panoptes/POCS/README.rst

PANOPTES Observatory Control System
===================================

   

-  `PANOPTES Observatory Control
   System <#panoptes-observatory-control-system>`__
-  `Overview <#overview>`__
-  `Getting Started <#getting-started>`__
-  `Install <#install-script>`__
-  `Test POCS <#test-pocs>`__
-  `Links <#links>`__

.. warning::

    The recent `v0.7.0` release of POCS is not backwards compatible. If you
    are one of the folks running that software, please either do a reinstall
    of your system using the instructions below or see our `forum <https://forum.projectpanoptes.org>`__
    for advice.

Overview
--------

`PANOPTES <https://projectpanoptes.org>`__ is an open source citizen science project
that is designed to find transiting exoplanets with digital cameras. The goal of
PANOPTES is to establish a global network of of robotic cameras run by amateur
astronomers schools in order to monitor, as continuously as possible, a very large
number of stars. For more general information about the project, including the
science case and resources for interested individuals, see the `about page <https://projectpanoptes.org/articles/what-is-panoptes/>`__.

POCS (PANOPTES Observatory Control System) is the main software driver for the
PANOPTES unit, responsible for high-level control of the unit. This repository
also contains a number of scripts for running a full instance of POCS.

Getting Started
---------------

POCS is designed to control a fully constructed PANOPTES unit. Additionally,
POCS can be run with simulators when hardware is not present or when the system
is being developed.

For information on building a PANOPTES unit, see the main `PANOPTES <https://projectpanoptes.org>`__ website and join the
`community forum <https://forum.projectpanoptes.org>`__.

To get started with POCS there are three easy steps:

#. **Setup** POCS on the computer you will be using for your unit or for
   development.
#. **Test** your POCS setup by running our testing script
#. **Start using POCS!**

See below for more details.

.. note::

    We rely heavily on much of the code in `panoptes-utils`.

    See https://github.com/panoptes/panoptes-utils

Install
-------

POCS Environment
^^^^^^^^^^^^^^^^

If you are running a PANOPTES unit then you will most likely want the entire
PANOPTES environment.

There is a bash shell script that will attempt to install an entire working POCS
system on your computer.  Some folks even report that it works on a Mac.

To test the script, open a terminal and enter:

.. code-block:: bash

    curl -L https://install.projectpanoptes.org | bash

Or using `wget`:

.. code-block:: bash

    wget -O - https://install.projectpanoptes.org | bash

POCS Module
^^^^^^^^^^^

If you want just the POCS module, for instance if you want to override it in
your own OCS (see `Huntsman-POCS <https://github.com/AstroHuntsman/huntsman-pocs>`_
for an example), then install via `pip`:

.. code-block:: bash

    pip install panoptes-pocs

If you want the extra features, such as Google Cloud Platform connectivity, then
use the extras options:

.. code-block:: bash

    pip install "panoptes-pocs[google]"

Test POCS
---------

See the Testing section of the Contributing guide.

Links
-----

-  PANOPTES Homepage: https://projectpanoptes.org
-  PANOPTES Data Explorer: https://www.panoptes-data.net
-  Community Forum: https://forum.projectpanoptes.org
-  Source Code: https://github.com/panoptes/POCS
