panoptes/POCS/docs/_static/pan-head.png

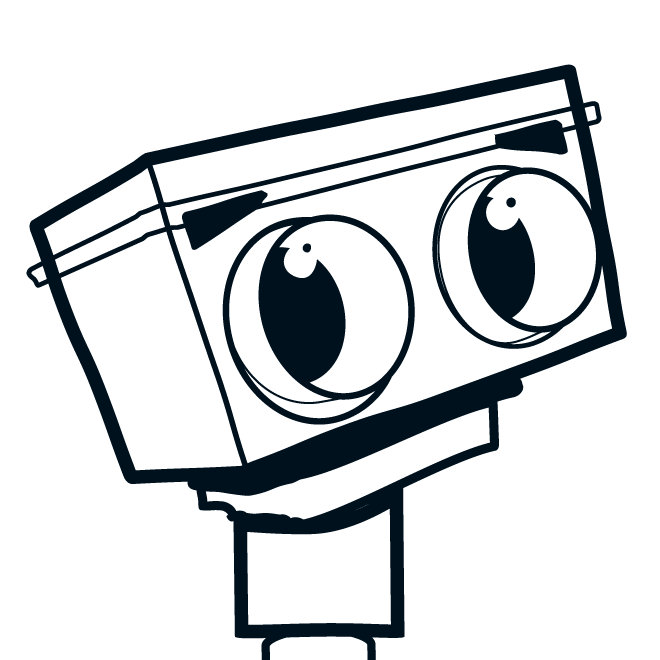
docs/_static/pan-head.png
