panoptes/POCS/docs/_static/pocs-graph.png

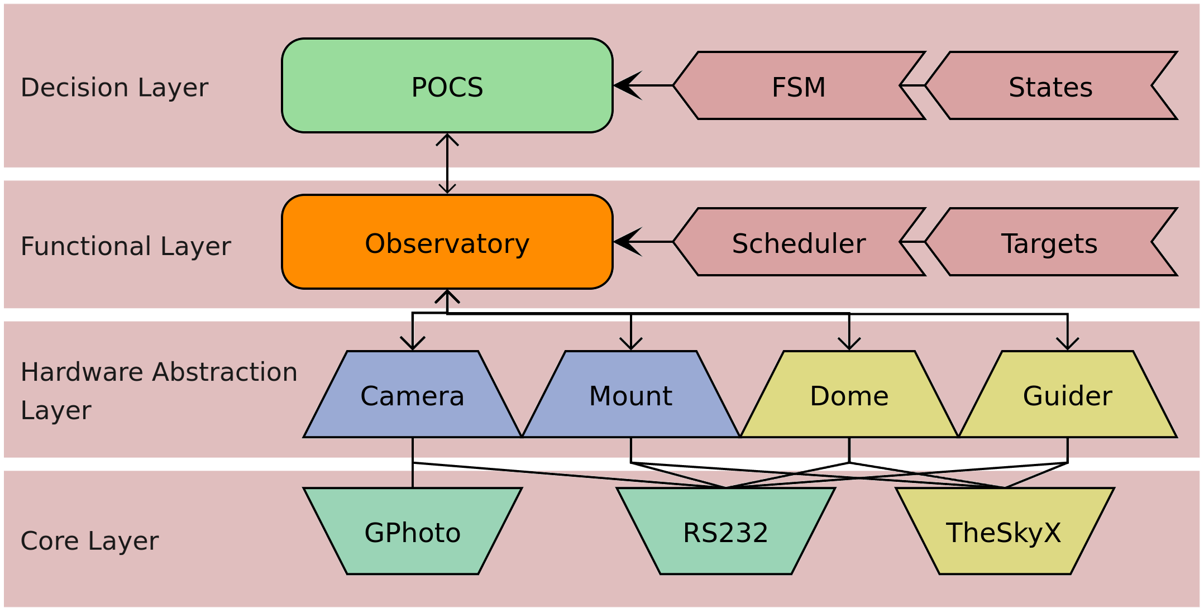
docs/_static/pocs-graph.png
