panoptes/POCS/(threads)

Thread 14 (2014-01-22):

Assemble Camera Enclosure Hardware

joshwalawender, 2014-01-22:
Assemble camera enclosure with mounting scheme for cameras and components.  Electronics must be coordinated with the Camera Control Electronics project.

Closed 2016-01-19.

Thread 2 (2014-01-22):

Assemble Camera Control Electronics

wtgee, 2014-01-22:
Assemble prototype arduino control system for the cameras.  Should include:

1) Control of camera shutter via TTL signal
2) Relay to connect/disconnect camera from USB
3) Temperature and humidity sensing
4) Orientation sending via accelerometer or IMU

Closed 2016-01-19.

Thread 5 (2014-01-22):

Assemble Weather Station

wtgee, 2014-01-22:
Assemble a prototype weather station module using Arduino board and components.  This is a prototype in that assembly will use a breadboard instead of soldering components in to a mounting.

Closed 2016-01-19.

Thread 9 (2014-01-22):

Prototype Mount Module

wtgee, 2014-01-22:
Build proof of concept mount module to control iOptron mounts.

See [wiki](https://github.com/panoptes/POCS/wiki/Panoptes-Coordinates-Standard#mount-methods) for some specifications:

When the methods of the mount class communicate (via serial) with the mount hardware, we strongly encourage the author of the code for that particular mount type (i.e. Orion, Celestron, Meade, etc.) to communicate with the mount using physical mount coordinates: Hour Angle (HA) and Declination. There are several advantages to this:

* Keeping all calculations relating to the conversion between J2000 (RA and Dec) to physical coordinates (HA and Dec) means that those calculations will always be consistent because we will know which corrections have been handled (i.e. precession to Jnow, refraction correction, etc.),
* Issuing slew commands in physical coordinates relieves the author of the code for the individual mount type of having to insert checks for the internal mount time and location values. This avoids potential confusion of the mount time and location are not matched to the time and location POCS.
* Using physical cordinates means that the same serial slew command to the mount can also be used for parking.

Closed 2016-01-19.

Thread 16 (2014-01-29):

Web Cams for Panoptes

joshwalawender, 2014-01-29:
We need hardware and software for web cams for the Panoptes baseline.  The cameras Oli is using in the prototype work fine in daytime, but I'm wondering if we can get better sensitivity.  I've ordered one of the Raspberry Pi camera boards with the IR filter removed (i.e. http://www.adafruit.com/products/1567) for a personal project.  I'm going to try to set it up to do integrations and see how sensitive it can get.  If this works, we might use this sort of system as a DIY web cam.  If not, I suspect we can easily reproduce what Oli did in the prototype.

Closed 2016-01-19.

Thread 23 (2016-05-05):

Camera Stop/Shutdown

wtgee, 2016-05-05:
Have a better method for interrupting camera to guarantee we don't get in a locked out state with exposure. Should be able to build into the subprocess/async.subprocess easily.

wtgee, 2017-02-03:
Seems to be okay now. Reopen if specific problem found.

Closed 2017-02-03.

Thread 25 (2016-05-05):

Better Sensor Reading Scripts

wtgee, 2016-05-05:
Currently handled by `scripts/read_serial.py`. Could be more robust. Also could integrate with `panoptes/read_weather.py`. Could also integrate with `supervisord`.

wtgee, 2016-05-10:
This has been moved into [PEAS](https://github.com/panoptes/environmental-analysis-system).

Closed 2016-05-10.

Thread 26 (2016-05-05):

Supervisord

wtgee, 2016-05-05:
Review supervisord scripts and make sure we are starting all items appropriately.
- [ ] Weather scripts (#25)
- [ ] Sensors scripts (#25)
- [ ] PAWS site
- [ ] Unit script
- [ ] Other? (e.g. maintenance scripts, data processing, updating, etc.)

wtgee, 2017-02-03:
We need to review this and see if it is what we want. The idea was to have these items start up automatically after reboot. However it seems like reboots should only happen manually in which case the user wants to probably start things up manually (maybe with one simple command). If a reboot happens unexpectedly we should probably alert the user somehow and allow them to inspect the system before start things.

jamessynge, 2017-09-09:
I'd like a full startup script, with flags to control what is attached, and then the user can decide whether to run that script automatically at boot. For manual control, perhaps we could have it start a screen or tmux session, with separate "window" for each of the shells that needs to be executed (e.g. peas_shell).

wtgee, 2018-04-03:
Closing this as stale.

Closed 2018-04-03.

Thread 28 (2016-05-05):

PanBot in the Slack Room

wtgee, 2016-05-05:
You know, for fun. Have a PANOPTES unit give status updates in certain channels.

wtgee, 2018-06-01:
Currently implemented in unmerged working branch [here](https://github.com/panoptes/POCS/blob/may-run/pocs/core.py#L185) but could easily be broken off.

wtgee, 2018-07-08:
> FWIW, our slack setup can't afford to have units post, given that we're way past the 10K post limit.

Agreed, we won't use it for the core PANOPTES slack room, but it's still nice to have. I imagine a school doing a build might have their own slack room.

Closing here as this was implemented in #522

Closed 2018-07-08.

Thread 29 (2016-05-06):

Camera Simulator

wtgee, 2016-05-06:
Camera simulator needs to be able to produce images, including pointing images (ideally with some offset). Need a folder of test images to work with this.

joshwalawender, 2016-05-06:
One way to do this without needing a folder of images, would be to have a tool which would generate an "image" by dropping gaussian stars down based on catalog positions.  Something like this might already exist, so it would be worth looking around for one.

joshwalawender, 2016-05-12:
Here's something that looks like it might do the trick.  It's from the same developer as SExtractor.
http://www.astromatic.net/software/skymaker

wtgee, 2016-05-12:
Nice, thanks. We can either use this or one or two real images. We just
need to be able to plate solve them then move them a tiny bit to check
tracking/pointing etc.

Hopefully I'll be getting to this soon.

On Thu, May 12, 2016 at 9:31 AM, Josh Walawender <notifications@github.com>
wrote:

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

--
~Wilfred Tyler Gee

wtgee, 2017-02-03:
There are currently some dummy images in the test folder (`$POCS/tests/data`) and the camera simulator will just always use these as a file name. This allows for unning of the entire machine with a camera simulator. Additional features should be defined separately.

Closed 2017-02-03.

Thread 33 (2016-06-23):

Incorporate trim rates in RA and Dec based on pointing/tracking model

joshwalawender, 2016-06-23:
Based on feedback, set or update a "trim rate" on the RA and Dec tracking rates.  The goal is to maintain the position of the stars on the pixel grid to sub-pixel accuracy over the duration of an observation (many images).

One way to generate the feedback is to only look at pointing errors, then make a physical model of the mount.  This is the traditional way of doing this.  In the earlier version of the prototype @oguyon did this differently.  He measured the offset between subsequent images (via cross correlation) and estimated a tracking rate error for that position in mount coordinates (HA and Dec).  With a sufficient number of these points, he fit a polynomial to the data to create the model.  Then each time a target was slewed to, he evaluated this model and applied the appropriate trim rates.  I tend to prefer this method as easier to understand than the physical model which was often modified by arbitrary polynomials anyway, so it wan't very physical.

There are also a few ways we might input these trim rates.  First, we could use mount commands (either direct serial commands or via an INDI layer).  Second, we could use the arduino in the electronics package to make "guiding" corrections to the mount.  The rate correction would basically be a PWM signal output by the arduino to the mount guide inputs.

wtgee, 2016-06-23:
This is called from the Analyzing state. See:

https://github.com/panoptes/POCS/blob/develop/pocs/state/states/default/analyzing.py#L11

Closed 2024-03-28.

Thread 37 (2016-06-29):

libgphoto2 client (gphoto2 replacement)

wtgee, 2016-06-29:
`gphoto2` is being used to control the cameras but has a number of problems when dealing with multiple cameras. Even when the `model` and `port` are specified the client will issue a USB reset on the hub, effectively killing any other cameras that are currently in operation and resetting the USB device IDs. This is also complicated by potential power cable issues on PAN001 which makes it hard to set on the current setup.

A new client can be written directly from the libgphoto2 library that is specific to PANOPTES. This client could handle the details of controlling both cameras (or not).  This client would replace gphoto2's `main.c`: https://github.com/gphoto/gphoto2/blob/master/gphoto2/main.c

wtgee, 2017-02-03:
This hasn't been an issue lately. In the future we might want/need it but can be closed for now.

Closed 2017-02-03.

Thread 39 (2016-06-29):

Accelerometer Positioning

wtgee, 2016-06-29:
We want to be able to recover the pointing position of the mount based on the accelerometer readings located inside the camera box. Various ways to do this exist. See e.g. (in no particular order):

http://perso-etis.ensea.fr/~pierandr/cours/M1_SIC/AN3397.pdf
http://arxiv.org/abs/1407.0035
http://www.it.bton.ac.uk/staff/gw4/papers/Displacement%20from%20Accelerometer.pdf

Values are available directly off the accelerometer (stored in mongodb locally) or off BigQuery. Values take the form:

``` json
                "camera_box" : {
                        "accelerometer" : {
                                "o" : 7,
                                "x" : -0.96,
                                "z" : -0.16,
                                "y" : -0.15
                        }
                }
```

where `o` represents the orientation (which can determine which side of the pier the accelerometer currently is)

See also #41 as we want to switch how we are reading the data as well.

astroblogweb, 2017-06-19:
Is this issue still open? Can I work on the python code for it?

joshwalawender, 2017-06-19:
Hi @astroblogweb , we have a summer intern who is just starting today and will be working on this topic.  Perhaps we can find another area yoiu might be interested in, or perhaps you can work together on it.  @wtgee coordinates all our software and he is away at a conference this week, so we might be a bit slow replying here for the next few days.

wtgee, 2023-05-23:
Currently not recommending the accelerometer in the build so closing this as stale.

Closed 2023-05-23.

Thread 40 (2016-06-29):

Webcam Development

wtgee, 2016-06-29:
We currently have two webcams attached to each unit. These are currently used simply for checking on the unit in the day. These timelapse photos are then archived as a simple movie each day.

Potential other uses for the webcams (brightness levels? cloud cover?) should be explored.

wtgee, 2017-02-03:
See also panoptes/PEAS#4

wtgee, 2019-05-07:
Look into using something like: https://github.com/thomasjacquin/allsky

Thread 41 (2016-06-29):

Arduino / Firmata Interaction

wtgee, 2016-06-29:
We have custom arduino code both in the computer and camera boxes. With the updates to the actual electronics interface we also want to start placing [Firmata](https://www.arduino.cc/en/Reference/Firmata) directly on the boards so that the control can be handled over to Python (or some other client code). This needs to be implemented and the clients need to be written to digest and interact with the arduinos

wtgee, 2017-02-03:
Decided not to use Firmata. New features for arduino will be defined elsewhere.

Closed 2017-02-03.

Thread 42 (2016-06-29):

Daily Housekeeping

wtgee, 2016-06-29:
Determine tasks that need to be accomplished during the Housekeeping state, which is run after the unit is parked. This should either be run directly after parking or at some set time each morning.

* [x] Cleanup observations directory
* [x] Upload images to cloud storage
* [x] Upload metadata to (TBD) cloud.

jamessynge, 2018-04-24:
I'm looking at setting up some code to run PIAA analysis on an observation, which would be easier if the last file uploaded for an observation was a sentinel that indicates that the upload is complete. This could be a metadata file, or just an empty file (e.g. UPLOAD-COMPLETE).

jamessynge, 2018-04-25:
Closing the issue right after I added a feature request, without a comment
as to why, leaves me wondering whether the feature request is already
recorded elsewhere, is already handled, or you disagree. Could you
elaborate?

On Tue, Apr 24, 2018, 11:38 PM Wilfred Tyler Gee <notifications@github.com>
wrote:

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

wtgee, 2018-04-25:
Sorry, I didn't mean to close it. In fact, I had made an earlier comment and had meant to post it but guess I screwed it up on my mobile.

Anyway, yes, I have been thinking something along these lines. Because they can be uploaded in any order I almost think it would need to be a metadata file that lists the names of the files that should have been uploaded. If we wanted to be really sure we could do md5sums or something.

I have just barely got it set up so that it responds to the notifications when something gets uploaded. The idea is that this will then do a plate-solve on the file and ingest metadata from the FITS header into a postgresql database. We can then use this metadb for displaying a site of info.

jamessynge, 2018-04-25:
Thanks for the clarification. My goal is somewhat simpler: trigger the
light curve production once all files of an observation have been uploaded.
As you say, a metadata file can include the names, and maybe the
signatures, of the raw files, so a responder can listen for bucket change
events, and only if the metadata file and all referenced files are present
would it kick off the analysis.

On Wed, Apr 25, 2018, 4:45 PM Wilfred Tyler Gee <notifications@github.com>
wrote:

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

wtgee, 2018-10-16:
Always happy to close a 2 year old Issue. :) Closed by #687.

Closed 2018-10-16.

Thread 45 (2016-06-29):

Target / Observation / Exposure Refactor

wtgee, 2016-06-29:
The implementations of the `Target` and `Observation` classes are currently clunky and need some major cleaning up. This should be done with respect to what we want the eventual `Scheduler` to look like (see #44 ). `cameras` should not needlessly be passed into objects.

wtgee, 2016-07-21:
This is currently causing problems when the unit tries to return to the same target if the POCS loop hasn't been restarted. It could be fixed by adjust existing code but time would better be spent fixing the whole thing (which to some extent also invovles #44)

Closed 2016-08-18.

Thread 52 (2016-07-22):

Implement ABC for base classes

wtgee, 2016-07-22:
Both `mount` and `camera` should be implemented with [ABC](https://docs.python.org/3/library/abc.html) (as per PEP3119) rather than with `NotImplentedError`

wtgee, 2017-02-03:
This is not totally necessary and things are working fine. Closing this unless we have a defined need for it.

Closed 2017-02-03.

Thread 54 (2016-07-28):

Incorporate weather into Scheduler

wtgee, 2016-07-28:
The `Scheduler` (which is an astroplan `Observer`) can use the temperature and humidity values for more accurate pointing. Might not be needed.

joshwalawender, 2016-07-31:
@wtgee I'm not sure I understand the issue, can you elaborate?  You want the scheduler to take temp and humidity as inputs?  Is there any particular reason?  With our pixel scale, these will be negligible effects on pointing.

wtgee, 2016-07-31:
Let' just close the issue then. I was cleaning up old code and had a commented line in there to add them in so I just created an issue for it so I could remove the line.

Closed 2016-07-31.

Thread 56 (2016-07-31):

Horizon and Obstruction Limits

wtgee, 2016-07-31:
At some point we need to be able to avoid certain sections of the sky or arbitrary horizon limits. At MLO the radio tower ends up in the images for certain targets.

joshwalawender, 2016-08-01:
Originally we had this slated for scheduler.  The idea was that the mount would have horizon limits based on actual, physical collisions and that scheduler would handle sky obstructions.

Our idea was the users could define a single elevation as their horizon, a table of values of horizon as a function of azimuth, or in principle a custom function (if they had some very weird situation).  The scheduler would check that the target would not dip below the horizon during an image.

I think that is still a reasonable strategy.

wtgee, 2016-08-01:
Agreed. We should make an overarching Issue for Scheduling that perhaps
incorporates items we need.

For the weird situations I almost think it would be easiest to mark an
image after the fact such that when you see an image with something
obstructing you could just mark that location.

On Mon, Aug 1, 2016 at 4:39 PM, Josh Walawender <notifications@github.com>
wrote:

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

--
~Wilfred Tyler Gee

jamessynge, 2017-04-12:
I'm interested in building, debugging and deploying a Panoptes unit, and I suspect it will help a lot to have an automated approach to identifying the horizon, especially during the process of debugging and site selection. For example, if you could place the tripod, eq mount and camera unit in a location, and have it measure the horizon, this would allow a contributor to find the best location on the available property. Or, during debugging, where you're not aiming to have it running unattended, but rather checking if everything is working well, including if focus and polar alignment are acceptable, having a horizon measurement capability would be useful. This could even be done during the day/evening.

In my case, I'll debug at home, where there are a lot of trees, before taking it to a location (TBD) where a friend or school (again, TBD) will host it. It's possible it'll be moved several times, especially if I take it to a meeting or two for show and tell ;-) before finding a permanent location. I notice from the JPL photos of Panoptes at an open house that at least one prototype was moved to CA, so I think you know what I'm talking about.

wtgee, 2018-01-19:
Happy to close this old issue in favor of #367

Closed 2018-01-19.

Thread 83 (2017-02-16):

Power Down and Messaging Cleanup

wtgee, 2017-02-16:
Need to clean up on `power_down` a little better, especially with guaranteeing the messaging ports get cleared.

wtgee, 2017-11-20:
Closing this as outdated and lack of information. New issue should be created when identified.

Closed 2017-11-20.

Thread 86 (2017-07-01):

Turn fan on when control box is hot, off when not

jamessynge, 2017-07-01:
IIUC, the fan is on at all times now, even in the winter. We should switch the fan on and off according to the temperature readings from various sensors. This could be handled by the telemetry board arduino, with default values in the code, and adjustments from the NUC.

wtgee, 2017-11-24:
Closing: more and better details provided in #130

Closed 2017-11-24.

Thread 87 (2017-07-09):

Add workflow/scripts for verifying a new unit

jamessynge, 2017-07-09:
I've built a PANOPTES baseline unit, but beyond working with the Arduino IDE to validate the behavior of the 3 boards, I don't know how to get rest of the equipment verified (i.e. can the NUC talk to EVERYTHING).

Thread 88 (2017-07-09):

pocs_shell doesn't work "as is"

jamessynge, 2017-07-09:
```bash
panoptes@Panmass:/var/panoptes/POCS$ bin/pocs_shell
Traceback (most recent call last):
  File "bin/pocs_shell", line 16, in <module>
    from pocs import POCS
ModuleNotFoundError: No module named 'pocs'
panoptes@Panmass:/var/panoptes/POCS$ python bin/pocs_shell
Traceback (most recent call last):
  File "bin/pocs_shell", line 16, in <module>
    from pocs import POCS
ModuleNotFoundError: No module named 'pocs'
```

wtgee, 2018-02-13:
Closing generic Issue for stale activity. Feel free to reopen or create new Issue if needed.

Closed 2018-02-13.

Thread 89 (2017-07-09):

POCS Operation.ipynb instructions lead to error

jamessynge, 2017-07-09:
I followed the examples in POCS Operation.ipynb and ran into one of the errors that is causing the tests to fail:

    AttributeError: 'SkyCoord' object has no attribute 'ndim'

Details:

```
In [13]: new_obs = pocs.observatory.get_observation()
---------------------------------------------------------------------------
AttributeError                            Traceback (most recent call last)
<ipython-input-13-34e5290c9fe4> in <module>()
----> 1 new_obs = pocs.observatory.get_observation()

/var/panoptes/POCS/pocs/observatory.py in get_observation(self, *args, **kwargs)
    159
    160         self.logger.debug("Getting observation for observatory")
--> 161         self.scheduler.get_observation(*args, **kwargs)
    162
    163         if self.scheduler.current_observation is None:

/var/panoptes/POCS/pocs/scheduler/dispatch.py in get_observation(self, time, show_all)
     42
     43         common_properties = {
---> 44             'end_of_night': self.observer.tonight(time=time, horizon=-18 * u.degree)[-1],
     45             'moon': get_moon(time, self.observer.location)
     46         }

/home/panoptes/anaconda3/lib/python3.6/site-packages/astropy/utils/decorators.py in tonight(self, time, horizon, obswl)
    634             name = func.__name__
    635
--> 636         func = make_function_with_signature(func, name=name, **wrapped_args)
    637         func = functools.update_wrapper(func, wrapped, assigned=assigned,
    638                                         updated=updated)

/home/panoptes/anaconda3/lib/python3.6/site-packages/astropy/units/decorators.py in wrapper(*func_args, **func_kwargs)
    128             # Call the original function with any equivalencies in force.
    129             with add_enabled_equivalencies(self.equivalencies):
--> 130                 return wrapped_function(*func_args, **func_kwargs)
    131
    132         return wrapper

/home/panoptes/anaconda3/lib/python3.6/site-packages/astroplan/observer.py in tonight(self, time, horizon, obswl)
   1677             if not isinstance(start_time, Time):
   1678                 start_time = Time(start_time)
-> 1679         end_time = self.sun_rise_time(start_time, which='next', horizon=horizon)
   1680
   1681         return start_time, end_time

/home/panoptes/anaconda3/lib/python3.6/site-packages/astropy/utils/decorators.py in sun_rise_time(self, time, which, horizon)
    634             name = func.__name__
    635
--> 636         func = make_function_with_signature(func, name=name, **wrapped_args)
    637         func = functools.update_wrapper(func, wrapped, assigned=assigned,
    638                                         updated=updated)

/home/panoptes/anaconda3/lib/python3.6/site-packages/astropy/units/decorators.py in wrapper(*func_args, **func_kwargs)
    128             # Call the original function with any equivalencies in force.
    129             with add_enabled_equivalencies(self.equivalencies):
--> 130                 return wrapped_function(*func_args, **func_kwargs)
    131
    132         return wrapper

/home/panoptes/anaconda3/lib/python3.6/site-packages/astroplan/observer.py in sun_rise_time(self, time, which, horizon)
   1088         ISO: 2001-02-02 14:02:50.554, JD: 2451943.08531
   1089         """
-> 1090         return self.target_rise_time(time, get_sun(time), which, horizon)
   1091
   1092     @u.quantity_input(horizon=u.deg)

/home/panoptes/anaconda3/lib/python3.6/site-packages/astropy/utils/decorators.py in target_rise_time(self, time, target, which, horizon)
    634             name = func.__name__
    635
--> 636         func = make_function_with_signature(func, name=name, **wrapped_args)
    637         func = functools.update_wrapper(func, wrapped, assigned=assigned,
    638                                         updated=updated)

/home/panoptes/anaconda3/lib/python3.6/site-packages/astropy/units/decorators.py in wrapper(*func_args, **func_kwargs)
    128             # Call the original function with any equivalencies in force.
    129             with add_enabled_equivalencies(self.equivalencies):
--> 130                 return wrapped_function(*func_args, **func_kwargs)
    131
    132         return wrapper

/home/panoptes/anaconda3/lib/python3.6/site-packages/astroplan/observer.py in target_rise_time(self, time, target, which, horizon)
    898                                            dict(time=time, target=target,
    899                                                 which=which, rise_set='rising',
--> 900                                                 horizon=horizon))
    901
    902     @u.quantity_input(horizon=u.deg)

/home/panoptes/anaconda3/lib/python3.6/site-packages/astroplan/observer.py in _determine_which_event(self, function, args_dict)
    829
    830         if which == 'next' or which == 'nearest':
--> 831             next_event = function(*args('next'))
    832             if which == 'next':
    833                 return next_event

/home/panoptes/anaconda3/lib/python3.6/site-packages/astroplan/observer.py in _calc_riseset(self, time, target, prev_next, rise_set, horizon, N)
    730             times = _generate_24hr_grid(time, -1, 0, N)
    731
--> 732         altaz = self.altaz(times, target, grid=True)
    733         altitudes = altaz.alt
    734

/home/panoptes/anaconda3/lib/python3.6/site-packages/astroplan/observer.py in altaz(self, time, target, obswl, grid)
    464         """
    465         if target is not None:
--> 466             time, target = self._preprocess_inputs(time, target, grid)
    467
    468         altaz_frame = AltAz(location=self.location, obstime=time,

/home/panoptes/anaconda3/lib/python3.6/site-packages/astroplan/observer.py in _preprocess_inputs(self, time, target, grid)
    396                 if time.isscalar:
    397                     target = target[:, np.newaxis]
--> 398                 while target.ndim <= time.ndim:
    399                     target = target[:, np.newaxis]
    400         if not self._is_broadcastable(target.shape, time.shape):

/home/panoptes/anaconda3/lib/python3.6/site-packages/astropy/coordinates/sky_coordinate.py in __getattr__(self, attr)
    449         # Fail
    450         raise AttributeError("'{0}' object has no attribute '{1}'"
--> 451                              .format(self.__class__.__name__, attr))
    452
    453     def __setattr__(self, attr, val):

AttributeError: 'SkyCoord' object has no attribute 'ndim'

In [14]:
```

wtgee, 2017-11-13:
I believe this has been solved by an astropy update. Can you retest and report any additional failures?

wtgee, 2018-01-11:
@jamessynge when you get the change can you check this notebook again. I'd like to close out some old Issues if not a problem.

wtgee, 2018-01-15:
Closing for lack of activity. Please open back up if an issue.

Closed 2018-01-15.

Thread 93 (2017-07-09):

test_error_exit fails

jamessynge, 2017-07-09:
Looks like the test is looking for the wrong type of error (SystemExit vs. PanError).

```
__________________________________________ test_error_exit __________________________________________

config = {'cameras': {'auto_detect': True, 'devices': [{'model': 'canon_gphoto2'}, {'model': 'canon_gphoto2'}], 'primary': '14d...: <Quantity 3400.0 m>, 'gmt_offset': -600, 'horizon': <Quantity 30.0 deg>, 'latitude': <Quantity 19.54 deg>, ...}, ...}

    def test_error_exit(config):
        with pytest.raises(SystemExit):
>           Observatory(ignore_local_config=True, simulator=['none'])

pocs/tests/test_observatory.py:50:
_ _ _ _ _ _ _ _ _ _ _ _ _ _ _ _ _ _ _ _ _ _ _ _ _ _ _ _ _ _ _ _ _ _ _ _ _ _ _ _ _ _ _ _ _ _ _ _ _ _ _
pocs/observatory.py:50: in __init__
    self._create_cameras(**kwargs)
_ _ _ _ _ _ _ _ _ _ _ _ _ _ _ _ _ _ _ _ _ _ _ _ _ _ _ _ _ _ _ _ _ _ _ _ _ _ _ _ _ _ _ _ _ _ _ _ _ _ _

self = <pocs.observatory.Observatory object at 0x7f42b8264470>
kwargs = {'ignore_local_config': True, 'simulator': ['none']}
camera_info = {'auto_detect': True, 'devices': [{'model': 'canon_gphoto2'}, {'model': 'canon_gphoto2'}], 'primary': '14d3bd'}
a_simulator = False, ports = [], auto_detect = True

    def _create_cameras(self, **kwargs):
        """Creates a camera object(s)

            Loads the cameras via the configuration.

            Creates a camera for each camera item listed in the config. Ensures the
            appropriate camera module is loaded.

            Note: We are currently only operating with one camera and the `take_pic.sh`
                script automatically discovers the ports.

            Note:
                This does not actually make a usb connection to the camera. To do so,
                call the 'camear.connect()' explicitly.

            Args:
                **kwargs (dict): Can pass a camera_config object that overrides the info in
                    the configuration file. Can also pass `auto_detect`(bool) to try and
                    automatically discover the ports.

            Returns:
                list: A list of created camera objects.

            Raises:
                error.CameraNotFound: Description
                error.PanError: Description
            """
        if kwargs.get('camera_info') is None:
            camera_info = self.config.get('cameras')

        self.logger.debug("Camera config: \n {}".format(camera_info))

        a_simulator = 'camera' in self.config.get('simulator', [])
        if a_simulator:
            self.logger.debug("Using simulator for camera")

        ports = list()

        # Lookup the connected ports if not using a simulator
        auto_detect = kwargs.get(
            'auto_detect', camera_info.get('auto_detect', False))
        if not a_simulator and auto_detect:
            self.logger.debug("Auto-detecting ports for cameras")
            try:
                ports = list_connected_cameras()
            except Exception as e:
                self.logger.warning(e)

            if len(ports) == 0:
                raise error.PanError(
>                   msg="No cameras detected. Use --simulator=camera for simulator.")
E               pocs.utils.error.PanError

pocs/observatory.py:589: PanError
--------------------------------------- Captured stderr call ----------------------------------------
2017-07-09 17:05:34 Panmass panoptes[11800] INFO Initializing observatory
2017-07-09 17:05:34 Panmass panoptes[11800] INFO 	Setting up location
2017-07-09 17:05:34 Panmass panoptes[11800] INFO 	Setting up mount
2017-07-09 17:05:34 Panmass panoptes[11800] INFO Loading mount commands file: /var/panoptes/POCS/resources/mounts/ioptron.yaml
2017-07-09 17:05:36 Panmass panoptes[11800] INFO Creating iOptron mount
2017-07-09 17:05:36 Panmass panoptes[11800] INFO Mount created
2017-07-09 17:05:36 Panmass panoptes[11800] INFO 	Setting up cameras
2017-07-09 17:05:37 Panmass panoptes[11800] ERROR PanError: No cameras detected. Use --simulator=camera for simulator.
```

wtgee, 2017-11-13:
Some of the testing suite has been fixed since this time. Can you run again and report if still failing.

wtgee, 2017-11-16:
I think this relates to having a camera physically connected while running the test. Some work needs to be done to respect the `--hardware` or `--camera` flag. In general need to make the documentation clear about how to run the test suite to test the software vs how to run it to test the hardware.

wtgee, 2017-12-21:
I think this has been resolved. Closing due to inactivity.

Closed 2017-12-21.

Thread 94 (2017-07-09):

Add instructions for creating the "panoptes" user

jamessynge, 2017-07-09:
We need explicit/detailed instructions for setting up the NUC, including creating the "panoptes" user. In particular, info about adding that user to the dialout group (else it has no access to the Arduino's and the USB-to-Serial adapters).
Also info about creating the /var/panoptes directory (must create the astrometry/data subdir, else some tests fail).

jamessynge, 2017-11-03:
New info: the panoptes user needs to be in the plugdev group, else has no access to the cameras when not logged in via a locally attached monitor & keyboard, including IIUC via the auto-started tmux session.

wtgee, 2020-02-16:
Closed by #951.  There are other things that need to be done as part of that process, mostly documentation, but new specific Issues should be opened to identify those.

Closed 2020-02-16.

Thread 95 (2017-07-15):

Camera.is_primary is wrong

jamessynge, 2017-07-15:
I provided a "primary: uid" line in pocs_local.yaml, but the wrong camera is considered primary. pocs_local.yaml:

```
cameras:
    auto_detect: True
    # Arbitrary choice of primary, but now labeled as camera #0,
    # and plugged in to jack #0.
    primary: 6575fc
    devices:
    -
        model: canon_gphoto2
    -
        model: canon_gphoto2
```

And the serial numbers of the cameras start and end as follows:
```
7bab97...cdc74a
6575fc...a6c489
```

wtgee, 2018-10-06:
This should be fixed by #650. Reopen if still a problem.

Closed 2018-10-06.

Thread 103 (2017-11-04):

PanMongo.insert_current fails to insert/replace some records

jamessynge, 2017-11-04:
peas_shell emits these errors periodically:

`/var/panoptes/POCS/pocs/utils/database.py:84: UserWarning: Problem inserting object into collection: The dotted field '4.16, "z":-8.27, "o"' in 'data.camera_board.4.16, "z":-8.27, "o"' is not valid for storage.
 warn("Problem inserting object into collection: {}".format(e))
/var/panoptes/POCS/pocs/utils/database.py:84: UserWarning: Problem inserting object into collection: The dotted field '3, "z":-8.03, "o"' in 'data.camera_board.3, "z":-8.03, "o"' is not valid for storage.
  warn("Problem inserting object into collection: {}".format(e))
/var/panoptes/POCS/pocs/utils/database.py:84: UserWarning: Problem inserting object into collection: The dotted field '24, "z":-7.93, "o"' in 'data.camera_board.24, "z":-7.93, "o"' is not valid for storage.
  warn("Problem inserting object into collection: {}".format(e))
/var/panoptes/POCS/pocs/utils/database.py:84: UserWarning: Problem inserting object into collection: The dotted field '23, "z":-7.92, "o"' in 'data.camera_board.23, "z":-7.92, "o"' is not valid for storage.
  warn("Problem inserting object into collection: {}".format(e))
/var/panoptes/POCS/pocs/utils/database.py:84: UserWarning: Problem inserting object into collection: The dotted field '18, "z":-8.44, "o"' in 'data.camera_board.18, "z":-8.44, "o"' is not valid for storage.
  warn("Problem inserting object into collection: {}".format(e))
`

Here is a SO page about the problem and a potential solution: https://stackoverflow.com/questions/30014243/mongoerror-the-dotted-field-is-not-valid-for-storage

wtgee, 2017-11-04:
Actually, I think this is a problem when the full string coming off the arduino isn't a valid json string. It then sometimes parses wrong and turns what should be values into keys and then tries to insert, generating this error. We don't (i.e. shouldn't) have any keys that have dots in them.

It's usually not a valid json because the buffering on the serial has gone wrong, something I was hoping your updated code would fix. I would first check for a full valid json before looking into above solution.

jamessynge, 2017-12-27:
I also see this happen when running test_pocs.py:

pocs/tests/test_pocs.py::test_run
  /home/james/git/panoptes/POCS/pocs/utils/database.py:100: UserWarning: Problem inserting object into collection: Cannot encode object: <Time object: scale='utc' format='jyear_str' value=J2000.000>
    warn("Problem inserting object into collection: {}".format(e))

wtgee, 2017-12-27:
The time type should be handled by the BSON encoder although I had seen the same problems recently with https://github.com/panoptes/POCS/pull/225 (which was fixed by explicitly converting that one value away from an astropy.time.Time` object). Is this the same type of time or is it some derivative of `datetime`?

The fix for this should be the same as for https://github.com/panoptes/POCS/issues/206, that is, we should have one way to scrub objects whether they are going into mongo or out as a message.

jamessynge, 2017-12-27:
Looks to be an astropy type (based on the jyear_str and J2000.000, and a Google search for that text).

wtgee, 2018-01-11:
I'm still seeing this intermittently on PAN001 with new camera board and arduino shared libraries.

jamessynge, 2018-01-12:
FWIW, I'm skeptical that the cause is invalid JSON from the boards. I think
the key used when updating a doc in the db is somehow corrupt as far as
mongo is concerned

On Jan 11, 2018 5:17 PM, "Wilfred Tyler Gee" <notifications@github.com>
wrote:

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

wtgee, 2018-01-12:
This is what I'm seeing frequently on PAN001 right now:
```
warn("Problem inserting object into collection: {}".format(e))
/var/panoptes/POCS/pocs/utils/database.py:100: UserWarning: Problem inserting object into collection: The dotted field '0.99, "z":-0.02, "o"' in 'data.camera_board.0.99, "z":-0.02, "o"' is not valid for storage.
  warn("Problem inserting object into collection: {}".format(e))
/var/panoptes/POCS/pocs/utils/database.py:100: UserWarning: Problem inserting object into collection: The dotted field '7, "y":0.99, "z":-0.02, "o"' in 'data.camera_board.7, "y":0.99, "z":-0.02, "o"' is not valid for storage.
```

Seems to be some bad string concatenation around `camera_board`. The line inserting it is:

```
            current_obj = {
                'type': collection,
                'data': obj,
                'date': current_time(datetime=True),
            }
```

which is where the `data` comes from in above warning.

jamessynge, 2018-01-26:
Another insert failure, but now with the record that couldn't be inserted:

`
PEAS > /var/panoptes/POCS/pocs/utils/database.py:88: UserWarning: Problem inserting object into collection: MongoDB can only handle up to 8-byte ints, {'type': 'environment', 'data': {'telemetry_board': {'name': 'telemetry_board', 'millis': 980784041, 'report_num': 417104, 'ver': '2018-01-14', 'power': {'computer': 1, 'fan': 1, 'mount': 1, 'cameras': 1, 'weather': 1, 'main': 1}, 'current': {'main': 421, 'fan': 49, 'mount': 32, 'cameras': 181}, 'amps': {'main': 1178.8, 'fan': 88.2, 'mount': 57.6, 'cameras': 181.0}, 'humidity': 13.5, 'temp_00': -1.1, 'temperature': [-4.31, -4.63, 0.69], 'date': '2018-01-26T11:48:59 GMT'}, 'camera_board': {'name': 'camera_board', 'count': 27674957142767538857, 'num': 27513, 'inputs': 9, 'camera_00': 1, 'camera_01': 1, 'accelerometer': {'x': -6.96, 'y': 6.86, 'z': 1.57, 'o': 7}, 'humidity': 29.5, 'temp_00': -6.0, 'date': '2018-01-26T11:48:59 GMT'}}, 'date': datetime.datetime(2018, 1, 26, 11, 48, 59, 444352)}
`

wtgee, 2018-01-26:
`'count': 27674957142767538857` isn't very helpful. :) Not sure how it gets that high though as you are doing a subtraction [here](https://github.com/panoptes/POCS/blob/develop/resources/arduino_files/camera_board/camera_board.ino#L167) (although there is still a TODO there).

jamessynge, 2018-01-27:
Yeah, I was sure that count was totally bogus. I don't think that value can be produced by the sketch, so it may mean that the reading the sketch output failed in some way.

wtgee, 2018-07-26:
Just a bump as I started getting this problem again on PAN001. We haven't updated the camera board software in quite some time but seems due:

```
/var/panoptes/POCS/pocs/utils/database.py:33: UserWarning: Problem inserting object
 into collection: MongoDB can only handle up to 8-byte ints

# snip

 'count': 35177157493517757885,
```

wtgee, 2019-06-29:
This should be solved with the merge up `panoptes-utils` release above.

Closed 2019-06-29.

Thread 107 (2017-11-08):

Post-consolidation cleanup

wtgee, 2017-11-08:
After #106 is merged there are a few items to be cleaned up:

* PEAS config conform to config loading system
* Assess need for `historical-data-fixer` folder
* Assess need for PACE `resources/arduino_folders/libraries` folder
* Update README
* Test `python setup.py [install|develop]`
* Transfer Issues from PACE and PEAS
* Mark tests with `hardware` fixture (instead of separate camera, mount, etc?)

wtgee, 2017-12-31:
Performed in release [v0.6.0](https://github.com/panoptes/POCS/releases/tag/v0.6.0).

> Assess need for PACE resources/arduino_folders/libraries folder
Still outstanding but deserves own issue.

Closed 2017-12-31.

Thread 118 (2017-11-15):

Encourage or require the use of a source formatter

jamessynge, 2017-11-15:
It would be helpful if we had a consistent style for code. I like the golang approach: they provide gofmt, a tool that is applied to all "official" code, and submit fails if the code doesn't exactly match the format that gofmt would produce for the input file. This tool (https://github.com/google/yapf) aims to be used the same way for python. I use a variant of it at work, and like the fact that when I'm editing I don't have to spend time thinking about formatting because I just run the formatter periodically and before sending for review.

wtgee, 2017-11-15:
We do require standard pep8 in the sense that our testing suite will fail if it doesn't conform. This is enforced via `pocs/tests/test_codestyle.py`.

The only part we don't conform to is E501, line length of 80 chars, mostly because that drives me bonkers. I think 120 is a more sane default for people these days (I try to keep docstrings at 80).  We also don't conform on #402 (all import statements at top) because of a few places we do some trickery. Probably better to just ignore those files.

I think this is mostly a documentation issue about how to run tests before committing and how to setup an editor to do this automatically.

wtgee, 2017-11-15:
That said, I just noticed the test file only checks the `pocs` directory, so we should make note to expand that to `peas` in #98

jamessynge, 2017-11-15:
While typing it is easier to go with wide line length, but when running diff, 120 becomes a bit too much.

joshwalawender, 2017-11-15:
I used to be more strongly offended by the 80 character limit, but I've learned to live with it on other projects.  It does seem silly to have software written on 4k and 5k monitors to be limited by the number of characters that could fit on a punch card ...

jamessynge, 2017-11-18:
My laptop isn't 4K or 5K wide, and my eyes aren't what they were when I
used to complain about 80 column limits.
There is reliably enough room on a single screen for two 80 or 100 column
wide editors, but 120 is usually pushing it.
For example, I just made a maximum width gnome terminal on my laptop, and
it is 204 columns wide.
I usually use Meld for graphical diffs, and with gutters and two
scrollbars, 100 columns would actually be too wide.
And it is fairly easy to apply these tools automatically using a git
pre-commit hook, so you don't need to think about it while editing a file.

So, I repeat my request: Let's make it a policy to keep the the maximum
width that of a punch card, or 90 if you prefer a bit more room.

On Wed, Nov 15, 2017 at 5:40 PM, Josh Walawender <notifications@github.com>
wrote:

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

wtgee, 2017-11-18:
I've held out on this for a long time but that was easy since I was doing most of the development. :)

If we go less than 120 then we should conform to the 80 and just keep in line with pep.

This should perhaps be done as part of #107

wtgee, 2017-11-18:
Note that pep8 is actually 79 characters for code and 72 for docstrings

https://www.python.org/dev/peps/pep-0008/#maximum-line-length

Note also they "allow" 100 over 80 if strongly preferred. Again, I could make a case but don't necessarily think we should go back and forth on this. I'm ~~happy~~ willing to switch to 80 without issue.

jamessynge, 2017-11-19:
I'll make use of yapf on my current change, and we can get a feel for it. It uses pep8 as the style by default.

wtgee, 2017-12-05:
Is this okay to close?

Closed 2017-12-05.

Thread 125 (2017-11-19):

Store telemetry and camera board data in different docs/dbs

jamessynge, 2017-11-19:
Since the data from these two boards comes arrives in an uncoordinated fashion, we should simply record the data when it arrives, and not try to tie them together into a single record.

wtgee, 2017-11-19:
Agreed. This involves work fixing up `peas/sensors.py` so that it doesn't listen for two devices at once but each device as own instance of class.

jamessynge, 2018-01-10:
On PAN006, the telemetry board is not responding, so the lack of separation of telemetry and camera readings is blocking setup_pocs from working.

wtgee, 2018-01-10:
It sounds like it is hanging while trying to read?

jamessynge, 2018-01-10:
That's what I assumed, though I now think there must be multiple issues:

- setup_pocs is encountering a timeout, which I assume is from attempting to read the latest environment data from PEAS.
- peas_shell is not reporting any values for `last_reading environment` so either I'm specifying the wrong arg to the command or there is a problem with collecting that environment data.

There are no working tests of peas, let along peas_shell, so we could have introduced multiple problems with our changes to pocs/utils, but be unaware.

wtgee, 2018-01-11:
Do you have mongo set up correctly? It occurred to me the `last_reading is reading from mongo direct.

jamessynge, 2018-01-11:
So far as I know, mongo is correct. For example, `last_reading weather`
works.

As we've discussed elsewhere, there are bugs in peas/sensor.py; my fault as
I fixed things, but we didn't have good tests of that code.

On Wed, Jan 10, 2018 at 8:15 PM, Wilfred Tyler Gee <notifications@github.com
> wrote:

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

wtgee, 2018-02-13:
Closing in favor of #420

Closed 2018-02-13.

Thread 126 (2017-11-21):

PACE: Drop Voltage to Amps conversion in telemetry board code

wtgee, 2017-11-21:
@jamessynge opened
The conversion in the telemetry board sketch from the analogRead value (voltage) to amps on the 4 current sensed lines forces us to modify the sketch for each installation. We should do that on the NUC with a yaml file instead.

Closed 2021-04-08.

Thread 130 (2017-11-24):

Consider reading temperature from CPU, using to control computer box fan

jamessynge, 2017-11-24:
We have a fan in the computer box, but don't automatically turn it on or off, but we really should make better use of that hardware.

We have temp sensors in the computer box. And the CPU/GPU/motherboard expose temperature sensors (see the Linux package lm-sensors). Any of these might be used to decide when to turn the fan on or off.

Given that not all models of the NUC have fans, and that we have sensors in the case, we might use choose to have two triggers: PEAS could monitor the temperatures in the computer box and of the NUC, and if any of them rise too high it could turn on the fan.

kmeagle1515, 2019-03-25:
HELLO!
Is this related to **GKRELLM**

AnthonyHorton, 2019-03-26:
@kmeagle1515 No. GKrellM is a graphical system monitor application. This Issue is about adding functionality to the POCS/PEAS software to automatically control fans in response to temperature sensor readings.

kmeagle1515, 2019-03-26:
Internal Arduino Temperature Sensor, this should do the work i suppose.
Any thoughts on it?

AnthonyHorton, 2019-03-26:
These are questions for @wtgee & @jamessynge. I'm not very familiar with the PANOPTES hardware myself. I work on the [Huntsman Telescope](https://huntsman.space).

wtgee, 2019-03-26:
@kmeagle1515 thanks for the interest in the issue. @jamessynge is actually talking about two different systems for tuning on the fan:
1. Based on the internal CPU temperature. Something like the `lm-sensors` could be used here, however it's just as easy to use `psutil`. Here's are reading from `PAN001` right now:
```python
In [1]: import psutil                                                                                                                                                                                    

In [2]: psutil.sensors_temperatures()                                                                                                                                                                    
Out[2]:
{'acpitz': [shwtemp(label='', current=27.8, high=105.0, critical=105.0),
  shwtemp(label='', current=29.8, high=105.0, critical=105.0)],
 'coretemp': [shwtemp(label='Package id 0', current=30.0, high=100.0, critical=100.0),
  shwtemp(label='Core 0', current=27.0, high=100.0, critical=100.0),
  shwtemp(label='Core 1', current=30.0, high=100.0, critical=100.0)],
 'nct6776': [shwtemp(label='SYSTIN', current=123.0, high=0.0, critical=None),
  shwtemp(label='PCH_CPU_TEMP', current=0.0, high=None, critical=None),
  shwtemp(label='CPUTIN', current=20.5, high=80.0, critical=80.0),
  shwtemp(label='AUXTIN', current=25.0, high=80.0, critical=80.0),
  shwtemp(label='PECI Agent 0', current=28.5, high=80.0, critical=100.0),
  shwtemp(label='PCH_CHIP_TEMP', current=0.0, high=80.0, critical=80.0),
  shwtemp(label='PECI Agent 1', current=0.0, high=80.0, critical=80.0)]}
```
2. Based on the temperature sensors that we have installed in the [control box](https://projectpanoptes.org/articles/panoptes-baseline-unit-description/). Here is there current reading (only showing relevant portion):
```python
PEAS > last_reading environment
********************************************************************************
ENVIRONMENT:
{
 'data': {'camera_board': {
                           'date': '2019-03-26T05:56:05 GMT',
                           'humidity': 1.0,
                           'name': 'telemetry_board',
                           'temp_00': 11.1,
                           'temperature': [18.5, 8.5, 5.31],
}},
 'type': 'environment'}
********************************************************************************
39.4 seconds old

PEAS > last_reading weather
********************************************************************************
WEATHER:
{
 'data': {'ambient_temp_C': 3.15,
          'date': datetime.datetime(2019, 3, 26, 5, 56, 25, 682000, tzinfo=<bson.tz_util.FixedOffset object at 0x7f0f08876898>),
          'gust_condition': 'Calm',
          'rain_condition': 'Dry',
          'rain_frequency': 2688.0,
          'rain_sensor_temp_C': '7.34',
          'safe': True,
          'sky_condition': 'Clear',
          'sky_temp_C': -36.37,
          'wind_condition': 'Calm',
          'wind_speed_KPH': 0.0},
 'type': 'weather'}
********************************************************************************
64.6 seconds old
```

However there are a couple of parts to this Issue.  Namely:

* [ ] Decide on temperature cutoff limits and add to config.
* [ ] Write a script that checks the temperature and turns the fan off and on accordingly. This script will use the `pustil` module to get the system temperature. For other temperatures you can either:
  * [ ] Listen to zeromq status messages for the `weather` and the `environment` (preferred).
  * [ ] Read the `weather` and `environment` records from the database (actually defaults to flat json files rather than a real database).
* [ ] Run this script as a separate process from within the [PEAS shell](https://github.com/panoptes/POCS/blob/develop/bin/peas_shell).

Each of those above parts will have various details to them but let's start with that. Each check box would ideally be turned into (at least) one separate Issue/PR.

kmeagle1515, 2019-03-27:
Hello!
@wtgee where will i get temperature threshold values for the computer box used here.

wtgee, 2019-03-27:
The threshold values should be read from the `peas_conf` config file under
some appropriate entry. Part of this PR would be the creation of those
initial  entries.

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

wtgee, 2024-03-28:
Closing as stale for now as much of this has changed.

Thread 131 (2017-11-25):

test_messaging.py hangs (sometimes)

jamessynge, 2017-11-25:
Tests have been passing in general, but on this run test_messaging.py hung overnight.

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

This is the tail of panoptes.log, log records from messaging.py:

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

jamessynge, 2017-11-26:
Can't repro after many attempts.

wtgee, 2017-12-07:
This suddenly is happening to me again. Can't quite identify when but am re-opening issue.

jamessynge, 2017-12-08:
I'm guessing the test uses a fixed port. I'd there a way to switch to using
a socketpair, or an ephemeral port?

On Dec 7, 2017 12:37 AM, "Wilfred Tyler Gee" <notifications@github.com>
wrote:

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

wtgee, 2017-12-08:
Yes, it does use a fixed port and I agree that is the problem.  I created the above Issue to address.

jamessynge, 2017-12-10:
FYI, I can reproduce the failures ... irregularly. For example, test_send_datetime hangs on this line:
```
    msg_type, msg_obj = sub.receive_message()
```
I don't yet understand how PanMessaging works or is used, so will leave it to you (Wilfred) to debug.

wtgee, 2017-12-10:
Thanks for info. I'll try to get to this soon.

jamessynge, 2018-02-04:
FYI, this has hung several times in the last day during my testing. I'll see if I can add any more detail about why.

jamessynge, 2018-02-05:
I notice that the failure pattern in all 3 tests within `test_messaging.py` is the same, i.e. they all fail when trying to receive the message sent on the previous line. This makes me wonder about zeromq's behavior w.r.t. store-and-forward or lack thereof. For example, is it the case that sometimes the receive_message call happens too late, and as a result the message has already been sent to the bit bucket? I'm going to test by adding a delay before all of those calls.

wtgee, 2018-02-05:
Also, from [manual](http://zguide.zeromq.org/page:all):

> There is one more important thing to know about PUB-SUB sockets: you do not know precisely when a subscriber starts to get messages. Even if you start a subscriber, wait a while, and then start the publisher, the subscriber will always miss the first messages that the publisher sends. This is because as the subscriber connects to the publisher (something that takes a small but non-zero time), the publisher may already be sending messages out.

Could be coming into play.

jamessynge, 2018-02-05:
Wow! Given that "the subscriber will always miss the first" statement, how can we use this?

jamessynge, 2018-02-05:
Maybe this is why you had included a sleep in the pub fixture?

wtgee, 2018-02-05:
I want to say it is mitigated by the forwarder component, which is a little bit different from the default PUB-SUB pattern but I'd have to go through the manual again.

wtgee, 2018-02-05:
> Maybe this is why you had included a sleep in the pub fixture?

Right, I remember now. I was just looking for a sleep in `messaging.py`. The manual says you can do that although it is an inelegant solution and is probably what is causing our problems.

I think for the main messaging I assume the first message is never going to be critical in the long run, which is probably a bad assumption.

Closed 2018-02-05.

Thread 134 (2017-11-26):

Add support for Astrohaven dome

jamessynge, 2017-11-26:
Uses a Unitronics Vision 130 PLC to control opening and closing.
Has a very simple RS-232 protocol according to this extract the installation manual:

2. Using a serial communication program like Microsoft Windows HyperTerminal
set for 9600 baud, eight bit, no parity, and hardware control = off; type “A” or “a”
to make the side opposite the controller box go up and down. Similarly type “B”
or “b” to make the side of the controller box go up and down. You will note that
the controller replies with your command until the limit switches are encountered.
For the side opposite the controller encountering the upper limit switch will result
in replies of “X” while the encountering the lower limit switch will result in replies
of “x”. You will not similar replies for the side with the controller box except they
will be “Y” and “y”.
3. Test the full Close and full Open commands using “C” and “O” as inputs. Test
also that the “R” command will reset the BG Controller after the BG (Bumper Guard) Switch has
been bumped.

jamessynge, 2018-01-15:
Tested and debugged code with Astrohaven dome at Wheaton. My only remaining concern is about shutters not quite closing all the way (a little light coming through at the top). This may be a matter of timing of commands, momentum of the shutters, position of the "closed" sensors.

Closed 2018-01-15.

Thread 138 (2017-11-26):

Consistent Class Naming

wtgee, 2017-11-26:
From @jamessynge

> I'm wondering when to use Pan as a prefix for classes. The existing examples are PanBase, PanError, PanStorage, PanStateMachine, PanWebSocket, PanMessaging, and PanMongo. On the other hand, you've not used it for classes like AbstractMount, AbstractSerialMount, Image, SerialData, etc.

> Since we're not creating a general framework, but rather an application that may be extended, I suppose we should probably limit the use of the Pan prefix to base classes, especially ones that are likely to be extended by folks like Huntsman and me that are adding support for additional hardware.

We will want to limit the prefix to probably just `PanBase` so that subclasses can override in a simpler fashion.

wtgee, 2020-02-16:
Currently we only have:

```bash
➜ ack 'class Pan'
scripts/peas-shell.py
22:class PanSensorShell(cmd.Cmd):

pocs/base.py
10:class PanBase(object):

pocs/state/machine.py
20:class PanStateMachine(Machine):
```

Closing as stale. Reopen if necessary.

Closed 2020-02-16.

Thread 139 (2017-11-26):

Move much of AbstractSerialMount into ioptron.py:Mount

jamessynge, 2017-11-26:
Much of the code is specific to the protocol used by ioptron (and some other mounts), but probably shouldn't be assumed to apply to all serial mounts.

wtgee, 2020-02-17:
Stale.

Closed 2020-02-17.

Thread 161 (2017-12-02):

Change rs232.SerialData to deal with bytes, not characters in a charset

jamessynge, 2017-12-02:
Leave it up to the caller to know whether it is dealing with a character stream, line stream or byte stream.

Address this soon after PACE and PEAS merged into POCS.

wtgee, 2017-12-21:
@jamessynge  Didn't this happen? I can't seem to find the PR.

jamessynge, 2017-12-21:
No, not yet. We don't yet have PEAS tests running in POCS, which made me reluctant to change that. We need a trivial Arduino sketch simulator (e.g. emits appropriate json every couple of seconds).

wtgee, 2018-02-13:
I want to say this has happened now. :) @jamessynge ?

wtgee, 2018-08-27:
Ping @jamessynge

jamessynge, 2018-09-09:
Closing as obsolete. We're not running into a problem with this.

Closed 2018-09-09.

Thread 162 (2017-12-02):

Remove threaded kwarg from rs232.SerialData after PEAS merge

jamessynge, 2017-12-02:
PR #148 is removing the effect of that kwarg, but hasn't cleaned up all callers.

wtgee, 2017-12-21:
Completed in https://github.com/panoptes/POCS/commit/f1124a6e4942e72b78c4b57ef6c1864773ca3ecd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

Closed 2017-12-21.

Thread 175 (2017-12-04):

Enable the solve tests by default

wtgee, 2017-12-04:
Currently tests that require the solver as disabled by default because of problems with installing astrometry.net on travis-ci. Those appear to be resolved so we should revisit this.  The option for this exists in `$POCS/pocs/tests/conftest.py`

Closed 2018-10-16.

Thread 181 (2017-12-09):

Support pyserial options in yaml files

jamessynge, 2017-12-09:
PySerial supports getting all properties as a dictionary, and replacing some or all properties with a dictionary. I'm proposing that we provide the ability to supply those properties via the yaml file. For example, instead of this (from `conf_files/pocs.yaml`):

```
mount:
    brand: ioptron
    model: 30
    driver: ioptron
    port: /dev/ttyUSB0
    non_sidereal_available: True
```

We'd instead have:
```
mount:
    brand: ioptron
    model: 30
    driver: ioptron
    non_sidereal_available: True
    serial:
       port: /dev/ttyUSB0
       baudrate: 9600
       timeout: 2.0
```

Besides adding the ability to set all of the PySerial properties, this has the added benefit of addressing the pylint complaint that the SerialData constructor takes too many arguments.

wtgee, 2017-12-10:
Yes, I like this more.

jamessynge, 2017-12-26:
I note that Observatory.initialize is supposed to be responsible for setting up the communication with devices. I'm thinking we can extend the serial section with info about what to do when the rs232 device is created. For example:
```yaml
mount:
    brand: ioptron
    model: 30
    driver: ioptron
    non_sidereal_available: True
    serial:
       port: /dev/ttyUSB0
       baudrate: 9600
       timeout: 2.0
       validate_port: True   # If true, then the port must exist at create time.
       open_port: False      # If true, then opens port immediately.
```

`open_port: True` implies `validate_port: True` simply because the port must exist in order to be opened. And since Observatory.initialize is supposed to setup communication, I'm proposing that `open_port` be `False` by default, but that `validate_port` be `True` by default.

I propose to create method `rs232.create_serial_data_from_config(serial_config, name)`, where name is something like 'mount' or 'ioptron', determined by the caller. The serial_config param is just the contents of the serial section in the config. This `rs232.create_serial_data_from_config` will be called by `dome.create_dome_from_config`, before creating the Dome instance.

@wtgee Does this make sense to you?

wtgee, 2017-12-27:
Yes, sounds good and makes sense, but is seems like the caller would already be inside the `mount` or `ioptron` so the `name` param would be redundant. It seems like `create_serial_data_from_config` shouldn't really care what it is creating a connection for, it should just return and create connection. The caller should be responsible for passing it the relevant portion of the config. Unless you had something else in mind that happens inside `create_serial_data_from_config`.

Does `create_serial_connection_from_config` make more sense despite the verbosity. Maybe since it is in `rs232` it would just be `rs232.create_connection_from_config`

jamessynge, 2018-01-18:
Perhaps we should remove the default baud rate from SerialData, as it isn't possible to choose a good default. For the Arduino Micros it *may* not make a difference as the data never goes over an RS 232 line... Not sure.

jamessynge, 2018-09-09:
The task in the title is complete AFAICT, but the addition of a `create_serial_connection_from_config` hasn't happened. I'm going to close this, and we can create another issue if desired later.

Closed 2018-09-09.

Thread 185 (2017-12-10):

Figure out appropriate behavior if device is not found at startup

jamessynge, 2017-12-10:
rs232.SerialData doesn't require that the device exist at startup, which seems generally appropriate (e.g. if restarting after a power outage, we want POCS to start even if one device is not currently powered, or is slow to startup). But this means we need some means of validating that either the port is valid, e.g. can be opened, is a well formed /dev/tty path, or has been previously validated.

wtgee, 2018-10-16:
@jamessynge has this been solved?

kmeagle1515, 2019-04-18:
https://github.com/panoptes/POCS/blob/11a181c191278bb36cf186713ef8ec7289955130/pocs/utils/rs232.py#L168
@wtgee i guess this issue is already solved

wtgee, 2019-04-19:
Closing as stale.

Closed 2019-04-19.

Thread 186 (2017-12-11):

Test iOptron mount interface (pocs/mount/ioptron.py)

jamessynge, 2017-12-11:
We now have a testing infrastructure for simulating serial devices (see `pocs/tests/serial_handlers` and `pocs/tests/test_rs232.py`). We should build a minimal handler of the iOptron mount protocol, and use it to test `pocs/mount/ioptron.py`.

Thread 189 (2017-12-13):

Adjust dome API

jamessynge, 2017-12-13:
Based on feedback / discussion in PR #188:
- Rename state to status.
- Remove _is_connected from AbstractDome.

wtgee, 2017-12-28:
* `status` should be a method, not a property, to maintain consistency with all other hardware.
* `Observatory.open_dome()` and `Observatory.close_dome()` do not need to exist

wtgee, 2018-02-13:
@jamessynge I believe these have been taken care of. Request to remove `open_dome` and `close_dome` withdrawn.

jamessynge, 2018-09-09:
#587 opened to track the remaining issue.

Closed 2018-09-09.

Thread 198 (2017-12-16):

Properly document all kwargs for POCS class

wtgee, 2017-12-16:
Currently missing some params, e.g. `sleep_delay`, `safe_delay`

Thread 199 (2017-12-17):

Integrate dome support into POCS and Observatory

jamessynge, 2017-12-17:
For Wheaton (PAN006) and the Huntsman Array, we need to enable the addition of dome support into the POCS' state machine and Observatory's set of devices, but in a way which doesn't impact deployments without domes.

jamessynge, 2017-12-23:
#231 Added a dome attribute to Observatory, minimally.

jamessynge, 2018-01-15:
I've now tested (and debugged) this with the Astrohaven dome at Wheaton.

Closed 2018-01-15.

Thread 232 (2017-12-21):

Fix make_pretty_image for FITS files

wtgee, 2017-12-21:
Image currently doesn't show anything and is far from pretty. Need to change the private function [`_make_pretty_from_fits`](https://github.com/AstroHuntsman/POCS/blob/develop/pocs/utils/images.py#L477).

See also #43

wtgee, 2018-01-15:
#319 in progress.

jermainegug, 2018-01-15:
#319, I believe is ready to be merged.

Closed 2018-01-16.

Thread 235 (2017-12-21):

Link focusing images to latest.jpg

wtgee, 2017-12-21:
Would be nice to see the focusing as it changes. Would only happen for primary camera without some work.

wtgee, 2018-02-13:
@jermainegug this might be an easy one to pick off in some of your sleepless nights :)

jermainegug, 2018-02-13:
@wtgee sounds good :)

wtgee, 2018-02-13:
Actually it's not entirely obvious what we want to see here. @AnthonyHorton, any input?

AnthonyHorton, 2018-02-14:
Hmmm, most useful would probably be the `*_final.fits` image that gets taken once the autofocus thinks it's finished.  Would be nice to be able to confirm at a glance that a decent focus was obtained.

The other images get superceded so quickly (for broadband filters, at least) they'd be gone before PAWS updated.

wtgee, 2018-02-14:
But which of the cameras would we want to view this for? Ideally we just modify it to get links for all of them I suppose, but that is more work.

AnthonyHorton, 2018-02-14:
Yes, ideally you'd check all the cameras, but that would be more work. Question is whether it would be worth it? Depends on how often there are going to be issues with focusing. Working on that...

wtgee, 2018-08-27:
This was completed at some point.

Closed 2018-08-27.

Thread 242 (2017-12-22):

test_run_wait_until_safe hangs sometimes

jamessynge, 2017-12-22:
I've taken to using a time out of **5 minutes** when running tests, and this test not infrequently hits the timeout (checked on the `develop` branch with no changes in place). Given the structure of the test, it seems like it is just hung.

A number of `test_pocs.py` tests have a similar structure, and would benefit from a redesign. Assigning to @wtgee for input on the issue and for redesign ideas, not necessarily for implementation.

wtgee, 2017-12-22:
This is a timeout on individual tests?

jamessynge, 2017-12-22:
Yes, a timeout on a single test.

jamessynge, 2017-12-22:
Details from pytest:

```
_____________________________________ test_run_wait_until_safe ______________________________________

db = <pocs.utils.database.PanMongo object at 0x7fb8341879e8>
observatory = <pocs.observatory.Observatory object at 0x7fb8340e0fd0>

    def test_run_wait_until_safe(db, observatory):
        os.environ['POCSTIME'] = '2016-08-13 23:00:00'

        def start_pocs():
            observatory.config['simulator'] = ['camera', 'mount', 'night']

            pocs = POCS(observatory,
                        messaging=True, safe_delay=15)
            pocs.db.current.remove({})
            pocs.initialize()
            pocs.logger.info('Starting observatory run')
            assert pocs.is_weather_safe() is False
            pocs.send_message('RUNNING')
            pocs.run(run_once=True, exit_when_done=True)
            assert pocs.is_weather_safe() is True

        pub = PanMessaging.create_publisher(6500)
        sub = PanMessaging.create_subscriber(6511)

        pocs_process = Process(target=start_pocs)
        pocs_process.start()

        # Wait for the running message
        while True:
>           msg_type, msg_obj = sub.receive_message()

pocs/tests/test_pocs.py:205:
_ _ _ _ _ _ _ _ _ _ _ _ _ _ _ _ _ _ _ _ _ _ _ _ _ _ _ _ _ _ _ _ _ _ _ _ _ _ _ _ _ _ _ _ _ _ _ _ _ _ _
pocs/utils/messaging.py:142: in receive_message
    message = self.socket.recv_string(flags=flags)
../../../anaconda3/envs/panoptes-env/lib/python3.6/site-packages/zmq/sugar/socket.py:457: in recv_string
    msg = self.recv(flags=flags)
zmq/backend/cython/socket.pyx:693: in zmq.backend.cython.socket.Socket.recv
    ???
zmq/backend/cython/socket.pyx:727: in zmq.backend.cython.socket.Socket.recv
    ???
zmq/backend/cython/socket.pyx:145: in zmq.backend.cython.socket._recv_copy
    ???
_ _ _ _ _ _ _ _ _ _ _ _ _ _ _ _ _ _ _ _ _ _ _ _ _ _ _ _ _ _ _ _ _ _ _ _ _ _ _ _ _ _ _ _ _ _ _ _ _ _ _

>   ???
E   Failed: Timeout >300.0s

zmq/backend/cython/checkrc.pxd:12: Failed
--------------------------------------- Captured stderr setup ---------------------------------------
2017-12-20 22:14:04 galago panoptes[27020] INFO Initializing observatory
2017-12-20 22:14:04 galago panoptes[27020] INFO 	Setting up location
2017-12-20 22:14:04 galago panoptes[27020] INFO 	Setting up mount
2017-12-20 22:14:04 galago panoptes[27020] INFO 		Using simulator mount
2017-12-20 22:14:04 galago panoptes[27020] INFO 	Setting up cameras
2017-12-20 22:14:04 galago panoptes[27020] INFO 			 Simulated Focuser (SF0577) on /dev/ttyFAKE initialised
2017-12-20 22:14:04 galago panoptes[27020] INFO 			 Simulated Focuser (SF2162) on /dev/ttyFAKE initialised
2017-12-20 22:14:04 galago panoptes[27020] INFO 	Setting up scheduler
2017-12-20 22:14:04 galago panoptes[27020] INFO 	 Observatory initialized
--------------------------------------- Captured stderr call ----------------------------------------
2017-12-20 22:14:04 galago panoptes[27171] INFO Initializing PANOPTES unit - Generic PANOPTES Unit - Mauna Loa Observatory
2017-12-20 22:14:04 galago panoptes[27171] INFO Loading state table: simple_state_table
2017-12-20 22:14:06 galago root[27171] INFO PANCHAT Hi there!
2017-12-20 22:14:06 galago root[27171] INFO PANCHAT Initializing the system! Woohoo!
2017-12-20 22:14:07 galago panoptes[27171] INFO Starting observatory run
2017-12-20 22:14:07 galago panoptes[27171] WARNING No record found in Mongo DB
2017-12-20 22:14:07 galago panoptes[27171] WARNING No record found in Mongo DB
2017-12-20 22:14:07 galago panoptes[27171] WARNING Unsafe conditions: {'is_dark': True, 'good_weather': False, 'free_space': True}
2017-12-20 22:14:07 galago panoptes[27171] WARNING No record found in Mongo DB
2017-12-20 22:14:23 galago panoptes[27171] WARNING No record found in Mongo DB
2017-12-20 22:14:39 galago panoptes[27171] WARNING No record found in Mongo DB
2017-12-20 22:14:56 galago panoptes[27171] WARNING No record found in Mongo DB
2017-12-20 22:15:12 galago panoptes[27171] WARNING No record found in Mongo DB
2017-12-20 22:15:28 galago panoptes[27171] WARNING No record found in Mongo DB
2017-12-20 22:15:44 galago panoptes[27171] WARNING No record found in Mongo DB
2017-12-20 22:16:01 galago panoptes[27171] WARNING No record found in Mongo DB
2017-12-20 22:16:17 galago panoptes[27171] WARNING No record found in Mongo DB
2017-12-20 22:16:33 galago panoptes[27171] WARNING No record found in Mongo DB
2017-12-20 22:16:49 galago panoptes[27171] WARNING No record found in Mongo DB
2017-12-20 22:17:05 galago panoptes[27171] WARNING No record found in Mongo DB
2017-12-20 22:17:22 galago panoptes[27171] WARNING No record found in Mongo DB
2017-12-20 22:17:38 galago panoptes[27171] WARNING No record found in Mongo DB
2017-12-20 22:17:54 galago panoptes[27171] WARNING No record found in Mongo DB
2017-12-20 22:18:11 galago panoptes[27171] WARNING No record found in Mongo DB
2017-12-20 22:18:27 galago panoptes[27171] WARNING No record found in Mongo DB
2017-12-20 22:18:43 galago panoptes[27171] WARNING No record found in Mongo DB
2017-12-20 22:18:59 galago panoptes[27171] WARNING No record found in Mongo DB
```

jamessynge, 2017-12-22:
I used this command to install a timeout plugin:

`pip install pytest-timeout`

wtgee, 2018-02-13:
Recent work has been done on this both in terms of changing the test as well as changing the messaging system for tests in general. Closing until more specific need identified.

Closed 2018-02-13.

Thread 245 (2017-12-23):

Wait for iOptron mount to acquire GPS signal

jamessynge, 2017-12-23:
According Kevin @ iOptron, if we **do not** send the "set lat-long" commands to an iOptron mount, it will discover its location on its own. The implication of our conversation was that if we *do* set the location explicitly, we can never find out what the GPS module in the mount has discovered.

First step: Validate what I heard from Kevin by toggling the mount off-and-on using the relays, then see if we can read the location from the mount, and how long it takes to acquire the location (which will presumably vary by location).

wtgee, 2017-12-24:
I'm curious about what this reveals. Previously we didn't have the ability to power-cycle so this wasn't really an option. Would be great to get exact GPS.

wtgee, 2020-02-16:
See also #953

Thread 261 (2017-12-29):

pytest failures on PAN006

jamessynge, 2017-12-29:
As mentioned in #260, I've updated PAN006 to latest commit on POCS upstream/develop (3cf2831b0dda9ecf3b8d70ab64069789d06a4c94). `pytest` shows the failures below, which I don't immediately recognize:

```python
=============================================================== FAILURES ================================================================
____________________________________________________________ test_error_exit ____________________________________________________________

config = {'cameras': {'auto_detect': True, 'devices': [{'model': 'canon_gphoto2'}, {'model': 'canon_gphoto2'}], 'primary': '14d...: <Quantity 3400.0 m>, 'gmt_offset': -600, 'horizon': <Quantity 30.0 deg>, 'latitude': <Quantity 19.54 deg>, ...}, ...}

    def test_error_exit(config):
        with pytest.raises(SystemExit):
>           Observatory(ignore_local_config=True, simulator=['none'])
E           Failed: DID NOT RAISE <class 'SystemExit'>

pocs/tests/test_observatory.py:40: Failed
____________________________________________________________ test_bad_camera ____________________________________________________________

config = {'cameras': {'auto_detect': True, 'devices': [{'model': 'canon_gphoto2'}, {'model': 'canon_gphoto2'}], 'primary': '14d...: <Quantity 3400.0 m>, 'gmt_offset': -600, 'horizon': <Quantity 30.0 deg>, 'latitude': <Quantity 19.54 deg>, ...}, ...}

    def test_bad_camera(config):
        conf = config.copy()
        simulator = hardware.get_all_names(without=['camera'])
        with pytest.raises(error.PanError):
>           Observatory(simulator=simulator, config=conf, auto_detect=True, ignore_local_config=True)
E           Failed: DID NOT RAISE <class 'pocs.utils.error.PanError'>

pocs/tests/test_observatory.py:79: Failed
_________________________________________________________ test_camera_not_found _________________________________________________________

config = {'cameras': {'auto_detect': True, 'devices': [{'model': 'canon_gphoto2'}, {'model': 'canon_gphoto2'}], 'primary': '14d...: <Quantity 3400.0 m>, 'gmt_offset': -600, 'horizon': <Quantity 30.0 deg>, 'latitude': <Quantity 19.54 deg>, ...}, ...}

    def test_camera_not_found(config):
        conf = config.copy()
        simulator = hardware.get_all_names(without=['camera'])
        with pytest.raises(error.PanError):
>           Observatory(simulator=simulator, config=conf, ignore_local_config=True)
E           Failed: DID NOT RAISE <class 'pocs.utils.error.PanError'>

pocs/tests/test_observatory.py:86: Failed
========================================== 3 failed, 225 passed, 60 skipped in 646.41 seconds ===========================================
panoptes@Panmass:/var/panoptes/POCS$
```

wtgee, 2017-12-29:
This looks like missing install files. Did you end up creating an anaconda environment that is not loaded?

jamessynge, 2017-12-29:
Yes I created the anaconda panoptes env, and it is activated.

On Thu, Dec 28, 2017 at 8:05 PM, Wilfred Tyler Gee <notifications@github.com
> wrote:

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

wtgee, 2018-01-15:
Closing this, feel free to reopen but I think PAN006 is running now.

Closed 2018-01-15.

Thread 267 (2017-12-29):

peas_shell logging errors

jamessynge, 2017-12-29:
After updating POCS on PAN006 to include the piaa imaging fix, peas_shell is still spewing logging related errors.

```python
panoptes@Panmass:/var/panoptes/POCS$ bin/peas_shell
Welcome to PEAS Shell! Type ? for help
PEAS > load_environment
Loading sensors
PEAS > load_weather
Loading AAG Cloud Sensor on /dev/ttyUSB1
--- Logging error ---
Traceback (most recent call last):
  File "/home/panoptes/anaconda3/lib/python3.6/logging/__init__.py", line 992, in emit
    msg = self.format(record)
  File "/home/panoptes/anaconda3/lib/python3.6/logging/__init__.py", line 838, in format
    return fmt.format(record)
  File "/home/panoptes/anaconda3/lib/python3.6/logging/__init__.py", line 578, in format
    s = self.formatMessage(record)
  File "/home/panoptes/anaconda3/lib/python3.6/logging/__init__.py", line 547, in formatMessage
    return self._style.format(record)
  File "/home/panoptes/anaconda3/lib/python3.6/logging/__init__.py", line 399, in format
    return self._fmt.format(**record.__dict__)
KeyError: 'fileline'
Call stack:
  File "bin/peas_shell", line 296, in <module>
    PanSensorShell().cmdloop()
  File "/home/panoptes/anaconda3/lib/python3.6/cmd.py", line 138, in cmdloop
    stop = self.onecmd(line)
  File "/home/panoptes/anaconda3/lib/python3.6/cmd.py", line 217, in onecmd
    return func(arg)
  File "bin/peas_shell", line 148, in do_load_weather
    self.weather = AAGCloudSensor(serial_address=port, use_mongo=True)
  File "/var/panoptes/POCS/peas/weather.py", line 127, in __init__
    self.logger.info('Connecting to AAG Cloud Sensor')
Message: 'Connecting to AAG Cloud Sensor'
Arguments: ()
--- Logging error ---
Traceback (most recent call last):
  File "/home/panoptes/anaconda3/lib/python3.6/logging/__init__.py", line 992, in emit
    msg = self.format(record)
  File "/home/panoptes/anaconda3/lib/python3.6/logging/__init__.py", line 838, in format
    return fmt.format(record)
  File "/home/panoptes/anaconda3/lib/python3.6/logging/__init__.py", line 578, in format
    s = self.formatMessage(record)
  File "/home/panoptes/anaconda3/lib/python3.6/logging/__init__.py", line 547, in formatMessage
    return self._style.format(record)
  File "/home/panoptes/anaconda3/lib/python3.6/logging/__init__.py", line 399, in format
    return self._fmt.format(**record.__dict__)
KeyError: 'fileline'
Call stack:
  File "bin/peas_shell", line 296, in <module>
    PanSensorShell().cmdloop()
  File "/home/panoptes/anaconda3/lib/python3.6/cmd.py", line 138, in cmdloop
    stop = self.onecmd(line)
  File "/home/panoptes/anaconda3/lib/python3.6/cmd.py", line 217, in onecmd
    return func(arg)
  File "bin/peas_shell", line 148, in do_load_weather
    self.weather = AAGCloudSensor(serial_address=port, use_mongo=True)
  File "/var/panoptes/POCS/peas/weather.py", line 130, in __init__
    self.logger.info("  Connected to Cloud Sensor on {}".format(serial_address))
Message: '  Connected to Cloud Sensor on /dev/ttyUSB1'
Arguments: ()
```

jamessynge, 2017-12-29:
Fixed by #269

Closed 2017-12-29.

Thread 268 (2017-12-29):

Add config display to shells

jamessynge, 2017-12-29:
pocs_shell & peas_shell should have commands to display the config that is loaded.

jermainegug, 2018-01-24:
Would something like this work?
```
    def do_display_config(self, config):
        """ Display the config file for <pocs/peas> """
        if config is None:
            print_error("No config file for <pocs/peas> has been loaded.")
        else:
            print(config)
```

jermainegug, 2018-01-24:
Will do the same for pocs_shell and will open a PR.

wtgee, 2018-02-13:
Added in #417, thanks @jermainegug !

Closed 2018-02-13.

Thread 270 (2017-12-29):

Figure out a per-module/per-logger logging strategy

jamessynge, 2017-12-29:
peas_shell has support for per-sensor logging level, but we've now got a single root logger and no child loggers. If we have multiple loggers in a hierarchy, then we can enable the filtering of log records before output at the module level and/or augment the output with the logger name so that filtering can be done after the fact. I'm not as keen on the latter because it makes the lines long, and slightly duplicates the file & line info we have in the log file already.

I suspect we could add a get_child_logger(kid_name) method to pocs/utils/logger.py that would return a child of the root logger for the specified child name; we would probably use the __NAME__ of the calling module most of the time, but might also use the name of the device (e.g. camera01 or mount).

Thread 275 (2017-12-30):

Arduino counter overflow

jamessynge, 2017-12-30:
The "num" field is apparently an int (16-bits on the Arduino Micro), so is overflowing fairly often.

{"name":"camera_board", "count":444741711, "num":-25746, "inputs":5, "camera_00":1, "camera_01":1, "accelerometer":{"x":-7.01, "y":6.90, "z":1.63, "o": 6}, "humidity":37.40, "temp_00":-10.20}

wtgee, 2017-12-30:
We don't have a `num` field that we report. Is that something you added in your version?

jamessynge, 2018-01-01:
Yes. There was a count field that shows the output from millis(), and I added num to show the count of reports that have been generated. Ideally (IMHO) we'd rename these to millis and report_num.

wtgee, 2018-02-13:
I believe this has been correctly handled, closing for now. Reopen if needed.

Closed 2018-02-13.

Thread 276 (2017-12-30):

Drop Voltage to Amps conversion in telemetry board code

jamessynge, 2017-12-30:
(Moved from PACE repo.)

The conversion in the telemetry board sketch from the analogRead value (voltage) to amps on the 4 current sensed lines forces us to modify the sketch for each installation. We should do that on the NUC with a yaml file instead.

wtgee, 2017-12-31:
Duplicate of #126, closing.

Closed 2017-12-31.

Thread 277 (2017-12-30):

Re-enable auto_detect of Arduinos

jamessynge, 2017-12-30:
The Arduinos aren't always associated with the same /dev/ttyACM device, so the currently disabled auto_detect feature would be valuable.

Closed 2017-12-31.

Thread 281 (2017-12-31):

Enable Arduino IDE to work with camera & telemetry boards

jamessynge, 2017-12-31:
We have some of the required libraries copied into the POCS repo (but not all), however the Arduino IDE doesn't make it easy to use libraries that aren't installed in a user or system-wide Arduino directory.

Fix this by using symlinks. This works on Linux, should work on MacOS, and may even work on modern versions of Windows.

wtgee, 2018-01-01:
Note that these were removed as part of consolidation process. Just made notes yesterday regarding this specific item: https://github.com/panoptes/POCS/issues/107

I'm a little bit sceptical about having these libraries in our repo but it does facilitate building. We could also think about just having a script that installs them, which would keep them out of our repo but make them available to user.

Note that lately I've been using the web-based Arduino IDE, which will automatically handle the libraries. However I realize that's not ideal for an actual unit.

jamessynge, 2018-01-01:
I understand the skepticism. However, since these libraries are stable for our purposes, are very small, and are not easy to automatically add to the Arduino install (i.e. its tools are primarily aimed at the GUI, not CLI).

Closed 2018-01-01.

Thread 283 (2017-12-31):

Verify that Arduino sketches can build

jamessynge, 2017-12-31:
The Travis CI build tests that pocs works, but not that we can build the Arduino sketches. We should fix that. As of Arduino 1.5, the Arduino IDE has a command-line mode where it can verify (compile) or upload sketches. For example, this works on my laptop (following PR #282):
```bash
/home/james/tools/arduino-1.8.2/arduino \
    --verify --board arduino:avr:micro \
    resources/arduino_files/camera_board/camera_board.ino
```

wtgee, 2018-01-01:
Yes, good idea. Examples [here](https://learn.adafruit.com/continuous-integration-arduino-and-you/testing-your-project).

Closed 2018-01-03.

Thread 285 (2018-01-01):

Choose between OneWire and Wire

jamessynge, 2018-01-01:
The Arduino code has and/or uses both. Wilfred suggests we should choose one.

jamessynge, 2018-01-05:
Apparently we should NOT choose between Wire.h and OneWire.h:
- Wire.h could be called TwoWire.h, because it is related to I2C, which we use for the accelerometer.
- OneWire.h supports the Dallas Semiconductor 1-wire protocol, used for the DS18B20 temp sensors.

Closed 2018-01-05.

Thread 289 (2018-01-03):

Share code between the Arduino sketches

jamessynge, 2018-01-03:
We've got duplicated classes between the 3 sketches. Move those to a shared library.

jamessynge, 2018-01-15:
Fixed with several PRs that created symlinks from the sketch folders to files in arduino_files/shared.

Closed 2018-01-15.

Thread 292 (2018-01-04):

last_reading should provide help feedback if device param is invalid

wtgee, 2018-01-04:
@jamessynge said: I was forgetting to specify the device param to the last_reading command, so it was doing nothing, and I didn't realize that I was leaving out a necessary parameter.

wtgee, 2018-02-13:
Added by @jamessynge (thanks!)

Closed 2018-02-13.

Thread 293 (2018-01-04):

PanSensorShell Status Improvement

wtgee, 2018-01-04:
Show timestamp for last reading received from each device when calling status

wtgee, 2018-02-13:
We now show the number of seconds since last reading. Closing issue.

Closed 2018-02-13.

Thread 294 (2018-01-04):

stream data in real time

wtgee, 2018-01-04:
@mimming  said (May 2016):

## What we have now

sensor data is being dropped into Google Cloud Storage daily.  A python script is slurping it up, and loading it into BigQuery
## desired state

Create a Pub/Sub pipeline that accepts sensor data and follow this path:

```
Pub/Sub -> DataFlow (Beam) [as necessary] -> BigQuery
```

It looks like Dataflow for Python is still in alpha.

I'm going to wait until it's in beta before I move to it.

In the mean time, use this model to get batches:

Panoptes unit -> Cloud Storage bucket unit_sensors -> Python script on compute engine VM -> BigQuery

wtgee, 2020-02-16:
A `FirestoreDB` class was added but never put into use.  It's a fairly trivial set up if we decide we want it.

wtgee, 2022-01-19:
This ability was added with #1150 and the `panoptes_network.use_firestore` config key. Improvements or changes should open a new Issue.

Closed 2022-01-19.

Thread 295 (2018-01-04):

Warning about power_board.ino

jamessynge, 2018-01-04:
The travis build has this warning:
```
/home/travis/build/panoptes/POCS/resources/arduino_files/power_board/power_board.ino: In instantiation of 'bool CharBuffer<kBufferSize>::Append(char) [with unsigned char kBufferSize = 8u]':
/home/travis/build/panoptes/POCS/resources/arduino_files/power_board/power_board.ino:158:57:   required from here
/home/travis/build/panoptes/POCS/resources/arduino_files/power_board/power_board.ino:99:25: warning: ISO C++ forbids comparison between pointer and integer [-fpermissive]
       if (write_cursor_ < buf_ + kBufferSize) {
                         ^
```

I think I wrote that code, so assigning to self.

Closed 2018-01-05.

Thread 304 (2018-01-06):

Add tests for pocs_shell

jamessynge, 2018-01-06:
pocs_shell is quite large, but there are no tests of it.

jamessynge, 2019-07-21:
Assigning to @ImmortalRabbit following our discussion of his decoupling changes which remove Dome and Scheduler creation from Observatory. There have not been corresponding changes (yet) to pocs_shell, so it seems likely that the current code might not work properly with POCS/bin/pocs_shell.

I propose that we extract the code that isn't related to command line parsing from pocs_shell, and move it to a top-level "driver" class, along with some of the attributes of PocsShell (e.g. pocs, msg_subscriber, etc.). For example, do_setup_pocs would parse the command line, then call a setup_pocs method of the driver class. This class will be testable, and might actually allow us to test the command line parsing of pocs_shell by creating a fake driver and injecting it into pocs_shell. Altogether, this means refactor PocsShell, extracting portions of it out into a helper called PocsDriver.

- [ ] Create class PocsDriver in POCS/pocs/pocs_driver.py, move the msg_* and cmd_* attributes to the driver, along with the methods that most directly interact with them (e.g. start_messaging, etc.).
- [ ] Write pytests of the new messaging related methods in PocsDriver.
- [ ] Add a pocs_driver attribute to PocsShell, initialized to an instance of PocsDriver.
- [ ] Remove the msg_* and cmd_* attributes of pocs_shell, and modify pocs_shell to call the methods in PocsDriver instead.
- [ ] Move the helper functions at the bottom of pocs_shell (e.g. get_observation) to the driver file (necessary for those helper functions that are used by the new methods of PocsDriver).
- [ ] Write pytests for the helper methods.
- [ ] Move the attribute pocs from PocsShell to PocsDriver, and create methods for the non-CLI parsing activities that PocsShell was doing with pocs.
- [ ] Write pytests of the new pocs related methods in PocsDriver.
- [ ] Remove the pocs attribute of pocs_shell, and modify pocs_shell to call the appropriate methods in PocsDriver instead.

Bonus items:

- [ ] Create an AbstractPocsDriver with abstract methods that are needed by PocsShell, use as the base class of PocsDriver.
- [ ] Create a MockPocsDriver (subclass of AbstractPocsDriver) (@wtgee can provide pointers regarding mocking).
- [ ] Allow injection of the MockPocsDriver in PocsShell
- [ ] Write tests of PocsShell where we pass in a command line string to the parsing code, and confirm that the MockPocsDriver was called with the appropriate args.

Note also that pocs_shell contains DriftShell, which could also similar treatment.

wtgee, 2022-01-15:
Closing as stale.

Closed 2022-01-15.

Thread 309 (2018-01-08):

Emit debug messages from Arduino as JSON

jamessynge, 2018-01-08:
The aim is to not derail the Python code that expects all output from the Arduinos to be "readings" (i.e. a line with a single JSON object).

jamessynge, 2018-01-15:
Partially addressed by #345.

wtgee, 2020-02-16:
Closing this in favor of #310 as it's not clear what specifics this issue is looking for.

Closed 2020-02-16.

Thread 310 (2018-01-08):

Explore use of JSON library for arduino

wtgee, 2018-01-08:
Our JSON handling is kind of clunky and makes us have to manage commas and other strings in weird ways. We should explore the use of a library such as https://github.com/bblanchon/ArduinoJson

Related: #309

jamessynge, 2018-01-08:
I was thinking of writing something simple for JSON serialization, but ArduinoJson looks like it covers all the bases, and then some!

wtgee, 2018-01-08:
I don't think it was that developed a year or so ago when I last checked but looks pretty nice now.

We could consider using json for input as well. (Now that you've written the nice input handlers. :smiley:)

wtgee, 2020-02-16:
Will be closed by #860

Closed 2020-11-14.

Thread 311 (2018-01-10):

Compilation warning from telemetry_board.ino

jamessynge, 2018-01-10:
I only see this warning on PAN006, not my laptop or travis:

```
In file included from /var/panoptes/POCS/resources/arduino_files/telemetry_board/telemetry_board.ino:28:0:
sketch/dallas_temperature_handler.h: In instantiation of 'void DallasTemperatureHandler<kMaxSensors>::PrintDeviceInfo() [with unsigned int kMaxSensors = 3u]':
/var/panoptes/POCS/resources/arduino_files/telemetry_board/telemetry_board.ino:391:32:   required from here
sketch/dallas_temperature_handler.h:77:62: warning: invalid conversion from 'const uint8_t* {aka const unsigned char*}' to 'uint8_t* {aka unsigned char*}' [-fpermissive]
         uint8_t resolution = dt_.getResolution(device.address);
                                                              ^
In file included from sketch/dallas_temperature_handler.h:5:0,
                 from /var/panoptes/POCS/resources/arduino_files/telemetry_board/telemetry_board.ino:28:
sketch/DallasTemperature.h:104:11: note: initializing argument 1 of 'uint8_t DallasTemperature::getResolution(uint8_t*)'
   uint8_t getResolution(uint8_t*);
           ^
```

wtgee, 2018-01-10:
Can you include the command you used to compile it? I'm going to try similar on PAN001

jamessynge, 2018-01-10:
I can check later, but I think it was:
```
~/arduino-1.8.5/arduino --upload --port /dev/ttyACM1 --board arduino:avr:micro telemetry_board.ino
```
The port needs to be changed based on which port your telemetry board is connected to. The command was executed from `$POCS/resources/arduino_files/telemetry_board`.

wtgee, 2018-01-11:
Note that I see this on PAN001 as well.

wtgee, 2018-01-11:
Confirmed I'm **not** seeing it on my local.

jamessynge, 2018-01-12:
The latest version of the DallasTemperature code declares the input device array as const, which must be what I was using when I wrote that code last summer, on a different laptop. I'll update and retest.

Closed 2018-01-14.

Thread 312 (2018-01-11):

Reconcile baudrate differences

jamessynge, 2018-01-11:
The Arduino sketches setup their serial ports at 9600 buad, while rs232.SerialData defaults to 115200 (and is not overridden). I suspect communication is working because we're using Serial over USB, so the baudrate probably doesn't matter.

wtgee, 2018-01-11:
Actual solution to whatever we figure out should be part of #181.

jamessynge, 2018-01-15:
For now, this is addressed by hard coding baudrate=9600 in sensors.py.

Closed 2018-01-15.

Thread 314 (2018-01-11):

camera_board.ino needs to support toggle

wtgee, 2018-01-11:
The PEAS shell toggle sends a `9` to toggle items but the current camera board only supports on (`1`) and off (`0`)

wtgee, 2020-02-16:
Closed by #860

Closed 2022-01-15.

Thread 316 (2018-01-11):

Temperatures not reading on PAN001

wtgee, 2018-01-11:
The DS18B20s are not reading on the telemetry board after updating to most recent code. Perhaps related to #311

jamessynge, 2018-01-11:
I'll make up a board with a couple of the temp sensors so that I can validate the code.

wtgee, 2018-01-11:
I am going to try and adapt the trucker board to the shared libraries in which case I have a board already built up to test. Will see if I can do this weekend.

wtgee, 2018-01-12:
Definitely part of #311. The compilation warnings relate to a section of the code that is printing the resolution for the DHT as part of `PrintDeviceInfo`. I simply commented out that line and compilation worked without complaints. Uploading to telemetry board then gets me temperature (and current) readings.

Closing as non-issue in favor of fixing #311

Closed 2018-01-12.

Thread 317 (2018-01-11):

Fix auto-detect of arduinos

jamessynge, 2018-01-11:
I apparently broke the auto-detect code when "refactoring" it (i.e. not really a refactor). This needs fixing ASAP.

jamessynge, 2018-01-15:
Fixed with #177 (which says DO NOT MERGE, but I added code without remembering to rename the PR).

Closed 2018-01-15.

Thread 318 (2018-01-11):

Prevent Arduinos from locking up

jamessynge, 2018-01-11:
I screwed something up with the telemetry board on PAN006 a while agosuch that it wouldn't respond.
This should be fixed in current code, but it would be a good idea to keep ourselves from screwing up. One solution is a watchdog timer. See: https://tushev.org/articles/arduino/5/arduino-and-watchdog-timer

According to that page, this code would trigger a reset if loop() doesn't run every 8 seconds:
```c++
#include <avr/wdt.h>
void setup(){
wdt_enable(WDTO_8S);
}
void loop(){
//do stuff here
wdt_reset();
}
```

wtgee, 2018-01-11:
I played with the watchdog timer in the beginning (three years ago) and seem to remember I couldn't get it to work on the micro. Worth exploring again though.

kmeagle1515, 2019-04-18:
@jamessynge @wtgee for timer specific threshold values are available. That mainly depends upon our requirement. So what threshold should be ideal for our system?

Closed 2020-11-14.

Thread 322 (2018-01-12):

Identify camera.uid with specific arduino pin

wtgee, 2018-01-12:
We currently don't have any way to know which camera is on which arduino pin. This can be done as part of a config setup as it won't change.

jamessynge, 2018-01-12:
I wondered about that when I was doing the build, so made it a point to label the cameras and barrel jacks, and record that in the config file.

wtgee, 2020-02-16:
#860 related

Closed 2020-11-14.

Thread 326 (2018-01-12):

Define consistent JSON format for boards.

jamessynge, 2018-01-12:
We need to have the two boards use the same basic structure for their output. They should have a version identifier, relay values should be identified as such.

wtgee, 2018-01-12:
Just a note that these are mostly passed through, which means it relates somewhat to this conversation: https://github.com/orgs/panoptes/teams/pocs-developers/discussions/6

jamessynge, 2018-09-22:
Resurrecting this issue...

Let's start with some facts, based on the currently committed sketches and the January 2017 electronics:

- The camera board is set to emit a report [once every second](https://github.com/panoptes/POCS/blob/develop/resources/arduino_files/camera_board/camera_board.ino#L148) (specifically, every 1000 ms).
- The telemetry board is set to emit a report [once every two seconds](https://github.com/panoptes/POCS/blob/develop/resources/arduino_files/telemetry_board/telemetry_board.ino#L52).
- Each report is a single line of text terminated with a CR LF (newline, linefeed).
- The reports are in JSON object format; the only white space is the space character between property:value pairs, and the terminating CR LF.
- The first property in each report is "name", currently with one of these two values "telemetry_board" or "camera_board."
- Reports are written to the local db mostly unmodified, but with some extra info added.
- A camera board report has these properties:
  - name: "camera_board"
  - count: The number of milliseconds since the `setup()` method finished. _This is problematic because it the code doesn't deal with wrap around._
  - num: The report number; starts at one, increments with each report.
  - inputs_received: Number of times that `Serial.available() > 0` was true. This is for debugging the parsing of inputs (i.e. relay changes).
  - camera_00: Whether the relay for camera 0 is open/off (value=0) or closed/on (value=1).
  - camera_01: Whether the relay for camera 1 is open/off (value=0) or closed/on (value=1).
  - accelerometer: The value is a JSON object with the readings from the [MMA8451](https://www.adafruit.com/product/2019) 3-axis accelerometer; there are four properties, x, y, z and o (for orientation).
  - humidity: The relative humidity as determined by the [DHT22](https://www.adafruit.com/product/385) or [AM2302](https://www.adafruit.com/product/393) temperature and humidity sensor (the latter contains the former). Note that relative humidity varies by temperature, with warmer air able to hold more moisture without becoming saturated (i.e. without it starting to condense on surfaces or to rain).
  - temp_00: The temperature (Celcius) as determined by the DHT22 or AM2302 sensor. The numbering is to allow for the extra temperature sensors reported by the telemetry board.

- The telemetry board reports have these properties:
  - name: "telemetry_board"
  - millis: The number of milliseconds since the sketch started. This will reset to zero after 49.71 days: the 32-bit unsigned value can only count that high, then wraps around to zero and continues counting. It is common for the software in an embedded microcontroller, such as in the Arduino, to run continuously through many such intervals.
  - report_num: The report number; starts at one, increments with each report. This is unlikely to wrap around as it would take 272 years!
  - ver: A string indicating the version of the Arduino sketch. Currently "2018-01-14". _It might be good to include the git commit id in some way._
  - power: This is a JSON object with properties related to the state of relays/power lines. In each case, the value indicates if the relay/power line is open/off (value=0) or closed/on (value=1).
    - computer: State of the relay controlling power to the NUC.
    - fan: State of the relay controlling power to the cooling/ventilation fan.
    - mount: State of the relay controlling power to the equatorial mount.
    - cameras: State of the relay controlling power to the camera box.
    - weather: State of the relay controlling power to the weather sensors.
    - main: Does the AC power line have power? Used for detecting power failures.
  - current: This is a JSON object with properties recording the value from the Analog to Digital converter applied to the voltage output of the electrical current sensors. These are in the range 0 through 1023, and their real world meaning is based on the offset and scale settings of sensors. The JSON object has these properties:
    - main: DC input current from the power supply to the V0 power board. May be over 5A, but unlikely.
    - fan: DC output current to the fan (should be well under 500mA).
    - mount: DC output current to the equatorial mount (should be under 1A most of the time).
    - cameras: DC output current to the camera box (i.e. to the cameras, camera_board and USB hub that are all in the camera box).
  - amps: This is a JSON object with the same set of property names as in current, but with the values scaled from ADU (analog-digital units) to amps... but only if the constants in the sketch (see `main_amps_mult`) are accurate, which is unlikely because the original current sensors were very hard to calibrate. The values in the sketch need to be modified for the local unit, but we don't provide a way to do that without modifying this sketch.
  - humidity: The relative humidity as determined by the [DHT22](https://www.adafruit.com/product/385) or [AM2302](https://www.adafruit.com/product/393) temperature and humidity sensor (the latter contains the former). Note that relative humidity varies by temperature, with warmer air able to hold more moisture without becoming saturated (i.e. without it starting to condense on surfaces or to rain).
  - temp_00: The temperature (Celcius) as determined by the DHT22 or AM2302 sensor.
  - temperature: The value is an array of up to 3 temperatures (Celcius), one from each of the first three DS18B20 temperature sensors located when the sketch started. The entries in the array are in order [according to the serial number of the devices](https://github.com/panoptes/POCS/blob/develop/resources/arduino_files/shared/dallas_temperature_handler.h#L30), thus the values will be in the same order each time the sketch runs, assuming that there not more than 3 devices and that the devices aren't replaced.
- The input handling code currently used in the camera board sketch is very simple:
  - there is no validation of inputs, so a single spurious byte of input can cause it to flip a relay.
  - the relays are identified by pin number, so you have to know which is which.
- The telemetry board input handler is more elaborate, able to accept names as well as pin numbers, and able to reject invalid input.
- We occasionally have a corrupt input (a very large integer) that MongoDb rejects. _I'm not certain yet whether the problem is with the output from the Arduino or the reading of that input by SerialData and pySerial._

And some opinions:

- The report cadence (one or two seconds between reports) is probably too fast. The values we are monitoring don't change that rapidly.
- We have recorded a lot of reports, but haven't done much with them besides attach the current values to the FITS headers (a good use).
- We've had some difference of opinion regarding how complex or simple the Arduino code should be. I'm a C++ programmer, so when I went to overhaul some of the code, I added classes and abstractions, but that can be intimidating to new comers, and we want students that are comfortable with the classic Blink sketch to also have a hope of understanding our sketches.
- I wrote the more complex code because peas_shell wasn't successfully reading all of the reports. I think this was probably because the SerialData class wasn't very good at the time, but I've since addressed the problems that caused it to get confused by the input... at least mostly.

wtgee, 2018-09-22:
Thanks for putting this together. Quick comment, more later:

As mentioned in another Issue, I think we should be coming up with a standard JSON output scheme for hardware devices in general rather than anything specific to the arduinos or the sketches. In the simple case this is because, for instance, PAN008 uses a Raspberry Pi instead of an arduino in the camera box. In the bigger case, I think we ultimately want all devices (mount, camears, etc) to essentially be emitting their status output (probably via zmq) and they should all have a similar setup.

Closed 2020-11-14.

Thread 331 (2018-01-13):

Move arduino verifcation above other tests in travis

wtgee, 2018-01-13:
Failing travis tests should come last in the file. Currently there is a lot of successful output from the arduino verification, which can be a bit confusing.

jamessynge, 2018-01-15:
I'll do the move because I think it is helpful, but of course we have no idea which operation will fail.

wtgee, 2018-01-15:
> I'll do the move because I think it is helpful, but of course we have no idea which operation will fail.

You mean a travis test vs an arduino test? Agree we don't know which will fail but I think we will be altering the travis tests more than arduino (in the long run). Thanks for moving.

The other option would be to wrap the verification in a subprocess and run it is a travis test but I think that's a bit overkill where this works fine.

Closed 2018-01-15.

Thread 335 (2018-01-14):

Cleanup camera methods

wtgee, 2018-01-14:
Currently the `take_observation`, `take_exposure`, and `process_exposre` methods in the base camera class are not implemented, leading to a lot of duplication in `canon_gphoto2` and `sbig` (and probably the coming FLI). This needs to be cleaned up so the base class is handling the basic mechanics.

@AnthonyHorton not sure if you are to this point with the FLI class but just wanted to make you aware.

AnthonyHorton, 2018-01-14:
I have been reducing some of the duplication of code between `sbig` & `canon_gphoto2`, and avoiding adding to it with `fli`, but I've been doing it by adding utility functions as methods of the base class rather than by adding base class implementations of `take_observation`, `take_exposure` and `process exposure`. Was going to open a PR for my branch soon (the FLI camera support is mostly done, but not fully tested and not as robust as it should be, yet).  Perhaps I should do it now to facilitate discussion on these sorts of issues?

wtgee, 2018-01-14:
That sounds fine too. Open up the PR when you are ready. Some things have changed in there (stupid EQUINOX problems again) so you might need to do some merging from `upstream/develop` (note we are not doing `rebase` for the most part but merging - following the [Feature Development Process](https://github.com/panoptes/POCS/wiki/Feature-Development-Process) has worked pretty well to avoid all our problem scenarios from earlier).

wtgee, 2018-02-13:
This was mostly taken care of in #363. Additional items should have their own Issue.

Closed 2018-02-13.

Thread 339 (2018-01-14):

Add a utility program for listing info about hardware

jamessynge, 2018-01-14:
List camera, Arduinos, mount, dome. Print status, port, serial numbers, etc., as appropriate.

jamessynge, 2018-01-14:
Wilfred suggested:

FWIW, and regarding comment (#320) above about separate utils for discovering devices, I have mostly been avoiding making the module callable via `if __main__` _unless_ they are in the utils folder. However, that would make development a little annoying as you would have to run a util file to test the sensors file.  Still, could end up looking something like:
```
python pocs/utils/devices.py --list_arduinos
python pocs/utils/devices.py --list_cameras
python pocs/utils/devices.py --list_attached_hardware
```
etc.

wtgee, 2020-02-16:
Could also be a part of https://github.com/panoptes/panoptes-tutorials/issues/48

Closed 2020-11-14.

Thread 340 (2018-01-14):

Decide on correcting separation after pointing

wtgee, 2018-01-14:
In the pointing class we have a bunch of commented out code that used to be used to sync the mount after each pointing. ioptron manual says not to do this so it's been commented out. Need to capture the functionality elsewhere and remove commented out code.

wtgee, 2018-01-15:
Code removed in #356

wtgee, 2018-10-16:
Closed by #580

Closed 2018-10-16.

Thread 341 (2018-01-15):

Add utility for aligning of cameras

jamessynge, 2018-01-15:
It is clear that the PAN006 cameras aren't pointed in quite the same direction, nor are they aimed parallel to the RA axis when the mount is aimed at the pole (i.e. after polar alignment). It would be helpful to have some UI that gives a measure of how far left or right to rotate each camera.

(This and a mention by Wilfred that he wasn't sure which camera was controlled by each Arduino pin, makes me think we should have a canonical position for each camera, e.g. left for Cam00 and right for Cam01.)

wtgee, 2018-01-15:
Just a note that it's not critical that they do point exactly the same although the utility would be nice anyway. However, accessing the cameras isn't very easy so we would definitely want to do this before final setup.

A name for each position is a good idea.

wtgee, 2020-02-16:
Could also be a part of https://github.com/panoptes/panoptes-tutorials/issues/48

Thread 342 (2018-01-15):

Make the observation exposure list more useful.

wtgee, 2018-01-15:
Ideally we want an easy list of each exposure from each camera. We want the `first_exposure` and `last_exposure` to return (by deafult) the info for the primary camera as it is used for tracking purposes.

Exposure list will be useful during cleanup to help upload.

Document usage.

wtgee, 2018-10-16:
This is basically done. If anything further is identified a new Issue should be opened.

Closed 2018-10-16.

Thread 343 (2018-01-15):

Document how to upload to Arduinos from Linux

jamessynge, 2018-01-15:
User needs permission to use device (e.g. /dev/ttyACM0).
May need to remove modem manager: `sudo apt-get purge modemmanager`
There is advice on arduino.cc regarding using Linux for Arduino development, and we should provide pointers to that.

kmeagle1515, 2019-03-21:
hello sir!
Where will the documentation be included, in **README** or you want it in a different folder?

kmeagle1515, 2019-03-25:
I have made a pr please review it.

AnthonyHorton, 2019-03-26:
@kmeagle1515 For future reference, you should link related Issues and Pull Requests. Just use the Issue/PR number in the description or a comment and GitHub will automatically convert it to a link, e.g. the PR you're referring to here is #802.  Note, this *doesn't* work if you only do it in the title (as in your PR).

wtgee, 2019-03-26:
> @kmeagle1515 For future reference, you should link related Issues and Pull Requests. Just use the Issue/PR number in the description or a comment and GitHub will automatically convert it to a link, e.g. the PR you're referring to here is #802. Note, this _doesn't_ work if you only do it in the title (as in your PR).

And we actually just added PR templates as part of #156.

kmeagle1515, 2019-04-18:
@jamessynge  @wtgee this issue has been solved #802 .

Closed 2019-04-19.

Thread 347 (2018-01-15):

PEAS shell: command to clear buffer on arduino

wtgee, 2018-01-15:
If the arduino output gets behind would be nice to be able to manually clear buffer.

jamessynge, 2018-01-15:
I think we have two alternatives, where I prefer the first:

1. Separate the reading and storing of the two Arduinos, so that they don't have to output reports at precisely the same rate. This would of course require a separate thread for each of the Arduinos.
2. Read all available bytes from each arduino, and extract the latest complete line from those bytes, allowing us to skip past any backlog.

wtgee, 2018-01-15:
Yes, I agree that first option is better. This goes along with the splitting of ArduinoSerialMonitor.

But I still think having a command to do it manually could come in handy if ever needed. Are you thinking these alternatives would eliminate that need?

kmeagle1515, 2019-04-02:
pyserial commands like reset_input_buffer( ) and  reset_output_buffer( ) may come in handy.
Maybe there is a need for a new function like clear_buffer ( ) under which these commands will be executed because peas_shell doesn't have one.

Also i have noticed a line
https://github.com/panoptes/POCS/blob/4ef6e70e0484156c67b5c8178235b2a9987cca58/bin/peas_shell#L210
here flushInput( ) is supported for python versions 2.x the latest commands is reset_input_buffer( )
https://pyserial.readthedocs.io/en/latest/pyserial_api.html#serial.Serial.reset_input_buffer

wtgee, 2022-01-15:
Stale.

Closed 2022-01-15.

Thread 348 (2018-01-15):

Fix "Waiting for images" timer

wtgee, 2018-01-15:
It outputs debug every 15 seconds but it's not in sync very well. For a 120 second image the output usually stops at about 75 sec.

wtgee, 2018-01-15:
Output from session:

```
D0115 08:22:33.910 observatory.py:235   Exposing for camera: Cam00
D0115 08:22:33.910 canon_gphoto2.py:121 image_id: PAN001_14d3bd_20180115T082233
D0115 08:22:33.910 canon_gphoto2.py:174 Taking 120.0 second exposure on Cam00: /var/panoptes/images/fields/Wasp36/14d3bd/20180115T081653//20180115T082233.cr2
D0115 08:22:33.918 observatory.py:235   Exposing for camera: Cam01
D0115 08:22:33.920 canon_gphoto2.py:121 image_id: PAN001_ee04d1_20180115T082233
D0115 08:22:33.920 canon_gphoto2.py:174 Taking 120.0 second exposure on Cam01: /var/panoptes/images/fields/Wasp36/ee04d1/20180115T081653//20180115T082233.cr2
D0115 08:22:33.931 observing.py:25      Waiting for images: 0.0 seconds
D0115 08:22:56.364 observing.py:25      Waiting for images: 15.0 seconds
D0115 08:23:18.770 observing.py:25      Waiting for images: 30.0 seconds
D0115 08:23:41.223 observing.py:25      Waiting for images: 45.0 seconds
D0115 08:24:03.676 observing.py:25      Waiting for images: 60.0 seconds
D0115 08:24:26.098 observing.py:25      Waiting for images: 75.0 seconds
D0115 08:24:39.919 canon_gphoto2.py:218 Processing PAN001_14d3bd_20180115T082233
D0115 08:24:39.919 canon_gphoto2.py:221 Extracting pretty image
D0115 08:24:39.928 canon_gphoto2.py:226 Converting CR2 -> FITS: /var/panoptes/images/fields/Wasp36/14d3bd/20180115T081653//20180115T082233.cr2
D0115 08:24:39.933 canon_gphoto2.py:218 Processing PAN001_ee04d1_20180115T082233

```

jamessynge, 2018-01-16:
Not sure if relevant, but #357 is related to timeouts.

wtgee, 2018-01-16:
> Not sure if relevant, but #357 is related to timeouts.

We have the process with the stdout, so I think in this case we should actually just grab the output timer from gphoto2 directly so it reflects what the camera is doing.

wtgee, 2018-08-27:
Closed by #559

Closed 2018-08-27.

Thread 349 (2018-01-15):

Evaluate tracking guide rate

wtgee, 2018-01-15:
Guide rates are often set at 0.5x sidereal rate because that ensures that the mount won't move fast while you are exposing. However, we only ever adjust via guiding between exposures so it seems like we shouldn't need to worry about this and instead could guide at 0.9x (the maximum IIRC).

Not uncommonly seeing differences of ~20-30 arcseconds, which can be 2-3 seconds of adjusting at 0.5x rate. Looking to get this lower.

@joshwalawender any practical reason we shouldn't adjust guiding at the maximum allowable?

wtgee, 2018-08-27:
This was done in #542

Closed 2018-08-27.

Thread 350 (2018-01-15):

Determine if mount guiding corrections are none-blocking

wtgee, 2018-01-15:
When we correct the tracking we do a `move_ms` command in a specified direction (east or west for RA and north or south for Dec) but we issue the Dec command first and then immediately move to the RA then start the waiting timer.

During observations on PAN001 it seemed like an error in Dec wasn't getting corrected so it steadily drifted further off. Changing the timer to wait for the Dec before issuing RA commands seemed to help.

Need to determine (in the lab) if you can move both axis simultaneously.

Thread 354 (2018-01-15):

Add tests of sensors.py.

jamessynge, 2018-01-15:
This will make use of the new arduino serial simulator.

wtgee, 2022-01-20:
Closing as stale. The sensors and environment have changed a bit, so new Issues with more detail should be opened.

Closed 2022-01-20.

Thread 364 (2018-01-16):

Get horizon/obstructions from image

wtgee, 2018-01-16:
@brendan-o had done some work to automatically find the horizon images from a picture, it would be nice to get that back in.

wtgee, 2020-02-16:
This is labelled as a good first issue but is not necessarily simple.

The basic idea would be to take an image that has a visible obstruction in it and figure out what the altitude and azimuth of that location is given the WCS (or other mount information).

Example obstruction (the Iron Giant!)

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

Closed 2025-06-05.

Thread 365 (2018-01-16):

Test horizon constraints for entire time duration

wtgee, 2018-01-16:
It's not clear from basic example if horizon is only checked for initial time slot or for the duration the target is above horizon.

jermainegug, 2018-01-23:
Anything that we could add to the example to check this?

wtgee, 2018-01-23:
I wouldn't quite start on this yet as I need to do some checking on the other constraints to make sure it is even working consistently. We are having problems with the `Duration` constraint not properly accounting for the meridian (#361) and I think it is somewhat related.

Thread 366 (2018-01-16):

Potentially integrate Altitude constraint with Duration constraint.

wtgee, 2018-01-16:
Could possibly just combine the two.

Related to #365

wtgee, 2018-12-08:
When there are a large number of targets the Altitude constraint acts as a good first filter on the targets, thereby reducing the processing that has to be done during the Duration constraint. Probably only really relevant on the Raspberry Pi where the scheduling can be slow. Nevertheless, closing this Issue as stale and unnecessary for now.

Closed 2018-12-08.

Thread 373 (2018-01-16):

Add states for calibration frames

wtgee, 2018-01-16:
It would be nice to have flat fields. We are currently shutting down PAN001 about 45 minutes before sunrise because there are no "valid" targets left (no 2 hour observations). Could prepare for morning flats and/or aim at ground and take some (very quick) dark frames.

wtgee, 2020-02-17:
Related to downstream https://github.com/AstroHuntsman/huntsman-pocs/pull/130

Thread 381 (2018-01-17):

pocs_shell shutdown POCS when asked to go_home

jamessynge, 2018-01-17:
I executed setup_pocs, unpark and go_home commands, the latter of which detected that the weather was not safe, and so shutdown POCS. That seems like an excessive reaction, and that it should actually park in that condition, but leave pocs setup.

Weather conditions at PAN006 were cloudy, but PAN006 is in closed a dome, so it was actually safe. It might be nice to add an option for domed installations to consider the weather safe if the dome is closed... it needs to be an option because some enclosures might not have room for the mount to leave the parked position without colliding with the enclosure (think low roll-off roof).

wtgee, 2018-10-16:
Closing as stale.

Closed 2018-10-16.

Thread 392 (2018-01-19):

Mark horizon from current image

wtgee, 2018-01-19:
One feature that might be nice with the Horizon constraint is to somehow just push a button in PAWS when the cameras are currently viewing an obstruction and it would stop viewing that target and write out the current alt/az to the config list.

jermainegug, 2018-01-23:
Might need some sort of interactive image interface in PAWS where you select two points and it can write those coordinates as a list. But I think that might be too much effort to make opposed to just entering the coordinates in the config manually or even just making a tab in PAWS **Input New Obstruction Coordinates**, where you enter alt/az for two points and it writes that in the config list.

I don't think writing the current alt/az to the config list would be useful, since the `Horizon` class needs two points and I can't see how it would work for only one.

wtgee, 2018-01-23:
An interactive feature is definitely overkill for now. The one nice feature would be to mark the current image from PAWS (#392) but that does have the problem of only having one point.

jermainegug, 2018-01-23:
Definitely, especially once we have the code working to get Horizon obstructions from the images.

Maybe make a new log file, say `obstructions.log` and we just have a button that will write `obstruction was found in <image>` in the log file or we could have the FITS header have `OBSTRUCTION=False` and then pressing the button would just make it `True`?

jermainegug, 2018-01-23:
Can just start this off with marking the image so that we know it has an obstruction in it. Then I guess once the Horizons code is done you could possibly just have a function that says marked images are to be parsed through `get_obstruction_from_image` (#364).

wtgee, 2020-02-17:
Closing as duplicate of #364

Closed 2020-02-17.

Thread 395 (2018-01-19):

UserWarning: Problem creating timelapse

jamessynge, 2018-01-19:
Error from PAN006, which I'm guessing indicates that some software is required that POCS doesn't have in its requirements.

```
 6510
Starting POCS - Press Ctrl-c to interrupt
/var/panoptes/POCS/pocs/utils/images/__init__.py:206: UserWarning: Problem creating timelapse: /var/panoptes/images/timelapse/Wasp35_6575fc_20180118T232417.mp4
  warn("Problem creating timelapse: {}".format(fn_out))
/var/panoptes/POCS/pocs/utils/images/__init__.py:206: UserWarning: Problem creating timelapse: /var/panoptes/images/timelapse/Wasp35_7bab97_20180118T232417.mp4
  warn("Problem creating timelapse: {}".format(fn_out))
/var/panoptes/POCS/pocs/utils/images/__init__.py:206: UserWarning: Problem creating timelapse: /var/panoptes/images/timelapse/HatP30_6575fc_20180119T020703.mp4
  warn("Problem creating timelapse: {}".format(fn_out))
/var/panoptes/POCS/pocs/utils/images/__init__.py:206: UserWarning: Problem creating timelapse: /var/panoptes/images/timelapse/HatP30_7bab97_20180119T020703.mp4
  warn("Problem creating timelapse: {}".format(fn_out))
/var/panoptes/POCS/pocs/utils/images/__init__.py:206: UserWarning: Problem creating timelapse: /var/panoptes/images/timelapse/Wasp104_6575fc_20180119T051913.mp4
  warn("Problem creating timelapse: {}".format(fn_out))
/var/panoptes/POCS/pocs/utils/images/__init__.py:206: UserWarning: Problem creating timelapse: /var/panoptes/images/timelapse/Wasp104_7bab97_20180119T051913.mp4
  warn("Problem creating timelapse: {}".format(fn_out))
/var/panoptes/POCS/pocs/utils/images/__init__.py:206: UserWarning: Problem creating timelapse: /var/panoptes/images/timelapse/Wasp104_6575fc_20180119T074529.mp4
  warn("Problem creating timelapse: {}".format(fn_out))
/var/panoptes/POCS/pocs/utils/images/__init__.py:206: UserWarning: Problem creating timelapse: /var/panoptes/images/timelapse/Wasp104_7bab97_20180119T074529.mp4
  warn("Problem creating timelapse: {}".format(fn_out))
```

wtgee, 2018-01-19:
Some of these have started showing up in travis recently too. I'll double check that PAN001 is still working ok

wtgee, 2018-01-19:
Working fine on PAN001.  Python module is `ffmpy`, underlying library is `ffmpeg`.

Do you have `$PANDIR/timelapse` directory with write permissions? Looks like it doesn't create or check for that but assumes.

wtgee, 2018-01-19:
FWIW, we don't actually use the timelapse for much and currently don't upload them to cloud storage. The jpgs are automatically deleted as part of cleanup so I was creating timelapse as I like to look at them in the morning. They are a quick way to see if any meteors or other odd behavior and also nice to show if tracking problems. But mostly just for fun. We should evaluate their use.

jamessynge, 2018-01-19:
I would like to have these available as a way to do a quick review of the nights observations.

I'll check the file system when I get home.

jamessynge, 2018-01-20:
There was no timelapse directory.

Closed 2018-01-20.

Thread 419 (2018-01-26):

Examine shutdown behavior if changing state throws exception.

wtgee, 2018-01-26:
Currently in `run()` we have:

```
             try:
                    state_changed = self.goto_next_state()
                except Exception as e:
                    self.logger.warning("Problem going from {} to {}, exiting loop [{!r}]".format(
                        self.state, self.next_state, e))
                    self.stop_states()
                    break
```

But instead of just stopping the states we should potentially park.

wtgee, 2020-02-17:
Closing as stale.

Closed 2020-02-17.

Thread 420 (2018-01-27):

Disentangle reading from multiple arduinos

jamessynge, 2018-01-27:
ArduinoSerialMonitor supports reading from both the telemetry and camera boards, but effectively requires them to produce output at exactly the same rate else a data loss will occur.

I'm planning to create pocs/sensors/arduino_io.py, based on peas/sensors.py, but the primary class will support a single serial connected device.

jamessynge, 2018-01-27:
Related to #326, we should consider how to find the available relays on each board. One option would be for the json output to tell us. For example:
`... "relays": {"camera": 1, "fan": 0, ...}, ...`
Then we can send to the board a name that it produced:
`camera=0\n`

jamessynge, 2018-02-06:
I've created ArduinoIO and SensorRecorder (PR #428), designed for working in a multithreaded Python app. However, I've just learned that debugging such an app isn't possible using Python's native debugger, pdb. While I could debug it using log messages, my inclination is to instead head in a direction that Wilfred mentioned: use separate processes for each Arduino. Specifically:

- Each process works with a specific device (e.g. `/dev/ttyACM1`).
- PanDB is used to save each reading into a history collection and a current collection, named with the name of the board.
- PanMessaging is used for two purposes:
  - Sending readings to the rest of the system on channel environment.
  - Receiving relay change commands (format to be determined, though probably using a channel name that includes the name of the board).
- The process stops if the device stops working; this allows a supervising process to re-do auto-detection periodically and find the board attached to a new device. While it would be useful for a message to be sent indicating that there is an issue, zeromq doesn't guarantee delivery, so we might want to rely on other means for detecting that the connection has been lost.

wtgee, 2018-02-07:
Think this sounds like a good move and would also be easy to implement for the Pi.

jamessynge, 2018-02-11:
PR coming in a few minutes. The ArduinoIO object listens for commands to channel `<board>:commands` (e.g. `telemetry_board:commands`), with the following incoming messages:

`{"command": "shutdown"}` - Stops the main loop.

`{"command": "write_line", "line": "some line of text"}` - Sends the line of text to the Arduino (serial port)

I plan to extend this (once we agree on the protocol) to support changing relays by name (already supported by the telemetry board sketch). That makes it easier to replace the Arduino with a Raspberry Pi or other maker board. That might mean that we should change the name from ArduinoIO to SerialSensorIO, etc.

wtgee, 2018-02-13:
Linking #125

jamessynge, 2018-09-15:
Resuming work on this, with this plan:

- [ ] Add DelaySigTerm, a context manager for preventing SIGTERM from interrupting a critical section. If SIGTERM is caught, it is re-sent after the critical section.
- [ ] Use DelaySigTerm in ArduinoIO so that the state isn't corrupted by SIGTERM, which is used to stop a process running ArduinoIO.
- [ ] Update arduino_recorder.py script (runs ArduinoIO locally) to support finding messaging ports from config file.
- [ ] Add SensorManager, a process for managing subprocesses running arduino_recorder.py, one for each configured Arduino board.
- [ ] Integrate SensorManager into the running of pocs_shell and/or peas_shell. This item will need work to clarify. Ideally, we'd introduce something inspired by supervisord.

wtgee, 2020-02-17:
Mostly closed by #880. Could use some cleanup, but closing this issue as stale.

Closed 2020-02-17.

Thread 427 (2018-01-29):

peas_shell log size

wtgee, 2018-01-29:
peas_shell is generating 3 log messages per second. After one week of operation the log file size was 250 MB. I have weekly rotation set up but we need to document and/or implement some log cleanup.

jamessynge, 2018-01-29:
I suspect we can address this by disabling DEBUG logging of peas_shell on most units and/or by NOT logging all the arduino activity.

wtgee, 2019-06-30:
The `toggle_debug` function has been working well for me although it still outputs a lot of text by default so we should perhaps let people know about the option. Will try to resolve this as part of the cleanup work lately.

wtgee, 2020-06-14:
Fixed by #951 and friend.

Closed 2020-06-14.

Thread 435 (2018-02-03):

Enable pytest to run in parallel

jamessynge, 2018-02-03:
The pytest-xdist plugin supports running tests in multiple processes, but it appears that our own logging code causes those tests to fail. I had much better luck adding --boxed to the command line below, but sometimes still see failures like those below.

```python
$ pytest -n=auto --timeout=90
======================================================================= test session starts =======================================================================
platform linux -- Python 3.6.3, pytest-3.2.5, py-1.5.2, pluggy-0.4.0
rootdir: /home/james/git/panoptes/POCS, inifile:
plugins: xdist-1.20.1, timeout-1.2.1, forked-0.2, cov-2.5.1
timeout: 90.0s method: signal
gw0 [371] / gw1 [371] / gw2 [369] / gw3 [369] / gw4 [369] / gw5 [371] / gw6 [369] / gw7 [371]                                                              
scheduling tests via LoadScheduling
collecting 0 items / 8 errors                                                                                                                              
============================================================================= ERRORS ==============================================================================
___________________________________________________________ ERROR collecting peas/tests/test_boards.py ____________________________________________________________
peas/tests/test_boards.py:3: in <module>
    from peas.sensors import ArduinoSerialMonitor
peas/sensors.py:14: in <module>
    from pocs.utils.messaging import PanMessaging
pocs/utils/messaging.py:16: in <module>
    class PanMessaging(object):
pocs/utils/messaging.py:22: in PanMessaging
    logger = get_root_logger()
pocs/utils/logger.py:108: in get_root_logger
    os.symlink(log_symlink_target, log_symlink)
E   FileExistsError: [Errno 17] File exists: 'per-run/-c/-c-20180203T203136Z-24427-warn.log' -> '/var/panoptes/logs/-c-warn.log'
___________________________________________________________ ERROR collecting peas/tests/test_boards.py ____________________________________________________________
peas/tests/test_boards.py:3: in <module>
    from peas.sensors import ArduinoSerialMonitor
peas/sensors.py:14: in <module>
    from pocs.utils.messaging import PanMessaging
pocs/utils/messaging.py:16: in <module>
    class PanMessaging(object):
pocs/utils/messaging.py:22: in PanMessaging
    logger = get_root_logger()
pocs/utils/logger.py:108: in get_root_logger
    os.symlink(log_symlink_target, log_symlink)
E   FileExistsError: [Errno 17] File exists: 'per-run/-c/-c-20180203T203136Z-24423-all.log' -> '/var/panoptes/logs/-c-all.log'
___________________________________________________________ ERROR collecting peas/tests/test_boards.py ____________________________________________________________
peas/tests/test_boards.py:3: in <module>
    from peas.sensors import ArduinoSerialMonitor
peas/sensors.py:14: in <module>
    from pocs.utils.messaging import PanMessaging
pocs/utils/messaging.py:16: in <module>
    class PanMessaging(object):
pocs/utils/messaging.py:22: in PanMessaging
    logger = get_root_logger()
pocs/utils/logger.py:108: in get_root_logger
    os.symlink(log_symlink_target, log_symlink)
E   FileExistsError: [Errno 17] File exists: 'per-run/-c/-c-20180203T203136Z-24435-all.log' -> '/var/panoptes/logs/-c-all.log'
___________________________________________________________ ERROR collecting peas/tests/test_boards.py ____________________________________________________________
peas/tests/test_boards.py:3: in <module>
    from peas.sensors import ArduinoSerialMonitor
peas/sensors.py:14: in <module>
    from pocs.utils.messaging import PanMessaging
pocs/utils/messaging.py:16: in <module>
    class PanMessaging(object):
pocs/utils/messaging.py:22: in PanMessaging
    logger = get_root_logger()
pocs/utils/logger.py:108: in get_root_logger
    os.symlink(log_symlink_target, log_symlink)
E   FileExistsError: [Errno 17] File exists: 'per-run/-c/-c-20180203T203136Z-24419-all.log' -> '/var/panoptes/logs/-c-all.log'
______________________________________________________________________ ERROR collecting gw0 _______________________________________________________________________
Different tests were collected between gw2 and gw0. The difference is:
--- gw2

+++ gw0

@@ -1,3 +1,5 @@

+peas/tests/test_boards.py::test_create
+peas/tests/test_boards.py::test_has_readers
 peas/tests/test_sensors.py::test_create_camera_simulator
 peas/tests/test_sensors.py::test_create_default_simulator
 peas/tests/test_sensors.py::test_detect_board_on_port_not_a_board
______________________________________________________________________ ERROR collecting gw1 _______________________________________________________________________
Different tests were collected between gw2 and gw1. The difference is:
--- gw2

+++ gw1

@@ -1,3 +1,5 @@

+peas/tests/test_boards.py::test_create
+peas/tests/test_boards.py::test_has_readers
 peas/tests/test_sensors.py::test_create_camera_simulator
 peas/tests/test_sensors.py::test_create_default_simulator
 peas/tests/test_sensors.py::test_detect_board_on_port_not_a_board
______________________________________________________________________ ERROR collecting gw7 _______________________________________________________________________
Different tests were collected between gw2 and gw7. The difference is:
--- gw2

+++ gw7

@@ -1,3 +1,5 @@

+peas/tests/test_boards.py::test_create
+peas/tests/test_boards.py::test_has_readers
 peas/tests/test_sensors.py::test_create_camera_simulator
 peas/tests/test_sensors.py::test_create_default_simulator
 peas/tests/test_sensors.py::test_detect_board_on_port_not_a_board
______________________________________________________________________ ERROR collecting gw5 _______________________________________________________________________
Different tests were collected between gw2 and gw5. The difference is:
--- gw2

+++ gw5

@@ -1,3 +1,5 @@

+peas/tests/test_boards.py::test_create
+peas/tests/test_boards.py::test_has_readers
 peas/tests/test_sensors.py::test_create_camera_simulator
 peas/tests/test_sensors.py::test_create_default_simulator
 peas/tests/test_sensors.py::test_detect_board_on_port_not_a_board
===================================================================== 8 error in 6.71 seconds =====================================================================
```

wtgee, 2018-02-04:
If it's just symlinking the logs maybe we can catch and ignore that? Would be nice to see this used somehow.

wtgee, 2020-02-17:
Related to #520 and #191

Thread 437 (2018-02-04):

Tests can break running pocs_shell on a unit

jamessynge, 2018-02-04:
I ran tests on PAN006 this afternoon and later noticed in the log file that POCS had stopped, apparently because of a shutdown message sent by a test (i.e. it appears that the tests and the "real" code use the same ports).

```
D0203 21:02:20.101 core.py:337          Dark Check: False
D0203 21:02:20.102 core.py:373          Weather Safety: True [15 sec old - 2018-02-03 21:02:05.250000]
D0203 21:07:25.113 observatory.py:82    Sun 8.31 deg > -18.0 deg
D0203 21:07:25.113 core.py:337          Dark Check: False
D0203 21:07:25.114 core.py:373          Weather Safety: True [71 sec old - 2018-02-03 21:06:14.119000]
D0203 21:12:30.116 observatory.py:82    Sun 7.49 deg > -18.0 deg
D0203 21:12:30.116 core.py:337          Dark Check: False
D0203 21:12:30.117 core.py:373          Weather Safety: True [44 sec old - 2018-02-03 21:11:45.968000]
D0203 21:17:35.097 observatory.py:82    Sun 6.67 deg > -18.0 deg
D0203 21:17:35.097 core.py:337          Dark Check: False
D0203 21:17:35.098 core.py:373          Weather Safety: True [17 sec old - 2018-02-03 21:17:17.807000]
D0203 21:22:40.154 observatory.py:82    Sun 5.84 deg > -18.0 deg
D0203 21:22:40.155 core.py:337          Dark Check: False
D0203 21:22:40.156 core.py:373          Weather Safety: True [73 sec old - 2018-02-03 21:21:26.700000]
I0203 21:27:04.917 core.py:493          Message received: command shutdown
W0203 21:27:04.917 core.py:510          Shutdown command received
I0203 21:27:04.919 messaging.py:122     PANCHAT I'm powering down
I0203 21:27:04.919 core.py:226          Shutting down POCS State Machine: , please be patient and allow for exit.
D0203 21:27:04.919 abstract_serial_dome.py:70 Already connected to dome
D0203 21:27:06.017 astrohaven.py:183    Got target_feedback, feedback_countdown=1
D0203 21:27:06.426 astrohaven.py:183    Got target_feedback, feedback_countdown=0
D0203 21:27:08.339 astrohaven.py:183    Got target_feedback, feedback_countdown=1
D0203 21:27:08.748 astrohaven.py:183    Got target_feedback, feedback_countdown=0
D0203 21:27:11.647 observatory.py:125   Shutting down observatory
D0203 21:27:11.647 serial.py:64         Closing serial port for mount
D0203 21:27:11.648 rs232.py:151         SerialData.disconnect called for /dev/ttyUSB0
D0203 21:27:11.648 abstract_serial_dome.py:75 Closing serial port for dome
D0203 21:27:11.648 rs232.py:151         SerialData.disconnect called for /dev/ttyUSB2
D0203 21:27:11.648 core.py:254          Shutting down messaging system
D0203 21:27:11.648 core.py:258          Terminating check_messages - PID 22606
D0203 21:27:11.652 core.py:258          Terminating cmd_forwarder - PID 22594
I0203 21:27:11.671 core.py:264          Power down complete
D0203 21:27:11.672 mount.py:116         Problem getting mount status:
W0203 21:27:11.673 observatory.py:171   Can't get observatory status:
I0203 21:27:11.674 core.py:493          Message received: command shutdown
W0203 21:27:11.675 core.py:510          Shutdown command received
D0203 21:27:11.676 mount.py:116         Problem getting mount status:
W0203 21:27:11.676 observatory.py:171   Can't get observatory status:
D0203 21:27:11.678 mount.py:116         Problem getting mount status:
W0203 21:27:11.678 observatory.py:171   Can't get observatory status:
D0203 21:27:11.683 mount.py:116         Problem getting mount status:
W0203 21:27:11.683 observatory.py:171   Can't get observatory status:
D0203 21:27:11.685 mount.py:116         Problem getting mount status:
W0203 21:27:11.686 observatory.py:171   Can't get observatory status:
D0203 21:27:11.693 mount.py:116         Problem getting mount status:
W0203 21:27:11.693 observatory.py:171   Can't get observatory status:
```

wtgee, 2018-02-04:
Yikes. Makes perfect sense but obviously shouldn't be that way. This and #131 are some arguments for getting that messaging cleaned up sooner than later.

wtgee, 2018-02-19:
Closed as part of #440

Closed 2018-02-19.

Thread 443 (2018-02-05):

get_current db issue

wtgee, 2018-02-05:
Since #414 was merged there is a frequent problem that when the weather record is being updated it is no longer available in the collection, causing weather safety to fail and parking the unit. It seems like the `insert_current` is taking a non-negligible amount of time to update.

However, on PAN001 I am getting a failure after during the weather check after every move past the pointing state although the checks before that work fine, so it doesn't seem to necessarily be a timing issue.

Will do more debugging.

Closed 2018-02-09.

Thread 450 (2018-02-06):

catch camera timeout

lspitler, 2018-02-06:
For SBIGs it seems to happen on readout.

wtgee, 2018-02-08:
In general we perhaps need something in the `camera.process_exposure()` method that times out events after a while (probably set up in the `take_exposure` methods).

Note that for Huntsman specifically we have an omission in the `observing` state where we are incrementing the timer but never acting on it. See huntsman observing [here](https://github.com/AstroHuntsman/huntsman-pocs/blob/develop/states/huntsman/observing.py#L23) compared to the breakout in the panoptes observing [here](https://github.com/panoptes/POCS/blob/develop/pocs/state/states/default/observing.py#L28).

wtgee, 2018-02-08:
Also just a note that we should obviously fix the Huntsman observing state but we experience them most often in the autofocus routines.

AnthonyHorton, 2018-02-08:
Some attempts to handle timeouts more gracefully in https://github.com/panoptes/POCS/pull/458

AnthonyHorton, 2018-02-12:
Could use some fresh eyes on this.  Based on the logs it looks like execution is getting stuck in this section of code in `pocs/camera/sbigudrv.py`:

```
        # Readout data
        with self._command_lock:
            self._set_handle(handle)
            self._send_command('CC_END_EXPOSURE', params=end_exposure_params)
            self._send_command('CC_START_READOUT', params=start_readout_params)
            for i in range(height):
                try:
                    self._send_command('CC_READOUT_LINE',
                                       params=readout_line_params,
                                       results=as_ctypes(image_data[i]))
                except RuntimeError as err:
                    message = 'Readout error on {}: expected {} rows, got{}!'.format(self._ccd_info[handle]['serial number'],
                                                                                     height,
                                                                                     i)
                    self.logger.error(message)
                    self.logger.error(err)
                    warn(message)
                    break

            try:
                self._send_command('CC_END_READOUT', params=end_readout_params)
            except RuntimeError as err:
                message = "Error ending readout on {}: {}".format(self._ccd_info[handle]['serial number'],
                                                                  err)
                self.logger.error(message)
            else:
                self.logger.debug('Readout on {} complete'.format(self._ccd_info[handle]['serial number']))
            finally:
                fits_utils.write_fits(image_data, header, filename, self.logger, exposure_event)
```

The driver reports a `CE_RX_TIMEOUT` error from one of the `CC_READOUT_LINE` commands, which causes my code to raise `RuntimeError`, which is caught by the `except` clause, which writes the error details to the log.  That much works.

Execution should then `break` out of the enclosing `for` loop, and `try` to send the `CC_END_READOUT` command.  A message about whether that succeeds or not should then be written to the log, and either way `fits_utils.write_fits()` is called to write the (partial) image to file and, more importantly, set the `exposure_event` which allows execution of the main thread to continue.  This doesn't work.  Neither of the messages about success/failure of the `CC_END_READOUT` command are making it into the log, and the `exposure_event` isn't getting set, but I can't understand how that could be.

Any thoughts, @wtgee? Or anyone else?

wtgee, 2018-02-12:
Will you post the last log message with number of rows. As I recall it was right at the very end, right?

wtgee, 2018-02-12:
We should be able to test this remotely even if not on sky, correct?

AnthonyHorton, 2018-02-12:
Yes. Can just run autofocus a bunch of times. Doesn't matter if the cameras can't see any stars when testing this.

wtgee, 2018-04-03:
@AnthonyHorton will this be mitigated by using a RaspPi? Do we need to worry about the Issue otherwise?

AnthonyHorton, 2018-04-09:
@wtgee The confusion discussed in my comment above from 12th February is still bugging me but, from a purely practical perspective, this is probably all moot now.

The evidence that we have continues to support the theory that the root cause of the SBIG camera timeout issues was simply USB issues (again!), caused by running multiple cameras on one computer. Running the cameras with a RaspPi each will probably avoid the problem.

It would still be good to make the camera stuff more robust with respect to errors in general, but if the RaspPi solution make the problem go away for now then it's no longer a pressing issue.

wtgee, 2018-10-16:
Not really solved but non longer relevant. Closing.

Closed 2018-10-16.

Thread 452 (2018-02-07):

peas_shell exceptions

wtgee, 2018-02-07:
I'm seeing this every second on peas_shell, not sure cause. Will look into and report:

```
W0207 03:24:38.687 sensors.py:119       Exception while reading from sensor camera_board: read failed: device reports readiness to read but returned no data (device disconnected or multiple access on port?)
D0207 03:24:38.687 sensors.py:106       ArduinoSerialMonitor.capture reading sensor telemetry_board
D0207 03:24:39.686 sensors.py:112       Got sensor_value from telemetry_board
D0207 03:24:40.691 sensors.py:106       ArduinoSerialMonitor.capture reading sensor camera_board
W0207 03:24:40.691 sensors.py:119       Exception while reading from sensor camera_board: read failed: device reports readiness to read but returned no data (device disconnected or multiple access on port?)
D0207 03:24:40.692 sensors.py:106       ArduinoSerialMonitor.capture reading sensor telemetry_board
D0207 03:24:41.687 sensors.py:112       Got sensor_value from telemetry_board
D0207 03:24:42.691 sensors.py:106       ArduinoSerialMonitor.capture reading sensor camera_board

```

wtgee, 2018-02-07:
I've actually lost access to the arduino device in the camera box. The cameras are still appearing but the arduino is uncommunicative even after power cycling and computer reboot. Not sure what the problem is but feel like I have seen it before.

The error appeared in the log, but perhaps the fix would be to have peas_shell somehow communicate that it has lost contact with one of the devices.

jamessynge, 2018-02-10:
Have you been able to resurrect the camera board arduino? If not, can you see it if you run [lsusb]?

wtgee, 2018-02-10:
Lost all access to PAN001 in a storm a few days ago. No one has been able to go up and reset it yet.

jamessynge, 2018-02-12:
FWIW, I've tested the new Arduino IO code when a disconnect occurs. It will disconnect (close) the serial device, then try to reopen. If it is able, and it is the same device, it will keep running. Otherwise, it will die (intentional). My plan is that possible peas_shell will handle this be redoing the auto-detect, finding any attached boards that are not already opened by an Arduino IO.

wtgee, 2018-08-27:
@jamessynge can we close this issue?

wtgee, 2019-06-30:
Closing as stale.

Closed 2019-06-30.

Thread 470 (2018-02-11):

Get location of PanFileDB storage from config

jamessynge, 2018-02-11:
Currently we store file dbs in $PANDIR/json_store/<dbname>. We **may** want to provide the ability to specify the location.

wtgee, 2018-02-13:
I tend toward providing it simply because flexibility is often a Good Thing. Reasons to not allow changing it?

Thread 478 (2018-02-13):

Camera simulator

wtgee, 2018-02-13:
Currently the camera simulator generates some random data but then changes the filename so that the `solved.fits` is used during processing. This is having some strange side-effects in various places. Additionally, trying to just `run` pocs with the simulators leads to a solve-field error which means it hangs after the `pointing` state.

I would like to be able to do a normal run with POCS (for instance, with a unit set up) and have it run through a full observation cycle, even showing the fake data in PAWS.

More generally, the simulator code needs to be fixed up a bit and made consistent.

AnthonyHorton, 2018-02-13:
The camera field is only supposed to generate random data if its been asked for a dark frame. Otherwise it should just copy the data from `unsolved.fits`, generate a set of headers for it, & save the result to a FITS file in the normal location.

wtgee, 2018-02-13:
> The camera simulator is only supposed to generate random data if its been asked for a dark frame. Otherwise it should just copy the data from unsolved.fits, generate a set of headers for it, & save the result to a FITS file in the normal location.

Good to know. I was experiencing some (intermittent) issues and @jamessynge reported the same thing, so this is mostly meant as a way to explore that. While I was working on some of the DB abstraction I noticed failures in the logs that were not causing test failures.

This may be a non-issue. I'll look into what I was experiencing.

For the record, here is what James reported:

> I'm debugging tests with my new PanMemoryDB, and in test_pocs.py am down to one failure. If I run that by itself and study the log file, I notice that the camera (simulator) doesn't seem to work right (or at least not reliably.

> So, first, what should happen with "taking" an exposure in that setting?

> And do you have any idea what the cause of the file errors below could be? If they are expected because of the simulator being incomplete, perhaps we can fix that so that it is less difficult to debug.

> Note that on my laptop, there is no /var/panoptes/images/fields directory.

```
D0209 23:58:35.321 simulator.py:79      Taking 5 second exposure on Cam00: /var/panoptes/POCS/pocs/tests/data/solved.fits
D0209 23:58:35.323 pointing.py:59       Waiting for images: 0.0 seconds
D0209 23:58:35.324 simulator.py:79      Getting mount simulator status
D0209 23:58:39.436 pointing.py:59       Waiting for images: 3.0 seconds
D0209 23:58:39.437 simulator.py:79      Getting mount simulator status
E0209 23:58:40.346 fits.py:338          Error writing image to /var/panoptes/POCS/pocs/tests/data/solved.fits!
E0209 23:58:40.352 fits.py:339          File '/var/panoptes/POCS/pocs/tests/data/solved.fits' already exists.
D0209 23:58:40.823 camera.py:239        Processing Generic PANOPTES Unit_SC2780_20160909T080000
D0209 23:58:40.823 camera.py:242        Extracting pretty image
W0209 23:58:40.823 camera.py:247        Problem with extracting pretty image: None
D0209 23:58:40.823 camera.py:467        Updating FITS headers: /var/panoptes/images/fields/Kic8462852/SC2780/20160909T080000//pointing00.fits

------------------------------------------------------------------ Captured stderr call ------------------------------------------------------------------
Exception in thread Cam00Thread:
Traceback (most recent call last):
  File "/home/james/anaconda3/envs/panoptes-env/lib/python3.6/threading.py", line 916, in _bootstrap_inner
    self.run()
  File "/home/james/anaconda3/envs/panoptes-env/lib/python3.6/threading.py", line 1182, in run
    self.function(*self.args, **self.kwargs)
  File "/home/james/git/panoptes/POCS/pocs/camera/camera.py", line 249, in process_exposure
    file_path = self._process_fits(file_path, info)
  File "/home/james/git/panoptes/POCS/pocs/camera/camera.py", line 468, in _process_fits
    fits_utils.update_headers(file_path, info)
  File "/home/james/git/panoptes/POCS/pocs/utils/images/fits.py", line 349, in update_headers
    with fits.open(file_path, 'update') as f:
  File "/home/james/anaconda3/envs/panoptes-env/lib/python3.6/site-packages/astropy/io/fits/hdu/hdulist.py", line 160, in fitsopen
    lazy_load_hdus, **kwargs)
  File "/home/james/anaconda3/envs/panoptes-env/lib/python3.6/site-packages/astropy/io/fits/hdu/hdulist.py", line 413, in fromfile
    lazy_load_hdus=lazy_load_hdus, **kwargs)
  File "/home/james/anaconda3/envs/panoptes-env/lib/python3.6/site-packages/astropy/io/fits/hdu/hdulist.py", line 998, in _readfrom
    fileobj = _File(fileobj, mode=mode, memmap=memmap, cache=cache)
  File "/home/james/anaconda3/envs/panoptes-env/lib/python3.6/site-packages/astropy/utils/decorators.py", line 507, in wrapper
    return function(*args, **kwargs)
  File "/home/james/anaconda3/envs/panoptes-env/lib/python3.6/site-packages/astropy/io/fits/file.py", line 150, in __init__
    self._open_filename(fileobj, mode, overwrite)
  File "/home/james/anaconda3/envs/panoptes-env/lib/python3.6/site-packages/astropy/io/fits/file.py", line 506, in _open_filename
    self._file = fileobj_open(self.name, IO_FITS_MODES[mode])
  File "/home/james/anaconda3/envs/panoptes-env/lib/python3.6/site-packages/astropy/io/fits/util.py", line 409, in fileobj_open
    return open(filename, mode, buffering=0)
FileNotFoundError: [Errno 2] No such file or directory: '/var/panoptes/images/fields/Kic8462852/SC2780/20160909T080000//pointing00.fits'
```

AnthonyHorton, 2018-02-13:
OK. I see the problem. In the `take_observation()` method of the camera simulator it is calling the `_setup_observation()` method of the camera base class to generate output file paths, etc.,  the same as the real cameras do, but then it overrides the generated file path with `/var/panoptes/POCS/pocs/tests/data/solved.fits` (line 43 & 44).  This is causing it to try to write every file to the same location, resulting in file already exists errors and causing the subsequent processing to fail because that is expecting to find the file in the normal image directories.  I think all we need to do is remove those two lines and all will work as intended.

AnthonyHorton, 2018-02-13:
Must have missed those lines during my big refactor of the camera code, which did in fact make the simulator much more consistent with the real cameras in most ways.

wtgee, 2018-02-13:
Awesome, glad you saw the problem right away so I don't have to go searching. ;)

Closed 2018-02-14.

Thread 484 (2018-02-15):

Startup script start errors

wtgee, 2018-02-15:
I get an error when it first tries to start messaging:

```
++ date
+ echo 'Running ./start_panoptes_in_tmux.sh at Wed Feb 14 15:14:30 HST 2018'
Running ./start_panoptes_in_tmux.sh at Wed Feb 14 15:14:30 HST 2018
++ pwd
+ echo 'Current dir: /var/panoptes/POCS/scripts/startup'
Current dir: /var/panoptes/POCS/scripts/startup
+ echo 'Current user: panoptes'
Current user: panoptes
+ echo 'Current path: /home/panoptes/google-cloud-sdk/bin:/var/panoptes/bin:/home/panoptes/anaconda3/bin:/usr/local/sbin:/usr/local/bin:/usr/sbin:/usr/bin:/sbin:/bin:/usr/games:/usr/local/games:/usr/local/astrometry/bin:/home/panoptes/arduino-1.8.3/'
Current path: /home/panoptes/google-cloud-sdk/bin:/var/panoptes/bin:/home/panoptes/anaconda3/bin:/usr/local/sbin:/usr/local/bin:/usr/sbin:/usr/bin:/sbin:/bin:/usr/games:/usr/local/games:/usr/local/astrometry/bin:/home/panoptes/arduino-1.8.3/
+ echo 'PANUSER: panoptes'
PANUSER: panoptes
+ echo 'PANDIR: /var/panoptes'
PANDIR: /var/panoptes
+ echo 'PANLOG: /var/panoptes/logs'
PANLOG: /var/panoptes/logs
+ echo 'POCS: /var/panoptes/POCS'
POCS: /var/panoptes/POCS
+ echo 'PAWS: /var/panoptes/PAWS'
PAWS: /var/panoptes/PAWS
+ echo 'PIAA: '
PIAA:
+ echo 'MATPLOTLIBRC: '
MATPLOTLIBRC:
+ echo '$-:' ehxB
$-: ehxB
+ set +e
+ conda info

     active environment : None
       user config file : /home/panoptes/.condarc
 populated config files :
          conda version : 4.4.8
    conda-build version : 1.19.0
         python version : 3.5.1.final.0
       base environment : /home/panoptes/anaconda3  (writable)
           channel URLs : https://repo.continuum.io/pkgs/main/linux-64
                          https://repo.continuum.io/pkgs/main/noarch
                          https://repo.continuum.io/pkgs/free/linux-64
                          https://repo.continuum.io/pkgs/free/noarch
                          https://repo.continuum.io/pkgs/r/linux-64
                          https://repo.continuum.io/pkgs/r/noarch
                          https://repo.continuum.io/pkgs/pro/linux-64
                          https://repo.continuum.io/pkgs/pro/noarch
          package cache : /home/panoptes/anaconda3/pkgs
                          /home/panoptes/.conda/pkgs
       envs directories : /home/panoptes/anaconda3/envs
                          /home/panoptes/.conda/envs
               platform : linux-64
             user-agent : conda/4.4.8 requests/2.18.4 CPython/3.5.1 Linux/4.10.6-041006-generic ubuntu/16.04 glibc/2.23
                UID:GID : 1000:1000
             netrc file : None
           offline mode : False

+ set +e
+ python /var/panoptes/POCS/pocs/utils/data.py
Downloading http://maia.usno.navy.mil/ser7/finals2000A.all [Done]
+ tmux new-window -n messaging
+ ./start_messaging_hub.sh :messaging
+ WINDOW=:messaging
++ basename ./start_messaging_hub.sh
++ date
+ echo 'Running start_messaging_hub.sh at Wed Feb 14 15:14:39 HST 2018, WINDOW=:messaging'
Running start_messaging_hub.sh at Wed Feb 14 15:14:39 HST 2018, WINDOW=:messaging
+ sleep 1s
+ tmux send-keys -t :messaging date C-m
can't find window messaging
```

jamessynge, 2018-02-19:
I've re-worked the startup scripts, but was not able to reproduce it. Could you try again after #492 is merged?

wtgee, 2018-02-19:
Sorry, this was resolved by setting the [DISABLE_AUTO_TITLE for zsh](https://github.com/robbyrussell/oh-my-zsh/issues/908).

Closed 2018-02-19.

Thread 490 (2018-02-16):

Startup script changes

wtgee, 2018-02-16:
Startup script has been helpful but here are just a few things based on usage:

* Impatient people like me want to attach to the session immediately but then I tend to start typing keys and this tends to screw things up. Maybe put a sleep timer at end of `tmux_launch` that says when it is okay to attach (and how). Or maybe just attach?
* I don't think the peas_shell log is very helpful to see and it also is the default screen that is shown when you attach. At a minimum we should launch the peas log first then the pocs log so that it shows pocs log when attaching. But I mostly think we just don't need to follow the peas log. Or maybe place the next to each other. So launch peas, then log file then launch pocs, then log file.
* I still would like `grc` on the log files
* UTC time in status bar

jamessynge, 2018-02-16:
We'll need to add grc to the install script.

Do you still want to switch to byobu?

jamessynge, 2018-02-19:
@wtgee Can you provide a grc config file that does some useful colorizing? I tried it on PAN006, and didn't see much benefit.

wtgee, 2018-02-19:
I already posted one in #491. It doesn't provide it out of the box because we alter our log format to be different than what is standard.

jamessynge, 2018-02-19:
Sorry, didn't see that. Repeating here:

```
# PANOPTES log format coloring
#
# Dates
regexp=[^\d]*\d\d:\d\d:\d\d[\.,]{0,1}\d{0,1}\d{0,1}\d{0,1}
colours=bold blue
count=once
======
# DEBUG
regexp=^D.*$
colours=bold default
======
# INFO
regexp=^I.*$
colours=bold blue
======
# WARNING
regexp=^W.*$
colours=yellow
======
# ERROR
regexp=^E.*$
colours=bold red
======
# CRITICAL
regexp=^C.*$
colours=bold on_red
======
```

jamessynge, 2018-03-25:
Regarding:
> I don't think the peas_shell log is very helpful to see and it also is the default screen that is shown when you attach. At a minimum we should launch the peas log first then the pocs log so that it shows pocs log when attaching. But I mostly think we just don't need to follow the peas log. Or maybe place the next to each other. So launch peas, then log file then launch pocs, then log file.

I addressed this in #492 by re-ordering the windows as follows:

1. Messaging Hub
2. PAWS
3. PEAS log file viewer
4. POCS log file viewer
5. PEAS shell
6. POCS shell

POCS shell becomes the current window when it is created, so the first attach operation will see that window.

jamessynge, 2018-03-25:
Regarding:
> Impatient people like me want to attach to the session immediately but then I tend to start typing keys and this tends to screw things up. Maybe put a sleep timer at end of tmux_launch that says when it is okay to attach (and how). Or maybe just attach?

I don't think a timer will help because the user won't see any message emitted by tmux launch unless watching the log file. And I don't understand what "just attaching" would mean.

We could modify the script to create all of the windows, including an extra window that includes a message saying that startup is still in progress. When startup gets to the end, it would delete that window.

We could also provide a script to be executed from .profile which (in interactive shells) prints a message about the status of start_panoptes_in_tmux.sh, initially saying:
> start_panoptes_in_tmux is in progress, please wait before attaching to the panoptes session.
> Execute `$POCS/scripts/panoptes_status.sh` to determine the status of the PANOPTES software.

At the end of the script, it could modify what the script says to:
> Execute `tmux attach-session -t panoptes`"

And it can execute this command to indicate that it done:
> `wall "PANOPTES software is running. Execute 'tmux attach-session -t panoptes' to take control."`

Note though that `wall` doesn't work with gnome-terminal.

Thoughts?

wtgee, 2018-08-27:
@jamessynge there have been other issues updating the startup script since this issue. Should we close here?

wtgee, 2018-10-16:
Closing as stale.

Closed 2018-10-16.

Thread 493 (2018-02-19):

Add legend to timelapse frames

jamessynge, 2018-02-19:
It would be nice if each image (frame) in the timelapse had a legend with:

- Name of field
- Coordinates of field (or center)
- Name of unit
- UTC timestamp
- Local timestamp

jamessynge, 2018-09-19:
Awesome improvements, thanks.

How much effort would it be to add the coordinates? @wtgee, would you provide guidance to me in doing this?

Thread 494 (2018-02-19):

Add timelapse legend to images/fields/... directory

jamessynge, 2018-02-19:
I want things both ways: to be able to look at a bunch of timelapse movies all at once (i.e. by looking at the images/timelapse directory), and also when looking at a particular observation folder (e.g. /var/panoptes/images/fields/HatP20/7bab97/20180218T231235). A benefit of the latter is that we can then easily uploaded it to GCS, making it easier for folks to get a quick summary of the observation by viewing the timelapse.

wtgee, 2018-02-19:
I think this would be best as a functionality of PAWS.

jamessynge, 2018-02-21:
Sorry, I copied the title from the previous issue, and forgot to remove the word 'legend'. The primary point here is that the .mp4 timelapse files should be uploaded along with the .fits.fz image files.

Secondarily, I'm saying that I want it to be easy to find the timelapse images for the current/previous night. That could well be a feature of PAWS.

wtgee, 2018-02-21:
I've gone back and forth about keeping the timelapses in a storage bucket as I think they have very limited utility and, ultimately, could be recreated from the data if needed. Usually they will be viewed for the previous night or one or two nights afterward but probably never again so I think they are okay to just store locally and make available via PAWS. Could in the future have some sort of share feature maybe?

wtgee, 2022-01-15:
Stale.

Closed 2022-01-15.

Thread 498 (2018-02-22):

Add WCS information to fits header

rzellem, 2018-02-22:
Adding WCS information (http://docs.astropy.org/en/stable/wcs/) to the fits header will be very helpful when reducing the data as it will allow the user/code to quickly find the target of interest from its RA+DEC rather than its pixel location. Particularly helpful in large fields with dim target stars and for fields where the target has shifted its location on the detector due to, for example, a meridian flip.

wtgee, 2018-02-22:
Each unit has one camera that is designated as the `primary` camera and we do plate-solving on those images while the unit is running (we implement a simple closed-loop tracking correction). So if you check both cameras for a given observation one set of them should already have WCS.

We had planned to solve the other set during the pipeline process but it might make more sense to do it during the `housekeeping` state at the end of the day so that all images that are uploaded have a WCS.

Note that we never do a meridian flip during a course of a single Observation. Essentially once the target has shifted pixels in any significant way we want to start a new Observation, even if it is on the same target/field. This is due to how the algorithm works for processing the RGB array. Observations are all contained within one folder and are also known as a "sequence" (with a corresponding `SEQID` in the fits header).

wtgee, 2018-02-22:
Immediate follow-up: I don't see any reason not to do this during `housekeeping` so let's go with that.

rzellem, 2018-02-22:
Ah, ok, then I was probably looking at data from the other camera that didn't have WCS information. Sorry, still learning how the data is stored into the subdirectories.

Quick follow up question: how does the location of the target on the chip affect the RGB array processing? Aren't the R, G, and B pixels always fixed on the array and therefore should always be extracted in a similar way?

wtgee, 2020-02-17:
Closing as stale.

Closed 2020-02-17.

Thread 500 (2018-02-26):

Poor handling of serial I/O failure with Astrohaven dome

jamessynge, 2018-02-26:
pocs_shell output:

```
POCS > run_pocs
Starting messaging
Command publisher started on port 6500
Command subscriber started on port 6501
Message subscriber started on port 6511
Message publisher started on port 6510
Starting POCS - Press Ctrl-c to interrupt
POCS stopped.
POCS > open_dome
Problem opening the dome: read failed: device reports readiness to read but returned no data (device disconnected or multiple access on port?)
POCS > exit
Shutting down POCS instance, please wait
Traceback (most recent call last):
  File "/home/panoptes/anaconda3/envs/panoptes-env/lib/python3.6/site-packages/serial/serialposix.py", line 501, in read
    'device reports readiness to read but returned no data '
serial.serialutil.SerialException: device reports readiness to read but returned no data (device disconnected or multiple access on port?)

During handling of the above exception, another exception occurred:

Traceback (most recent call last):
  File "bin/pocs_shell", line 899, in <module>
    PocsShell().cmdloop()
  File "/home/panoptes/anaconda3/envs/panoptes-env/lib/python3.6/cmd.py", line 138, in cmdloop
    stop = self.onecmd(line)
  File "/home/panoptes/anaconda3/envs/panoptes-env/lib/python3.6/cmd.py", line 217, in onecmd
    return func(arg)
  File "bin/pocs_shell", line 256, in do_exit
    self.do_power_down()
  File "bin/pocs_shell", line 332, in do_power_down
    self.pocs.power_down()
  File "/var/panoptes/POCS/pocs/core.py", line 227, in power_down
    if not self.observatory.close_dome():
  File "/var/panoptes/POCS/pocs/observatory.py", line 535, in close_dome
    if not self.dome.is_closed:
  File "/var/panoptes/POCS/pocs/dome/astrohaven.py", line 86, in is_closed
    v = self._read_latest_state()
  File "/var/panoptes/POCS/pocs/dome/astrohaven.py", line 128, in _read_latest_state
    data = self.serial.read_bytes(size=1)
  File "/var/panoptes/POCS/pocs/utils/rs232.py", line 189, in read_bytes
    return self.ser.read(size=size)
  File "/home/panoptes/anaconda3/envs/panoptes-env/lib/python3.6/site-packages/serial/serialposix.py", line 509, in read
    raise SerialException('read failed: {}'.format(e))
serial.serialutil.SerialException: read failed: device reports readiness to read but returned no data (device disconnected or multiple access on port?)
```

pocs_shell-all.log:
```
D0226 23:23:03.693 machine.py:209       Checking safety for get_ready
D0226 23:23:03.693 machine.py:214       Always safe to move to get_ready
D0226 23:23:03.693 machine.py:253       Before calling get_ready from sleeping state
I0226 23:23:10.865 messaging.py:134     PANCHAT Ok, I'm all set up and ready to go!
D0226 23:23:10.865 abstract_serial_dome.py:70 Already connected to dome
I0226 23:23:13.866 observatory.py:522   Opening dome
W0226 23:23:13.974 machine.py:134       Problem going from ready to ready, exiting loop [SerialException('read failed: device reports readiness to read but returned no data (device disconnected or multiple access on port?)',)]
I0226 23:23:13.979 machine.py:181       Stopping POCS states
D0226 23:40:17.235 core.py:351          Checking weather safety
D0226 23:40:17.240 core.py:371          Weather Safety: True [26 sec old - 2018-02-26 23:39:50.972000]
D0226 23:40:17.240 abstract_serial_dome.py:70 Already connected to dome
I0226 23:40:45.160 messaging.py:134     PANCHAT I'm powering down
I0226 23:40:45.160 core.py:225          Shutting down POCS State Machine: , please be patient and allow for exit.
D0226 23:40:45.161 abstract_serial_dome.py:70 Already connected to dome
```

jamessynge, 2018-02-28:
FYI, the USB serial adapter was present in Linux, but no I/O was possible. I suspect that I needed the ability to reset the specific USB device, but didn't have a program at hand for that (I now do). So, I rebooted the computer, after which POCS started up automatically and was able to open the dome.

We MAY want to add the ability to detect when a failing serial device is a USB device, and if so disconnect, reset the underlying device, and reconnect. I suppose that `dmesg` might be used to look for errors.

wtgee, 2018-02-28:
What did you use to reset the USB device? I had a little utility (I think `usbreset.c`) that I had used but it didn't seem to always do what I wanted. This was on PAN001.

jamessynge, 2018-03-31:
I checked on PAN006 this morning, and found that it had left the clamshell dome half open (i.e. one of the two shutters was open). The log showed that it was encountering an error while trying to read the feedback from the dome controller (i.e. getting an empty array back instead of an array with a byte in it). I hit Ctrl-C in pocs_shell to break out of the loop, then entered the `close_dome` command. The dome didn't close. I then entered the `exit` command, at which point it did close the dome. Hmm.

It isn't clear from reading that logs that the problem this time was the same as previously reported; instead it appears that the controller is not reporting back the values that I was anticipating, or at least the timing is wrong. I may need to add the ability to record the responses and their timings in order to be able to properly debug this.

jamessynge, 2018-04-08:
Update: I'm now thinking that this problem is due to a problem with the shutter B position sensor(s). It appears that it is not reporting when the shutter has closed, so we keep sending the signal to close until the timeout is reached (thank goodness for that). I chatted with Bob Moore who works with the same type of Astrohaven 7' dome, and said they had the same problem because the sensor is secured with double sided tape that fails.

wtgee, 2024-03-28:
Closing as stale. Re-open as needed.

Closed 2024-03-28.

Thread 503 (2018-03-09):

DATE-OBS from DSLRs can be wrong

wtgee, 2018-03-09:
The DATE-OBS fits header is coming directly from the EXIF information embedded in the CR2 file, which corresponds to the time that is set on the camera. This can be off or otherwise inconsistent with the control computer. Should have one source of time for DATE-OBS. Should just match the timestamp in the file name (and from IMAGE_ID)

wtgee, 2018-08-24:
Bumping this as we are seeing the same thing on some images from PAN012. Need to ensure a proper date is coming through on the cameras.

wtgee, 2018-09-20:
Fixed in #589

Closed 2018-09-20.

Thread 505 (2018-03-12):

pocs_shell loop stops at end of night

jamessynge, 2018-03-12:
At dawn this morning POCS went through the end of night cleanup, but then printed this:

```
I0311 10:21:21.852 messaging.py:134     PANCHAT Weather is good and it is dark. Something must have gone wrong. Stopping loop.
```

The previous Dark Check reported False (see below), so I don't know why it would be reporting that it is dark.

Another problem is that it has apparently stopped the `run_pocs` loop (the logging stopped shortly after that), but pocs_shell didn't not prompt for another command.

```
D0311 10:12:27.985 core.py:336          Dark Check: True
D0311 10:12:27.985 core.py:351          Checking weather safety
D0311 10:12:27.986 core.py:371          Weather Safety: True [48 sec old - 2018-03-11 10:11:40.474000]
D0311 10:12:30.002 machine.py:253       Before calling track from pointing state
D0311 10:12:34.619 machine.py:267       After calling track. Now in tracking state
D0311 10:12:34.622 machine.py:309       Source: tracking	 Dest: observing
D0311 10:12:34.622 machine.py:171       Transition method: observe
D0311 10:12:34.622 machine.py:209       Checking safety for observe
D0311 10:12:34.730 core.py:336          Dark Check: True
D0311 10:12:34.730 core.py:351          Checking weather safety
D0311 10:12:34.732 core.py:371          Weather Safety: True [54 sec old - 2018-03-11 10:11:40.474000]
D0311 10:12:36.747 machine.py:253       Before calling observe from tracking state
I0311 10:12:41.651 messaging.py:134     PANCHAT I'm finding exoplanets!
D0311 10:12:41.652 observatory.py:425   Getting headers for : KIC 8462852: 120.0 s exposures in blocks of 10, minimum 60, priority 200
D0311 10:12:42.266 observatory.py:263   Exposing for camera: Cam00
D0311 10:12:42.266 camera.py:437        image_id: Panoptes Unit PAN006 @ Wheaton College_6575fc_20180311T101242
D0311 10:12:42.266 canon_gphoto2.py:124 Taking 120.0 second exposure on Cam00: /var/panoptes/images/fields/Kic8462852/6575fc/20180311T101114//20180311T101242.cr2
D0311 10:12:42.272 observatory.py:263   Exposing for camera: Cam01
D0311 10:12:42.273 camera.py:437        image_id: Panoptes Unit PAN006 @ Wheaton College_7bab97_20180311T101242
D0311 10:12:42.273 canon_gphoto2.py:124 Taking 120.0 second exposure on Cam01: /var/panoptes/images/fields/Kic8462852/7bab97/20180311T101114//20180311T101242.cr2
D0311 10:12:42.279 observing.py:25      Waiting for images: 0.0 seconds
D0311 10:13:01.672 observing.py:25      Waiting for images: 15.0 seconds
D0311 10:13:21.679 observing.py:25      Waiting for images: 30.0 seconds
D0311 10:13:41.669 observing.py:25      Waiting for images: 45.0 seconds
D0311 10:14:01.691 observing.py:25      Waiting for images: 60.0 seconds
D0311 10:14:21.672 observing.py:25      Waiting for images: 75.0 seconds
D0311 10:14:41.691 observing.py:25      Waiting for images: 90.0 seconds
D0311 10:14:48.272 camera.py:241        Processing Panoptes Unit PAN006 @ Wheaton College_6575fc_20180311T101242
D0311 10:14:48.272 camera.py:244        Extracting pretty image
D0311 10:14:48.278 canon_gphoto2.py:154 Converting CR2 -> FITS: /var/panoptes/images/fields/Kic8462852/6575fc/20180311T101114//20180311T101242.cr2
D0311 10:14:48.283 camera.py:241        Processing Panoptes Unit PAN006 @ Wheaton College_7bab97_20180311T101242
D0311 10:14:48.284 camera.py:244        Extracting pretty image
D0311 10:14:48.295 canon_gphoto2.py:154 Converting CR2 -> FITS: /var/panoptes/images/fields/Kic8462852/7bab97/20180311T101114//20180311T101242.cr2
D0311 10:14:51.774 camera.py:254        Adding current observation to db: Panoptes Unit PAN006 @ Wheaton College_6575fc_20180311T101242
D0311 10:14:51.776 camera.py:263        Adding image metadata to db: Panoptes Unit PAN006 @ Wheaton College_6575fc_20180311T101242
D0311 10:14:51.855 camera.py:260        Compressing /var/panoptes/images/fields/Kic8462852/7bab97/20180311T101114//20180311T101242.fits
D0311 10:14:52.091 camera.py:263        Adding image metadata to db: Panoptes Unit PAN006 @ Wheaton College_7bab97_20180311T101242
D0311 10:15:01.713 observing.py:42      Finished with observing, going to analyze
D0311 10:15:01.713 machine.py:267       After calling observe. Now in observing state
D0311 10:15:01.716 machine.py:309       Source: observing	 Dest: analyzing
D0311 10:15:01.716 machine.py:171       Transition method: analyze
D0311 10:15:01.716 machine.py:209       Checking safety for analyze
D0311 10:15:01.980 observatory.py:82    Sun -9.82 deg > -10.0 deg
D0311 10:15:01.980 core.py:336          Dark Check: False
D0311 10:15:01.981 core.py:351          Checking weather safety
D0311 10:15:01.982 core.py:371          Weather Safety: True [36 sec old - 2018-03-11 10:14:26.411000]
W0311 10:15:01.983 core.py:308          Unsafe conditions: {'is_dark': False, 'good_weather': True, 'free_space': True}
W0311 10:15:01.983 core.py:311          Safety failed so sending to park
D0311 10:15:01.983 machine.py:209       Checking safety for park
D0311 10:15:01.983 machine.py:214       Always safe to move to park
D0311 10:15:01.983 machine.py:253       Before calling park from observing state
D0311 10:15:06.697 observation.py:141   Resetting observation KIC 8462852: 120.0 s exposures in blocks of 10, minimum 60, priority 200
I0311 10:15:06.697 scheduler.py:116     Setting new observation to None
I0311 10:15:06.698 messaging.py:134     PANCHAT Closing dome
D0311 10:15:06.699 abstract_serial_dome.py:70 Already connected to dome
I0311 10:15:06.951 observatory.py:536   Closed dome
D0311 10:15:14.022 astrohaven.py:183    Got target_feedback, feedback_countdown=1
D0311 10:15:14.432 astrohaven.py:183    Got target_feedback, feedback_countdown=0
D0311 10:15:21.802 astrohaven.py:183    Got target_feedback, feedback_countdown=1
D0311 10:15:22.211 astrohaven.py:183    Got target_feedback, feedback_countdown=0
I0311 10:15:25.111 messaging.py:134     PANCHAT I'm takin' it on home and then parking.
D0311 10:15:32.632 mount.py:356         Slewing to home, sleeping for 5 seconds
D0311 10:15:39.646 mount.py:356         Slewing to home, sleeping for 5 seconds
I0311 10:15:41.659 ioptron.py:141       Initializing pocs.mount.ioptron mount
I0311 10:15:42.661 ioptron.py:244       Setting up mount for location
D0311 10:15:45.672 serial.py:88         Setting tracking rate to sidereal +00.0000
D0311 10:15:46.173 serial.py:90         Custom tracking rate set
D0311 10:15:46.674 serial.py:94         Tracking response: 1
D0311 10:15:46.675 serial.py:98         Custom tracking rate sent
D0311 10:15:46.675 ioptron.py:212       Setting manual moving rate to max
D0311 10:15:47.677 ioptron.py:214       Mount guide rate: 5050
D0311 10:15:48.679 ioptron.py:220       Mount guide rate: 0.5 0.5
I0311 10:15:48.680 ioptron.py:167       Mount initialized: True
D0311 10:15:48.680 mount.py:228         Setting park position
D0311 10:15:48.691 mount.py:234         LST: 16.78651274723184 hourangle
D0311 10:15:48.691 mount.py:235         HA: -170.0 deg
D0311 10:15:48.692 mount.py:238         RA: 28.119846080565175 hourangle
D0311 10:15:48.692 mount.py:239         Dec: -10.0 deg
D0311 10:15:48.696 mount.py:243         Park Coordinates RA-Dec: <SkyCoord (ICRS): (ra, dec) in deg
    ( 61.79769121, -10.)>
D0311 10:15:48.696 mount.py:266         Setting target coordinates: <SkyCoord (ICRS): (ra, dec) in deg
    ( 61.79769121, -10.)>
D0311 10:15:48.697 ioptron.py:322       RA (ms): 14831445.890034616 ms
D0311 10:15:48.698 ioptron.py:325       Dec (centiarcsec): -3600000.0 carcsec
D0311 10:15:50.201 ioptron.py:187       Slewing to park
D0311 10:16:10.794 mount.py:460         Mount unparked
D0311 10:16:11.295 mount.py:474         Move command: move_south
D0311 10:16:11.296 mount.py:478         Moving south for 11.0 seconds.
D0311 10:16:24.808 mount.py:483         13.509969000006805 seconds passed before stop
D0311 10:16:25.311 mount.py:485         14.01370999999827 seconds passed total
D0311 10:16:25.311 mount.py:493         Stopping movement
D0311 10:16:27.826 mount.py:368         Mount parked
D0311 10:16:27.827 machine.py:267       After calling park. Now in parking state
D0311 10:16:30.332 machine.py:309       Source: parking	 Dest: parked
D0311 10:16:30.333 machine.py:171       Transition method: set_park
D0311 10:16:30.333 machine.py:209       Checking safety for set_park
D0311 10:16:30.333 machine.py:214       Always safe to move to set_park
D0311 10:16:30.334 machine.py:253       Before calling set_park from parking state
I0311 10:16:34.809 messaging.py:134     PANCHAT I'm parked now. Phew.
D0311 10:16:34.995 observatory.py:82    Sun -9.53 deg > -10.0 deg
D0311 10:16:34.995 core.py:336          Dark Check: False
D0311 10:16:34.995 core.py:351          Checking weather safety
D0311 10:16:34.996 core.py:371          Weather Safety: True [46 sec old - 2018-03-11 10:15:49.388000]
W0311 10:16:34.996 core.py:308          Unsafe conditions: {'is_dark': False, 'good_weather': True, 'free_space': True}
I0311 10:16:34.997 messaging.py:134     PANCHAT Cleaning up for the night!
D0311 10:16:34.997 machine.py:267       After calling set_park. Now in parked state
D0311 10:16:34.999 machine.py:309       Source: parked	 Dest: housekeeping
D0311 10:16:34.999 machine.py:171       Transition method: clean_up
D0311 10:16:34.999 machine.py:209       Checking safety for clean_up
D0311 10:16:34.999 machine.py:214       Always safe to move to clean_up
D0311 10:16:34.999 machine.py:253       Before calling clean_up from parked state
I0311 10:16:39.810 messaging.py:134     PANCHAT Recording all the data for the night.
D0311 10:16:39.810 observatory.py:221   Housekeeping for HAT-P-36: 120.0 s exposures in blocks of 10, minimum 60, priority 100
D0311 10:16:39.810 observatory.py:225   Cleanup for camera Cam00 [6575fc]
D0311 10:17:22.256 observatory.py:237   Uploading directory to google cloud storage
D0311 10:17:41.035 observatory.py:225   Cleanup for camera Cam01 [7bab97]
D0311 10:18:01.945 observatory.py:237   Uploading directory to google cloud storage
D0311 10:18:20.260 observatory.py:240   Cleanup finished
D0311 10:18:20.260 observatory.py:221   Housekeeping for HAT-P-12: 120.0 s exposures in blocks of 10, minimum 60, priority 100
D0311 10:18:20.260 observatory.py:225   Cleanup for camera Cam00 [6575fc]
D0311 10:18:56.649 observatory.py:237   Uploading directory to google cloud storage
D0311 10:19:11.865 observatory.py:225   Cleanup for camera Cam01 [7bab97]
D0311 10:19:30.383 observatory.py:237   Uploading directory to google cloud storage
D0311 10:19:45.531 observatory.py:240   Cleanup finished
D0311 10:19:45.532 observatory.py:221   Housekeeping for Kepler 1100: 120.0 s exposures in blocks of 10, minimum 60, priority 125
D0311 10:19:45.532 observatory.py:225   Cleanup for camera Cam00 [6575fc]
D0311 10:20:23.403 observatory.py:237   Uploading directory to google cloud storage
D0311 10:20:39.101 observatory.py:225   Cleanup for camera Cam01 [7bab97]
D0311 10:20:54.918 observatory.py:237   Uploading directory to google cloud storage
D0311 10:21:10.480 observatory.py:240   Cleanup finished
D0311 10:21:10.480 observatory.py:221   Housekeeping for KIC 8462852: 120.0 s exposures in blocks of 10, minimum 60, priority 200
D0311 10:21:10.480 observatory.py:225   Cleanup for camera Cam00 [6575fc]
D0311 10:21:11.841 observatory.py:237   Uploading directory to google cloud storage
D0311 10:21:14.273 observatory.py:225   Cleanup for camera Cam01 [7bab97]
D0311 10:21:14.665 observatory.py:237   Uploading directory to google cloud storage
D0311 10:21:17.123 observatory.py:240   Cleanup finished
D0311 10:21:17.123 scheduler.py:202     Resetting observed list
I0311 10:21:17.125 messaging.py:134     PANCHAT Ok, I'm done cleaning up all the recorded data.
D0311 10:21:17.125 machine.py:267       After calling clean_up. Now in housekeeping state
D0311 10:21:17.129 machine.py:309       Source: housekeeping	 Dest: sleeping
D0311 10:21:17.129 machine.py:171       Transition method: goto_sleep
D0311 10:21:17.129 machine.py:209       Checking safety for goto_sleep
D0311 10:21:17.129 machine.py:214       Always safe to move to goto_sleep
D0311 10:21:17.129 machine.py:253       Before calling goto_sleep from housekeeping state
I0311 10:21:21.852 messaging.py:134     PANCHAT Weather is good and it is dark. Something must have gone wrong. Stopping loop.
I0311 10:21:21.852 machine.py:181       Stopping POCS states
I0311 10:21:21.853 messaging.py:134     PANCHAT Another successful night!
D0311 10:21:21.853 machine.py:267       After calling goto_sleep. Now in sleeping state
```

jamessynge, 2018-07-06:
See also #527 and #504.

wtgee, 2020-06-14:
Closing as stale.

Closed 2020-06-14.

Thread 508 (2018-03-27):

pocs_shell exit hanging

jamessynge, 2018-03-27:
The log file showed no activity after I entered exit, but pocs_shell did not stop. It looks like it might have been waiting 30 minutes for the sky to be clear... in part because it hadn't detected that I'd changed pocs_local.yaml to point to a new targets file.

This is the output in the terminal:

```
POCS > run_pocs                                                                                             
Starting POCS - Press Ctrl-c to interrupt
^CPOCS interrupted, skipping states and parking
POCS stopped.
POCS > exit
Shutting down POCS instance, please wait
^CTraceback (most recent call last):
  File "bin/pocs_shell", line 899, in <module>
    PocsShell().cmdloop()
  File "/home/panoptes/anaconda3/envs/panoptes-env/lib/python3.6/cmd.py", line 138, in cmdloop
    stop = self.onecmd(line)
  File "/home/panoptes/anaconda3/envs/panoptes-env/lib/python3.6/cmd.py", line 217, in onecmd
    return func(arg)
  File "bin/pocs_shell", line 256, in do_exit
    self.do_power_down()
  File "bin/pocs_shell", line 332, in do_power_down
    self.pocs.power_down()
  File "/var/panoptes/POCS/pocs/core.py", line 243, in power_down
    self.set_park()
  File "/home/panoptes/anaconda3/envs/panoptes-env/lib/python3.6/site-packages/transitions/core.py", line 382, in trigger
    return self.machine._process(func)
  File "/home/panoptes/anaconda3/envs/panoptes-env/lib/python3.6/site-packages/transitions/core.py", line 1007, in _process
    return trigger()
  File "/home/panoptes/anaconda3/envs/panoptes-env/lib/python3.6/site-packages/transitions/core.py", line 398, in _trigger
    return self._process(event_data)
  File "/home/panoptes/anaconda3/envs/panoptes-env/lib/python3.6/site-packages/transitions/core.py", line 408, in _process
    if trans.execute(event_data):
  File "/home/panoptes/anaconda3/envs/panoptes-env/lib/python3.6/site-packages/transitions/core.py", line 262, in execute
    self._change_state(event_data)
  File "/home/panoptes/anaconda3/envs/panoptes-env/lib/python3.6/site-packages/transitions/core.py", line 273, in _change_state
    event_data.machine.get_state(self.dest).enter(event_data)
  File "/home/panoptes/anaconda3/envs/panoptes-env/lib/python3.6/site-packages/transitions/core.py", line 119, in enter
    event_data.machine.callback(handle, event_data)
  File "/home/panoptes/anaconda3/envs/panoptes-env/lib/python3.6/site-packages/transitions/core.py", line 988, in callback
    func(event_data)
  File "/var/panoptes/POCS/pocs/state/states/default/parked.py", line 28, in on_enter
    pocs.sleep(delay=1800)  # 30 minutes = 1800 seconds
  File "/var/panoptes/POCS/pocs/core.py", line 430, in sleep
    time.sleep(10.0)
KeyboardInterrupt
--- Logging error ---
Traceback (most recent call last):
  File "/home/panoptes/anaconda3/envs/panoptes-env/lib/python3.6/logging/handlers.py", line 73, in emit
    logging.FileHandler.emit(self, record)
  File "/home/panoptes/anaconda3/envs/panoptes-env/lib/python3.6/logging/__init__.py", line 1069, in emit
    self.stream = self._open()
  File "/home/panoptes/anaconda3/envs/panoptes-env/lib/python3.6/logging/__init__.py", line 1059, in _open
    return open(self.baseFilename, self.mode, encoding=self.encoding)
NameError: name 'open' is not defined
Call stack:
  File "/var/panoptes/POCS/pocs/dome/abstract_serial_dome.py", line 42, in __del__
    self.serial.disconnect()
  File "/var/panoptes/POCS/pocs/utils/rs232.py", line 156, in disconnect
    self.logger.debug('SerialData.disconnect called for {}', self.name)
Message: 'SerialData.disconnect called for {}'
Arguments: ('/dev/ttyUSB2',)
(panoptes-env) panoptes@Panmass:/var/panoptes/POCS ((30a2828...))$
```

And this is the end of the log file:

```
E0326 23:54:37.009 error.py:18          NoObservation: No valid observations found
I0326 23:54:37.011 messaging.py:134     PANCHAT No valid observations found. Can't schedule. Going to park.
D0326 23:54:37.012 machine.py:267       After calling schedule. Now in scheduling state
D0326 23:54:37.014 machine.py:309       Source: scheduling	 Dest: parking
D0326 23:54:37.014 machine.py:171       Transition method: park
D0326 23:54:37.014 machine.py:209       Checking safety for park
D0326 23:54:37.014 machine.py:214       Always safe to move to park
D0326 23:54:37.014 machine.py:253       Before calling park from scheduling state
I0326 23:54:42.170 scheduler.py:116     Setting new observation to None
I0326 23:54:42.170 messaging.py:134     PANCHAT Closing dome
D0326 23:54:42.171 abstract_serial_dome.py:70 Already connected to dome
I0326 23:54:42.520 observatory.py:536   Closed dome
D0326 23:54:49.592 astrohaven.py:183    Got target_feedback, feedback_countdown=1
D0326 23:54:50.001 astrohaven.py:183    Got target_feedback, feedback_countdown=0
D0326 23:54:57.281 astrohaven.py:183    Got target_feedback, feedback_countdown=1
D0326 23:54:57.691 astrohaven.py:183    Got target_feedback, feedback_countdown=0
I0326 23:55:00.591 messaging.py:134     PANCHAT I'm takin' it on home and then parking.
D0326 23:55:08.114 mount.py:356         Slewing to home, sleeping for 5 seconds
D0326 23:55:15.132 mount.py:356         Slewing to home, sleeping for 5 seconds
D0326 23:55:22.155 mount.py:356         Slewing to home, sleeping for 5 seconds
I0326 23:55:24.170 ioptron.py:141       Initializing pocs.mount.ioptron mount
I0326 23:55:25.172 ioptron.py:244       Setting up mount for location
D0326 23:55:28.184 serial.py:88         Setting tracking rate to sidereal +00.0000
D0326 23:55:28.686 serial.py:90         Custom tracking rate set
D0326 23:55:29.187 serial.py:94         Tracking response: 1
D0326 23:55:29.188 serial.py:98         Custom tracking rate sent
D0326 23:55:29.188 ioptron.py:212       Setting manual moving rate to max
D0326 23:55:30.190 ioptron.py:214       Mount guide rate: 5050
D0326 23:55:31.192 ioptron.py:220       Mount guide rate: 0.5 0.5
I0326 23:55:31.193 ioptron.py:167       Mount initialized: True
D0326 23:55:31.193 mount.py:228         Setting park position
D0326 23:55:31.204 mount.py:234         LST: 7.471357350520564 hourangle
D0326 23:55:31.204 mount.py:235         HA: -170.0 deg
D0326 23:55:31.205 mount.py:238         RA: 18.8046906838539 hourangle
D0326 23:55:31.205 mount.py:239         Dec: -10.0 deg
D0326 23:55:31.210 mount.py:243         Park Coordinates RA-Dec: <SkyCoord (ICRS): (ra, dec) in deg
    ( 282.07036026, -10.)>
D0326 23:55:31.210 mount.py:266         Setting target coordinates: <SkyCoord (ICRS): (ra, dec) in deg
    ( 282.07036026, -10.)>
D0326 23:55:31.211 ioptron.py:322       RA (ms): 67696886.46187404 ms
D0326 23:55:31.212 ioptron.py:325       Dec (centiarcsec): -3600000.0 carcsec
D0326 23:55:32.714 ioptron.py:187       Slewing to park
D0326 23:55:53.303 mount.py:460         Mount unparked
D0326 23:55:53.804 mount.py:474         Move command: move_south
D0326 23:55:53.805 mount.py:478         Moving south for 11.0 seconds.
D0326 23:56:07.316 mount.py:483         13.509153999996926 seconds passed before stop
D0326 23:56:07.818 mount.py:485         14.0126439999964 seconds passed total
D0326 23:56:07.818 mount.py:493         Stopping movement
D0326 23:56:10.328 mount.py:368         Mount parked
D0326 23:56:10.329 machine.py:267       After calling park. Now in parking state
D0326 23:56:10.333 machine.py:309       Source: parking	 Dest: parked
D0326 23:56:10.333 machine.py:171       Transition method: set_park
D0326 23:56:10.334 machine.py:209       Checking safety for set_park
D0326 23:56:10.334 machine.py:214       Always safe to move to set_park
D0326 23:56:10.334 machine.py:253       Before calling set_park from parking state
I0326 23:56:15.277 messaging.py:134     PANCHAT I'm parked now. Phew.
I0326 23:56:15.278 messaging.py:134     PANCHAT No observations found.
I0326 23:56:15.279 messaging.py:134     PANCHAT Going to stay parked for half an hour then will try again.
D0327 00:26:21.884 core.py:336          Dark Check: True
D0327 00:26:21.884 core.py:351          Checking weather safety
D0327 00:26:21.886 core.py:371          Weather Safety: True [31 sec old - 2018-03-27 00:25:51.207000]
D0327 00:26:21.887 core.py:267          Resetting observing run attempts
D0327 00:26:21.887 machine.py:267       After calling set_park. Now in parked state
D0327 00:26:21.890 machine.py:309       Source: parked	 Dest: ready
D0327 00:26:21.891 machine.py:171       Transition method: get_ready
D0327 00:26:21.891 machine.py:209       Checking safety for get_ready
D0327 00:26:21.891 machine.py:214       Always safe to move to get_ready
D0327 00:26:21.891 machine.py:253       Before calling get_ready from parked state
I0327 00:26:26.288 messaging.py:134     PANCHAT Ok, I'm all set up and ready to go!
D0327 00:26:26.289 abstract_serial_dome.py:70 Already connected to dome
I0327 00:26:26.620 observatory.py:522   Opening dome
D0327 00:26:33.922 astrohaven.py:183    Got target_feedback, feedback_countdown=1
D0327 00:26:34.331 astrohaven.py:183    Got target_feedback, feedback_countdown=0
D0327 00:26:41.430 astrohaven.py:183    Got target_feedback, feedback_countdown=1
D0327 00:26:41.840 astrohaven.py:183    Got target_feedback, feedback_countdown=0
D0327 00:26:45.242 mount.py:460         Mount unparked
D0327 00:26:45.242 machine.py:267       After calling get_ready. Now in ready state
D0327 00:26:45.244 machine.py:309       Source: ready	 Dest: scheduling
D0327 00:26:45.244 machine.py:171       Transition method: schedule
D0327 00:26:45.244 machine.py:209       Checking safety for schedule
D0327 00:26:45.355 core.py:336          Dark Check: True
D0327 00:26:45.355 core.py:351          Checking weather safety
D0327 00:26:45.356 core.py:371          Weather Safety: True [54 sec old - 2018-03-27 00:25:51.207000]
D0327 00:26:45.356 machine.py:253       Before calling schedule from ready state
I0327 00:26:50.802 messaging.py:134     PANCHAT Ok, I'm finding something good to look at...
D0327 00:26:50.802 observatory.py:186   Getting observation for observatory
D0327 00:26:50.803 scheduler.py:255     Reading fields from file: /var/panoptes/POCS/resources/targets/2018-03-11.yaml
D0327 00:26:50.805 scheduler.py:227     Adding Tres 3 to scheduler
D0327 00:26:50.868 observation.py:76    Observation created: Tres 3: 120.0 s exposures in blocks of 10, minimum 60, priority 300
I0327 00:26:51.646 dispatch.py:54       Checking Constraint: Altitude
D0327 00:26:51.646 dispatch.py:57       	Observation: Tres 3
D0327 00:26:51.712 constraint.py:61     		Below minimum altitude: -5.39 < 20.00
D0327 00:26:51.713 dispatch.py:62       		Score: 0.00000	Veto: True
D0327 00:26:51.713 dispatch.py:65       		Tres 3 vetoed by Altitude
I0327 00:26:51.713 dispatch.py:54       Checking Constraint: Moon Avoidance
I0327 00:26:51.713 dispatch.py:54       Checking Constraint: Duration above 20.0 deg
I0327 00:26:51.713 scheduler.py:116     Setting new observation to None
E0327 00:26:51.724 error.py:18          NoObservation: No valid observations found
I0327 00:26:51.724 messaging.py:134     PANCHAT No valid observations found. Can't schedule. Going to park.
D0327 00:26:51.724 machine.py:267       After calling schedule. Now in scheduling state
D0327 00:26:51.727 machine.py:309       Source: scheduling	 Dest: parking
D0327 00:26:51.727 machine.py:171       Transition method: park
D0327 00:26:51.727 machine.py:209       Checking safety for park
D0327 00:26:51.727 machine.py:214       Always safe to move to park
D0327 00:26:51.727 machine.py:253       Before calling park from scheduling state
I0327 00:26:56.436 scheduler.py:116     Setting new observation to None
I0327 00:26:56.437 messaging.py:134     PANCHAT Closing dome
D0327 00:26:56.437 abstract_serial_dome.py:70 Already connected to dome
I0327 00:26:56.741 observatory.py:536   Closed dome
D0327 00:27:04.414 astrohaven.py:183    Got target_feedback, feedback_countdown=1
D0327 00:27:04.824 astrohaven.py:183    Got target_feedback, feedback_countdown=0
D0327 00:27:12.102 astrohaven.py:183    Got target_feedback, feedback_countdown=1
D0327 00:27:12.512 astrohaven.py:183    Got target_feedback, feedback_countdown=0
I0327 00:27:15.413 messaging.py:134     PANCHAT I'm takin' it on home and then parking.
D0327 00:27:22.935 mount.py:356         Slewing to home, sleeping for 5 seconds
D0327 00:27:29.956 mount.py:356         Slewing to home, sleeping for 5 seconds
D0327 00:27:40.510 mount.py:356         Slewing to home, sleeping for 5 seconds
I0327 00:27:42.526 ioptron.py:141       Initializing pocs.mount.ioptron mount
I0327 00:27:43.528 ioptron.py:244       Setting up mount for location
D0327 00:27:46.540 serial.py:88         Setting tracking rate to sidereal +00.0000
D0327 00:27:47.041 serial.py:90         Custom tracking rate set
D0327 00:27:47.542 serial.py:94         Tracking response: 1
D0327 00:27:47.543 serial.py:98         Custom tracking rate sent
D0327 00:27:47.543 ioptron.py:212       Setting manual moving rate to max
D0327 00:27:48.545 ioptron.py:214       Mount guide rate: 5050
D0327 00:27:49.548 ioptron.py:220       Mount guide rate: 0.5 0.5
I0327 00:27:49.548 ioptron.py:167       Mount initialized: True
D0327 00:27:49.548 mount.py:228         Setting park position
D0327 00:27:49.559 mount.py:234         LST: 8.011263590162148 hourangle
D0327 00:27:49.559 mount.py:235         HA: -170.0 deg
D0327 00:27:49.560 mount.py:238         RA: 19.344596923495484 hourangle
D0327 00:27:49.560 mount.py:239         Dec: -10.0 deg
D0327 00:27:49.563 mount.py:243         Park Coordinates RA-Dec: <SkyCoord (ICRS): (ra, dec) in deg
    ( 290.16895385, -10.)>
D0327 00:27:49.563 mount.py:266         Setting target coordinates: <SkyCoord (ICRS): (ra, dec) in deg
    ( 290.16895385, -10.)>
D0327 00:27:49.565 ioptron.py:322       RA (ms): 69640548.92458375 ms
D0327 00:27:49.565 ioptron.py:325       Dec (centiarcsec): -3600000.0 carcsec
D0327 00:27:51.068 ioptron.py:187       Slewing to park
D0327 00:28:11.653 mount.py:460         Mount unparked
D0327 00:28:12.154 mount.py:474         Move command: move_south
D0327 00:28:12.155 mount.py:478         Moving south for 11.0 seconds.
D0327 00:28:25.672 mount.py:483         13.51504099999481 seconds passed before stop
D0327 00:28:26.175 mount.py:485         14.018590999999248 seconds passed total
D0327 00:28:26.175 mount.py:493         Stopping movement
D0327 00:28:28.690 mount.py:368         Mount parked
I0327 00:28:45.094 messaging.py:134     PANCHAT I'm powering down
I0327 00:28:45.095 core.py:225          Shutting down POCS State Machine: , please be patient and allow for exit.
D0327 00:28:45.095 abstract_serial_dome.py:70 Already connected to dome
D0327 00:28:45.522 astrohaven.py:183    Got target_feedback, feedback_countdown=1
D0327 00:28:46.934 astrohaven.py:183    Got target_feedback, feedback_countdown=0
D0327 00:28:47.842 astrohaven.py:183    Got target_feedback, feedback_countdown=1
D0327 00:28:49.255 astrohaven.py:183    Got target_feedback, feedback_countdown=0
I0327 00:28:52.152 core.py:242          Mount is parked, setting Parked state
D0327 00:28:52.152 machine.py:209       Checking safety for set_park
D0327 00:28:52.152 machine.py:214       Always safe to move to set_park
D0327 00:28:52.153 machine.py:253       Before calling set_park from parking state
I0327 00:28:56.859 messaging.py:134     PANCHAT I'm parked now. Phew.
I0327 00:28:56.860 messaging.py:134     PANCHAT No observations found.
I0327 00:28:56.861 messaging.py:134     PANCHAT Going to stay parked for half an hour then will try again.
```

wtgee, 2018-05-07:
Tracing this down, it looks like it is giving an error while trying to write to the log file in the `rs232.disconnect()` method. Would the `__del__` be called after the log file is closed? @AnthonyHorton saw something similar with the SBIG cameras and the `__del__` dunder and eventually just removed the logging call.

@jamessynge You said this hung for 30 minutes after typing `exit`?

wtgee, 2019-08-25:
Closing as stale.

Closed 2019-08-25.

Thread 513 (2018-04-24):

Astrohaven driver opens the dome too far

jamessynge, 2018-04-24:
When I wrote the Astrohaven driver I found that it didn't always close fully, so I experimented with continuing to send the close command additional times once the limit switch was reached. This seemed to resolve the problem. I ended up putting this into the driver such that it had the same behavior for both opening and closing the dome. This seemed to work fine. Unfortunately I recently found that the dome wasn't closing one half properly. I found that continuing to drive the motor after that side was fully open had resulted in the strap coming off of the pulley driven by the motor, and thus when it tried to close the strap had become twisted.

I've concluded that the "real" fix to the original problem would have been to adjust the straps so that the dome was fully closed at the point when the limit switch is reached on each side of the dome. So, I need to remove the extra open commands immediately, and later may need to remove the extra close commands.

jamessynge, 2018-09-01:
Fixed by #514.

Closed 2018-09-01.

Thread 522 (2018-06-01):

Output the `pocs.say` messages to Twitter (and possibly more)

jeremylan, 2018-06-01:
This feature was suggested by @jamessynge on the forums, see the discussion here:

https://forum.projectpanoptes.org/t/help-getting-started/71

Something that is not critical but will be really useful would be the ability to send a tweet for each of the “say” messages that the software posts; these are intended for human consumption, such as “Parking the mount” or “Observing HAT-9”.

I created a simple Python script that uses the `PanMessaging` class to subscribe to the `PANCHAT` channel.

I used the Tweepy library (http://www.tweepy.org/) to output the messages on a Twitter account I have for development.

It would be good now to get a little more requirements for me to keep working at this i.e.

- stuff to put on a config file (i.e. Twitter API keys, channels to listen to, etc.)
- timeouts and how to create this process, i.e. an executable, a simple script to run via Python...
- should I also consider outputting to a Slack account?

Any suggestion welcome
Thanks

wtgee, 2018-06-01:
Awesome, thanks @jeremylan! Great that you are jumping in.

For another project that subclasses POCS I wanted to get the slack feature working. Turns out it was dead simple. I haven't yet put out a PR for that but you can see it [here](https://github.com/panoptes/POCS/blob/may-run/pocs/core.py#L185).

It would definitely be a little cleaner if it were hidden away within some kind of `PanMessaging` class as I'm imagining you've done. You could go ahead and put that slack code listed above alongside whatever you have done, which would allow you to test how to implement it in two different ways, which is nice. We're always happy to have a PR coming in!

The above code just assumes there is a `slack_webhook_url` in the config but obviously that will start to expand as we add things like twitter, youtube (timelapse movie upload), etc. We should create a  top-level config item (maybe `social_accounts`?) with sub-items such as api keys, url, etc.

Just a note, the config files are in `$POCS/conf_files`, with the main file being `pocs.yaml`. The loading of the config automatically supports a localized version, so anything in `$POCS/conf_files/pocs_local.yaml` will override the default config items.

Alternatively we could just have a separate config file (e.g. `$POCS/conf_files/social.yaml` - which also automatically supports `social_local.yaml`). This would then require a slight modification to how we construct a [`POCS`](https://github.com/panoptes/POCS/blob/develop/pocs/core.py#L19) instance by doing something like `pocs = POCS(config=['social'])` in the `pocs_shell`, but has the advantage of keeping the main config file clean of these somewhat optional features.

wtgee, 2018-06-01:
#28

jeremylan, 2018-06-02:
Hi @wtgee thanks for the reply

That's great, I'll work at my solution to integrate with the config files as you suggest and add both Twitter and Slack.

I'll then send you the PR for review, I'm just learning the system (& Python) so please bear with me, I am also working at this on my spare time so it may take a little while :)

If you have time, could you please have a quick look at the core dump error I get on my POCS installation? It only runs for a few minutes before quitting. Error details are on the forum thread.

Talk soon and thank you

wtgee, 2018-06-06:
Awesome, thanks @jeremylan ! I'll take a look at the PR. The logging is probably related to #393, which has been hard to pin down. I was doing some work in the last few days where I was seeing this as well. Something related to loading logging from an outside module before loading POCS. The `fileline` it refers to is the custom log formatting we do.

I'll get to PR in a few hours. Cheers!

jeremylan, 2018-06-06:
Ahhh yes @wtgee, definitely same issue as #393.

Glad it's not something I introduced ;P

Closed 2018-07-01.

Thread 527 (2018-06-30):

POCS stuck

jamessynge, 2018-06-30:
No observations by PAN006 for the last 9 days because POCS got confused during cleanup. Is this happening on PAN001?

This is not the first time this has happened. Makes me think that we might well want to have a noon restart daily. Thoughts?

```
D0620 07:53:45.870 observatory.py:238   Uploading directory to google cloud storage
D0620 07:53:58.708 observatory.py:241   Cleanup finished
D0620 07:53:58.708 observatory.py:222   Housekeeping for KIC 8462852: 120.0 s exposures in blocks of 10, minimum 60, priority 200
D0620 07:53:58.708 observatory.py:226   Cleanup for camera Cam00 [6575fc]
D0620 07:54:01.976 observatory.py:238   Uploading directory to google cloud storage
D0620 07:54:04.990 observatory.py:226   Cleanup for camera Cam01 [7bab97]
D0620 07:54:06.424 observatory.py:238   Uploading directory to google cloud storage
D0620 07:54:09.474 observatory.py:241   Cleanup finished
D0620 07:54:09.474 observatory.py:222   Housekeeping for KIC 8462852: 120.0 s exposures in blocks of 10, minimum 60, priority 200
D0620 07:54:09.474 observatory.py:226   Cleanup for camera Cam00 [6575fc]
D0620 07:54:12.505 observatory.py:238   Uploading directory to google cloud storage
D0620 07:54:15.149 observatory.py:226   Cleanup for camera Cam01 [7bab97]
D0620 07:54:16.361 observatory.py:238   Uploading directory to google cloud storage
D0620 07:54:19.021 observatory.py:241   Cleanup finished
D0620 07:54:19.021 observatory.py:222   Housekeeping for KIC 8462852: 120.0 s exposures in blocks of 10, minimum 60, priority 200
D0620 07:54:19.021 observatory.py:226   Cleanup for camera Cam00 [6575fc]
D0620 07:54:22.130 observatory.py:238   Uploading directory to google cloud storage
D0620 07:54:24.722 observatory.py:226   Cleanup for camera Cam01 [7bab97]
D0620 07:54:26.000 observatory.py:238   Uploading directory to google cloud storage
D0620 07:54:28.514 observatory.py:241   Cleanup finished
D0620 07:54:28.515 scheduler.py:202     Resetting observed list
I0620 07:54:28.516 messaging.py:134     PANCHAT Ok, I'm done cleaning up all the recorded data.
D0620 07:54:28.516 machine.py:267       After calling clean_up. Now in housekeeping state
D0620 07:54:28.518 machine.py:309       Source: housekeeping     Dest: sleeping
D0620 07:54:28.518 machine.py:171       Transition method: goto_sleep
D0620 07:54:28.519 machine.py:209       Checking safety for goto_sleep
D0620 07:54:28.519 machine.py:214       Always safe to move to goto_sleep
D0620 07:54:28.519 machine.py:253       Before calling goto_sleep from housekeeping state
I0620 07:54:33.291 messaging.py:134     PANCHAT Weather is good and it is dark. Something must have gone wrong. Stopping loop.
I0620 07:54:33.291 machine.py:181       Stopping POCS states
I0620 07:54:33.292 messaging.py:134     PANCHAT Another successful night!
D0620 07:54:33.292 machine.py:267       After calling goto_sleep. Now in sleeping state
```

wtgee, 2018-06-30:
The error is happening some time before the cleanup. It is then probably going through a number of the retries. Those retries should be getting reset every day but apparently aren't. Or you had a number of retries in a night. Can you post the full log for that run?

The restart idea has been discussed but I think we were waiting until after finishing all the dependency injection into the `Observation`. The idea was to keep some simple daemon (a `POCS` instance?) but to shut down everything else. This includes power down of components for the day.

A simple restart might be a good first step but I'd also like to figure out why it's happening and prevent it. However, it wouldn't be too hard to have a simple option that shuts it down in the day (like the `run_once` param).

jamessynge, 2018-07-04:
FWIW, I added a daily cron job to PAN006 that checks whether POCS has gotten stuck (ceased logging). If so, it reboots the system.

I agree that it would be great to fully diagnose this, but keeping the system up after it has gotten stuck isn't helping with that AFAICT.

wtgee, 2018-08-27:
@jamessynge can you post details about the cron job somewhere?

wtgee, 2019-08-25:
Closing as stale.

Closed 2019-08-25.

Thread 528 (2018-07-01):

plot_weather.py fails sometimes

jamessynge, 2018-07-01:
The latest weather plot on PAN006 is from yesterday morning, with more recent attempts failing with errors like this:

```
Creating weather plotter for 20180701UT
  Determining sunrise, sunset, and twilight times
  Retrieving data from Mongo database
  Retrieved 1040 entries between 2018-06-30T20:05:56.790000 and 2018-07-01T20:04:35.895000
  Setting up plot for time range: 2018-06-30T20:05:06.235139 to 2018-07-01T20:05:06.235139
  Will generate last hour plot for time range: 2018-07-01T19:05:06.235139 to 2018-07-01T20:10:06.235139
Plot Ambient Temperature vs. Time
Plot Temperature Difference vs. Time
Plot Wind Speed vs. Time
Plot Rain Frequency vs. Time
Plot Safe/Unsafe vs. Time
Plot PWM Value vs. Time
Saving Figure: /var/panoptes/weather_plots/today.png
Traceback (most recent call last):
  File "/var/panoptes/POCS/scripts/plot_weather.py", line 743, in <module>
    wp.make_plot(args.plot_file)
  File "/var/panoptes/POCS/scripts/plot_weather.py", line 117, in make_plot
    self.save_plot(plot_filename=output_file)
  File "/var/panoptes/POCS/scripts/plot_weather.py", line 704, in save_plot
    self.fig.savefig(plot_filename, dpi=self.dpi, bbox_inches='tight', pad_inches=0.10)
  File "/home/panoptes/anaconda3/envs/panoptes-env/lib/python3.6/site-packages/matplotlib/figure.py", line 1834, in savefig
    self.canvas.print_figure(fname, **kwargs)
  File "/home/panoptes/anaconda3/envs/panoptes-env/lib/python3.6/site-packages/matplotlib/backend_bases.py", line 2267, in print_figure
    **kwargs)
  File "/home/panoptes/anaconda3/envs/panoptes-env/lib/python3.6/site-packages/matplotlib/backends/backend_agg.py", line 507, in print_png
    FigureCanvasAgg.draw(self)
  File "/home/panoptes/anaconda3/envs/panoptes-env/lib/python3.6/site-packages/matplotlib/backends/backend_agg.py", line 422, in draw
    self.renderer = self.get_renderer(cleared=True)
  File "/home/panoptes/anaconda3/envs/panoptes-env/lib/python3.6/site-packages/matplotlib/backends/backend_agg.py", line 444, in get_renderer
    self.renderer = RendererAgg(w, h, self.figure.dpi)
  File "/home/panoptes/anaconda3/envs/panoptes-env/lib/python3.6/site-packages/matplotlib/backends/backend_agg.py", line 92, in __init__
    self._renderer = _RendererAgg(int(width), int(height), dpi, debug=False)
ValueError: Image size of 737170x915 pixels is too large. It must be less than 2^16 in each direction.
```

@wtgee Could you make suggestions as to how to proceed? matplotlib is not my top skill, but I'm guessing 700K pixels wide is a real no-no.

wtgee, 2018-07-01:
I've seen that error in the past when trying to remove the `bbox_inches='tight'` in favor of a `self.fig.tight_layout()`. But nothing has changed here recently so I don't think it would have to do with that.

I'm wondering if the range of values is somehow wrong. The date looks okay for one day. PAN001 consistently has 1041 or 1040 entries in that range.

Has matplotlib or numpy been updated recently? (Or I guess since this has been working)

wtgee, 2018-07-02:
Could easily be in our code but it's run without problems for a long time on PAN001. Has it ever worked reliably on your system?

jamessynge, 2018-07-02:
No, I don't think it has ever been reliable on PAN006.

On Sun, Jul 1, 2018 at 8:35 PM Wilfred Tyler Gee <notifications@github.com>
wrote:

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

wtgee, 2018-07-02:
You can try just removing the `bbox_inches='tight'` line (and/or the dpi) to see if that will at least make it work.

wtgee, 2018-07-04:
This was fixed via a recommendation here: https://github.com/matplotlib/matplotlib/issues/883/.

Namely, @jamessynge added `bbox_extra_artists` as in the following:
```
        self.fig.savefig(plot_filename, dpi=self.dpi,
                         bbox_inches="tight", bbox_extra_artists=[],
                         pad_inches=0.10)
```

Should create a PR for this.

wtgee, 2018-07-08:
I will test this on PAN001, where the plot was already working, and make sure it is consistent. Then let's get the one-word PR in. :)

Closed 2018-07-11.

Thread 529 (2018-07-06):

plot_weather.py should automatically select y-axis limits

jamessynge, 2018-07-06:
The annual temperature range in Massachusetts (home of PAN006) is fairly large, especially when you include both ground and sky temps. For ambient, the range in the last 6 months has been about 100F. This is vastly different than the situation experienced by PAN001, which has a much lower annual range.

plot_weather.py uses limits in peas.yaml, such as:
```
    plot:
        amb_temp_limits: [-5, 35]
        cloudiness_limits: [-45, 5]
        wind_limits: [0, 75]
        rain_limits: [700, 3200]
        pwm_limits: [-5, 105]
```
I propose that these limits be auto computed from some time range (e.g. just the data in the daily plot, or the last week, etc.).

wtgee, 2018-07-08:
The only worry with it being constantly re-computed would be that they would look inconsistent when just glancing from plot to plot, which could be annoying and/or misleading. The previous week would probably mitigate that.

The plot was all built by @joshwalawender, who may or may not have some advice on this.

More could change with this as well, e.g. for those of us who don't have an anemometer it would be nice to just not show the wind.

Thread 546 (2018-08-13):

Add support for distributed Cameras

AnthonyHorton, 2018-08-13:
Experience with the Huntsman Telescope has shown that running arrays of USB cameras from a single computer is unreliable. Consequently the Huntsman team have decided to follow the example of the Dragonfly Telescope and change to a distributed control system, with each camera being controlled by its own computer and a central control computer performing the observatory level tasks.

This requires additional features for POCS to support distributed operation. Fortunately the modular, object orientated structure of POCS provides an natural interface for the split, that between the `Observatory` object and the `Camera` object. What is required is a network layer between these objects.

AnthonyHorton, 2018-08-13:
There is, hopefully, significant overlap between the long term interests of PANOPTES and the short term needs of Huntsman, but arguably these are separate issues.

It sounds like what you're thinking of is a major rewrite of PANOPTES to turn it into robust, adaptive, and deeply distributed system, something I think we would all agree should be on the roadmap. On the other hand what I had in mind when opening this Issue was the absolute _minimum_ change required to enable cameras to be controlled by their own Raspberry Pi's (in our case Pi 3 B+'s). We should certainly try to make the latter a step along the path towards the former to avoid later duplication of effort, but that may not be practical.

It was a strong desire to limit the scope of the changes that lead me to start with Pyro in #547. It may not be the best solution long term, but it did offer the prospect of a workable solution with minimal changes to existing code. It makes it possible to address the Issue by adding additional optional functionality, rather than altering the existing architecture.

I see parallels here with the SBIG and FLI CCD cameras, and Birger Engineering and Optec focus controllers, which were added to POCS because Huntsman (and hopefully other projects, in the future) needed them.

jamessynge, 2018-08-13:
I'm happy to hear that you're assuming for the minimum change. The PR's
list of tasks done and in progress made it seem rather more significant
than you describe here. I'll take a look at it.

On Mon, Aug 13, 2018, 11:41 AM Anthony Horton <notifications@github.com>
wrote:

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

wtgee, 2018-08-13:
Agree with @AnthonyHorton, I don't think this introduces any major complications and puts some of the camera line in work with the long term road-map of decoupling the hardware from the `Observatory`, which was agreed on a long time ago as any first step toward moving to a more decentralized system.

@jamessynge I sent you the info on Pyro4 a few weeks back and mentioned that was the most likely option that was being looked at. It shouldn't be incompatible with indilib/indigo. And, I suppose I should point out, this *is* making an individual camera work with a Pi, and with far less effort than an immediate switch to something like indilib, which would not at all be practical right now.

Also @jamessynge you should not be having issues with the scheduler (I believe your system is out of date) and the other bug with slewing was also fixed within a day of it happening. If you are still having issues lets work on those in their respective Issue.

jamessynge, 2018-08-25:
Having reviewed the code, I can't say I'm that happy with the addition "as is". It seems to me that we will have two communication mechanisms: zeromq and pyro4. I'd feel better if we had clear API for communicating between components of the system, which includes:

- Scheduler / Planner
- Observatory Control (roughly the state machine for safely executing an observation)
- Sensors / Actuators
   - Weather / Environmental
   - Electrical / Mechanical (e.g. current, voltage or mount limit switches, and relays)
- Cameras / Focusers / Filters
- Mount
- Dome
- Data Storage (local and remote)
- Analysis (e.g. astrometry, which might be local, might be remote)
- Logging

Along with that, we'd need something like the ability to discover components, preferably dynamically to allow for devices being power-cycled or for software upgrades being applied. This probably means that having different levels of optionality: one of N cameras being missing is OK, while the weather station failing to respond is considered a safety hazard.

AnthonyHorton, 2018-08-26:
Yep. Well, as I noted in my first comment over in the PR:

> Huntsman needs this urgently. Thus I'm inclined to proceed in the meantime anyway, in order to get something working well enough that Huntsman can start using it. If review comes up with a better approach and none of this stuff ever gets merged that's fine, but we need something now.

So, I'm OK with this not making it into POCS if something better based on `zeromq` or INDI provides the functionality, though will naturally be disappointed given the amount of work I've had to put into it. In the absence of a better design I had to get on with it myself as best I can, which given the time constraints and my experience meant Pyro.

Shunting this over to `huntsman-pocs` works in as much as I don't think there would be any technical difficulties with doing so, and it solves the immediate problem for Huntsman. Really need to fix those private repo & Travis problems though, being unable to share the code or use CI makes `huntsman-pocs` a must less desirable home for my efforts than `POCS`.

jamessynge, 2018-08-26:
@AnthonyHorton I should have been clearer: I'm not happy, but I understand your need. We often have to take on technical debt to add necessary features, i.e. degrade our beloved architectural cleanliness. So, I can tolerate adding this feature, as long as we recognize the need to not continue to make it harder to evolve.

@wtgee What I'd like to see is that we immediately start gathering input on the weaknesses of our current code base w.r.t. communication, coupling, robustness and extensibility, and then use that to guide our discussion regarding evolving the architecture of POCS.

Regarding Indilib, I'm not arguing that we should *use* it, but rather that we should seriously *evaluate* it. Lots of folks have clearly put in a lot of effort developing it, and we have so few resources available for POCS that we shouldn't ignore the potential benefits of adopting Indilib (or Indigo or Skynet).

I also want to investigate what frameworks exist that we could exploit for achieving greater robustness, extensibility and looser coupling. I've not yet found something that seems super strong in the Python realm, but will do some more research.

Does that sound reasonable?

jamessynge, 2018-08-26:
Going rather off-topic...

Regarding Python, I don't love it as a choice for POCS simply because we find out about several classes of problems only at runtime (e.g. type mismatches and unknown symbols). Yet I recognize that Python is much more approachable for novice programmers than most compiled languages. This has led me to consider the benefits of POCS providing a framework written in a strongly typed language, but with extensibility with any language enabled via either a communication system like ZeroMQ, a protocol like HTTP (e.g. json RPCs) or even a simple unix pipe. This would allow schedulers and image analysis code to be in Python.

The advantage of an RPC like mechanism is that we don't have to do as much upfront design of our communications, and only need to focus on pair-wise contracts. OTOH, ZeroMQ, being more of a pub-sub system, seems better suited to a message-bus style. The latter can be very useful in that we don't need to know who the recipient of a message is, just what the format must be... which requires more planning.

gnthibault, 2018-08-30:
My 2 cents here (amateur astronomer). I was trying to design a POCS-like software (for fun/ learning experience) for some month now.
I found POCS while trying to look for a proper FSM support in python, and was really amazed by its features/the way it was written because it was very close to my ideal goal.

My new branch is now heavily inspired by POCS, and some of its files are just direct copies of it, please let me now if that is a problem/I should update some reference/licence files somewhere.
Implementing an Indi version of the mount control class from POCS, is in my TODO list, although I haven't started yet.

Anyway, I first started with my own classes for providing services (astrometry, weather...) and relying on Indi for driving other devices like mount/camera or focuser.

Of course, I am nowhere near something usable now (I don't have time constraint, it is a personal project), but you can find example of pyindi usage and other services here: https://github.com/gnthibault/RemoteObservatory/tree/NewScopeSimulator

An example of an indi mount class in python:
https://github.com/gnthibault/RemoteObservatory/blob/NewScopeSimulator/Mount/IndiMount.py

Example of Astrometry client (corrected with help from dustin Lang):
https://github.com/gnthibault/RemoteObservatory/blob/NewScopeSimulator/Service/NovaAstrometryService.py

Please let me know if you are interested in some feedback from me.

Regards

Thibault

jamessynge, 2018-09-16:
Thibault, thanks for your input. After reading it I decided to [post to our forum](https://forum.projectpanoptes.org/t/software-options-for-controlling-a-robotic-telescope/137) regarding the general topic of build/borrow/buy of this software. Perhaps you'd like to chime in?

Thread 548 (2018-08-14):

What is this code supposed to do

gnthibault, 2018-08-14:
Dear all,
Thank you very much for providing this software :) It looks like it fulfills most of my dreams about automated observatory.

I am somehow "auditing" the code in order to try to understand how it works, and I came across a few things that were not clear to me.
One of the class that troubles me the most is probably this one:
https://github.com/panoptes/POCS/blob/develop/pocs/state/machine.py

Because it builds a lot of strategies on top of pytransition, which in my opinion was already quite comprehensive in terms of functionalities. And it also rely on many undefined methods (defined in child class), without being defined as abstract.

Here is an example of a method that is not clear to me:
```
    def goto_next_state(self):
        state_changed = False

        # Get the next transition method based off `state` and `next_state`
        call_method = self._lookup_trigger()

        self.logger.debug("Transition method: {}".format(call_method))

        caller = getattr(self, call_method, 'park')
        state_changed = caller()
        self.db.insert_current('state', {"source": self.state, "dest": self.next_state})

        return state_changed
```
Why to we need a goto_next_state ? isn't the machinery of triggers from pytransition enough ? Why do we need to monitor wether the state has changed or not, cannot we use the before_state_change, or after_state_change callback system, that are called before or after every state change ?

It gets even more obscure to me at line 182, 183:

```
        caller = getattr(self, call_method, 'park')
        state_changed = caller()
```

I don't really understand what is this supposed to do ? In case call_method is not defined in self, we may end up trying to make a call on the string 'park', am I getting something wrong here ?

Sorry for all those question.
Thank you in advance for your help

gnthibault, 2018-08-28:
Thank you very much for your answer.
I have been reading more and more since I started, and it really feels like PANOPTES is an awesome source of information for someone that wants to launch (possibly any kind of) a robotic project.

Closed 2018-08-30.

Thread 556 (2018-08-25):

Assess ability to use gphoto2's liveview with Canon cameras

jamessynge, 2018-08-25:
gphoto2 supports liveview, i.e. streaming over USB to gphoto2 the video that would normally be shown on the LCD on the back of the camera. This could potentially enable:

- Instantaneous feedback about focus changes.
- Periodic error correction using the DSLR instead of a guide camera.
- Displaying the live sky view on PAWS.

And I'm sure some other activities (suggestions welcome).

This issue is simply about experimenting with the live view feature and determining whether we can reasonably get access to the frames from Python.

jamessynge, 2018-08-25:
In interesting thing to consider is adding a microcontroller speaking the ST4 guiding camera interface to the mount. For example:

- https://hackaday.io/project/4386-arduino-st4-telescope-control
   - Github repo: https://github.com/kevinferrare/arduino-st4
   - Indilib driver: https://github.com/tliff/indi_ardust4
- https://github.com/Gordon999/Pi-AutoGuider
- https://github.com/Gordon999/Arduino-Uno-AutoGuider

This might be useful both for PEC training of the iOptron, but also for tracking adjustments during exposures.

wtgee, 2018-08-25:
Nice additions. I think we would want to just consider support a standard guider as many amateurs might have an extra one already.

Also, based off the PAN012 performance we almost don't need it. :grin:  Very curious to see how additional units perform.

kmeagle1515, 2019-03-22:
Hello sir!
Involving a rpi will lower the fps, but if the camera is directly connected with the monitor then more fps will be available. So what exactly you want to tryout?

wtgee, 2019-03-25:
> Hello sir!
> Involving a rpi will lower the fps, but if the camera is directly connected with the monitor then more fps will be available(comparatively). So what exactly you want to tryout?

Not sure if @jamessynge had thoughts on this, but for a guide scope the 25-30 fps should be okay. It would probably require a dedicated pi rather than using the pi that is also controlling the system.

This issue is mostly just a test idea, not something that we need or are looking at necessarily implementing right away.

wtgee, 2024-03-28:
This isn't well defined and a bit stale so I'm closing for now. There has been some conversation about using the liveview for focusing but a new specific issue should be created for that.

Closed 2024-03-28.

Thread 572 (2018-08-31):

test_run_power_down_interrupt (test_pocs.py) is failing at HEAD

jamessynge, 2018-08-31:
I've updated recently to the latest requirements, after which tests passed. Now I'm finding that several tests are failing including test_run_power_down_interrupt, which fails for all Db types. Here is the test failure:

```
    def test_run_power_down_interrupt(observatory):
        def start_pocs():
            observatory.logger.info('start_pocs ENTER')
            pocs = POCS(observatory, messaging=True)
            pocs.initialize()
            pocs.observatory.scheduler.clear_available_observations()
            pocs.observatory.scheduler.add_observation({'name': 'KIC 8462852',
                                                        'position': '20h06m15.4536s +44d27m24.75s',
                                                        'priority': '100',
                                                        'exp_time': 2,
                                                        'min_nexp': 2,
                                                        'exp_set_size': 2,
                                                        })
            pocs.logger.info('Starting observatory run')
            pocs.run()
            pocs.power_down()
            observatory.logger.info('start_pocs EXIT')

        pocs_thread = threading.Thread(target=start_pocs)
        pocs_thread.start()

        pub = PanMessaging.create_publisher(6500)
        sub = PanMessaging.create_subscriber(6511)

        try:
            assert wait_for_state(sub, 'scheduling')
        finally:
            pub.send_message('POCS-CMD', 'shutdown')
            pocs_thread.join(timeout=30)

>       assert pocs_thread.is_alive() is False
E       assert True is False
E        +  where True = <bound method Thread.is_alive of <Thread(Thread-1, started 139838593120000)>>()
E        +    where <bound method Thread.is_alive of <Thread(Thread-1, started 139838593120000)>> = <Thread(Thread-1, started 139838593120000)>.is_alive

pocs/tests/test_pocs.py:401: AssertionError
```
And here is the captured log:
```
------------------------------------------------------------- Captured log setup --------------------------------------------------------------
observatory.py              37 INFO     Initializing observatory
observatory.py              40 INFO     	Setting up location
observatory.py             515 DEBUG    Setting up site details of observatory
observatory.py             545 DEBUG    Location: {'name': 'Mauna Loa Observatory', 'latitude': <Quantity 19.54 deg>, 'longitude': <Quantity -155.58 deg>, 'elevation': <Quantity 3400. m>, 'timezone': 'US/Hawaii', 'utc_offset': -10.0, 'pressure': <Quantity 0.68 bar>, 'horizon': <Quantity 30. deg>, 'twilight_horizon': <Quantity -18. deg>}
observatory.py              46 INFO     	Setting up mount
observatory.py             599 DEBUG    Creating mount: simulator
mount.py                    47 DEBUG    Mount config: {'brand': 'ioptron', 'model': 30, 'driver': 'ioptron', 'serial': {'port': '/dev/ttyUSB0', 'timeout': 0.0, 'baudrate': 9600}, 'non_sidereal_available': True, 'simulator': True}
mount.py                    50 DEBUG    Setting up commands for mount
mount.py                    54 DEBUG    Mount commands set up
simulator.py                22 INFO     		Using simulator mount
mount.py                   228 DEBUG    Setting park position
mount.py                   234 DEBUG    LST: 3.5397173562417787 hourangle
mount.py                   235 DEBUG    HA: -170.0 deg
mount.py                   238 DEBUG    RA: 14.873050689575114 hourangle
mount.py                   239 DEBUG    Dec: -10.0 deg
mount.py                   243 DEBUG    Park Coordinates RA-Dec: <SkyCoord (ICRS): (ra, dec) in deg
    (223.09576034, -10.)>
simulator.py                29 DEBUG    Simulator mount created
observatory.py             606 DEBUG    Mount created
observatory.py              50 INFO     	Setting up cameras
observatory.py             638 DEBUG    Camera config:
 {'auto_detect': True, 'primary': '14d3bd', 'devices': [{'model': 'canon_gphoto2'}, {'model': 'canon_gphoto2'}]}
observatory.py             642 DEBUG    Using simulator for camera
observatory.py             703 DEBUG    Creating camera: simulator
observatory.py             707 DEBUG    Camera module: <module 'pocs.camera.simulator' from '/home/james/git/panoptes/POCS/pocs/camera/simulator.py'>
focuser.py                 105 DEBUG    Focuser created: Simulated Focuser on /dev/ttyFAKE
simulator.py                17 DEBUG    Initialising simulator focuser
simulator.py                34 DEBUG    Connected to focuser SF4032
simulator.py                19 INFO     Simulated Focuser (SF4032) on /dev/ttyFAKE initialised
camera.py                   72 DEBUG    Focuser created: Simulated Focuser (SF4032) on /dev/ttyFAKE
camera.py                   82 DEBUG    Camera created: Cam00
simulator.py                20 DEBUG    Initializing simulated camera
simulator.py                32 DEBUG    Cam00 connected
observatory.py             726 DEBUG    Camera created: Cam00 SC5245
observatory.py             703 DEBUG    Creating camera: simulator
observatory.py             707 DEBUG    Camera module: <module 'pocs.camera.simulator' from '/home/james/git/panoptes/POCS/pocs/camera/simulator.py'>
focuser.py                 105 DEBUG    Focuser created: Simulated Focuser on /dev/ttyFAKE
simulator.py                17 DEBUG    Initialising simulator focuser
simulator.py                34 DEBUG    Connected to focuser SF6202
simulator.py                19 INFO     Simulated Focuser (SF6202) on /dev/ttyFAKE initialised
camera.py                   72 DEBUG    Focuser created: Simulated Focuser (SF6202) on /dev/ttyFAKE
camera.py                   82 DEBUG    Camera created: Cam01
simulator.py                20 DEBUG    Initializing simulated camera
simulator.py                32 DEBUG    Cam01 connected
observatory.py             726 DEBUG    Camera created: Cam01 SC6253
observatory.py             738 DEBUG    Cameras created
__init__.py                 19 INFO     No dome in config.
observatory.py              59 INFO     	Setting up scheduler
observatory.py             750 DEBUG    Creating scheduler: /var/panoptes/POCS/resources/targets/simple.yaml
scheduler.py               254 DEBUG    Reading fields from file: /var/panoptes/POCS/resources/targets/simple.yaml
scheduler.py               224 DEBUG    Adding Kepler 1100 to scheduler
observation.py              76 DEBUG    Observation created: Kepler 1100: 120.0 s exposures in blocks of 10, minimum 60, priority 125
scheduler.py               224 DEBUG    Adding KIC 8462852 to scheduler
observation.py              76 DEBUG    Observation created: KIC 8462852: 120.0 s exposures in blocks of 10, minimum 60, priority 200
scheduler.py               224 DEBUG    Adding HD 23630 to scheduler
observation.py              76 DEBUG    Observation created: HD 23630: 120.0 s exposures in blocks of 10, minimum 60, priority 100
scheduler.py               224 DEBUG    Adding HD 189733 to scheduler
observation.py              76 DEBUG    Observation created: HD 189733: 100.0 s exposures in blocks of 10, minimum 60, priority 105
scheduler.py               224 DEBUG    Adding HD 209458 to scheduler
observation.py              76 DEBUG    Observation created: HD 209458: 120.0 s exposures in blocks of 10, minimum 60, priority 100
scheduler.py               224 DEBUG    Adding Wasp 140 to scheduler
observation.py              76 DEBUG    Observation created: Wasp 140: 120.0 s exposures in blocks of 10, minimum 60, priority 100
scheduler.py               224 DEBUG    Adding Wasp 104 to scheduler
observation.py              76 DEBUG    Observation created: Wasp 104: 120.0 s exposures in blocks of 10, minimum 60, priority 100
scheduler.py               224 DEBUG    Adding Wasp 44 to scheduler
observation.py              76 DEBUG    Observation created: Wasp 44: 120.0 s exposures in blocks of 10, minimum 60, priority 100
scheduler.py               224 DEBUG    Adding Wasp 2 to scheduler
observation.py              76 DEBUG    Observation created: Wasp 2: 120.0 s exposures in blocks of 10, minimum 60, priority 100
scheduler.py               224 DEBUG    Adding Wasp 24 to scheduler
observation.py              76 DEBUG    Observation created: Wasp 24: 120.0 s exposures in blocks of 10, minimum 60, priority 100
scheduler.py               224 DEBUG    Adding Wasp 77 to scheduler
observation.py              76 DEBUG    Observation created: Wasp 77: 120.0 s exposures in blocks of 10, minimum 60, priority 100
scheduler.py               224 DEBUG    Adding Wasp 33 to scheduler
observation.py              76 DEBUG    Observation created: Wasp 33: 120.0 s exposures in blocks of 10, minimum 60, priority 100
scheduler.py               224 DEBUG    Adding Wasp 43 to scheduler
observation.py              76 DEBUG    Observation created: Wasp 43: 120.0 s exposures in blocks of 10, minimum 60, priority 100
scheduler.py               224 DEBUG    Adding Wasp 36 to scheduler
observation.py              76 DEBUG    Observation created: Wasp 36: 120.0 s exposures in blocks of 10, minimum 60, priority 100
scheduler.py               224 DEBUG    Adding Wasp 11 to scheduler
observation.py              76 DEBUG    Observation created: Wasp 11: 120.0 s exposures in blocks of 10, minimum 60, priority 100
scheduler.py               224 DEBUG    Adding Wasp 35 to scheduler
observation.py              76 DEBUG    Observation created: Wasp 35: 120.0 s exposures in blocks of 10, minimum 60, priority 100
scheduler.py               224 DEBUG    Adding HAT-P-20 to scheduler
observation.py              76 DEBUG    Observation created: HAT-P-20: 120.0 s exposures in blocks of 10, minimum 60, priority 100
scheduler.py               224 DEBUG    Adding Qatar-1 to scheduler
observation.py              76 DEBUG    Observation created: Qatar-1: 120.0 s exposures in blocks of 10, minimum 60, priority 100
scheduler.py               224 DEBUG    Adding Qatar-2 to scheduler
observation.py              76 DEBUG    Observation created: Qatar-2: 120.0 s exposures in blocks of 10, minimum 60, priority 100
scheduler.py               224 DEBUG    Adding Tres 3 to scheduler
observation.py              76 DEBUG    Observation created: Tres 3: 120.0 s exposures in blocks of 10, minimum 60, priority 100
scheduler.py               224 DEBUG    Adding EPIC-211089792 to scheduler
observation.py              76 DEBUG    Observation created: EPIC-211089792: 120.0 s exposures in blocks of 10, minimum 60, priority 100
scheduler.py               224 DEBUG    Adding HAT-P-1 to scheduler
observation.py              76 DEBUG    Observation created: HAT-P-1: 120.0 s exposures in blocks of 10, minimum 60, priority 100
scheduler.py               224 DEBUG    Adding HAT-P-12 to scheduler
observation.py              76 DEBUG    Observation created: HAT-P-12: 120.0 s exposures in blocks of 10, minimum 60, priority 100
scheduler.py               224 DEBUG    Adding HAT-P-30 to scheduler
observation.py              76 DEBUG    Observation created: HAT-P-30: 120.0 s exposures in blocks of 10, minimum 60, priority 100
scheduler.py               224 DEBUG    Adding HAT-P-36 to scheduler
observation.py              76 DEBUG    Observation created: HAT-P-36: 120.0 s exposures in blocks of 10, minimum 60, priority 100
scheduler.py               224 DEBUG    Adding HAT-P-37 to scheduler
observation.py              76 DEBUG    Observation created: HAT-P-37: 120.0 s exposures in blocks of 10, minimum 60, priority 100
scheduler.py               224 DEBUG    Adding M42 to scheduler
observation.py              76 DEBUG    Observation created: M42: 120.0 s exposures in blocks of 5, minimum 10, priority 75
scheduler.py               224 DEBUG    Adding M44 to scheduler
observation.py              76 DEBUG    Observation created: M44: 120.0 s exposures in blocks of 10, minimum 60, priority 50
scheduler.py               224 DEBUG    Adding M45 to scheduler
observation.py              76 DEBUG    Observation created: M45: 120.0 s exposures in blocks of 10, minimum 60, priority 50
scheduler.py               224 DEBUG    Adding M5 to scheduler
observation.py              76 DEBUG    Observation created: M5: 120.0 s exposures in blocks of 10, minimum 60, priority 50
scheduler.py               224 DEBUG    Adding CoRoT-18 to scheduler
observation.py              76 DEBUG    Observation created: CoRoT-18: 120.0 s exposures in blocks of 10, minimum 60, priority 100
observatory.py             777 DEBUG    Scheduler created
observatory.py              66 INFO     	 Observatory initialized
-------------------------------------------------------------- Captured log call --------------------------------------------------------------
test_pocs.py               373 INFO     start_pocs ENTER
messaging.py                69 DEBUG    Creating publisher. Binding to port 6500
messaging.py                92 DEBUG    Creating subscriber. Port: 6511 	Channel:
core.py                     62 INFO     Initializing PANOPTES unit - Generic PANOPTES Unit - Mauna Loa Observatory
messaging.py                69 DEBUG    Creating publisher. Binding to port 6510
core.py                    566 DEBUG    Starting command message loop
core.py                    571 DEBUG    Command message subscriber set up on port 6500
machine.py                  29 INFO     Loading state table: simple_state_table
machine.py                 404 DEBUG    Loading transition: {'source': ['ready', 'scheduling', 'slewing', 'pointing', 'tracking', 'observing', 'analyzing'], 'dest': 'parking', 'trigger': 'park'}
machine.py                 412 DEBUG    Returning transition: {'source': ['ready', 'scheduling', 'slewing', 'pointing', 'tracking', 'observing', 'analyzing'], 'dest': 'parking', 'trigger': 'park', 'conditions': ['check_safety']}
machine.py                 404 DEBUG    Loading transition: {'source': 'parking', 'dest': 'parked', 'trigger': 'set_park'}
machine.py                 412 DEBUG    Returning transition: {'source': 'parking', 'dest': 'parked', 'trigger': 'set_park', 'conditions': ['check_safety']}
machine.py                 404 DEBUG    Loading transition: {'source': 'parked', 'dest': 'housekeeping', 'trigger': 'clean_up'}
machine.py                 412 DEBUG    Returning transition: {'source': 'parked', 'dest': 'housekeeping', 'trigger': 'clean_up', 'conditions': ['check_safety']}
machine.py                 404 DEBUG    Loading transition: {'source': 'housekeeping', 'dest': 'sleeping', 'trigger': 'goto_sleep'}
machine.py                 412 DEBUG    Returning transition: {'source': 'housekeeping', 'dest': 'sleeping', 'trigger': 'goto_sleep', 'conditions': ['check_safety']}
machine.py                 404 DEBUG    Loading transition: {'source': 'parked', 'dest': 'ready', 'trigger': 'get_ready', 'conditions': 'mount_is_initialized'}
machine.py                 412 DEBUG    Returning transition: {'source': 'parked', 'dest': 'ready', 'trigger': 'get_ready', 'conditions': ['check_safety', 'mount_is_initialized']}
machine.py                 404 DEBUG    Loading transition: {'source': 'sleeping', 'dest': 'ready', 'trigger': 'get_ready', 'conditions': 'mount_is_initialized'}
machine.py                 412 DEBUG    Returning transition: {'source': 'sleeping', 'dest': 'ready', 'trigger': 'get_ready', 'conditions': ['check_safety', 'mount_is_initialized']}
machine.py                 404 DEBUG    Loading transition: {'source': 'ready', 'dest': 'scheduling', 'trigger': 'schedule'}
machine.py                 412 DEBUG    Returning transition: {'source': 'ready', 'dest': 'scheduling', 'trigger': 'schedule', 'conditions': ['check_safety']}
machine.py                 404 DEBUG    Loading transition: {'source': 'analyzing', 'dest': 'scheduling', 'trigger': 'schedule'}
machine.py                 412 DEBUG    Returning transition: {'source': 'analyzing', 'dest': 'scheduling', 'trigger': 'schedule', 'conditions': ['check_safety']}
machine.py                 404 DEBUG    Loading transition: {'source': 'scheduling', 'dest': 'slewing', 'trigger': 'start_slewing'}
machine.py                 412 DEBUG    Returning transition: {'source': 'scheduling', 'dest': 'slewing', 'trigger': 'start_slewing', 'conditions': ['check_safety']}
machine.py                 404 DEBUG    Loading transition: {'source': 'scheduling', 'dest': 'tracking', 'trigger': 'adjust_tracking'}
machine.py                 412 DEBUG    Returning transition: {'source': 'scheduling', 'dest': 'tracking', 'trigger': 'adjust_tracking', 'conditions': ['check_safety']}
machine.py                 404 DEBUG    Loading transition: {'source': 'slewing', 'dest': 'pointing', 'trigger': 'adjust_pointing', 'conditions': 'mount_is_tracking'}
machine.py                 412 DEBUG    Returning transition: {'source': 'slewing', 'dest': 'pointing', 'trigger': 'adjust_pointing', 'conditions': ['check_safety', 'mount_is_tracking']}
machine.py                 404 DEBUG    Loading transition: {'source': 'pointing', 'dest': 'slewing', 'trigger': 'start_slewing', 'conditions': 'mount_is_tracking'}
machine.py                 412 DEBUG    Returning transition: {'source': 'pointing', 'dest': 'slewing', 'trigger': 'start_slewing', 'conditions': ['check_safety', 'mount_is_tracking']}
machine.py                 404 DEBUG    Loading transition: {'source': 'pointing', 'dest': 'tracking', 'trigger': 'track', 'conditions': 'mount_is_tracking'}
machine.py                 412 DEBUG    Returning transition: {'source': 'pointing', 'dest': 'tracking', 'trigger': 'track', 'conditions': ['check_safety', 'mount_is_tracking']}
machine.py                 404 DEBUG    Loading transition: {'source': 'tracking', 'dest': 'observing', 'trigger': 'observe', 'conditions': 'mount_is_tracking'}
machine.py                 412 DEBUG    Returning transition: {'source': 'tracking', 'dest': 'observing', 'trigger': 'observe', 'conditions': ['check_safety', 'mount_is_tracking']}
machine.py                 404 DEBUG    Loading transition: {'source': 'observing', 'dest': 'analyzing', 'trigger': 'analyze'}
machine.py                 412 DEBUG    Returning transition: {'source': 'observing', 'dest': 'analyzing', 'trigger': 'analyze', 'conditions': ['check_safety']}
machine.py                 404 DEBUG    Loading transition: {'source': 'observing', 'dest': 'observing', 'trigger': 'observe', 'conditions': 'mount_is_tracking'}
machine.py                 412 DEBUG    Returning transition: {'source': 'observing', 'dest': 'observing', 'trigger': 'observe', 'conditions': ['check_safety', 'mount_is_tracking']}
machine.py                 404 DEBUG    Loading transition: {'source': 'analyzing', 'dest': 'tracking', 'trigger': 'adjust_tracking', 'conditions': 'mount_is_tracking'}
machine.py                 412 DEBUG    Returning transition: {'source': 'analyzing', 'dest': 'tracking', 'trigger': 'adjust_tracking', 'conditions': ['check_safety', 'mount_is_tracking']}
machine.py                 370 DEBUG    Loading state: parked
machine.py                 380 DEBUG    Checking <module 'pocs.state.states.default.parked' from '/home/james/git/panoptes/POCS/pocs/state/states/default/parked.py'>
machine.py                 386 DEBUG    Added `on_enter` method from <module 'pocs.state.states.default.parked' from '/home/james/git/panoptes/POCS/pocs/state/states/default/parked.py'> <function on_enter at 0x7f2ebe154a60>
machine.py                 388 DEBUG    Created state
machine.py                 370 DEBUG    Loading state: sleeping
machine.py                 380 DEBUG    Checking <module 'pocs.state.states.default.sleeping' from '/home/james/git/panoptes/POCS/pocs/state/states/default/sleeping.py'>
machine.py                 386 DEBUG    Added `on_enter` method from <module 'pocs.state.states.default.sleeping' from '/home/james/git/panoptes/POCS/pocs/state/states/default/sleeping.py'> <function on_enter at 0x7f2ebe154b70>
machine.py                 388 DEBUG    Created state
machine.py                 370 DEBUG    Loading state: housekeeping
machine.py                 380 DEBUG    Checking <module 'pocs.state.states.default.housekeeping' from '/home/james/git/panoptes/POCS/pocs/state/states/default/housekeeping.py'>
machine.py                 386 DEBUG    Added `on_enter` method from <module 'pocs.state.states.default.housekeeping' from '/home/james/git/panoptes/POCS/pocs/state/states/default/housekeeping.py'> <function on_enter at 0x7f2ebe154bf8>
machine.py                 388 DEBUG    Created state
machine.py                 370 DEBUG    Loading state: ready
machine.py                 380 DEBUG    Checking <module 'pocs.state.states.default.ready' from '/home/james/git/panoptes/POCS/pocs/state/states/default/ready.py'>
machine.py                 386 DEBUG    Added `on_enter` method from <module 'pocs.state.states.default.ready' from '/home/james/git/panoptes/POCS/pocs/state/states/default/ready.py'> <function on_enter at 0x7f2ebe154c80>
machine.py                 388 DEBUG    Created state
machine.py                 370 DEBUG    Loading state: scheduling
machine.py                 380 DEBUG    Checking <module 'pocs.state.states.default.scheduling' from '/home/james/git/panoptes/POCS/pocs/state/states/default/scheduling.py'>
machine.py                 386 DEBUG    Added `on_enter` method from <module 'pocs.state.states.default.scheduling' from '/home/james/git/panoptes/POCS/pocs/state/states/default/scheduling.py'> <function on_enter at 0x7f2ebe154d08>
machine.py                 388 DEBUG    Created state
machine.py                 370 DEBUG    Loading state: slewing
machine.py                 380 DEBUG    Checking <module 'pocs.state.states.default.slewing' from '/home/james/git/panoptes/POCS/pocs/state/states/default/slewing.py'>
machine.py                 386 DEBUG    Added `on_enter` method from <module 'pocs.state.states.default.slewing' from '/home/james/git/panoptes/POCS/pocs/state/states/default/slewing.py'> <function on_enter at 0x7f2ebe154d90>
machine.py                 388 DEBUG    Created state
machine.py                 370 DEBUG    Loading state: pointing
machine.py                 380 DEBUG    Checking <module 'pocs.state.states.default.pointing' from '/home/james/git/panoptes/POCS/pocs/state/states/default/pointing.py'>
machine.py                 386 DEBUG    Added `on_enter` method from <module 'pocs.state.states.default.pointing' from '/home/james/git/panoptes/POCS/pocs/state/states/default/pointing.py'> <function on_enter at 0x7f2ebe154ea0>
machine.py                 388 DEBUG    Created state
machine.py                 370 DEBUG    Loading state: tracking
machine.py                 380 DEBUG    Checking <module 'pocs.state.states.default.tracking' from '/home/james/git/panoptes/POCS/pocs/state/states/default/tracking.py'>
machine.py                 386 DEBUG    Added `on_enter` method from <module 'pocs.state.states.default.tracking' from '/home/james/git/panoptes/POCS/pocs/state/states/default/tracking.py'> <function on_enter at 0x7f2ebd4d9048>
machine.py                 388 DEBUG    Created state
machine.py                 370 DEBUG    Loading state: observing
machine.py                 380 DEBUG    Checking <module 'pocs.state.states.default.observing' from '/home/james/git/panoptes/POCS/pocs/state/states/default/observing.py'>
machine.py                 386 DEBUG    Added `on_enter` method from <module 'pocs.state.states.default.observing' from '/home/james/git/panoptes/POCS/pocs/state/states/default/observing.py'> <function on_enter at 0x7f2ebd4d9158>
machine.py                 388 DEBUG    Created state
machine.py                 370 DEBUG    Loading state: analyzing
machine.py                 380 DEBUG    Checking <module 'pocs.state.states.default.analyzing' from '/home/james/git/panoptes/POCS/pocs/state/states/default/analyzing.py'>
machine.py                 386 DEBUG    Added `on_enter` method from <module 'pocs.state.states.default.analyzing' from '/home/james/git/panoptes/POCS/pocs/state/states/default/analyzing.py'> <function on_enter at 0x7f2ebd4d91e0>
machine.py                 388 DEBUG    Created state
machine.py                 370 DEBUG    Loading state: parking
machine.py                 380 DEBUG    Checking <module 'pocs.state.states.default.parking' from '/home/james/git/panoptes/POCS/pocs/state/states/default/parking.py'>
machine.py                 386 DEBUG    Added `on_enter` method from <module 'pocs.state.states.default.parking' from '/home/james/git/panoptes/POCS/pocs/state/states/default/parking.py'> <function on_enter at 0x7f2ebd4d9268>
machine.py                 388 DEBUG    Created state
machine.py                  63 DEBUG    State machine created
messaging.py               134 INFO     PANCHAT Hi there!
core.py                    138 INFO     ********************************************************************************
messaging.py               134 INFO     PANCHAT Initializing the system! Woohoo!
core.py                    142 DEBUG    Initializing observatory
observatory.py             116 DEBUG    Initializing mount
simulator.py                55 DEBUG    Initializing simulator mount
simulator.py                69 DEBUG    Connecting to mount simulator
simulator.py               209 DEBUG    Setting up mount for location
simulator.py                79 DEBUG    Getting mount simulator status
scheduler.py               116 INFO     Setting new observation to None
scheduler.py               224 DEBUG    Adding KIC 8462852 to scheduler
observation.py              76 DEBUG    Observation created: KIC 8462852: 2.0 s exposures in blocks of 2, minimum 2, priority 100
test_pocs.py               384 INFO     Starting observatory run
observatory.py              81 DEBUG    Sun -12.62 deg > -18.0 deg
core.py                    335 DEBUG    Dark Check: True
core.py                    350 DEBUG    Checking weather safety
core.py                    357 DEBUG    Weather simulator always safe
machine.py                 330 DEBUG    Source: sleeping	 Dest: ready
machine.py                 192 DEBUG    Transition method: get_ready
machine.py                 230 DEBUG    Checking safety for get_ready
machine.py                 235 DEBUG    Always safe to move to get_ready
machine.py                 274 DEBUG    Before calling get_ready from sleeping state
simulator.py                79 DEBUG    Getting mount simulator status
messaging.py               134 INFO     PANCHAT Ok, I'm all set up and ready to go!
simulator.py               178 DEBUG    Unparking mount
machine.py                 288 DEBUG    After calling get_ready. Now in ready state
machine.py                 330 DEBUG    Source: ready	 Dest: scheduling
machine.py                 192 DEBUG    Transition method: schedule
machine.py                 230 DEBUG    Checking safety for schedule
observatory.py              81 DEBUG    Sun -12.62 deg > -18.0 deg
core.py                    335 DEBUG    Dark Check: True
core.py                    350 DEBUG    Checking weather safety
core.py                    357 DEBUG    Weather simulator always safe
machine.py                 274 DEBUG    Before calling schedule from ready state
simulator.py                79 DEBUG    Getting mount simulator status
messaging.py               134 INFO     PANCHAT Ok, I'm finding something good to look at...
observatory.py             185 DEBUG    Getting observation for observatory
dispatch.py                 56 INFO     Checking Constraint: Altitude
dispatch.py                 59 DEBUG    	Observation: KIC 8462852
constraint.py               61 DEBUG    		Below minimum altitude: -0.61 < 30.00
dispatch.py                 64 DEBUG    		Score: 0.00000	Veto: True
dispatch.py                 67 DEBUG    		KIC 8462852 vetoed by Altitude
dispatch.py                 56 INFO     Checking Constraint: Moon Avoidance
dispatch.py                 56 INFO     Checking Constraint: Duration above 30.0 deg
scheduler.py               116 INFO     Setting new observation to None
error.py                    18 ERROR    NoObservation: No valid observations found
messaging.py               134 INFO     PANCHAT No valid observations found. Can't schedule. Going to park.
machine.py                 288 DEBUG    After calling schedule. Now in scheduling state
core.py                    494 INFO     Message received: command shutdown
core.py                    511 WARNING  Shutdown command received
messaging.py               134 INFO     PANCHAT I'm powering down
core.py                    224 INFO     Shutting down POCS State Machine: , please be patient and allow for exit.
core.py                    235 INFO     Parking mount
machine.py                 230 DEBUG    Checking safety for park
machine.py                 235 DEBUG    Always safe to move to park
machine.py                 274 DEBUG    Before calling park from scheduling state
simulator.py                79 DEBUG    Getting mount simulator status
scheduler.py               116 INFO     Setting new observation to None
messaging.py               134 INFO     PANCHAT I'm takin' it on home and then parking.
simulator.py               160 DEBUG    Slewing to home
simulator.py               137 DEBUG    Stopping slewing
simulator.py               148 DEBUG    Setting next position to _is_home
simulator.py                55 DEBUG    Initializing simulator mount
simulator.py               209 DEBUG    Setting up mount for location
simulator.py               170 DEBUG    Setting to park
mount.py                   486 DEBUG    Mount parked
machine.py                 288 DEBUG    After calling park. Now in parking state
core.py                    241
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

Thread 576 (2018-09-01):

Reconsider supervisord

jamessynge, 2018-09-01:
#26 proposed using supervisord, but was closed. I wrote scripts (POCS/scripts/startup) for starting things inside a tmux session, but without the benefits of supervisord, i.e. no automatic restarting, no easy control such as stop all/selected and start all/selected. We should reconsider this "choice". Note that I'm not certain that supervisord is the perfect choice, but it is better than taking the time to write this feature ourselves.

Supervisord is appropriate for programs that do not have any command-line interaction, i.e. not our current shells, which do essentially all of the work of POCS; the exceptions are the messaging hub, social messaging script and PAWS, and for Huntsman the nameserver, etc. Those exceptions could be moved immediately to be run by supervisord, and overtime we can consider how to move more of the POCS system to run under supervisord.

@wtgee @AnthonyHorton Your opinions would be appreciated.

wtgee, 2018-09-01:
Adding @joshwalawender as the original suggestion to use supervisord was his as I believe he used it for a few projects so might have opinion.

Regarding the POCS shell, I think we (soon) should move to making the shell independent from the running process. Initially I was just going to `subprocess` the `pocs` instance (or something to that effect), but we could split it out entirely and control it via supervisord.

Sometimes I go back and forth on whether I do want automatic start-up after something like a power failure or if it should in some sense include a human sanity check on the unit first. But I suppose there is still a case for supervisord starting and running things once given that go-ahead.

wtgee, 2020-02-17:
Will be impacted by #951

wtgee, 2020-06-14:
Closing as stale.

Closed 2020-06-14.

Thread 587 (2018-09-09):

Change *Dome.status to be a method

jamessynge, 2018-09-09:
As per https://github.com/panoptes/POCS/issues/189#issuecomment-354240479, status should be a method, not a property.

jamessynge, 2018-09-15:
@wtgee What should the return type be for status()? The property I added for the Astrohaven dome support is a string (e.g. "Open" or "Closed"). Most of the status() methods are returning dictionaries. Any thought on what should be done for the dome status?

wtgee, 2018-09-15:
I think we should do dictionaries so they are machine-readable in some sense. I think we will also have more than one status variable, e.g. battery level (if applicable, Huntsman has), parked status, connected, etc.

jamessynge, 2018-09-15:
In that case, it would help if we had some "standard" for what the various dictionaries should contain; for example, for status from a dome, should the dict contain the brand, model and driver (roughly a repeat of the data in the config)? That would allow the old config to be visible in logged status dicts (e.g. when examining the info saved along with the images of an observation).

Does huntsman have a standard for this already? dome/bisque.py has status as a property, but I'm not sure what the value type is.

jamessynge, 2018-09-15:
It looks like getting the value of Dome.status from dome/bisque.py will fail because it references a resource file `dome/status.py` that doesn't exist in the POCS repo.

@AnthonyHorton Do I have this correct?

wtgee, 2020-06-01:
Closed by #951. All hardware should have a status property now.

Closed 2020-06-01.

Thread 597 (2018-09-16):

Switch 'channel' and 'msg_type' to 'topic'

jamessynge, 2018-09-16:
There are three names for 'topic'. Let's have just one.
@wtgee Let me know if you agree, in which case I'll make the change (i.e. assign it back to me).

Closed 2018-09-18.

Thread 606 (2018-09-18):

Develop scheme for message topics

jamessynge, 2018-09-18:
We have a grab bag of existing topics used with PanMessaging. I'd like to develop a scheme for hierarchical topics, taking advantage of the prefix filtering that ZeroMQ offers. This should be recorded in a markdown file, probably under source control rather than in the wiki.

jamessynge, 2018-10-05:
Regarding topic names, given that ZeroMQ has literal prefix filtering (not regexp), I suggest that we use dotted names for topics (ala Python & Java package names). Furthermore, to eliminate the possibility of a leaf topic (i.e. the topic used by a publisher when sending a message) also matching as the prefix of some other, longer topic name, I suggest that all leaf topic names end with a `$` (dollar sign).
For consistency, I recommend that we only use lower-case names.

When a subscriber wants to filter on a group of topics with a common prefix, the filter should end with a `.` (period), unless subscribing to all topics, in which case the filter is the empty string. This reinforces the idea that dotted names are intended for semantic grouping. We could hide some of these details by introducing classes or class instances representing topics and topic groups. For example:
```
t = PanMessaging.create_topic_name('pocs_shell.in.command')
t  -->  TopicName('pocs_shell.in.command$')
g = t.parent_group_name()
g  -->  TopicGroupName('pocs_shell.in.')
g = g.parent_group_name()
g  -->  TopicGroupName('pocs_shell.')
g = g.parent_group_name()
g  -->  TopicGroupName('')
g = g.parent_group_name()
g  -->  TopicGroupName('')

g = PanMessage.root_topic_group_name()
g  -->  TopicGroup('')
```

We have these existing topics (excluding those used in tests):

- `PANCHAT` (sent from POCS.say)
  This is used to broadcast messages intended for humans. Subscribed to by PAWS and social_messaging.
  Suggested name: `pocs.out.chat$`
- `PAWS-CMD` (sent from PAWS websockets.py, received by pocs_shell)
  Suggested name: `pocs_shell.in.command$`
  This should probably be combined with `POCS-CMD` once we create a non-shell version of pocs_shell (i.e. a daemon that runs the observatory, receives commands, reports status, etc.).
- `POCS` (sent by class POCS)
  This is the default topic for POCS.send_message, but I think all the non-test callers provide a topic, and only one test does not provide a specific topic. We should probably eliminate this topic.
- `POCS-CMD` (sent by pocs_shell, received by class POCS, and also by some tests in order to shutdown POCS)
  Suggested name: `pocs.in.command$`
- `STATUS` (sent by class POCS)
  I'm not entirely clear how this is received, but I assume that it some how goes from POCS to PAWS to the browser javascript.
  Suggested name: `pocs.out.status$`
- `weather` (from peas/sensors.py)
  Suggested name: `sensor.weather$`
- `environment` (from peas/sensors.py)
  I suggest that we drop this in place of the following two messages which ArduinoIO will produce (the names are derived automatically from the board name).sensor.weather$
- `telemetry:commands` (in ArduinoIO... new)
  Suggested name: `sensor.telemetry_board$`
- `camera:commands` (in ArduinoIO... new)
  Suggested name: `sensor.camera_board$`

wtgee, 2020-06-01:
Messaging was eliminated in #951. The ideas here are relevant but it might also be worth just starting a new issue. Closing as stale.

Closed 2020-06-01.

Thread 608 (2018-09-19):

Plotting fixes

wtgee, 2018-09-19:
We have a couple of outstanding issues with plotting:

* [x] matplotlib 3.0 breaking. See #607
* [ ] Should be using OO interface in most places.
* [ ] Look into using [pytest-mpl](https://pypi.org/project/pytest-mpl/)
* [ ] Make sure images don't save with transparent background by default.

wtgee, 2019-08-25:
Closing as stale.

Closed 2019-08-25.

Thread 629 (2018-09-25):

dispatch scheduler question

gnthibault, 2018-09-25:
Dear all,

I am still playing with POCS, and I recently came across a line of code that I suspect might generate a bug.
However, I am sorry, I don't have enough time to write a proper test to make it fail consistently.

Here: https://github.com/panoptes/POCS/blob/develop/pocs/scheduler/dispatch.py#L92

I think you should be inserting a tuple instead of just an observation:

`best_obs.insert(0, (self.current_observation.name, self.current_observation.merit))
`
Sorry if I am wrong

I wish you a good day

wtgee, 2018-09-29:
Hi @gnthibault, thanks for pointing this out! You are right that it should be a tuple that is being inserted and i have made a fix to make it consistent. This was not being used for operating our units but potentially could be by someone, so I appreciate it.

Cheers!

gnthibault, 2018-09-29:
You are most welcome! I modified the dispatch class in order to use it, and I might have some other correction to report.

If you have a bit of time, I have two questions regarding pocs:

- What version of astroplan are you using (I ambusing the latest one, and it does not look fully compatible with pocs)
- Are you actually uing astroplan scheduling capability in your own scheduler implementation (I am curious)

I wanted to use astroplan scheduling capability, but it looks like this dispatch class is enough for my constraints, and what I need to do right now.

Thank you.

jamessynge, 2018-09-30:
Thanks again for the fix. We use the latest version of astroplan (i.e.
requirements.txt just says "astroplan" with no version constraint). @wtgee
can address the question about whether/how we are using astroplan.

On Sat, Sep 29, 2018 at 4:44 PM Thibault Notargiacomo <
notifications@github.com> wrote:

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

Closed 2018-09-30.

Thread 632 (2018-09-25):

Figure out why test_autofocus_coarse hangs

wtgee, 2018-09-25:
The `test_observatory.py` `test_autofocus_coarse` is hanging on almost all branches some of the time. Often a restart of the test will fix it. Need to figure out what process is causing the problem.

wtgee, 2018-09-25:
Setting `plots=False` in the test files seems to do the trick. Still testing out some changes.

wtgee, 2018-09-26:
Note: I didn't figure out *why* this was happening, I just set it to skip for certain tests. Still need to figure out why so should probably leave open.

AnthonyHorton, 2018-09-26:
That is odd. Haven't had issues with this in the past. I have been seeing intermittent test failures in the Arduino tests, though.

This change to disable focus plots in the tests has broken the autofocus tests in my `pyro-cameras` branch as there I had expanded the tests to check for the plot files while I was working on the copying of files from remote cameras. I've re-enabled plotting in my branch for now, will keep an eye out for hanging tests.

wtgee, 2018-09-26:
> That is odd. Haven't had issues with this in the past. I have been seeing intermittent test failures in the Arduino tests, though.

Something about the arduino simulator definitely does wacky things to our coverage.

> This change to disable focus plots in the tests has broken the autofocus tests in my `pyro-cameras` branch as there I had expanded the tests to check for the presence of the plot files while I was working on the copying of files from remote cameras. I've re-enabled plotting in my branch for now, will keep an eye out for hanging tests.

It definitely could have been the result of my refactor and/or subsequent barrage of PRs.

Closed 2018-10-18.

Thread 636 (2018-09-28):

Clarify Dome Simulator Code

wtgee, 2018-09-28:
There is a whole lot of code that is set up for a dome simulator and it is not at all clear how it works or what it is supposed to be doing.

In adding documentation as part of #635 I'm changing a bit of how test discovery works and this is leading to errors that are difficult to trace (such as where `NoOpSerial` comes from)

Thread 639 (2018-09-29):

New camera config not working

jamessynge, 2018-09-29:
I upgraded PAN006 today, and found that pocs_shell won't successfully load pocs_local.yaml:

```
I0929 18:46:49.655 logger.py:133        ****************************** Starting PanLogger ******************************
D0929 18:46:55.881 __init__.py:80       Camera config: {'auto_detect': True, 'primary': '6575fc', 'devices': [{'model': 'canon_gphoto2'}, {'model': 'canon_gphoto2'}]}
E0929 18:46:55.916 error.py:18          CameraNotFound: No port specified and auto_detect=False
```

Closed 2018-09-29.

Thread 651 (2018-09-30):

Stop Observatory if not cameras present

wtgee, 2018-09-30:
With the ability to dynamically add/remove cameras (coming soon) we will need a check to make sure the observatory does not proceed if no cameras are available. Should also prevent initial startup if no cameras detected (as discussed here: https://github.com/panoptes/POCS/pull/646#issuecomment-425752246)

wtgee, 2020-06-01:
Closed by #951 (or maybe before?) with the `can_observe` property.

Closed 2020-06-01.

Thread 653 (2018-10-01):

Arduino Simulator Fixes

wtgee, 2018-10-01:
I am getting errors in the arduino simulator tests in unrelated PRs. In addition to that. the `pocs/serial_handlers/protocol_arduinosimulator.py` file reports coverage tests on almost every PR, pointing to some non-hermetic testing.

```
pocs/tests/test_arduino_io.py::test_basic_arduino_io FAILED                                                                                                                                                                                                                                                            [  3%]
                                                                                             
========================================================================================================================================================== FAILURES ==========================================================================================================================================================
___________________________________________________________________________________________________________________________________________________ test_basic_arduino_io ____________________________________________________________________________________________________________________________________________________
                                                                               
serial_handlers = True, memory_db = <pocs.utils.database.PanMemoryDB object at 0x7f09c5ceda20>, msg_publisher = <pocs.utils.messaging.PanMessaging object at 0x7f0999d6e128>, msg_subscriber = <pocs.utils.messaging.PanMessaging object at 0x7f0999d6e668>
cmd_publisher = <pocs.utils.messaging.PanMessaging object at 0x7f0999d6e048>, cmd_subscriber = <pocs.utils.messaging.PanMessaging object at 0x7f0999d6e6d8>
                                                                                             
    def test_basic_arduino_io(serial_handlers, memory_db, msg_publisher, msg_subscriber, cmd_publisher,
                              cmd_subscriber):                                               
        board = 'telemetry'                                                                
        ser = arduino_io.open_serial_device('arduinosimulator://?board=' + board)            
        board = board + '_board'                                               
        aio = arduino_io.ArduinoIO(board, ser, memory_db, msg_publisher, cmd_subscriber)                                                                                                                                                                                                                              
                                                                               
        # Exercise ability to reconnect if disconnected.                                     
        aio.reconnect()                                                        
        aio.disconnect()                                                                     
                                                                                                                                                                                                                                                                                                                      
        got_reading = aio.read_and_record()                                                  
        if got_reading is False:                                               
            got_reading = aio.read_and_record()                                              
            assert got_reading is True                                         
        else:                                                                                                                                                                                                                                                                                                                             assert got_reading is True                                                                                                                                                                                                                                                                                
                                                                                                                         
        # Check that the reading was sent as a message.                           
        topic, msg_obj = msg_subscriber.receive_message(blocking=False)                             
        assert topic == board                                                                                                                                                                                                                                                                                         
        assert isinstance(msg_obj, dict)                                                    
        assert len(msg_obj) == 3                                                                 
        assert isinstance(msg_obj.get('data'), dict)                                                                                                                                                                                                                                                                  
        assert isinstance(msg_obj.get('timestamp'), str)                       
        assert msg_obj.get('name') == board

        # Check that the reading was stored.
        stored_reading = memory_db.get_current(board)
        assert isinstance(stored_reading, dict)
        assert sorted(stored_reading.keys()) == ['_id', 'data', 'date', 'type']
        assert isinstance(stored_reading['_id'], str)
        assert stored_reading['data']['data'] == msg_obj['data']
        assert isinstance(stored_reading['date'], datetime.datetime)
        assert stored_reading['type'] == board

        # There should be no new messages because we haven't called read_and_record again.
        topic, msg_obj = msg_subscriber.receive_message(blocking=False)
        assert topic is None
        assert msg_obj is None

        # Send a command. For now, just a string to be sent.
        # TODO(jamessynge): Add named based setting of relays.
        # TODO(jamessynge): Add some validation of the effect of the command.
        cmd_topic = board + ':commands'
        assert cmd_topic == aio._cmd_topic
        cmd_publisher.send_message(cmd_topic, dict(command='write_line', line='relay=on'))
        aio.handle_commands()

        # Confirm that it checks the name of the board. If the reading contains
        # a 'name', it must match the expected value.
        aio.board = 'wrong'
        with pytest.raises(error.ArduinoDataError):
            aio.read_and_record()
        aio.board = board

        # Ask it to stop working. Just records the request in a private variable,
        # but if we'd been running it in a separate process this is how we'd get it
        # to shutdown cleanly; the alternative would be to kill the process.
        cmd_publisher.send_message(cmd_topic, dict(command='shutdown'))
        assert aio._keep_running
        aio.handle_commands()
>       assert not aio._keep_running
E       assert not True
E        +  where True = <pocs.sensors.arduino_io.ArduinoIO object at 0x7f0999cf2a58>._keep_running

pocs/tests/test_arduino_io.py:214: AssertionError
```

This also leaves the simulator hanging and tests need to be killed manually. Again, this is in a PR that doesn't touch anything to do with the arduinos or simulators.

jamessynge, 2018-10-05:
I'm not able to reproduce this problem (I have in the past though, so not denying the problem still exists). Can you provide steps?

wtgee, 2018-10-05:
> I'm not able to reproduce this problem (I have in the past though, so not denying the problem still exists). Can you provide steps?

I cannot rely reproduce. But I think this is why we get that fluctuation 1.55% diff coverage from protocol_arduinosimulator. Some times I think it passes and sometimes not, without causing tests to fail (which I thought I had commented on elsewhere as well but don't see).

jamessynge, 2018-10-16:
I'm going to claim this is fixed by the large number of changes to the arduinio io code that I merged over the last few days. Let me know if that's wrong.

Closed 2018-10-16.

Thread 656 (2018-10-01):

Decouple camera from observation

wtgee, 2018-10-01:
The `take_observation` command has some coupling between the camera and the observation that should be removed. See discussion here: https://github.com/panoptes/POCS/pull/642#discussion_r221471935

AnthonyHorton, 2018-10-02:
Going to take a little bit of thought to neatly disentangle the camera and observation because of the desire to insert of bunch of observation related metadata into the FITS headers of the images the camera is taking.

jamessynge, 2018-10-19:
Is there anything that prevents us from updating the images after they've been collected by the camera? Alternately, the camera object could be provided either with a set of metadata to add to the FITS headers or with a callback for doing the same (the latter is probably much more general).

Thread 657 (2018-10-01):

pocs_shell raises exception while loading config

jamessynge, 2018-10-01:
#648 appears to have broken pocs_shell loading the config on PAN006.

```
(panoptes-env) panoptes@Panmass:/var/panoptes/POCS (develop)$ bin/pocs_shell
Welcome to POCS Shell! Type ? for help
POCS > setup_pocs
Traceback (most recent call last):
  File "bin/pocs_shell", line 904, in <module>
    PocsShell().cmdloop()
  File "/home/panoptes/anaconda3/envs/panoptes-env/lib/python3.6/cmd.py", line 138, in cmdloop
    stop = self.onecmd(line)
  File "/home/panoptes/anaconda3/envs/panoptes-env/lib/python3.6/cmd.py", line 217, in onecmd
    return func(arg)
  File "bin/pocs_shell", line 157, in do_setup_pocs
    observatory = Observatory(simulator=simulator, cameras=cameras)
  File "/var/panoptes/POCS/pocs/observatory.py", line 64, in __init__
    self._create_scheduler()
  File "/var/panoptes/POCS/pocs/observatory.py", line 698, in _create_scheduler
    self.observer, fields_file=fields_path, constraints=constraints)
  File "/var/panoptes/POCS/pocs/scheduler/dispatch.py", line 14, in __init__
    BaseScheduler.__init__(self, *args, **kwargs)
  File "/var/panoptes/POCS/pocs/scheduler/scheduler.py", line 56, in __init__
    if not self.config['scheduler']['check_file']:
KeyError: 'check_file'
```

wtgee, 2018-10-01:
I suspect you have a `scheduler` config item in your `pocs_local.yaml` so it's not picking up the change to the `pocs.yaml`. Would be nice if we didn't need the whole top-level items just to have changes (mentioned in #564).

I'll get in a fix for this regardless, thanks.

Thread 662 (2018-10-02):

Exception collecting status

jamessynge, 2018-10-02:
Executed after updating POCS to commit 85c3a3a2448ef4ad8fded07f4000370256b65d07:

```
$ bin/pocs_shell
POCS > setup_pocs
POCS > collect_status
Starting messaging
Command publisher started on port 6500
Command subscriber started on port 6501
Message subscriber started on port 6511
Message publisher started on port 6510
Recording POCS status - Press Ctrl-c to interrupt
{'observatory': {'dome': 'Both sides closed',
                 'mount': {'current_dec': <Latitude -67.67124444444445 deg>,
                           'current_ha': <Longitude 23.999750804119877 hourangle>,
                           'current_ra': <Longitude 157.70974999999999 deg>,
                           'dec_guide_rate': 0.9,
                           'gps': 'Data Extracted',
                           'hemisphere': 'Northern',
                           'movement_speed': 'Max sidereal',
                           'ra_guide_rate': 0.9,
                           'state': 'Stopped - Not at Zero Position',
                           'time_source': 'RS-232',
                           'timestamp': '-3000181002093034',
                           'tracking': 'Custom',
                           'tracking_rate': '1.0000',
                           'tracking_rate_ra': 1.0},
                 'observer': {'local_evening_astro_time': <Time object: scale='utc' format='jd' value=2458394.498133679>,
                              'local_moon_alt': <Latitude 38.92783285076994 deg>,
                              'local_moon_illumination': 0.47878615636559624,
                              'local_moon_phase': <Quantity 1.6132367534603926 rad>,
                              'local_morning_astro_time': <Time object: scale='utc' format='jd' value=2458394.8826049455>,
                              'local_sun_rise_time': <Time object: scale='utc' format='jd' value=2458393.9494617917>,
                              'local_sun_set_time': <Time object: scale='utc' format='jd' value=2458394.4306360562>,
                              'localtime': '2018-10-02 10:30:33',
                              'siderealtime': '10h30m54.6383s',
                              'utctime': <Time object: scale='utc' format='datetime' value=2018-10-02 14:30:33.291914>}},
 'state': 'sleeping',
 'system': {'free_space': 137.299013632}}
********************************************************************************
Traceback (most recent call last):
  File "bin/pocs_shell", line 904, in <module>
    PocsShell().cmdloop()
  File "/home/panoptes/anaconda3/envs/panoptes-env/lib/python3.6/cmd.py", line 138, in cmdloop
    stop = self.onecmd(line)
  File "/home/panoptes/anaconda3/envs/panoptes-env/lib/python3.6/cmd.py", line 217, in onecmd
    return func(arg)
  File "bin/pocs_shell", line 228, in do_collect_status
    self.pocs.db.insert_current('system', status, store_permanently=False)
  File "/var/panoptes/POCS/pocs/utils/database.py", line 253, in insert_current
    self.validate_collection(collection)
  File "/var/panoptes/POCS/pocs/utils/database.py", line 41, in validate_collection
    raise InvalidCollection(msg)
pocs.utils.error.InvalidCollection: Collection type 'system' not available
```

wtgee, 2018-10-02:
Hmm, that's an odd new one. Fix is easy but it concerns me why that has never happened but suddenly is.

wtgee, 2018-10-02:
I see that this is via `collect_status`, which shouldn't matter, but does this happen during operations?

wtgee, 2018-10-02:
I've confirmed I get the same thing on PAN001 from https://github.com/panoptes/POCS/commit/77cd582df1adaaf5a79f53fe7473ec761f189192. Normal operations have been okay.

Honestly I forgot there was a `collect_status` call in pocs_shell. That sure is handy. :grinning:. Let's mark as bug and I'll try to dig into the shell but I think you should be okay for running.

wtgee, 2018-10-02:
Looking into this, the `collect_status` is just reading the status and then trying to insert it into a whole new collection named `system`, which we don't use anywhere else. Since the status that is returned is really just items that are already stored in other collections I don't know what the point would be of restoring it.

I think the answer here is to just remote the line that [inserts this](https://github.com/panoptes/POCS/blob/develop/bin/pocs_shell#L227).

Thread 697 (2018-10-17):

Add AC sensor signal into safety decision of POCS

jamessynge, 2018-10-17:
@wtgee Per our discussion with Nem today.

jamessynge, 2018-10-19:
Specifically, POCS.is_safe should add a new entry to the is_safe_values dictionary for AC. The environment data for the telemetry board already has the info we're looking for; it _simply_ needs to be extracted and compared against a suitable threshold. Unfortunately, that threshold is likely to be unit specific.

FWIW, I'd really like to change the design so that we get a binary signal indicating if AC is present or not, without a comparison required. Using the Mean Well brand power supply would provide that. Similarly, just plugging in a 5V wall wart (e.g. the type used to power an Arduino UNO) could be used to close or open a relay, and we could use a digital IO pin on the Arduino to detect that the AC to 5 VC DC conversion is happening. It isn't quite the same as having the power supply tell us that it has 5V, but it is easy to create out of standard parts.

wtgee, 2018-10-19:
> FWIW, I'd really like to change the design so that we get a binary signal indicating if AC is present or not, without a comparison required

I'd like this. It would be great if we could just read a boolean flag out of the arduino.

I'll get to this work this week. Thanks for writing up Issue.

Thread 707 (2018-10-20):

Calibrate zero (home) position automatically of iOptron mount

jamessynge, 2018-10-20:
The iOptron iEQ 30 Pro or 45 Pro mounts don't have absolute encoders on the RA and DEC shafts, so they can only make relative motions. This means that they need to be moved "manually" into a position called the zero or home position where the scope is pointing at the pole and the DEC axis is as vertical as it can be. The user then needs to use the iOptron hand-controller to set the current position as the zero position. After that, the mount can move to specific coordinates by making movements relative to that zero position.

If you unlock the clutches on the iOptron iEQ 30 Pro or 45 Pro, adjust the position of the mount and then lock the clutches, the zero position will not be what it was prior to that adjustment, so you need to set the zero position again. However, this is really hard to do during the day, the time when it is easiest to work on the mount (or show it off to visitors). I think we can assume that the mount will be left in approximately the correct parked position for safety, but that might not be exactly the same as the previous parked position, so the relative travel from parked to zero will have changed.

Currently POCS assumes that the zero position is set correctly, but for at least PAN006 this isn't correct. We could use several means to validate the mount location when starting up:

- The accelerometer could be checked to see if the mount has moved since it was parked (i.e. is down still in the same direction it was after parking).
- After moving to the zero position, POCS could take a picture of the pole (or of several locations) and solve the image(s) to determine the actual orientation of the mount.

After all that, we can move the mount to the position that should be zero and set that position as zero. We might want to do that two or three times to get as close as possible.

Requesting the feedback of @wtgee and @joshwalawender.

wtgee, 2018-10-20:
>  The user then needs to use the iOptron hand-controller to set the current position as the zero position.

Actually we can set this without the hand-controller, which was what I was referring to in our offline conversation. There is a private method [`_set_zero_position`](https://github.com/panoptes/POCS/blob/develop/pocs/mount/ioptron.py#L332) which calls the underlying command to set the zero position.

> After moving to the zero position, POCS could take a picture of the pole (or of several locations) and solve the image(s) to determine the actual orientation of the mount.

As mentioned, the plate-solving near the pole can be difficult to get fairly accurate. The accelerometer is a good idea.

I don't think normal operations of the mount (outside of PANOPTES) would rely on any super accurate home position, but instead use the calibration obtained via an alignment procedure to correct for the discrepancies. And, even if the home position was 100% "accurate" I think you would still need the alignment calibration.

That alignment calibration is done via the `calibrate_mount` (see below) command, which we currently use in the pointing correction, but that was some of the info we were hoping to get back from iOptron.

While I think recovering the home position is a good idea I think our time is probably better spent figuring out the details of the `calibrate_mount` command and how to "properly" do an alignment via software only.

I also do like the idea of figuring out if the unit has moved while parked, e.g. via the accelerometer.

Note: At this point `calibrate_mount` we don't have a high-level wrapper for this command although you can see usage via `mount.query` in the [pointing state](https://github.com/panoptes/POCS/blob/develop/pocs/state/states/default/pointing.py#L88) when it does the auto-correct.

wtgee, 2022-01-20:
The newer versions of the iOptron mounts do have some kind of absolute encoder and have the ability to search out the home position automatically. Closing this issue as Won't Fix unless we get strong motivation to support, in which case Issue can be re-opened.

Closed 2022-01-20.

Thread 711 (2018-10-22):

Effectively cache astrometry, et al, on travis

jamessynge, 2018-10-22:
Builds currently fail if they can't download the astrometry index files. I believe we are making some use of the Travis caching feature, but not enough to prevent this problem.

wtgee, 2018-10-22:
I have a branch where I started some work on this. I'll see if it's worth pushing.

jamessynge, 2018-10-23:
Assigning it to you in hopes that your branch has something worthwhile in it. Several recent builds have failed due these problems.

jamessynge, 2018-10-23:
Alternately, point me to your branch.

jamessynge, 2018-10-27:
I've made lots of progress on understanding how to set this up (#712), but now am stymied by astrometry.net being offline again. It seems like we should cache critical dependencies in GCS.

FWIW, it appears that I spoiled the cache for #712 with one bad command which then meant that the next build of that PR didn't have a cache to pull from, so needed to read from astrometry.net. I'm going to try to get that PR thing submitted today so that future builds will hopefully be better able to use the travis provided caching facility.

wtgee, 2019-03-29:
@jamessynge did we ever get anywhere with this?

If anything I am thinking that as we move more toward a docker-based approach it won't be an issue. I know we are also storing a few things in our own storage bucket, which it doesn't appear we are using but which we could.

wtgee, 2020-06-01:
Made stale by #951. Please re-open a new issue if needed. Thanks!

Closed 2020-06-01.

Thread 716 (2018-11-01):

Resolve current_time timezone issues

wtgee, 2018-11-01:
The [`current_time`](https://github.com/panoptes/POCS/blob/develop/pocs/utils/__init__.py#L16) function is currently timezone naive. This is probably okay but the issue needs to be explored a little more in depth.

See, e.g. [comments in this PR](https://github.com/panoptes/POCS/pull/710#discussion_r227399354).

wtgee, 2020-02-17:
Closing as stale. New items should be opened in [panoptes-utils](https://github.com/panoptes/panoptes-utils)

Closed 2020-02-17.

Thread 733 (2018-11-21):

Simulator Camera Creation should not require dummy camera config entries

wtgee, 2018-11-21:
Currently the `create_cameras_from_config` will fail if the `cameras` entry is not populated in the config file. To get a simulator to work one must have at least:

```yaml
cameras:
    auto_detect: False
    devices:
    -
        model: simulator
```

Ideally the simulator should work when no config entries are present.

This manifested itself in AstroHuntsman/huntsman-pocs where the default config file does not contain a `cameras` entry but should be fixed for POCS in general.

Closed 2019-02-15.

Thread 734 (2018-11-22):

Evaluate Docker as Developer and/or User option

wtgee, 2018-11-22:
Docker has recently moved to requiring users to register and log in to the docker store just to use the containers. This means if we go the Docker route that all PANOPTES users would first be required to register first, which doesn't exactly thrill me.

Note that Docker is under an Apache 2.0 license which technically means we could just download it once and host it ourselves and provide it to our users that way. Still, not entirely my favorite option.

Creating this issue just to be aware and discuss.

@jamessynge not sure what the current status of the Docker work is but would appreciate thoughts.

https://github.com/docker/docker.github.io/issues/6910

programatt, 2019-01-14:
This would only be applicable to users trying to do development on POCS on windows and OSX machines. The docker runtime is linux (and/or windows, it's complicated). So if it's just someone trying to setup the NUC for a build, you can host the images on Docker Hub and they can install the docker runtime on the NUC without needing docker logins. Github for Mac is a [HyperKit linux VM](https://docs.docker.com/v17.09/docker-for-mac/install/#what-to-know-before-you-install) that runs in OSX. Windows you can either run containers natively in [windows or using the linux VM](https://docs.docker.com/docker-for-windows/#switch-between-windows-and-linux-containers).

Speaking from the experience of using docker for development on python projects, I have seen great reproducibility for the dev environment between different development machines. We even had a project where 2 users were running OSX, 1 Fedora, 1 Ubuntu, 1 Windows all building and running the same python container without any cross platform issues. This was due to the fact that the docker runtime on all was linux so it was identical. The other nice feature that i'm using on a distributed hardware project similar to panoptes is the ability to run a watcher container on each device, that will automatically pull new docker container versions and restart containers. This would allow "OTA" like updates of panoptes as bugfixes, features are added. This would also allow the NUC setup to be very straightforward as you basically only need a base linux image with docker on it and the rest of the "setup" is in the container. I'm fairly new to the project, but quite interested in helping out. I can take a pass at creating a dev environment in docker and make a PR for the team to look at?

wtgee, 2019-01-14:
Hi @programatt, thanks for the question. We do have a bloated [Dockerfile](https://github.com/panoptes/POCS/blob/develop/Dockerfile) that I have used a couple of places within [GCE](https://cloud.google.com/environment/). I use this as a base for the [PIAA Dockerfile](https://github.com/panoptes/PIAA/blob/develop/Dockerfile) and it all works well although I haven't built a fresh image in a while. Some of the instructions are in the README [here](https://github.com/panoptes/POCS/#docker). I have just made the images public on so supposedly it would be available at gcr.io/panoptes-survey/pocs:latest.

We would definitely love to have the simple feature of having images for developers and/or for the control computer itself and there is some work that needs to be done to make that a bit simpler. @jamessynge had wanted to update some of the [install scripts](https://github.com/panoptes/POCS/tree/develop/scripts/install) but I'm not sure if there are any active plans or not.

@programatt we're open to any suggestions! See if the above Dockerfile can get you going but it will certainly need some work done for the final steps in terms of having something easy for developers to use. Let me know if I can help with any questions.

jamessynge, 2019-01-15:
I can't see any evidence that a login is required in order to use docker in order to run containers. The [linked issue](docker/docker.github.io#6910) clearly implies that it is required, yet the install instructions for [Docker CE for Ubuntu](https://docs.docker.com/install/linux/docker-ce/ubuntu/) don't include a step requiring a login. So, when is a login required?

programatt, 2019-01-15:
@jamessynge I think he's talking about installing docker for mac or docker for windows. The download links if you just go to docker.com require you to have an account and login in order to find them. Several users commented in the linked issue with the direct download url for the installers but I'm not sure if those are permalinks or if they will go away eventually.

programatt, 2019-01-15:
I think the nice thing about using the docker images for dev and deployment to the NUCs is you can have a consistent linux environment that works the same for everybody, and the image setup on the NUC is simple. Install a linux os, install docker, run dockerfile, done. For dev work, use docker-compose and map the local git repo into the container and you can do dev work without rebuilding the container unless dependencies change. Same container in both cases.

wtgee, 2019-02-04:
@programatt sorry, holiday vacation hit. :)

Agree completely.  I've actually been doing a lot of work on this front over this weekend and should have something available by end of the week. I took your suggestion for docker-compose and mapping the local environments and it is working well. Need to get a few more kinks out of the system still but I think it is a very viable solution. Cheers!

wtgee, 2019-02-12:
Just a note that I have this Docker image working well over in https://github.com/panoptes/POCS/pull/778. It is probably suitable for development at this point. I used it to take observations on PAN001 the other night and everything went ok. One thing we don't have yet is a good or guaranteed way for the unit to park itself in the situation where the docker container goes down. Ideally that wouldn't happen but it could. So, some particulars to still work through in terms of actual operation using the images, but a good step forward.

programatt, 2019-02-12:
@wtgee Nice! Glad I could help. I'm using docker-compose to run python code in an embedded linux environment for a client. We just create a systemd unit file that calls the docker-compose up/down calls when the service is started and stopped. That way the containers are started on boot of the os. And then we use `restart: always` in the compose yaml to make sure docker restarts the containers if they die. Just off the top of my head you could write a script that runs on a cron job that will docker/docker-compose ps your containers and if they are stopped would park the unit outside of the containers. But my experience is as long as the docker service is running in the os,  docker-compose does a very good job of restarting the containers asap. Even if the container dies immediately due to error.

wtgee, 2020-02-17:
Will be closed by #951

Closed 2020-06-01.

Thread 747 (2018-12-07):

Allow for cameras to operate independently

wtgee, 2018-12-07:
I'm going to try some exposures of the comet 46P/Wirtanen tonight which is at a bright 5.3 magnitude.
Would be nice to support operation where one camera exposes at 10 seconds while the other takes longer exposures (it happens to be in one of the TESS fields right now so the other camera could continue "normal" observations).

AnthonyHorton, 2019-02-14:
Feels like the ideal model is like a worker pool concurrency model. I can imagine the cameras finishing an exposure and sending a message to the observatory "I finished that one, now what?", and the observatory checking its queue of exposures and responding with either "OK, now do this one" or "OK, just wait for now".  That would be an asynchronous, messaging based system, of course.

wtgee, 2019-02-14:
It would be nice to start moving to this model in some sense. It of course connects a number of ideas we have been having (links below). Part of the problem is I think we are waiting to do a big push on this when instead we should be incrementally adding. Harder to the the latter but might be the only way we can proceed. The GSoC student would help a lot in this respect but we won't see much activity on that until about June (if that project were even selected).

* https://forum.projectpanoptes.org/t/pocs-indi-support-thread/191
* https://projectpanoptes.org/gsoc-2019/
* Inter-operability with e.g. SkyNet

AnthonyHorton, 2019-02-14:
Agreed, need to make progress in this direction. Issue is identifying manageable sized steps that take us towards the goal. I could certainly do with some pointers!

I feel like a master Issue with a check list of incremental steps would be helpful.

wtgee, 2019-02-14:
> I feel like a master Issue with a check list of incremental steps would be helpful.

We have started this (somewhere! I'll find) but I'll dig back up and then kick-start the conversation again.

I think the first step would be to split the logging mechanism out, which should be easy to do. There are plugins for pyzmq to make it easy to just broadcast the messages and then we would just need to have some kind of central subscriber mechanism that is collecting them and writing to file. This would help with a lot of components but would obviously also have immediate impact even for the pyro cameras.

AnthonyHorton, 2019-02-14:
> I think the first step would be to split the logging mechanism out, which should be easy to do. There are plugins for pyzmq to make it easy to just broadcast the messages and then we would just need to have some kind of central subscriber mechanism that is collecting them and writing to file. This would help with a lot of components but would obviously also have immediate impact even for the pyro cameras.

That would be really, really useful. Logging is definitely one of the non-ideal aspects of the current ad-hoc distributed cameras, and it's also one of the main dependencies that needs to be resolved in order to spin out the hardware support modules as a separate library.

wtgee, 2019-02-15:
Here's the page: https://pyzmq.readthedocs.io/en/latest/logging.html

I'll take a stab this weekend. The logging is screwing up some things I'm doing for the pipeline anyway.

AnthonyHorton, 2019-02-17:
Oh, that's neat. Looks relatively easy to work with.

wtgee, 2024-03-28:
This is stale and not well-defined. Open again as needed.

Closed 2024-03-28.

Thread 749 (2018-12-08):

Targets File - Support max_nexp

wtgee, 2018-12-08:
Targets currently have a `min_nexp` property but there are some cases, such as with the pretty images of a comet, where we don't necessarily want to dwell on it forever but want to specify.

wtgee, 2020-02-17:
There were some issues with #766  but we still might want to consider the idea.

Thread 750 (2018-12-08):

Scheduler - Move Common Properties

wtgee, 2018-12-08:
The dispatch scheduler currently computes some `common_properties` that are shared between all targets so there is not unnecessary re-computation. These should be moved up to the `BaseScheduler`.

ImmortalRabbit, 2019-03-19:
What if I will just move common_properties to BaseScheduler and will create a method that initializes values of common_properties depends on time that dispatch used. Will this method solve this issue? @wtgee

Closed 2019-03-20.

Thread 753 (2018-12-09):

Consider changing default PanDB type or auto-fallback

wtgee, 2018-12-09:
I picked mongo as a document store in the first days of POCS because it was envisioned we would be using a number of the features available (easy query, reports, etc). However, we are no longer doing that and installing and using mongo has led to some complicating factors, including installation and journal size (currently > 15GB on PAN001).

We should consider using `PanFileDB` as our default, which would allow us to just rely on json files stored on the local system and would not require any extra dependencies.

Could also detect if server available (#752) and auto-fallback to `PanFileDB` if not.

Closed 2018-12-23.

Thread 754 (2018-12-09):

list_connected_cameras should warn if no gphoto2

wtgee, 2018-12-09:
Should properly raise an exception if `gphoto2` is not available on the system.

https://github.com/panoptes/POCS/blob/develop/pocs/camera/__init__.py#L27

Current error:

```
In [2]: list_connected_cameras()
---------------------------------------------------------------------------
TypeError                                 Traceback (most recent call last)
<ipython-input-2-ff7a2ffa9c31> in <module>
----> 1 list_connected_cameras()

/var/panoptes/POCS/pocs/camera/__init__.py in list_connected_cameras()
     27     gphoto2 = shutil.which('gphoto2')
     28     command = [gphoto2, '--auto-detect']
---> 29     result = subprocess.check_output(command)
     30     lines = result.decode('utf-8').split('\n')
     31

~/miniconda3/envs/panoptes/lib/python3.6/subprocess.py in check_output(timeout, *popenargs, **kwargs)
    334
    335     return run(*popenargs, stdout=PIPE, timeout=timeout, check=True,
--> 336                **kwargs).stdout
    337
    338

~/miniconda3/envs/panoptes/lib/python3.6/subprocess.py in run(input, timeout, check, *popenargs, **kwargs)
    401         kwargs['stdin'] = PIPE
    402
--> 403     with Popen(*popenargs, **kwargs) as process:
    404         try:
    405             stdout, stderr = process.communicate(input, timeout=timeout)

~/miniconda3/envs/panoptes/lib/python3.6/subprocess.py in __init__(self, args, bufsize, executable, stdin, stdout, stderr, preexec_fn, close_fds, shell, cwd, env, universal_newlines, startupinfo, creationflags, restore_signals, start_new_session, pass_fds, encoding, errors)                                                                                                   
    707                                 c2pread, c2pwrite,
    708                                 errread, errwrite,
--> 709                                 restore_signals, start_new_session)
    710         except:
    711             # Cleanup if the child failed starting.

~/miniconda3/envs/panoptes/lib/python3.6/subprocess.py in _execute_child(self, args, executable, preexec_fn, close_fds, pass_fds, cwd, env, startupinfo, creationflags, shell, p2cread, p2cwrite, c2pread, c2pwrite, errread, errwrite, restore_signals, start_new_session)                                                                                                          
   1256                     else:
   1257                         env_list = None  # Use execv instead of execve.
-> 1258                     executable = os.fsencode(executable)
   1259                     if os.path.dirname(executable):
   1260                         executable_list = (executable,)

~/miniconda3/envs/panoptes/lib/python3.6/os.py in fsencode(filename)
    798         'mbcs' (which is the default encoding).
    799         """
--> 800         filename = fspath(filename)  # Does type-checking of `filename`.
    801         if isinstance(filename, str):
    802             return filename.encode(encoding, errors)

TypeError: expected str, bytes or os.PathLike object, not NoneType

```

Closed 2018-12-22.

Thread 759 (2018-12-11):

Remove pyplot imports

wtgee, 2018-12-11:
`pyplot` is designed to be used in an interactive environment but we are using it in a few locations within our code. This is most likely leading to memory leaks and, as discovered while working on the sphinx documentation, completely breaks the building of documents (see [thread here](https://groups.google.com/forum/#!topic/sphinx-users/oW4EkS0px2s)).

Closed 2018-12-11.

Thread 764 (2018-12-11):

Consider making timelapse from FITS

wtgee, 2018-12-11:
I mostly give the timelapse a quick look in the morning to see if there is anything unusual in the shots. In taking a [long series of 46P-Wirtanen](http://www.panoptes-data.net/observations/PAN001_14d3bd_20181211T064529) last night it is obvious that the comet if fairly hard to see and if I didn't know it was there I would have most likely missed it. In fact, to find where it was in the frame I had to look at the scaled image from the FITS file.

We should consider doing a diff-frame timelapse or just using some scaled images, which would make changes from one frame to the next more obvious.

AnthonyHorton, 2018-12-12:
Oh, I like the idea of a difference timelapse.

Abhinay1997, 2019-04-15:
@wtgee @AnthonyHorton, I'm working on a timelapse tool using FITS images.
Could you give some pointers on aligning PANOPTES images using WCS header info ?
<b>Consider:</b>
I have two images: fits_1 and fits_2. They are successive images pointing at the same region in the sky.
I create a WCS object using astropy.wcs.WCS for both fits_1 and fits_2.
So we have wcs_1 and wcs_2 corresponding to the two images.
<b>What I am trying to do:</b>
fits_1 chosen reference pixels --> RA and DEC values using wcs1.all_pix2world
RA and DEC values of reference pixels --> fits_2 pixel coordinates ( using wcs2.all_world2pix)
The problem is the shift between the pixels with same RA and DEC values in fits_1 and fits_2 is as follows:
```
x shift is -0.06906008065834612 pixels and y shift is 3.117477370702545 pixels

x shift is -0.06914311006084972 pixels and y shift is 3.1175005897762276 pixels

x shift is -0.07021917960992141 pixels and y shift is 3.1174266885186626 pixels

x shift is -0.06887403351583998 pixels and y shift is 3.1175184556773274 pixels
```
<b>P.S</b>
The RA-MNT and DEC-MNT are same for both fits_1 and fits_2 but HA-MNT is different.
Would it be possible to align using this ?
Right now I'm trying to find a homography between fits_1 and fits_2 as a means to align but wanted to know if I'm moving in the right direction. Thank you in advance :)
[jupyter notebook for reference](https://github.com/Abhinay1997/DIFFITS-Timelapse/blob/master/fits_align_with_wcs.ipynb)

Abhinay1997, 2019-04-16:
Hello @wtgee @AnthonyHorton . I am trying to build this tool and I am having trouble aligning the images.  Identifying the shift in pixels from reference image to the next image {using astropy wcs all_pix2world and all_world2pix} shows different shifts for different pixels.
I then tried using astropy reproject package but apparently it doesn't utilize SIP information in the headers and even then it is quite slow.
Right now, I'm trying to figure out how SAO ds9 is able to match mutliple images using wcs near instantaneously.
Could you point me towards a resource that describes aligning images with wcs ?
[jupyter notebook for reference](https://github.com/Abhinay1997/DIFFITS-Timelapse/blob/master/fits_align_with_wcs.ipynb)

wtgee, 2019-08-25:
See https://github.com/panoptes/panoptes-timegen

wtgee, 2020-02-13:
Closing, see above comment.

Closed 2020-02-13.

Thread 768 (2019-01-14):

Add support for filter wheels

AnthonyHorton, 2019-01-14:
Proposal to add support for optical filter exchange mechanisms (e.g. filter wheels). POCS supports several types of monochrome camera (SBIG, FLI), which are typically used with some sort of filter wheel in order to perform multiband imaging. Currently these filter wheels are unsupported, though.

In the first instance it is proposed to create an `AbstractFilterWheel` base class, create a functional `FilterWheel` class for the SBIG filter wheels, and modify the `AbstractCameraClass` to make it possible to associate a filter wheel with a camera, in the same way as it is currently done with focusers.

In order to make full use of the ability to change filters under computer control more extensive changes would be needed, e.g. `Observation`s should optionally include the name(s) of the desired filter for the exposures. These changes can go into `huntsman-pocs` for now, at least.

AnthonyHorton, 2019-02-01:
#769 (#776) implement basic support for SBIG filter wheels, along with a base class and simulator. The modifications to `Observation` and `Camera` to allow automated use of filter wheels are still to be done, though.

AnthonyHorton, 2019-10-03:
Closing this support for filterwheels has been added, and opening a new Issue (#901) specifically about support for an additional brand of filterwheel.

Closed 2019-10-03.

Thread 774 (2019-01-31):

SBIG Camera support does not work with STX series cameras

AnthonyHorton, 2019-01-31:
In theory the support for Diffraction Limited (SBIG) cameras in `pocs.cameras.sbig` should work with any model of SBIG camera, however when I tried to use it with an STX-16803 camera the camera initialisation failed. The problem was that the `pocs.camera.sbigudrv.SBIGDriver.query_temp_status()` method (which sends the `CC_QUERY_TEMPERATURE_STATUS` command to the camera) resulted in a `CE_MEMORY_ERROR` error.

The driver documentation discusses changes to the `CC_QUERY_TEMPERATURE_STATUS` command that need to be taken into account in order to support STX cameras, however the POCS code is already using the newer interface so ought to be working.

It's possible that this was in fact a problem with the driver itself. I was using the Linux version, the latest release of which dates from October 2013, whereas the most recent Windows driver is from May 2017.

AnthonyHorton, 2019-02-14:
Diffraction Limited have investigated the issue and confirmed that it is in fact a bug in the current release version of the Linux driver, specifically an x64 compatibility issue.

We have received a patched version of the Linux driver from Diffraction Limited that apparently fixes the bug, however this has not yet been tested with POCS

Thread 775 (2019-02-01):

Filterwheel should not work while exposing.

wtgee, 2019-02-01:
Need a safety check so that filterwheel is inactive during exposing.

AnthonyHorton, 2019-02-01:
OK, to do this I think I need to add an `is_exposing` property to the camera base class so that the filter wheel can check with the camera to see if it's allowed to move.

Closed 2019-02-01.

Thread 777 (2019-02-01):

Camera should not start exposure while filter wheel is moving

AnthonyHorton, 2019-02-01:
Inspired by #775 I realise that the camera `take_exposure()` method should, if the camera has a filterwheel, check that the filterwheel is not moving before actually starting the exposure.

AnthonyHorton, 2019-02-14:
Closed by #782

Closed 2019-02-14.

Thread 786 (2019-02-19):

Refactor Camera and Driver classes

AnthonyHorton, 2019-02-19:
SBIG, FLI & ZWO camera classes all do very similar things but in slightly different ways. Makes testing and maintenance hard, & will just get harder if more camera types do their own thing in the future.

A few things in particular:

- [x] When taking an exposure all three do some setup, then start the exposure, then spawn a thread to poll the camera and do readout when the exposure is complete. SBIG does this all in the low level `Driver` class while FLI & ZWO do this in the `Camera` class. None of them are using their own `is_exposing` property (recently added), instead they poll the driver method directly.  This all could be made much more consistent across camera types, and much of it moved into a base class.
- [x] Likewise all of them use a `Driver` method to scan for connected cameras, search for one with a matching UID, then claim the corresponding 'handle' or 'camera_ID'.  Again SBIG does this in the driver class while FLI and ZWO do this in the Camera class.  The code is very similar in all three cases, and most of it could be made generic and moved to a base class.
- [x] More fundamentally all of them use a single instance of a low level driver class per camera type, but create that instance differently. FLI and ZWO do this simply, making the `Driver` a class variable of the `Camera` class and creating it in the `Camera.__init__()` if no other `Camera` instance has already done so. Conversely the older SBIG code does this by overriding the `Camera` class `__new__()` method. I now have no idea why I did it this way...
- [ ] More nitpicky: I want to standardise on using Python `enum` as the Python version of the enums in the SDK C headers. I didn't know about this module when I wrote the SBIG and FLI `Driver` classes they mostly use pairs of dictionaries instead. `enum.IntEnum` and `enum.Flag` are a much closer match to the functionality of C enums.
- [x] Generally speaking there is need for more consistency in the `Driver` and `Camera` class split. I want the `Driver` classes to be thin wrappers around the corresponding camera SDK API, with a more or less one-to-one mapping of class methods to SDK functions. Additional functionality shouldn't extend much beyond Python->C & C->Python conversion of inputs and outputs, validating inputs, parsing errors, and logging. The `Camera` class, conversely, should present a standardised POCS interface via its public methods and properties, and include all the logic to convert that into calls of the low level `Driver` methods.  This is basically already the case with ZWO, is mostly true of FLI, but isn't really the case with SBIG.

Trying to work out how to attack this in manageable chunks, in a way that leaves it working at each step. Would be a mammoth PR to do it all at once.

wtgee, 2019-05-12:
@AnthonyHorton can we close this?

AnthonyHorton, 2019-05-15:
Some of the things on the list have been done, some haven't. I think this needs updating greater than closing. I'll get on it.

AnthonyHorton, 2019-10-14:
#787 (and follow ups) addressed 1, 2, 3 & 5. The standardisation on `enum` instead of dictionaries is still to be done.

wtgee, 2024-03-28:
Closing this issue as done/stale. Feel free to re-open as needed.

Closed 2024-03-28.

Thread 792 (2019-03-09):

Default Ubuntu setup on 18.04 conflicts with using Chrome Remote Desktop

jamessynge, 2019-03-09:
18.04 uses Gnome for its session manager **by default**, which makes it very difficult to use Chrome Remote Desktop (CRD) for administering a unit. I ran into this when trying to remotely assist Luc get his NUC setup. We could use the CRD "Request assistance" feature (he sent me a code, allowing me to see his session), but not "Remote access" (i.e. I couldn't just login to the machine unless he requested it).

I like CRD because Google takes care of providing the servers through which the client (i.e. my laptop) finds the remote host (i.e. the PANOPTES unit). The team at Caltech were able to use VNC easily because (somewhat astonishingly) Caltech doesn't by default block outside access to the hosts on its campus network. This isn't true at most locations; e.g. most home (and enterprise and school) routers will have a firewall / network-address-translation (NAT) feature that prevents connections being initiated from outside the home to computers inside the home, which helps greatly reduce the spread of malware.

So, I'm thinking that the "simple" solution for now is to include in the 18.04 installation instructions steps to recommend that the user use Cinnamon rather than Gnome/Unity as the session manager. Longer term, I'd like to investigate:

- A lighter weight Linux distribution (we don't need to be installing Libre Office, for example); my preference would be some Debian based solution as that seems to be very stable.
- Providing a linux package that has as required dependencies all of the linux packages that we need (e.g. git).

@wtgee Your thoughts?

wtgee, 2019-03-09:
What about just using [Xubuntu](https://xubuntu.org/) or [Lubuntu](https://lubuntu.net/)? They are both lightweight and nice. I think PAN012 is running Xubuntu. Then we are not only still Debian but we are still actually on [official Ubuntu](https://www.ubuntu.com/download/flavours). They still ship with e.g. office applications but would still be considerably lighter.

AnthonyHorton, 2019-03-11:
Does LightDM have better compatibility than gdm3? While Ubuntu now defaults to using GDM it continues to include LightDM by default so it's easy for the user to switch. Might be an acceptable short term fix.

jamessynge, 2019-03-16:
@wtgee I'd be happy to try a lighter weight install. I was wondering about using a distribution optimized for running containers or kubernetes, with the idea of pushing towards remote mgmt, but I fear that would be too big a hurdle any time soon. I'll give one of those two (Xubuntu and Lubuntu) a try today.

@AnthonyHorton wrote

> Does LightDM have better compatibility than gdm3?

Better compatibility with what?

AnthonyHorton, 2019-03-17:
> > Does LightDM have better compatibility than gdm3?
>
> Better compatibility with what?

With Chrome Remote Desktop.

programatt, 2019-03-29:
@jamessynge I have had very good success running a docker environment on stock ubuntu server instances. If people are ok with administration of the devices being on the CLI and eventually going to updates through docker images there's a really nice tool called [watchtower](https://github.com/v2tec/watchtower) that I use. It listens to the docker socket on the host and automatically pulls down new docker container images and restarts services when changes are detected. Can run on a schedule or every X seconds. For os level updates then you can use tools like ansible to run sh scripts against remote hosts. But it really depends on what the project goals are for the admin side.

wtgee, 2019-06-22:
Should be addressed by #778

wtgee, 2020-02-17:
Closing as stale.

Closed 2020-02-17.

Thread 793 (2019-03-10):

ImportError while loading conftest

ImmortalRabbit, 2019-03-10:
I am trying to install POCS using [Coding in PANOPTES]( https://github.com/panoptes/POCS/wiki/Coding-in-PANOPTES).
OS: ubuntu 16.04
I have cloned POCS into` /var/panoptes/`
I have set all environmental variables, installed mongodb, git, ghoto2, astronomy.net, dcraw and exiftool.
Successfully installed requirements using: `pip3 install -r requirements.txt`
I have opened POCS using pycharm, and then I run `pytest` which gives me ERROR:

```
ImportError while loading conftest '/var/panoptes/POCS/conftest.py'.
conftest.py:16: in <module>
    from pocs.utils.database import PanDB
E     File "/var/panoptes/POCS/pocs/utils/database.py", line 143
E       raise ConnectionError(f'Mongo server not available')
E                                                         ^
E   SyntaxError: invalid syntax
```

I cannot understand what I have left to do or how to fix this error.

I am trying to contribute with less git pushes because each time I have to git push and do pull requests in order to check all tests using travis-CI.

ImmortalRabbit, 2019-03-10:
That's was error with syntax because virtual environment was using not python3.6 which is required. However, in documentation it was said that:
> We recommend a newer python (3.5) separate from whatever system python is already installed.
I think it confuses newcomers like because POCS uses some a new features of python3.6 which is not supported in python3.5. For example
` raise ConnectionError(f'Mongo server not available')`
In this line of code `f` is not supported by python3.5.
> PEP 498 introduces a new kind of string literals: [f-strings](https://docs.python.org/3/whatsnew/3.6.html), or formatted string literals.

ImmortalRabbit, 2019-03-10:
Currently with python3.6.7, I am having error:
```
/var/panoptes/POCS/pocs/utils/logger.py:218: UserWarning: formatters is missing from log_config!
  warn('formatters is missing from log_config!')
/var/panoptes/POCS/pocs/utils/logger.py:219: UserWarning: log_config: {}
  warn(f'log_config: {log_config!r}')
ImportError while loading conftest '/var/panoptes/POCS/conftest.py'.
conftest.py:18: in <module>
    from pocs.utils.messaging import PanMessaging
pocs/utils/messaging.py:18: in <module>
    class PanMessaging(object):
pocs/utils/messaging.py:80: in PanMessaging
    logger = get_root_logger()
pocs/utils/logger.py:262: in get_root_logger
    logging.config.dictConfig(log_config)
/usr/lib/python3.6/logging/config.py:802: in dictConfig
    dictConfigClass(config).configure()
/usr/lib/python3.6/logging/config.py:498: in configure
    raise ValueError("dictionary doesn't specify a version")
E   ValueError: dictionary doesn't specify a version

```

ImmortalRabbit, 2019-03-14:
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

I could fix it by properly adding environmental variables.

wtgee, 2019-03-14:
> I could fix it by properly adding environmental variables.

Hi @ImmortalRabbit, sorry for the delay, I've been out for a few days.

Can you be specific about what environment variable you added, just in case someone else comes looking. Thanks!

ImmortalRabbit, 2019-03-19:
> Can you be specific about what environment variable you added, just in case someone else comes looking. Thanks!

I am not sure why but each time environmental variables reset's itself after restart of my PC, and each time I have to install all environmental variables again. I mean doing this again.

export PANDIR=/var/panoptes   # Main Dir
export PANLOG=${PANDIR}/logs  # Log files
export POCS=${PANDIR}/POCS    # Observatory Control
export PAWS=${PANDIR}/PAWS    # Web Interface
export PIAA=${PANDIR}/PIAA    # Image Analysis
export PANUSER=panoptes       # PANOPTES linux user

wtgee, 2019-03-19:
You can put them in your `$HOME/.bashrc` file and then they should be loaded every time.

Closed 2019-03-14.

Thread 803 (2019-03-27):

How to test removed items from observatory

ImmortalRabbit, 2019-03-27:
<!--- Provide a general summary of the issue in the Title above -->

## Expected Behavior
<!--- If you're describing a bug, tell us what should happen -->
<!--- If you're suggesting a change/improvement, tell us how it should work -->
There should test methods that checks properly methods that removes camera, dome and mount.

## Current Behavior
<!--- If describing a bug, tell us what happens instead of the expected behavior -->
<!--- If suggesting a change/improvement, explain the difference from current behavior -->
Currently, I use for a test:
`  @property
    def exist_dome(self):
        return 'dome' not in locals()`
It just checks is variable dome exist in local variables or not. Test goes very well, but still I am not sure of correctness of this method.
## Possible Solution
<!--- Not obligatory, but suggest a fix/reason for the bug, -->
<!--- or ideas how to implement the addition or change -->
` try:
      dome
     return True
  except(Expection ex):
      return False
`
Also, I think it could be possible solution.

## Context
<!--- How has this issue affected you? What are you trying to accomplish? -->
<!--- Providing context helps us come up with a solution that is most useful in the real world -->
I am trying to implement suggested milestones of "Observatory Dependency Decoupling". I am currently on a third part of it where I am trying to implement tests for methods that removes camera, mount and dome. Can you give any suggestions? @wtgee @jamessynge

## Your Environment
<!--- Include as many relevant details about the environment you experienced the bug in -->
* Version used: python3.6.7
* Environment name and version (e.g. Python 3.6.7 on conda 4.6.3): python3.6.7 on virtualenv
* Server type and version: localhost
* Operating System and version: Ubuntu16.04
* Link to your project: https://github.com/ImmortalRabbit/POCS/tree/gsoc_test

AnthonyHorton, 2019-03-27:
To include multi-line blocks of code in GitHub use triple backticks, e.g.
````
```
    @property
    def exist_dome(self):
        return 'dome' not in locals()
```
````

renders as

```
    @property
    def exist_dome(self):
        return 'dome' not in locals()
```

AnthonyHorton, 2019-03-27:
@ImmortalRabbit Great to see you adding unit tests as you go! I feel like you're approaching the "Observatory Dependency Decoupling" from the wrong direction, though. Being able to delete the `dome`, `mount` or `scheduler` attributes from the `Observatory` object is not really useful, at least not until the other aspects are done.  Also to do the removal I would simply set the attribute to `None` rather than use `del`, which then makes it easy to check whether it is present (`observatory.dome is None`).

I'd suggest approaching the suggested milestone in order, i.e. start with
1. **Scheduler Injection**. A first step would be to remove the scheduler creation from the main Observatory class. This will get a user familiar with the overall system and should be straight-forward.

To do this you'd move the creation of the `scheduler` from `Observatory._create_scheduler()`  to a function called something like `create_scheduler_from_config()`, in `pocs/scheduler/__init__.py`, and change `Observatory.__init__()` so that it takes a `Scheduler` object as an argument instead of calling `self._create_scheduler()`.  See `create_cameras_from_config()` in `pocs/camera/__init__.py` for a (much more complicated) example of how this works.

ImmortalRabbit, 2019-03-27:
@AnthonyHorton Thank you very much, I have understood it in a wrong.

ImmortalRabbit, 2019-03-27:
@AnthonyHorton Also, what is about suggested millstone 2:
Hardware Injection. Remove the remaining hardware components from the Observatory class. Cameras have already been removed so this would involve mostly the mount and dome as well as a clear system for any future hardware.

As I know camera removes using method:
```
    def remove_camera(self, cam_name):
        """Remove cam_name from list of attached cameras.

        Note:
            If you remove and then add a camera you will change the index order
            of the camera. If you prefer to keep the same order then use `add_camera`
            with the same name as an existing camera to to update the list and preserve
            the order.

        Args:
            cam_name (str): Name of camera to remove.
        """
        self.logger.debug('Removing {}'.format(cam_name))
        del self.cameras[cam_name]
```
And here it uses `del` to remove, therefore I was trying to use `del` to remove mount and dome in a same way as cameras were removed. I think I have misunderstood this part too, could you clarify this part too?

Also, I have understood this suggested milestone as to implement test cases for changes that I have done in part 1 and 2. Is it right or is there anything else to do is required?

Dynamic injection/removal. In order to test a real system that is running live, help develop a testing suite that will randomly cause failures in some of the various hardware components along with successful recovery or graceful shutdown.

Thank you for any response.

AnthonyHorton, 2019-03-27:
@wtgee & @jamessynge are the main supervisors for this project so would be able to explain this better than me. However, my understanding of

2. **Hardware Injection**. Remove the remaining hardware components from the Observatory class. Cameras have already been removed so this would involve mostly the mount and dome as well as a clear system for any future hardware.

is that it is _not_ talking about adding methods to remove the attributes. Instead it is talking about removing the _creation_ of the hardware components from the `Observatory` class and putting it in external functions instead. In other words it is doing what I described for the scheduler, but for the mount and dome as well. The whole idea of this project is to move the creation of all of the hardware components out of the `Observatory` class and use Dependency Injection instead, for the sorts of reasons described in [this article](https://medium.freecodecamp.org/a-quick-intro-to-dependency-injection-what-it-is-and-when-to-use-it-7578c84fa88f).

The cameras are a special case. Because there are in general several of them they are stored in a Python dictionary. In that case deleting individual cameras still leaves the `Observatory.cameras` attribute present, as a (possibly) empty dictionary. For the other hardware components I think setting the attribute to `None` when the component is not present is the correct approach.

As for

3. **Dynamic injection/removal**. In order to test a real system that is running live, help develop a testing suite that will randomly cause failures in some of the various hardware components along with successful recovery or graceful shutdown.

the dynamic injection/removal simply refers to added the ability to add or remove hardware components while the system is running, not just when the `Observatory` object is created. The complexity here isn't so much the adding or removing of the attributes, but in getting the `Observatory` to respond sensibly when that happens. I'll leave the others to elaborate on this last milestone, but I will say that you should tackle 1 and 2 first, which will include their own tests.

ImmortalRabbit, 2019-03-27:
@AnthonyHorton Thank you for clear answer and for the time that you have spent to explain to me.
I will wait for response of mentors of this project idea, maybe they can add something more that can help me to better understand whole idea of this project.
@wtgee @jamessynge

wtgee, 2019-03-27:
Thanks @AnthonyHorton for the answers!

@ImmortalRabbit just to reiterate a point Anthony made:

> he complexity here isn't so much the adding or removing of the attributes, but in getting the Observatory to respond sensibly when that happens.

This is the real challenge here. We do already have an `Observatory.add_camera` but are missing the `remove_camera` and similar methods for the other hardware, which is perhaps the confusing part.

Essentially the `Observatory` needs to run independently in a deamon like mode (this is already done) but should be capable of responding to requests for new hardware and should be able to handle itself properly when existing hardware disappears (because of some problem).

The request for the new hardware would look something like a message (via grpc or zeromq or something - discussion in forum) where the new hardware basically is advertising that it is available and ready to work. The `Observatory` would receive that message and add the hardware appropriately depending on the type of hardware.

Each hardware or item would then have some kind of heartbeat communication with the `Observatory` to let it know that it is still alive. This way when the `Observatory` goes to do, for example, `take_observation`, it will call the command on all the cameras it has attached. If the camera is dead and unresponsive the `Observatory` should have already removed it from the list so that it doesn't try to use it to take a picture.

But yes, a good first step would be the scheduler as that would handle some of the basics of the dependency injection without the complexities (i.e. the scheduler isn't a piece of hardware that can fail).

ImmortalRabbit, 2019-03-31:
I have a question about creation of dome, in a description of task it was said that:

> Cameras have already been removed so this would involve mostly the mount and dome as well as a clear system for any future hardware

Cameras have a function in `camera/__init__.py`:
```def create_cameras_from_config(config=None, logger=None, **kwargs):
    """Create camera object(s) based on the config.
```
It means that it was already have been removed, and we have to do same thing to mount and dome. But, dome already has a function in `dome/__init__.py`:
```
def create_dome_from_config(config, logger=None):
    """If there is a dome specified in the config, create a driver for it.

```
Does it means that function of dome does creation of it in a same way as camera does?

@wtgee @jamessynge

wtgee, 2019-03-31:
Hi @ImmortalRabbit

> Does it means that function of dome does creation of it in a same way as camera does?

No. While both cameras and the dome have a `create_xxx_from_config`  function, the difference lies in where we call those functions from.

The cameras are created *outside* the `Observatory` object and passed as part of the constructor arguments, i.e. when used from the `pocs_shell`:

https://github.com/panoptes/POCS/blob/06fb91daff331296f4c212daa453e4a850b3f900/bin/pocs_shell#L164-L166

The dome, however, is currently created *inside* the `Observatory`:,

https://github.com/panoptes/POCS/blob/06fb91daff331296f4c212daa453e4a850b3f900/pocs/observatory.py#L59

This is what we mean when we say the cameras have been "removed" from the `Observatory`. That is, the creation of the cameras (a dependency) is no longer tightly coupled to the creation of the `Observatory`.

So we create the dependency outside the object (`Observatory`) and then "inject" it into the object upon creation. Note that we don't want to necessarily require the dependency injection at the time we create the Observatory, hence the `add_camera` and `remove_camera` methods, which can feasibly be called at any time. The caveat is that the `Observatory` needs to be smart enough to know when it doesn't have *any* cameras.

So now we want to do the same thing for dome, scheduler, mount, etc. You can see the difference in the `Observatory.__init__` method, where the cameras are "added" but everything else is currently "created"

https://github.com/panoptes/POCS/blob/06fb91daff331296f4c212daa453e4a850b3f900/pocs/observatory.py#L45-L64

ImmortalRabbit, 2019-04-01:
@wtgee
Is it all about only mount, dome and scheduler? Because I cannot find Filter Wheel and Focuser in Observatory class.

AnthonyHorton, 2019-04-01:
@ImmortalRabbit The `FilterWheel` and `Focuser` are optional subcomponents of the `Camera`, so the `Observatory` doesn't communicate with them directly. The may be a case for doing dependency injection there too, but we're concentrating on the `Observatory` class for now.

wtgee, 2019-04-01:
It might also be tempting to remove them all in one big PR but please don't do that. :) With our [In Praise of Small PRs](https://github.com/panoptes/POCS/wiki/In-Praise-of-Small-Pull-Requests-(PRs)) in mind, it is a lot easier (for everyone) to just concentrate on one at a time.

ImmortalRabbit, 2019-04-01:
> It might also be tempting to remove them all in one big PR but please don't do that. :) With our [In Praise of Small PRs](https://github.com/panoptes/POCS/wiki/In-Praise-of-Small-Pull-Requests-(PRs)) in mind, it is a lot easier (for everyone) to just concentrate on one at a time.

Yeah, sure I will not create a big PR

Thread 804 (2019-03-30):

Two methods of deleting ArduinoIO instance for board

kmeagle1515, 2019-03-30:
<!--- Provide a general summary of the issue in the Title above -->
There are two methods to delete arduinoio instance for board.

## Expected Behavior
<!--- If you're describing a bug, tell us what should happen -->
<!--- If you're suggesting a change/improvement, tell us how it should work -->
Delete the double of the method.

## Current Behavior
<!--- If describing a bug, tell us what happens instead of the expected behavior -->
<!--- If suggesting a change/improvement, explain the difference from current behavior -->
Error: method already defined.

## Possible Solution
<!--- Not obligatory, but suggest a fix/reason for the bug, -->
<!--- or ideas how to implement the addition or change -->
Remove the second method.

## Steps to Reproduce (for bugs)
<!--- Provide a link to a live example, or an unambiguous set of steps to -->
<!--- reproduce this bug. Include code to reproduce, if relevant -->
1.
2.
3.
4.

## Context
<!--- How has this issue affected you? What are you trying to accomplish? -->
<!--- Providing context helps us come up with a solution that is most useful in the real world -->

## Your Environment
<!--- Include as many relevant details about the environment you experienced the bug in -->
* Version used: python3.6+
* Environment name and version (e.g. Python 3.7.1 on conda 4.6.3):
* Server type and version:
* Operating System and version:
* Link to your project:

Closed 2019-03-30.

Thread 809 (2019-04-02):

Update pySerial and deprecated commands

wtgee, 2019-04-02:
pyserial commands like reset_input_buffer( ) and  reset_output_buffer( ) may come in handy.
Maybe there is a need for a new function like clear_buffer ( ) under which these commands will be executed because peas_shell doesn't have one.

Also i have noticed a line
https://github.com/panoptes/POCS/blob/4ef6e70e0484156c67b5c8178235b2a9987cca58/bin/peas_shell#L210
here flushInput( ) is supported for python versions 2.x the latest commands is reset_input_buffer( )
https://pyserial.readthedocs.io/en/latest/pyserial_api.html#serial.Serial.reset_input_buffer

_Originally posted by @kmeagle1515 in https://github.com/panoptes/POCS/issues/347#issuecomment-478951014_

SMe12435, 2019-04-09:
```
def clean_buffer(self):
	    serial_connection = self.environment.serial_readers[relay_info['board']]['reader']

 	    try:
		    serial_connection.ser.reset_input_buffer()
		    serial_connection.write("{},9".format(relay_info['pin']))  #not sure what this line of code does.
	    except Exception as e:
		    print("Unable to reset Input Buffer: ")
		    print(e)

 	    try:
		    serial_connection.ser.reset_output_buffer()
		    serial_connection.write("{},9".format(relay_info['pin']))  #not sure what this line of code does.
	    except Exception as e:
		    print("Unable to reset output buffer: ")
		    print(e)

```

@wtgee As @kmeagle1515 mentioned in #810, we can do something like this.

Closed 2020-06-01.

Thread 812 (2019-04-03):

DSLR (gphoto2) cameras broken by latest code.

wtgee, 2019-04-03:
**Describe the bug**
Seems to be a problem initializing the `Camera` class because of the underlying changes with regards to the `abc` module.

**To Reproduce**
Steps to reproduce the behavior:
1. Run `setup_pocs` within the pocs_shell.

**Expected behavior**
Cameras should initialize properly.

**Related Issues**
#787

**Screenshots**
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

**Additional context**
Reported by the UofA team (PAN010)

Closed 2019-04-16.

Thread 818 (2019-04-07):

Depreciation at pocs/utils/config.py line 15 : yaml.load_all is unsafe with default loader

SMe12435, 2019-04-07:
In order to tackle is this, we have to add an additional Loader Type parameter.
`Loader = yaml.FullLoader`

There are a couple of choices for the YAML Loader:

- **Base Loader**:Only loads the most basic YAML
- **SafeLoader**: Loads a subset of the YAML language, safely. This is recommended for loading untrusted input.
-  **FullLoader**: Loads the full YAML language. Avoids arbitrary code execution. **This is currently (PyYAML 5.1) the default loader called by yaml.load(input) (after issuing the warning).**

The current situation suggests we should use Full Loader. Any views on using Basic/Safe Loader? @wtgee @jamessynge

wtgee, 2019-04-07:
HI @SMe12435, thanks for looking into this and the other items from #810.

This is actually already solved in #814, I'm just waiting for @jamessynge or @AnthonyHorton to review. :wink:. I ended up using the `full_load` call, which worked well.

However, on another note, I'm currently doing a little bit of surgery on POCS in order to split all of the `pocs.utils` into their own repository. There are times when we want to use the `utils` without requiring a full install of `pocs`. This work is going on over in https://github.com/panoptes/panoptes-utils.

The changes you already did in #816 and #817 will make their way there as will these changes from #814.  I will also start moving Issues from here to there pretty soon, just FYI.

SMe12435, 2019-04-07:
Oh! Sorry for creating a duplicate issue. @wtgee

wtgee, 2019-06-29:
Closed as part of panoptes-utils 0.0.8 release.

Closed 2019-06-29.

Thread 820 (2019-04-11):

create_cameras_from_config won't work with SDK cameras

AnthonyHorton, 2019-04-11:
**Description**

`pocs.cameras.create_cameras_from_config()` has a fixed set of parameters that it will extract from the config and pass as arguments to the `Camera` class constructor: `model`, `port`, `target_temperature`, `filter_type`, `focuser`, `filterwheel` and `readout_time`. Both `model` and `port` are required for each camera, while the rest will be replaced with default values if they are not in the config.

Since the refactoring of the camera class in #787 the SDK `Camera` classes (SBIG, FLI, ZWO) do not require a `port`, but do need the `serial_number` argument. Consequently `create_cameras_from_config` will fail if the configuration contains cameras of these types.

`create_cameras_from_config()` needs to be modified so that it only requires either `port` or `serial_number` to be in each camera's config, together with `model`.

For the sake of maintainability `create_cameras_from_config` should simply pass any additional parameters in the camera config beyond `name`, `model`, and `port`/`serial_number` unmodified to the `Camera` constructor.  This includes the `filter_type`, `focuser`, `filterwheel` and `readout_time` parameters currently being processed by `create_cameras_from_config()`. The `Camera` classes themselves already apply suitable default values to any missing arguments, doing the same in `create_cameras_from_config()` just adds redundant complexity.

**To Reproduce**
1. Create a POCS configuration YAML file with camera devices with model `sbig`, `fli` or `zwo`.
2. Call `create_cameras_from_config()`
3. The call will fail either because there is no `port` (`KeyError: No port specified and auto_detect=False`) or because `serial_number` does not get passed to the `Camera` constructor (`ValueError: Must specify serial_number for <cam_name>.`).

**Expected behavior**
All `Camera` objects should be created without error, regardless of camera type.

Closed 2019-04-28.

Thread 821 (2019-04-13):

Metadata DB date fields timezone - BSON datetime

wtgee, 2019-04-13:
At some point (either switch to `bson.json_utils` for serializing or the switch from mongo to a flat file for the default db) we started inserting datetime records into the metadata db with timezones. Currently this is creating a problem with `peas_shell` instances when you try to do something like `last_reading environment`.

PAN001 has been using the following patch, which fixes `peas_shell` and hasn't experienced any issues elsewhere in the code. However, it seems like the better solution is to make it so the insert converts directly to UTC so that anything reading from db can always expect UTC.

```diff
diff --git a/bin/peas_shell b/bin/peas_shell
index 704f12c..38fe13e 100755
--- a/bin/peas_shell
+++ b/bin/peas_shell
@@ -76,7 +76,7 @@ class PanSensorShell(cmd.Cmd):
         print_info('*' * 80)
         if isinstance(rec.get('date'), datetime.datetime):
             now = current_time(datetime=True)
-            age = (now - rec['date']).total_seconds()
+            age = (now - rec['date'].replace(tzinfo=None)).total_seconds()
             if age < 120:
                 print_info('{:.1f} seconds old'.format(age))
             else:
```

Note that the `.replace(tzinfo=None)` converts to UTC as part of the process of discarding the timezone (see jupyter example below).

#### Related:

* #716
* https://github.com/panoptes/panoptes-utils/issues/18

#### To Reproduce
Steps to reproduce the behavior:

##### From `peas_shell`:
```python
(panoptes-env) ➜  POCS git:(develop) ✗ bin/peas_shell
Welcome to PEAS Shell! Type ? for help
PEAS > load_environment
Loading sensors
PEAS > load_weather
Loading AAG Cloud Sensor on /dev/ttyUSB1
PEAS > start
Starting sensors
PEAS > last_reading environment
********************************************************************************
ENVIRONMENT:
{'_id': '0a082fb6-2dc6-4bb1-af3f-f58a5168c0b8',
 'data': {'camera_board': {'amps': {'cameras': 85.0,
                                    'fan': 61.2,
                                    'main': 1433.6,
                                    'mount': 1618.2},
                           'current': {'cameras': 85,
                                       'fan': 34,
                                       'main': 512,
                                       'mount': 899},
                           'date': '2019-04-13T20:02:41 GMT',
                           'humidity': 53.5,
                           'millis': 936333605,
                           'name': 'telemetry_board',
                           'power': {'cameras': 0,
                                     'computer': 1,
                                     'fan': 1,
                                     'main': 1,
                                     'mount': 1,
                                     'weather': 1},
                           'report_num': 9862729,
                           'temp_00': 11.5,
                           'temperature': [18.81, 7.5, 7.19],
                           'ver': '2018-01-14'}},
 'date': datetime.datetime(2019, 4, 13, 20, 2, 41, 145000, tzinfo=<bson.tz_util.FixedOffset object at 0x7f2b44a95a20>),
 'type': 'environment'}
********************************************************************************
Traceback (most recent call last):
  File "bin/peas_shell", line 372, in <module>
    PanSensorShell().cmdloop()
  File "/home/panoptes/anaconda3/envs/panoptes-env/lib/python3.7/cmd.py", line 138, in cmdloop
    stop = self.onecmd(line)
  File "/home/panoptes/anaconda3/envs/panoptes-env/lib/python3.7/cmd.py", line 217, in onecmd
    return func(arg)
  File "bin/peas_shell", line 79, in do_last_reading
    age = (now - rec['date']).total_seconds()
TypeError: can't subtract offset-naive and offset-aware datetimes
```

##### From `jupyter`:
The error just comes from trying to subtract the last record time from the current time, which we can reproduce directly:

```bash
(panoptes-env) ➜  POCS git:(develop) ✗ jupyter-console
Jupyter console 6.0.0

Python 3.7.0 (default, Oct  9 2018, 10:31:47)
Type 'copyright', 'credits' or 'license' for more information
IPython 7.1.1 -- An enhanced Interactive Python. Type '?' for help.

In [1]: from pocs.utils.database import PanDB                                                                                                                                                                                    

In [2]: db = PanDB()                                                                                                                                                                                                             
In [3]: t = db.get_current('environment').get('date')                                                                                                                                                                            

In [4]: t                                                                                                                                                                                                                        
Out[4]: datetime.datetime(2019, 4, 13, 20, 3, 44, 720000, tzinfo=<bson.tz_util.FixedOffset object at 0x7fd441b2deb8>)

In [5]: t.astimezone()                                                                                                                                                                                                           
Out[5]: datetime.datetime(2019, 4, 13, 10, 3, 44, 720000, tzinfo=datetime.timezone(datetime.timedelta(days=-1, seconds=50400), 'HST'))

In [6]: from pocs.utils import current_time

In [7]: current_time().datetime - t                                                                                                                                                                                              
---------------------------------------------------------------------------
TypeError                                 Traceback (most recent call last)
<ipython-input-8-5b3a28a7f943> in <module>
----> 1 current_time().datetime - t

TypeError: can't subtract offset-naive and offset-aware datetimes

In [8]: (current_time().datetime - t.replace(tzinfo=None)).total_seconds()                                                                                                                                                      
Out[8]: 47.790929
```

AnthonyHorton, 2019-05-07:
> Note that the .replace(tzinfo=None) converts to UTC as part of the process of discarding the timezone

That doesn't seem to be true. From [the docs](https://docs.python.org/3/library/datetime.html#datetime.datetime.astimezone):

>  If you merely want to remove the time zone object from an aware datetime dt without conversion of date and time data, use dt.replace(tzinfo=None).

Use of `.replace(tzinfo=None)` convert a timezone aware `datetime` to a timezone naive `datetime`, but doesn't convert to UTC. I testing this in Jupyter:

```
In [15]: d = datetime.strptime("1999-12-31T12:00+1100", "%Y-%m-%dT%H:%M%z")

In [16]: d
Out[16]: datetime.datetime(1999, 12, 31, 12, 0, tzinfo=datetime.timezone(datetime.timedelta(0, 39600)))

In [17]: d.replace(tzinfo=None)
Out[17]: datetime.datetime(1999, 12, 31, 12, 0)
```

So I create a timezone aware `datetime` in the UTC+11 timezone, use `.replace(tzinfo=None)`, and get the same date and time in a timezone naive `datetime`, not the equivalent UTC time.

Closed 2019-05-08.

Thread 830 (2019-05-06):

Camera readout method consistency

wtgee, 2019-05-06:
The private `_readout` methods for the various camera classes currently have some inconsistencies in their setup. Each `_start_exposure` is responsible for packaging the readout_args that are eventually passed to `_readout`, so each subclass can handle this on its own, but it would be nice to have consistency.

Order shouldn't matter a ton but `filename` and `header` are the consistent params so `header` should be made the consistent second parameter.

Currently:

```bash
➜ ack 'def _readout'
pocs/camera/canon_gphoto2.py
154:    def _readout(self, cr2_path, info):

pocs/camera/simulator/dslr.py
60:    def _readout(self, filename, header):

pocs/camera/fli.py
141:    def _readout(self, filename, width, height, header):

pocs/camera/zwo.py
246:    def _readout(self, filename, width, height, header):

pocs/camera/sbig.py
166:    def _readout(self, filename, readout_mode, top, left, height, width, header):

pocs/camera/camera.py
495:    def _readout(self, filename=None):

```

**Related Issues/PRs**
This came from #822. I also have a PR I'm about to submit that will fix the gphoto2 `_readout`, which is how this was discovered.

wtgee, 2020-02-17:
Closed by #831. Reopen with more information if necessary.

Closed 2020-02-17.

Thread 833 (2019-05-24):

Change cfitsio downloads to use FTPS before 20th September 2019

AnthonyHorton, 2019-05-24:
Announcement from NASA HEASARC that they will be discontinuing unencrypted FTP on 20th September 2019: https://heasarc.gsfc.nasa.gov/docs/FTPWarning.html

Currently POCS continuous integration and installation scripts download cfitsio via unecrypted FTP. These scripts will need to be changed to use FTPS instead before 20th September.

wtgee, 2019-06-02:
Fixed in #835

Closed 2019-06-02.

Thread 837 (2019-05-29):

Creation of scheduler outside of Observatory class

ImmortalRabbit, 2019-05-29:
**Is your feature request related to a problem? Please describe.**
In order to add dependency injection, creation of scheduler should be done outside of Observatory class.
**Describe the solution you'd like**
I would like to add creation of scheduler outside of Observatory class. In order to do that I am willing to send scheduler into Observatory class as cameras were sent:
`def __init__(self, cameras=None, scheduler=None, *args, **kwargs):`
or
`def __init__(self, cameras=None, scheduler, *args, **kwargs):`
I am not quiet sure, should I consider situation when scheduler will not be sent to Observatory class. According to my understanding scheduler is just a software and it's not like cameras that can be not attached.
Then planning to replace A with B:
A:
```
        self.scheduler = None
        self._create_scheduler()
```
B:
```
       self.scheduler = None
       if scheduler:
            self.logger.info('Creation of the scheduler in the observatory')
            self.scheduler = scheduler
```
**Describe alternatives you've considered**
A clear and concise description of any alternative solutions or features you've considered.

**Additional context**
Add any other context or screenshots about the feature request here.

**Related Issues/PRs**
If there are any related Issues or PRs list them here:
##### Depends on: #836
##### Required by:

@wtgee @jamessynge

wtgee, 2019-05-29:
> am not quiet sure, should I consider situation when scheduler will not be sent to Observatory class.

Yes, I think we want to be able to create an Observatory without necessarily specifying a scheduler. As such, you should use the keyword based (i.e. `scheduler=None`) approach in the constructor.

One thing we will need to do is identify the methods inside the `Observatory` that rely on a scheduler and give appropriate warnings (or handle in some other way) if a scheduler is not present.  For example, an observatory cannot `.observe()` without a scheduler so it makes sense to do some checks before allowing that method.

ImmortalRabbit, 2019-05-30:
> One thing we will need to do is identify the methods inside the `Observatory` that rely on a scheduler and give appropriate warnings (or handle in some other way) if a scheduler is not present. For example, an observatory cannot `.observe()` without a scheduler so it makes sense to do some checks before allowing that method.

```
        if not self.scheduler:
            return dict()
```

Or should I raise error than just empty dictionary? Or empty dictionary will cause an error?

jamessynge, 2019-05-31:
The simple approach to dealing with _scheduler being None is simply to raise an exception (e.g. pocs.utils.error.NoObservation) if the observe method is called.

I'd convert .scheduler to ._scheduler, and introduce an @property accessor called scheduler which can then raise the NoObservation error if called when _scheduler isn't set.

ImmortalRabbit, 2019-06-01:
> The simple approach to dealing with _scheduler being None is simply to raise an exception (e.g. pocs.utils.error.NoObservation) if the observe method is called.
>
> I'd convert .scheduler to ._scheduler, and introduce an @Property accessor called scheduler which can then raise the NoObservation error if called when _scheduler isn't set.

In my pull request #838 I added a new error NoScheduler which appears if scheduler is None. Do you think that will be fine?

Closed 2019-06-11.

Thread 840 (2019-06-04):

Handle cleanup_observations when a scheduler is removed.

ImmortalRabbit, 2019-06-04:
*<Enter description of change or enhancement here>*
We want to call the cleanup_observations if the scheduler is removed manually. If we were to switch schedulers in the middle of the night we need some way to trigger this cleanup methods.

**Describe the solution you'd like**
Don't know for sure, how to solve this problem. @wtgee said it has to made as a separate issue. Currently, I created check that stops cleanup_observations if scheduler is None.

**Describe alternatives you've considered**
A clear and concise description of any alternative solutions or features you've considered.

**Additional context**
Code changes can be found in a pull request #838 because it is still not merged with develop branch.

**Related Issues/PRs**
If there are any related Issues or PRs list them here:
##### Depends on: #838
##### Required by:

@wtgee @jamessynge

wtgee, 2019-06-04:
Thanks for creating the Issue. I'm not entirely sure how we want to handle this either and we probably don't need to worry about it right now, but it's good to have the Issue.

@jamessynge and I have favored moving toward a model where each image is automatically uploaded to our cloud servers as soon as it is taken, which would eliminate the need for `cleanup_observations` altogether.

Let's keep this Issue open but don't worry too much about it right at this point.

Thread 845 (2019-06-16):

Birger Serial Errors

wtgee, 2019-06-16:
Input/output errors on the Birger but only intermittently. @AnthonyHorton thinks could be a physical wiring issue.

Odd that it starts from `_create_fits_header`. Maybe the file is not done writing yet?

I haven't looked too deeply into this.

**To Reproduce**
Cannot reliably reproduce but it happens not infrequently.

```
In [6]: cam.take_exposure(seconds=0.1, filename='foo2.fits', blocking=True)                                                                                                                            
---------------------------------------------------------------------------                                                                                                                            
error                                     Traceback (most recent call last)                                                                                                                            
<ipython-input-6-ed240610cf5f> in <module>                                                                                                                                                             
----> 1 cam.take_exposure(seconds=0.1, filename='foo2.fits', blocking=True)                                                                                                                            
                                                                                                                                                                                                       
/storage/panoptes/POCS/pocs/camera/camera.py in take_exposure(self, seconds, filename, dark, blocking, *args, **kwargs)                                                                                
    285         self.logger.debug('Taking {} exposure on {}: {}'.format(seconds, self.name, filename))                                                                                                 
    286                                                                                                                                                                                                
--> 287         header = self._create_fits_header(seconds, dark)                                                                                                                                       
    288                                                                                                                                                                                                
    289         if not self._exposure_event.is_set():

/storage/panoptes/POCS/pocs/camera/sbig.py in _create_fits_header(self, seconds, dark)
    188
    189     def _create_fits_header(self, seconds, dark):
--> 190         header = super()._create_fits_header(seconds, dark)
    191
    192         # Unbinned. Need to chance if binning gets implemented.

/storage/panoptes/POCS/pocs/camera/camera.py in _create_fits_header(self, seconds, dark)
    549                                                                                                                                                                                               
    550         if self.focuser:
--> 551             header = self.focuser._add_fits_keywords(header)
    552         if self.filterwheel:
    553             header = self.filterwheel._add_fits_keywords(header)

/storage/panoptes/POCS/pocs/focuser/birger.py in _add_fits_keywords(self, header)
    469                                                                                                                                                                                               
    470     def _add_fits_keywords(self, header):
--> 471         header = super()._add_fits_keywords(header)
    472         header.set('FOC-HW', self.hardware_version, 'Focuser hardware version')
    473         header.set('FOC-FW', self.firmware_version, 'Focuser firmware version')

/storage/panoptes/POCS/pocs/focuser/focuser.py in _add_fits_keywords(self, header)
    544         header.set('FOC-MOD', self.model, 'Focuser model')
    545         header.set('FOC-ID', self.uid, 'Focuser serial number')
--> 546         header.set('FOC-POS', self.position, 'Focuser position')
    547         return header
    548

/storage/panoptes/POCS/pocs/focuser/birger.py in position(self)
    167         Returns current focus position in the lens focus encoder units
    168         """
--> 169         response = self._send_command('pf', response_length=1)
    170         return int(response[0].rstrip())
    171

/storage/panoptes/POCS/pocs/focuser/birger.py in _send_command(self, command, response_length, ignore_response)                                                                                       
    320
    321         # Clear the input buffer in case there's anything left over in there.
--> 322         self._serial_port.reset_input_buffer()
    323
    324         # Send command

/storage/miniconda3/envs/panoptes/lib/python3.6/site-packages/serial/serialposix.py in reset_input_buffer(self)                                                                                       
    593         if not self.is_open:
    594             raise portNotOpenError
--> 595         termios.tcflush(self.fd, termios.TCIFLUSH)
    596
    597     def reset_output_buffer(self):

error: (5, 'Input/output error')

```

wtgee, 2020-02-17:
Closing as stale. Reopen as necessary.

Closed 2020-02-17.

Thread 846 (2019-06-16):

Hanging camera if autofocus_size is too large

wtgee, 2019-06-16:
**Describe the bug**
If you set the `autofocus_size` larger than the image it will hang until you manually kill. Then you see an AssertionError.

**Expected behavior**
Handle the error gracefully.

```
In [4]: cam.autofocus()
Out[4]: <threading.Event at 0x7f30c4366fd0>

In [5]: exit
Exception in thread Thread-5:
Traceback (most recent call last):
  File "/storage/miniconda3/envs/panoptes/lib/python3.6/threading.py", line 916, in _bootstrap_inner
    self.run()
  File "/storage/miniconda3/envs/panoptes/lib/python3.6/threading.py", line 864, in run
    self._target(*self._args, **self._kwargs)
  File "/storage/panoptes/POCS/pocs/focuser/focuser.py", line 353, in _autofocus
    dark=True)
  File "/storage/panoptes/POCS/pocs/camera/camera.py", line 468, in get_thumbnail
    thumbnail = img_utils.crop_data(image, box_width=thumbnail_size)
  File "/storage/panoptes/POCS/pocs/utils/images/__init__.py", line 57, in crop_data
    box_width, data.shape)
AssertionError: Can't clip data, it's smaller than 5000 ((2532, 3352))
```

wtgee, 2020-02-13:
@AnthonyHorton do we know if this is still an issue?

AnthonyHorton, 2020-02-13:
@wtgee It probably is. I don't remember putting a check in to prevent the issue.

Closed 2020-11-10.

Thread 850 (2019-06-22):

Separate simulator creation from regular creation

wtgee, 2019-06-22:
The various `create_<hardware>_from_config` scripts are currently also capable of creating a "simulator" version of the hardware. To me that seems non-logical as creating from config should necessarily be creating real hardware.

**Describe the solution you'd like**
I would propose we remove all simulator creation from these convenience functions and handle simulator creation separately.  This could look like a `create_from_config` (one name for each type of hardware, specified as a class method on the base class) and `create_simulator`.

**Additional context**
I think this would help with testing, both for software testing as well as real hardware testing.

**Related Issues/PRs**
#848 #636 #849 #478 #29 #842 #843 probably more.

@jamessynge @ImmortalRabbit

jamessynge, 2019-07-21:
I'm concerned about this proposal because I don't want the production code to have branches such as "if should use simulator". I'm wondering if we can't have a third method: create_<hardware>_driver, which is used by the production code, and is responsible for deciding if we're using a hardware driver simulator or a real driver (possibly with simulated hardware).

I discussed the above with @ImmortalRabbit this morning, and noted that this would mean we'd have a repeated pattern for each type of hardware. This lead me to wonder about some common approach to this, such as an application of the Registry pattern. Thoughts?

Thread 853 (2019-06-24):

Scheduler creation requires observer

ImmortalRabbit, 2019-06-24:
**Describe the bug**
Scheduler creation requires observer to be passed. However, it can be created from same config, in case if it didn't passed.

**To Reproduce**
Scheduler creation requires also config which can be used to create observer if observer is None.

**Expected behavior**
A clear and concise description of what you expected to happen.

**Related Issues**
Please link any related Issues if known.

**Screenshots**
If applicable, add screenshots to help explain your problem.

**Additional context**
Add any other context about the problem here.

Closed 2019-06-26.

Thread 866 (2019-07-06):

Handle driver-specific mount creation and initialisation.

wtgee, 2019-07-06:
In general the `create_mount_from_config` will need to handle specific cases that are different for each driver/model.

Original comment regarding mount:
```
                # TODO(jamessynge): We should move the driver specific validation into the driver
                # module (e.g. module.create_mount_from_config). This means we have to adjust the
                # definition of this method to return a validated but not fully initialized mount
                # driver.
```

_Originally posted by @wtgee in https://github.com/panoptes/POCS/pull/852_

Thread 868 (2019-07-17):

POCS Shell: AC Interlock fails with no error in shell

wtgee, 2019-07-17:
**Describe the bug**
If pocs-shell detects that AC power then it shuts down without an error message in the shell. It does show an error in the logs but should give the user some message in shell as well.

wtgee, 2022-01-15:
Stale.

Closed 2022-01-15.

Thread 891 (2019-09-08):

Set DSLR Camera time

wtgee, 2019-09-08:
**Describe the bug**
The camera times on the DSLR are not being synced to the host computer during setup, leading to inconsistent camera times.

Note that there is a command in [canon_gphoto2.py#L52](https://github.com/panoptes/POCS/blob/develop/pocs/camera/canon_gphoto2.py#L52), which means it is not working so needs to be debugged.

You can see this as a discrpeancy for the listed times on panoptes-data.net.

See https://github.com/gphoto/libgphoto2/issues/443

Edit: note that this seems to be the case for any (canon?) camera and could therefore be tested by anyone with a dslr.

See also #953

wtgee, 2020-02-17:
Seehttps://github.com/gphoto/libgphoto2/issues/443

Closed 2021-06-26.

Thread 899 (2019-10-03):

Incorrectly scaled ZWO camera pixel values

AnthonyHorton, 2019-10-03:
**Describe the bug**
The ZWO ASI cameras capture images using a 10 or 12 bit analogue-to-digital converter. The resulting pixel values are padded to 16 bits in the 'raw' image data returned by the ASI camera driver library. Somewhat counter-intuitively the pixel data is padded with trailing zeros (least significant bits) instead of leading zeros (most significant bits), which has the effect of multiplying the real raw pixel values by a factor of 64 or 16. This then throws off any attempt to convert images from ADU to electron units using the `EGAIN` FITS keyword value taken from the camera driver (which doesn't account for the 64x/16x scaling) and any subsequent analysis of read noise, dark current, full well depth, quantum efficiency, etc...

**To Reproduce**
Steps to reproduce the behavior:
1. Take an exposure with a ZWO ASI camera operating in `RAW16` format using the `pocs.camera.zwo.Camera` class.

**Expected behavior**
A raw image FITS file with pixel values in the range 0 to 1023 or 4095 with any integer value within those ranges possible.

**Actual behaviour**
A raw image FITS file with pixels values which are all multiples of 64 or 16.

AnthonyHorton, 2019-10-08:
Closed by #902 & #903

Closed 2019-10-08.

Thread 900 (2019-10-03):

Use actual serial number of ZWO ASI cameras

AnthonyHorton, 2019-10-03:
*<Enter description of change or enhancement here>*
The changelog of the ZWO ASI camera driver library (https://astronomy-imaging-camera.com/software/change_log/change_ASISDK_Unix.txt) notes the addition of a `ASIGetSerialNumber` function in V1.14.0227 of the camera driver library. Before this was added there was no way to access the serial number of a connected ZWO ASI camera. Consequently the `pocs.camera.zwo.Camera` class worked around this issue (with considerable effort) by instead using the camera 'name' (an up to 8 character string), which can be set by the user and is stored in the camera firmware. POCS requires a unique ID with which to identify cameras and the 'name' was the only solution available at the time, but it is not ideal for several reasons:
1. Before a ZWO camera can be used with POCS the 'name' must be set. This must be done either with ZWO ASICAP application or the low level `pocs.camera.libasi` library.
1. It is up to the user to ensure that the 'names' given to ZWO cameras are unique.
1. The 'name' can be changed, meaning it is not possible to associate previously taken FITS files with a particular camera with total confidence.

**Describe the solution you'd like**
The POCS ZWO ASI Camera class should be changed to use the camera's real serial number now that it can be access through the camera driver API.

**Describe alternatives you've considered**
The use of ZWO camera 'names' as an alternative to a serial number could be continued.

AnthonyHorton, 2019-10-10:
Closed by #904

Closed 2019-10-10.

Thread 901 (2019-10-03):

Add support for ZWO filterwheels

AnthonyHorton, 2019-10-03:
*<Enter description of change or enhancement here>*
Add support for the ZWO EFW/EFWmini filterwheels: https://astronomy-imaging-camera.com/product-category/filterfilter-wheel

**Describe the solution you'd like**
Implement a `pocs.filterwheel.zwo.FilterWheel` class based using the EFW SDK provided by ZWO.

**Related Issues/PRs**
Issue #768 and related PRs introduced filterwheel support to POCS, and added support for filterwheels from Diffraction Limited (SBIG).

AnthonyHorton, 2020-02-06:
Closed by #768

Closed 2020-02-06.

Thread 905 (2019-10-09):

SDKDriver class ._call_function() methods should raise custom(ised) exceptions

AnthonyHorton, 2019-10-09:
Part of the problem is that `._call_function()` doesn't (currently) make any distinctions based on which error code it gets back from the driver library, it just raises a generic `RuntimeError` for everything and embeds the error name in the exception's sole argument. This makes it a bit awkward for code that's catching these exceptions to respond in the most appropriate way. What `._call_function()` should probably be doing is raising `RuntimeError` with multiple arguments e.g. (human readable summary, SDK function name, error code, error name) so that it's easier for higher level code to work out what has happened or, even better, `._call_function()` should be raising different custom exceptions for each type of error, again with multiple attributes to make it easy to write conditional error handling code. This all applies equally to the corresponding parts of the SBIG and FLI camera library classes too, of course.

_Originally posted by @AnthonyHorton in https://github.com/_render_node/MDI0OlB1bGxSZXF1ZXN0UmV2aWV3Q29tbWVudDMzMjk1MTc5OQ==/comments/review_comment_

Thread 915 (2019-10-22):

POCS.park() doesn't park bisque mount

AnthonyHorton, 2019-10-22:
**Describe the bug**
When calling `POCS.park()` with Huntsman (which has a `bisque` type `Mount`) there is an unhandled `TheSkyXTimeout` error immediately after sending the command to home the mount, which results in the subsequent mount park command not being sent. Consequently the mount ends up being left at the home position instead of the park position. Seems like POCS is not waiting for the home mount command to complete?

**To Reproduce**
Steps to reproduce the behavior:
1. Create a `POCS` instance with an `Observatory` that has a `Mount` of `bisque` type.
2. Start the `POCS` instance running.
3. Invoke `POCS.park()`.

**Expected behaviour**
The mount first moves to the home position (why?), then to the park position.

**Actual behaviour**
Mounts starts moving to the home position, there is a `TheSkyXTimeout` error, the mount does not park.

wtgee, 2019-10-22:
This probably just needs to implement the `blocking=True` option created in https://github.com/panoptes/POCS/pull/887. The default was left to `False` so there wouldn't be any unexpected changes from what currently existed.

Note that the parameter is currently being passed, just need to build in some kind of check and timeout.

https://github.com/panoptes/POCS/blob/develop/pocs/mount/bisque.py#L206-L223

wtgee, 2019-10-23:
Related: https://github.com/AstroHuntsman/huntsman-pocs/issues/102

wtgee, 2019-10-23:
Not recreating this either.  Seems like with #916 and #917 there was something causing that `TheSkyXTimeout` to occur, which was making each of the commands fail. This was also before we had the odd TSX communication errors. Will leave open for now until we find out more info.

Thread 917 (2019-10-22):

bisque Mount.unpark() raises KeyError on first unpark

AnthonyHorton, 2019-10-22:
**Describe the bug**
Calling `pocs.mount.bisque.Mount.unpark()` results in `KeyError: 'success'` when called after `.initialize()`.

**To Reproduce**
Steps to reproduce the behavior:
1. Create a new instance of the `bisque` `Mount`.
2. Call `Mount.initialize()`
3. Call `Mount.unpark()`
4. Mount is now unparked, but `KeyError: 'success'` has been raised.

**Expected behavior**
Mount unparked without a `KeyError`.

**Related Issues**
#916

wtgee, 2019-10-23:
Not able to recreate this on first attempt. Will leave open for now as explore more.

wtgee, 2019-10-23:
@AnthonyHorton  Was this done when mount was not homed?

Thread 924 (2019-10-28):

Add defocus option to camera Focusers

AnthonyHorton, 2019-10-28:
**Is your feature request related to a problem? Please describe.**
For precision photometry of bright targets it can be advantageous to deliberately defocus the images. While this can be done manually (with the `.move_by()` method of `Focuser` classes) it will be overidden by the autofocus that gets triggered at the start of POCS observations.

**Describe the solution you'd like**
The `Focuser` classes should have an option to apply a set amount of defocus at the end of the autofocus sequence. The amount of defocus that is applied should be configurable on a per camera basis, and it should be possible to enable/disable defocus for specific targets. Ideally it would be possible to scale the amount of defocus, relative to each camera's default defocus, on a per target basis (brighter target may benefit from more defocus, while fainter ones may want less to reduce the read noise penalty).

**Describe alternatives you've considered**
'Manual' observing to avoid the triggering of autofocus. This has been done once with Huntsman and the large amount of lost automation makes this far from ideal.

**Additional context**

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

wtgee, 2019-10-28:
@AnthonyHorton what does "relative to each camera's default defocus" look like? Number of steps or some kind of percentage?

AnthonyHorton, 2019-10-31:
@wtgee My thinking is that each camera, in its config, has a default amount of defocus in terms of  number of encoder steps, and then targets can apply a multiplier to that default if they want more or less than the default amount of defocus.

Thread 926 (2019-11-14):

Making pocs script check if docker containers are already running

zacharyt20, 2019-11-14:
The ```pocs``` bash script that starts the docker containers should check if containers are already running. Currently, it only checks for this when ```bin/pocs up -d``` is used but doesn't when ```bin/pocs up``` is used.

**Describe the solution you'd like**
Use an if statement evaluating the output of ```docker ps``` to check if docker containers are already running and exit the script early with an error if they are.

wtgee, 2019-11-14:
Hi @zacharyt20, thanks for the Issue.

> Currently, it only checks for this when bin/pocs up -d is used but doesn't when bin/pocs up is used.

There shouldn't be any difference between the two so I'm curious as to what evidence you saw that there was a difference?

Note that `bin/pocs-cmd` does currently check if running, so the same code could probably work.

In general we should list some things that are desired for the start up, e.g. not start up the weather if not weather station, check for proper config, etc.

zacharyt20, 2019-11-14:
Hi @wtgee ,
I just re-tested the commands again on our unit and they are behaving the same way. Initially I didn't see the first output of ```bin/pocs up -d``` because of all the log messages.

Just by looking at the output that I had missed, ```bin/pocs up``` detects if containers have been started and gives a different text output, but still tries to load the containers. I was just looking in ```bin/pocs-cmd``` and it looks like it is meant to start the docker containers, but I don't see it called in ```bin/pocs```.  Is it called somewhere else and is it even connected to ```bin/pocs```?

I agree that giving the user the ability to specify which containers to start would be a great addition. I know the POCS shell uses a simulator system, would we need to simulate a sensor or simply not have it load?

Also, I think that determining whether or not docker containers are running should be the first thing that happens in the script.

wtgee, 2019-11-14:
> I was just looking in `bin/pocs-cmd` and it looks like it is meant to start the docker containers, but I don't see it called in `bin/pocs`. Is it called somewhere else and is it even connected to `bin/pocs`?

It doesn't start the containers, it just checks if started or not here:
https://github.com/panoptes/POCS/blob/bfe33157431ec2c72ce7cd6d9193ff7b1884355f/bin/pocs-cmd#L6-L8

The idea with `pocs-cmd` is that it will run a command inside the container from outside the container.  This is what `docker exec` does. So, for instance, if you want to run `jupyter-console` inside the `pocs-shell` container, you call `bin/pocs-cmd jupyter-console` from _outside_ the container, that is, just from the regular command line.

> Also, I think that determining whether or not docker containers are running should be the first thing that happens in the script.

Yes, agreed. I'm not sure how that hasn't come up before.  Want to take a stab at a PR? :wink:

zacharyt20, 2019-11-14:
@wtgee  [Its](https://github.com/zacharyt20/POCS/pull/1) up, but my bash scripting could use some work! (See issue in comments of pocs file on the PR)

wtgee, 2020-02-17:
Will be closed by #951

wtgee, 2020-06-01:
Pulled into #951. Thanks @zacharyt20!

Closed 2020-06-01.

Thread 933 (2019-12-11):

POCS-SHELL: reset_pocs bypasses exit's safety functions

zacharyt20, 2019-12-11:
*In the docker version of POCS, the `pocs-shell` can be exited quickly by using `reset_pocs` before entering `exit`. If the user accidentally types `reset_pocs` while the mount is in the home position, the mount does not automatically park itself, and does not warn the user. This is dangerous as the camera's can be easily damaged if left in the home position during the day. If a unit isn't using an external webcam to monitor the unit, this would likely go unnoticed.*

**Solution**
Warn the user if they try running `reset_pocs` while the mount is not in the park position, and do not execute `reset_pocs`. Allow the user to enter `reset_pocs` again (twice in a row) to reset the pocs instance from anywhere.

**Alternatives**
*Have reset_pocs park the unit before resetting the pocs instance.*
I think this shouldn't be implemented because the purpose of `reset_pocs` is to allow the user to throw away a dysfunctional pocs instance for debugging or troubleshooting purposes. I don't think it would be a good idea to add a possibility that `reset_pocs` fails because the park function throws an error.

**Home and Park Position**
Home position: Head unit is up right and cameras are pointed toward polaris(sky)
Park position: Cameras are facing down towards the ground and the RA axis is horizontal to the ground. It is the safe position for the telescope, where the cameras can't be damaged.

**Reproduce**
Enter the pocs-shell and setup pocs.
Unpark the mount and get it into the home position through `go_home`. (Note: We first found this issue after running the `polar_alignment_test`
Enter `reset_pocs`.

wtgee, 2020-02-17:
Will be closed by #951

wtgee, 2020-06-01:
Closed by #951. Please re-open if necessary after testing.

Closed 2020-06-01.

Thread 941 (2020-02-03):

prepare POCS for a filterwheel mode

lspitler, 2020-02-03:
*Modify POCS to accommodate Filterwheels.*

**Describe the solution you'd like**
Here are the tasks:

- [ ] when stepping through e.g. `target.yaml` each target can have an optional `filter_name` key/name that specifies the desired filter for a target
- [ ] Modify `target.yaml` parser to accommodate the `filter_name` key.
- [ ] Modify Observation class to add an optional filter_name arg to `scheduler.observation.Observation`.
- [ ] In `camera.take_observation`, if `filter_name` was specified and if `filter_wheel_exists=True`, then run `camera.move_to(filter_name)`

- [ ] In `filter_wheel.config`, for each filterwheel require a filter_wheel configure to have a `default_filter_name` taht will be used if someone doesn't speicify `filter_name` in `targets.yaml`
- [ ] Modify the camera initialisation so it sets up a filterwheel.

**Related Issues/PRs**
If there are any related Issues or PRs list them here:
##### Depends on: #940

danjampro, 2020-02-03:
"Modify target.yaml parser to accommodate the filter_name key."

I believe this is done automatically in `pocs.scheduler.scheduler.add_observation`

Also by targets.yaml, we are referring to the value of `fields_file` in the config

AnthonyHorton, 2020-02-03:
> Modify the camera initialisation so it sets up a filterwheel.

Not necessary, that code has been there a while. There just needs to be a filterwheel configuration in the camera config.

wtgee, 2020-05-29:
@danjampro and @AnthonyHorton how is this Issue in relation to the work that has been done?

Thread 953 (2020-02-16):

Review camera timestamp issues.

wtgee, 2020-02-16:
We should do a thorough review of the timestamp entries that are going into FITS headers as well as the timestamped file name.  We should also have a single source of truth for time on a given system (which should by synced with a GPS or NTP).

See #892

Thread 954 (2020-02-19):

POCS CLI

wtgee, 2020-02-19:
## Current Setup
POCS and PEAS are currently controlled via custom shell utilities. These utilities are responsible for:

* Setup/Initialization:
  * POCS:
    * The `POCS` instance, which includes the `Observatory` (which includes the `mount`, `cameras`, `scheduler`, etc.).
  * PEAS:
    * The weather station.
    * The "control board" for power monitoring and relay.
    * The "camera board" for power monitoring and relay of camera box.

* Monitoring:
  * PEAS: via the `last_reading weather`, `last_reading control_board`, etc. This simply shows the most recent entry from the stored reading (a flat json file).

* Control:
  * POCS: via the `run_pocs` command, which blocks until system is shut down. Killing the command (`Ctrl-C`) will power down POCS, which importantly includes making sure the mount is parked.

Both the POCS shell and the PEAS shell are contained shell applications so they must be run in different terminals.  Additionally we usually tail the log files in a separate terminal.

Currently the POCS and PEAS shells hold the reference to the various object instances. The proposed solution would involve creating a daemonized instance of these objects, with the command line interface accessing the daemon. These daemons are running inside docker containers.

### Sample session - current setup

PEAS:
```bash
$ bin/peas-shell
Welcome to PEAS Shell! Type ? for help
PEAS > load_weather
Loading weather reader endpoint

PEAS > load_control_board
Loading control board sensor

PEAS > start
Starting sensors

PEAS > last_reading weather
********************************************************************************
WEATHER:
{'_id': 'dc643cb9-4f1d-44bb-9248-423132c3dc19',
 'data': {'ambient_temp_C': 7.25,
          'date': '20200219T014309',
          ...snip....
          'wind_speed_KPH': 46.0},
 'date': datetime.datetime(2020, 2, 19, 1, 43, 10, 36000),
 'type': 'weather'}
********************************************************************************
3.9 seconds old

PEAS > last_reading control_board
********************************************************************************
CONTROL_BOARD:
{'_id': '7ba5843a-d5d0-4f2b-8672-121a89278a08',
 'data': {
          'current': {'cameras': 82, 'fan': 22, 'main': 522, 'mount': 128},
          'date': '2020-02-19T01:43:17 GMT',
          'humidity': 1.0,
          ...snip...
  },
 'type': 'control_board'}
********************************************************************************
0.5 seconds old
PEAS >
```

POCS:
```bash
$ bin/pocs-shell
Welcome to POCS Shell! Type ? for help
POCS > setup_pocs

POCS > run_pocs
Starting POCS - Press Ctrl-c to interrupt
```

## Proposed solution
A non-blocking POCS CLI that can handle the above tasks as well as allow for future development.

Here are some examples (this does not necessarily represent a true workflow):

```bash
$ pocs weather load

$ pocs weather status
********************************************************************************
WEATHER:
{'_id': '0a6496ea-0955-4edd-91a9-36f9a6ae079f',
 'data': {'ambient_temp_C': 7.25,
          'date': '20200218T102906',
         ...snip...
         'wind_speed_KPH': 46.0},
 'date': datetime.datetime(2020, 2, 18, 10, 29, 6, 521000),
 'type': 'weather'}
********************************************************************************
58.6 seconds old

$ pocs weather # same as status

$ pocs control_board load
$ pocs control_board  # shows status

$ pocs observatory load
$ pocs observatory status

$ pocs mount unpark
$ pocs mount go_home
$ pocs mount park

$ pocs status

$ pocs setup
$ pocs run
```

## Describe alternatives you've considered
An [electron](https://www.electronjs.org/) app.

Just improve the existing shell utilities.

## Additional context
This needs to be done after the merge of #951.

## Related Issues/PRs
If there are any related Issues or PRs list them here:

Closes #592

##### Depends on:
#951

##### Required by:
[`Milestone v1.0.0`](https://github.com/panoptes/POCS/milestone/2)

##### Fixes
Should include #313

wtgee, 2020-02-19:
Comments from existing users/builders welcome.

ImmortalRabbit, 2020-02-20:
@wtgee It was mentioned that this project idea requires knowledge of Linux. Will I able to complete this task on mac os x or working on Linux is required? I guess docker will be on Linux but can I complete this task using OSX?

wtgee, 2020-02-20:
> @wtgee It was mentioned that this project idea requires knowledge of Linux. Will I able to complete this task on mac os x or working on Linux is required? I guess docker will be on Linux but can I complete this task using OSX?

Good question @ImmortalRabbit. It could probably be done on a Mac and the Linux should probably just say "shell" or "bash" instead. I'll change the website. Thanks!

We'll find out tomorrow if we're accepted so hopefully we can provide more then!

ImmortalRabbit, 2020-02-20:
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

Will this task require any kind of coverage tests? The task description didn't mention anything about pytest and nothing about how CLI should be tested.

P.S. I hope PANOPTES will be accepted. It was a pleasure to work on PANOPTES last summer.

wtgee, 2023-05-23:
Much of this has been done and the rest is probably stale. Closing this particular issue, please open a new issue for further items with the cli.

Closed 2023-05-23.

Thread 960 (2020-03-03):

Installation dependency problems

ImmortalRabbit, 2020-03-03:
**Describe the bug**
During the installation of requirements.txt. The library readline is not installing. According to the documentation of readline 2.6.4.1(latest), it has no updates since 2012. Also, it was suggested by readline docs to switch to "gunreadline" which has no problem with installation on mac. 

readline: https://pypi.org/project/readline/
gnureadline: https://pypi.org/project/gnureadline/

**To Reproduce**
Steps to reproduce the behavior:
1. OS: macOS Catalina 10.15.2
2. pip install readline
3. See error

**Expected behavior**
A clear and concise description of what you expected to happen.

**Related Issues**
Please link any related Issues if known.

**Screenshots**
installation using pycharm
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

**Additional context**
@wtgee @jamessynge

`pip install readline`
Command line installation failure output log.
```
Collecting readline
  Using cached readline-6.2.4.1.tar.gz (2.3 MB)
Building wheels for collected packages: readline
  Building wheel for readline (setup.py) ... error
  ERROR: Command errored out with exit status 1:
   command: /Users/demezhanmarikov/anaconda3/envs/panoptes-env/bin/python -u -c 'import sys, setuptools, tokenize; sys.argv[0] = '"'"'/private/var/folders/bs/w4srrnr90vn6pvtr7hf270nh0000gn/T/pip-install-fa5t1tga/readline/setup.py'"'"'; __file__='"'"'/private/var/folders/bs/w4srrnr90vn6pvtr7hf270nh0000gn/T/pip-install-fa5t1tga/readline/setup.py'"'"';f=getattr(tokenize, '"'"'open'"'"', open)(__file__);code=f.read().replace('"'"'\r\n'"'"', '"'"'\n'"'"');f.close();exec(compile(code, __file__, '"'"'exec'"'"'))' bdist_wheel -d /private/var/folders/bs/w4srrnr90vn6pvtr7hf270nh0000gn/T/pip-wheel-t8ev4_dq
       cwd: /private/var/folders/bs/w4srrnr90vn6pvtr7hf270nh0000gn/T/pip-install-fa5t1tga/readline/
  Complete output (241 lines):

  ============ Building the readline library ============

  x readline-6.2/
  x readline-6.2/doc/
  x readline-6.2/doc/Makefile.in
  x readline-6.2/doc/texinfo.tex
  x readline-6.2/doc/version.texi
  x readline-6.2/doc/fdl.texi
  x readline-6.2/doc/rlman.texi
  x readline-6.2/doc/rltech.texi
  x readline-6.2/doc/rluser.texi
  x readline-6.2/doc/rluserman.texi
  x readline-6.2/doc/history.texi
  x readline-6.2/doc/hstech.texi
  x readline-6.2/doc/hsuser.texi
  x readline-6.2/doc/readline.3
  x readline-6.2/doc/history.3
  x readline-6.2/doc/texi2dvi
  x readline-6.2/doc/texi2html
  x readline-6.2/doc/readline.ps
  x readline-6.2/doc/history.ps
  x readline-6.2/doc/rluserman.ps
  x readline-6.2/doc/readline.dvi
  x readline-6.2/doc/history.dvi
  x readline-6.2/doc/rluserman.dvi
  x readline-6.2/doc/readline.info
  x readline-6.2/doc/history.info
  x readline-6.2/doc/rluserman.info
  x readline-6.2/doc/readline.html
  x readline-6.2/doc/history.html
  x readline-6.2/doc/rluserman.html
  x readline-6.2/doc/readline.0
  x readline-6.2/doc/history.0
  x readline-6.2/doc/readline_3.ps
  x readline-6.2/doc/history_3.ps
  x readline-6.2/doc/history.pdf
  x readline-6.2/doc/readline.pdf
  x readline-6.2/doc/rluserman.pdf
  x readline-6.2/examples/
  x readline-6.2/examples/autoconf/
  x readline-6.2/examples/autoconf/BASH_CHECK_LIB_TERMCAP
  x readline-6.2/examples/autoconf/RL_LIB_READLINE_VERSION
  x readline-6.2/examples/autoconf/wi_LIB_READLINE
  x readline-6.2/examples/rlfe/
  x readline-6.2/examples/rlfe/ChangeLog
  x readline-6.2/examples/rlfe/Makefile.in
  x readline-6.2/examples/rlfe/README
  x readline-6.2/examples/rlfe/config.h.in
  x readline-6.2/examples/rlfe/configure
  x readline-6.2/examples/rlfe/configure.in
  x readline-6.2/examples/rlfe/extern.h
  x readline-6.2/examples/rlfe/os.h
  x readline-6.2/examples/rlfe/pty.c
  x readline-6.2/examples/rlfe/rlfe.c
  x readline-6.2/examples/rlfe/screen.h
  x readline-6.2/examples/Makefile.in
  x readline-6.2/examples/excallback.c
  x readline-6.2/examples/fileman.c
  x readline-6.2/examples/manexamp.c
  x readline-6.2/examples/readlinebuf.h
  x readline-6.2/examples/rl-fgets.c
  x readline-6.2/examples/rlcat.c
  x readline-6.2/examples/rlevent.c
  x readline-6.2/examples/rltest.c
  x readline-6.2/examples/rl.c
  x readline-6.2/examples/rlptytest.c
  x readline-6.2/examples/rlversion.c
  x readline-6.2/examples/histexamp.c
  x readline-6.2/examples/Inputrc
  x readline-6.2/examples/rlwrap-0.30.tar.gz
  x readline-6.2/support/
  x readline-6.2/support/config.guess
  x readline-6.2/support/config.rpath
  x readline-6.2/support/config.sub
  x readline-6.2/support/install.sh
  x readline-6.2/support/mkdirs
  x readline-6.2/support/mkdist
  x readline-6.2/support/mkinstalldirs
  x readline-6.2/support/shobj-conf
  x readline-6.2/support/shlib-install
  x readline-6.2/support/wcwidth.c
  x readline-6.2/shlib/
  x readline-6.2/shlib/Makefile.in
  x readline-6.2/COPYING
  x readline-6.2/README
  x readline-6.2/MANIFEST
  x readline-6.2/INSTALL
  x readline-6.2/CHANGELOG
  x readline-6.2/CHANGES
  x readline-6.2/NEWS
  x readline-6.2/USAGE
  x readline-6.2/aclocal.m4
  x readline-6.2/config.h.in
  x readline-6.2/configure
  x readline-6.2/configure.in
  x readline-6.2/Makefile.in
  x readline-6.2/ansi_stdlib.h
  x readline-6.2/chardefs.h
  x readline-6.2/history.h
  x readline-6.2/histlib.h
  x readline-6.2/keymaps.h
  x readline-6.2/posixdir.h
  x readline-6.2/posixjmp.h
  x readline-6.2/readline.h
  x readline-6.2/posixselect.h
  x readline-6.2/posixstat.h
  x readline-6.2/rlconf.h
  x readline-6.2/rldefs.h
  x readline-6.2/rlmbutil.h
  x readline-6.2/rlprivate.h
  x readline-6.2/rlshell.h
  x readline-6.2/rlstdc.h
  x readline-6.2/rltty.h
  x readline-6.2/rltypedefs.h
  x readline-6.2/rlwinsize.h
  x readline-6.2/tcap.h
  x readline-6.2/tilde.h
  x readline-6.2/xmalloc.h
  x readline-6.2/bind.c
  x readline-6.2/callback.c
  x readline-6.2/compat.c
  x readline-6.2/complete.c
  x readline-6.2/display.c
  x readline-6.2/emacs_keymap.c
  x readline-6.2/funmap.c
  x readline-6.2/input.c
  x readline-6.2/isearch.c
  x readline-6.2/keymaps.c
  x readline-6.2/kill.c
  x readline-6.2/macro.c
  x readline-6.2/mbutil.c
  x readline-6.2/misc.c
  x readline-6.2/nls.c
  x readline-6.2/parens.c
  x readline-6.2/readline.c
  x readline-6.2/rltty.c
  x readline-6.2/savestring.c
  x readline-6.2/search.c
  x readline-6.2/shell.c
  x readline-6.2/signals.c
  x readline-6.2/terminal.c
  x readline-6.2/text.c
  x readline-6.2/tilde.c
  x readline-6.2/undo.c
  x readline-6.2/util.c
  x readline-6.2/vi_keymap.c
  x readline-6.2/vi_mode.c
  x readline-6.2/xfree.c
  x readline-6.2/xmalloc.c
  x readline-6.2/history.c
  x readline-6.2/histexpand.c
  x readline-6.2/histfile.c
  x readline-6.2/histsearch.c
  x readline-6.2/patchlevel
  patching file vi_mode.c
  patching file callback.c
  patching file support/shobj-conf
  patching file patchlevel
  patching file input.c
  patching file patchlevel
  patching file vi_mode.c
  patching file patchlevel
  checking build system type... i386-apple-darwin19.2.0
  checking host system type... i386-apple-darwin19.2.0

  Beginning configuration for readline-6.2 for i386-apple-darwin19.2.0

  checking whether make sets $(MAKE)... yes
  checking for gcc... gcc
  checking for C compiler default output file name...
  configure: error: in `/private/var/folders/bs/w4srrnr90vn6pvtr7hf270nh0000gn/T/pip-install-fa5t1tga/readline/rl/readline-lib':
  configure: error: C compiler cannot create executables
  See `config.log' for more details.

  ============ Building the readline extension module ============

  running bdist_wheel
  running build
  running build_ext
  building 'readline' extension
  creating build
  creating build/temp.macosx-10.9-x86_64-3.7
  creating build/temp.macosx-10.9-x86_64-3.7/Modules
  creating build/temp.macosx-10.9-x86_64-3.7/Modules/3.x
  gcc -Wno-unused-result -Wsign-compare -Wunreachable-code -DNDEBUG -g -fwrapv -O3 -Wall -Wstrict-prototypes -I/Users/demezhanmarikov/anaconda3/envs/panoptes-env/include -I/Users/demezhanmarikov/anaconda3/envs/panoptes-env/include -DHAVE_RL_CALLBACK -DHAVE_RL_CATCH_SIGNAL -DHAVE_RL_COMPLETION_APPEND_CHARACTER -DHAVE_RL_COMPLETION_DISPLAY_MATCHES_HOOK -DHAVE_RL_COMPLETION_MATCHES -DHAVE_RL_COMPLETION_SUPPRESS_APPEND -DHAVE_RL_PRE_INPUT_HOOK -I. -I/Users/demezhanmarikov/anaconda3/envs/panoptes-env/include/python3.7m -c Modules/3.x/readline.c -o build/temp.macosx-10.9-x86_64-3.7/Modules/3.x/readline.o -Wno-strict-prototypes -arch i386 -arch x86_64
  Modules/3.x/readline.c:842:19: warning: initializing 'char *' with an expression of type 'const char *' discards qualifiers [-Wincompatible-pointer-types-discards-qualifiers]
              char *s = _PyUnicode_AsString(r);
                    ^   ~~~~~~~~~~~~~~~~~~~~~~
  Modules/3.x/readline.c:914:24: warning: 'Function' is deprecated [-Wdeprecated-declarations]
      rl_startup_hook = (Function *)on_startup_hook;
                         ^
  /Users/demezhanmarikov/anaconda3/envs/panoptes-env/include/readline/rltypedefs.h:35:41: note: 'Function' has been explicitly marked deprecated here
  typedef int Function () __attribute__ ((deprecated));
                                          ^
  Modules/3.x/readline.c:916:26: warning: 'Function' is deprecated [-Wdeprecated-declarations]
      rl_pre_input_hook = (Function *)on_pre_input_hook;
                           ^
  /Users/demezhanmarikov/anaconda3/envs/panoptes-env/include/readline/rltypedefs.h:35:41: note: 'Function' has been explicitly marked deprecated here
  typedef int Function () __attribute__ ((deprecated));
                                          ^
  Modules/3.x/readline.c:919:41: warning: 'CPPFunction' is deprecated [-Wdeprecated-declarations]
      rl_attempted_completion_function = (CPPFunction *)flex_complete;
                                          ^
  /Users/demezhanmarikov/anaconda3/envs/panoptes-env/include/readline/rltypedefs.h:38:47: note: 'CPPFunction' has been explicitly marked deprecated here
  typedef char **CPPFunction () __attribute__ ((deprecated));
                                                ^
  Modules/3.x/readline.c:1179:34: warning: incompatible pointer types assigning to 'char *(*)(FILE *, FILE *, const char *)' (aka 'char *(*)(struct __sFILE *, struct __sFILE *, const char *)') from 'char *(FILE *, FILE *, char *)' (aka 'char *(struct __sFILE *, struct __sFILE *, char *)') [-Wincompatible-pointer-types]
      PyOS_ReadlineFunctionPointer = call_readline;
                                   ^ ~~~~~~~~~~~~~
  5 warnings generated.
  Modules/3.x/readline.c:842:19: warning: initializing 'char *' with an expression of type 'const char *' discards qualifiers [-Wincompatible-pointer-types-discards-qualifiers]
              char *s = _PyUnicode_AsString(r);
                    ^   ~~~~~~~~~~~~~~~~~~~~~~
  Modules/3.x/readline.c:914:24: warning: 'Function' is deprecated [-Wdeprecated-declarations]
      rl_startup_hook = (Function *)on_startup_hook;
                         ^
  /Users/demezhanmarikov/anaconda3/envs/panoptes-env/include/readline/rltypedefs.h:35:41: note: 'Function' has been explicitly marked deprecated here
  typedef int Function () __attribute__ ((deprecated));
                                          ^
  Modules/3.x/readline.c:916:26: warning: 'Function' is deprecated [-Wdeprecated-declarations]
      rl_pre_input_hook = (Function *)on_pre_input_hook;
                           ^
  /Users/demezhanmarikov/anaconda3/envs/panoptes-env/include/readline/rltypedefs.h:35:41: note: 'Function' has been explicitly marked deprecated here
  typedef int Function () __attribute__ ((deprecated));
                                          ^
  Modules/3.x/readline.c:919:41: warning: 'CPPFunction' is deprecated [-Wdeprecated-declarations]
      rl_attempted_completion_function = (CPPFunction *)flex_complete;
                                          ^
  /Users/demezhanmarikov/anaconda3/envs/panoptes-env/include/readline/rltypedefs.h:38:47: note: 'CPPFunction' has been explicitly marked deprecated here
  typedef char **CPPFunction () __attribute__ ((deprecated));
                                                ^
  Modules/3.x/readline.c:1179:34: warning: incompatible pointer types assigning to 'char *(*)(FILE *, FILE *, const char *)' (aka 'char *(*)(struct __sFILE *, struct __sFILE *, const char *)') from 'char *(FILE *, FILE *, char *)' (aka 'char *(struct __sFILE *, struct __sFILE *, char *)') [-Wincompatible-pointer-types]
      PyOS_ReadlineFunctionPointer = call_readline;
                                   ^ ~~~~~~~~~~~~~
  5 warnings generated.
  creating build/lib.macosx-10.9-x86_64-3.7
  gcc -bundle -undefined dynamic_lookup -L/Users/demezhanmarikov/anaconda3/envs/panoptes-env/lib -L/Users/demezhanmarikov/anaconda3/envs/panoptes-env/lib -arch x86_64 build/temp.macosx-10.9-x86_64-3.7/Modules/3.x/readline.o readline/libreadline.a readline/libhistory.a -lncurses -o build/lib.macosx-10.9-x86_64-3.7/readline.cpython-37m-darwin.so -arch i386 -arch x86_64
  clang: error: no such file or directory: 'readline/libreadline.a'
  clang: error: no such file or directory: 'readline/libhistory.a'
  error: command 'gcc' failed with exit status 1
  ----------------------------------------
  ERROR: Failed building wheel for readline
  Running setup.py clean for readline
Failed to build readline
Installing collected packages: readline
    Running setup.py install for readline ... error
    ERROR: Command errored out with exit status 1:
     command: /Users/demezhanmarikov/anaconda3/envs/panoptes-env/bin/python -u -c 'import sys, setuptools, tokenize; sys.argv[0] = '"'"'/private/var/folders/bs/w4srrnr90vn6pvtr7hf270nh0000gn/T/pip-install-fa5t1tga/readline/setup.py'"'"'; __file__='"'"'/private/var/folders/bs/w4srrnr90vn6pvtr7hf270nh0000gn/T/pip-install-fa5t1tga/readline/setup.py'"'"';f=getattr(tokenize, '"'"'open'"'"', open)(__file__);code=f.read().replace('"'"'\r\n'"'"', '"'"'\n'"'"');f.close();exec(compile(code, __file__, '"'"'exec'"'"'))' install --record /private/var/folders/bs/w4srrnr90vn6pvtr7hf270nh0000gn/T/pip-record-ovp0ljf0/install-record.txt --single-version-externally-managed --compile --install-headers /Users/demezhanmarikov/anaconda3/envs/panoptes-env/include/python3.7m/readline
         cwd: /private/var/folders/bs/w4srrnr90vn6pvtr7hf270nh0000gn/T/pip-install-fa5t1tga/readline/
    Complete output (241 lines):

    ============ Building the readline library ============

    x readline-6.2/
    x readline-6.2/doc/
    x readline-6.2/doc/Makefile.in
    x readline-6.2/doc/texinfo.tex
    x readline-6.2/doc/version.texi
    x readline-6.2/doc/fdl.texi
    x readline-6.2/doc/rlman.texi
    x readline-6.2/doc/rltech.texi
    x readline-6.2/doc/rluser.texi
    x readline-6.2/doc/rluserman.texi
    x readline-6.2/doc/history.texi
    x readline-6.2/doc/hstech.texi
    x readline-6.2/doc/hsuser.texi
    x readline-6.2/doc/readline.3
    x readline-6.2/doc/history.3
    x readline-6.2/doc/texi2dvi
    x readline-6.2/doc/texi2html
    x readline-6.2/doc/readline.ps
    x readline-6.2/doc/history.ps
    x readline-6.2/doc/rluserman.ps
    x readline-6.2/doc/readline.dvi
    x readline-6.2/doc/history.dvi
    x readline-6.2/doc/rluserman.dvi
    x readline-6.2/doc/readline.info
    x readline-6.2/doc/history.info
    x readline-6.2/doc/rluserman.info
    x readline-6.2/doc/readline.html
    x readline-6.2/doc/history.html
    x readline-6.2/doc/rluserman.html
    x readline-6.2/doc/readline.0
    x readline-6.2/doc/history.0
    x readline-6.2/doc/readline_3.ps
    x readline-6.2/doc/history_3.ps
    x readline-6.2/doc/history.pdf
    x readline-6.2/doc/readline.pdf
    x readline-6.2/doc/rluserman.pdf
    x readline-6.2/examples/
    x readline-6.2/examples/autoconf/
    x readline-6.2/examples/autoconf/BASH_CHECK_LIB_TERMCAP
    x readline-6.2/examples/autoconf/RL_LIB_READLINE_VERSION
    x readline-6.2/examples/autoconf/wi_LIB_READLINE
    x readline-6.2/examples/rlfe/
    x readline-6.2/examples/rlfe/ChangeLog
    x readline-6.2/examples/rlfe/Makefile.in
    x readline-6.2/examples/rlfe/README
    x readline-6.2/examples/rlfe/config.h.in
    x readline-6.2/examples/rlfe/configure
    x readline-6.2/examples/rlfe/configure.in
    x readline-6.2/examples/rlfe/extern.h
    x readline-6.2/examples/rlfe/os.h
    x readline-6.2/examples/rlfe/pty.c
    x readline-6.2/examples/rlfe/rlfe.c
    x readline-6.2/examples/rlfe/screen.h
    x readline-6.2/examples/Makefile.in
    x readline-6.2/examples/excallback.c
    x readline-6.2/examples/fileman.c
    x readline-6.2/examples/manexamp.c
    x readline-6.2/examples/readlinebuf.h
    x readline-6.2/examples/rl-fgets.c
    x readline-6.2/examples/rlcat.c
    x readline-6.2/examples/rlevent.c
    x readline-6.2/examples/rltest.c
    x readline-6.2/examples/rl.c
    x readline-6.2/examples/rlptytest.c
    x readline-6.2/examples/rlversion.c
    x readline-6.2/examples/histexamp.c
    x readline-6.2/examples/Inputrc
    x readline-6.2/examples/rlwrap-0.30.tar.gz
    x readline-6.2/support/
    x readline-6.2/support/config.guess
    x readline-6.2/support/config.rpath
    x readline-6.2/support/config.sub
    x readline-6.2/support/install.sh
    x readline-6.2/support/mkdirs
    x readline-6.2/support/mkdist
    x readline-6.2/support/mkinstalldirs
    x readline-6.2/support/shobj-conf
    x readline-6.2/support/shlib-install
    x readline-6.2/support/wcwidth.c
    x readline-6.2/shlib/
    x readline-6.2/shlib/Makefile.in
    x readline-6.2/COPYING
    x readline-6.2/README
    x readline-6.2/MANIFEST
    x readline-6.2/INSTALL
    x readline-6.2/CHANGELOG
    x readline-6.2/CHANGES
    x readline-6.2/NEWS
    x readline-6.2/USAGE
    x readline-6.2/aclocal.m4
    x readline-6.2/config.h.in
    x readline-6.2/configure
    x readline-6.2/configure.in
    x readline-6.2/Makefile.in
    x readline-6.2/ansi_stdlib.h
    x readline-6.2/chardefs.h
    x readline-6.2/history.h
    x readline-6.2/histlib.h
    x readline-6.2/keymaps.h
    x readline-6.2/posixdir.h
    x readline-6.2/posixjmp.h
    x readline-6.2/readline.h
    x readline-6.2/posixselect.h
    x readline-6.2/posixstat.h
    x readline-6.2/rlconf.h
    x readline-6.2/rldefs.h
    x readline-6.2/rlmbutil.h
    x readline-6.2/rlprivate.h
    x readline-6.2/rlshell.h
    x readline-6.2/rlstdc.h
    x readline-6.2/rltty.h
    x readline-6.2/rltypedefs.h
    x readline-6.2/rlwinsize.h
    x readline-6.2/tcap.h
    x readline-6.2/tilde.h
    x readline-6.2/xmalloc.h
    x readline-6.2/bind.c
    x readline-6.2/callback.c
    x readline-6.2/compat.c
    x readline-6.2/complete.c
    x readline-6.2/display.c
    x readline-6.2/emacs_keymap.c
    x readline-6.2/funmap.c
    x readline-6.2/input.c
    x readline-6.2/isearch.c
    x readline-6.2/keymaps.c
    x readline-6.2/kill.c
    x readline-6.2/macro.c
    x readline-6.2/mbutil.c
    x readline-6.2/misc.c
    x readline-6.2/nls.c
    x readline-6.2/parens.c
    x readline-6.2/readline.c
    x readline-6.2/rltty.c
    x readline-6.2/savestring.c
    x readline-6.2/search.c
    x readline-6.2/shell.c
    x readline-6.2/signals.c
    x readline-6.2/terminal.c
    x readline-6.2/text.c
    x readline-6.2/tilde.c
    x readline-6.2/undo.c
    x readline-6.2/util.c
    x readline-6.2/vi_keymap.c
    x readline-6.2/vi_mode.c
    x readline-6.2/xfree.c
    x readline-6.2/xmalloc.c
    x readline-6.2/history.c
    x readline-6.2/histexpand.c
    x readline-6.2/histfile.c
    x readline-6.2/histsearch.c
    x readline-6.2/patchlevel
    patching file vi_mode.c
    patching file callback.c
    patching file support/shobj-conf
    patching file patchlevel
    patching file input.c
    patching file patchlevel
    patching file vi_mode.c
    patching file patchlevel
    checking build system type... i386-apple-darwin19.2.0
    checking host system type... i386-apple-darwin19.2.0

    Beginning configuration for readline-6.2 for i386-apple-darwin19.2.0

    checking whether make sets $(MAKE)... yes
    checking for gcc... gcc
    checking for C compiler default output file name...
    configure: error: in `/private/var/folders/bs/w4srrnr90vn6pvtr7hf270nh0000gn/T/pip-install-fa5t1tga/readline/rl/readline-lib':
    configure: error: C compiler cannot create executables
    See `config.log' for more details.

    ============ Building the readline extension module ============

    running install
    running build
    running build_ext
    building 'readline' extension
    creating build
    creating build/temp.macosx-10.9-x86_64-3.7
    creating build/temp.macosx-10.9-x86_64-3.7/Modules
    creating build/temp.macosx-10.9-x86_64-3.7/Modules/3.x
    gcc -Wno-unused-result -Wsign-compare -Wunreachable-code -DNDEBUG -g -fwrapv -O3 -Wall -Wstrict-prototypes -I/Users/demezhanmarikov/anaconda3/envs/panoptes-env/include -I/Users/demezhanmarikov/anaconda3/envs/panoptes-env/include -DHAVE_RL_CALLBACK -DHAVE_RL_CATCH_SIGNAL -DHAVE_RL_COMPLETION_APPEND_CHARACTER -DHAVE_RL_COMPLETION_DISPLAY_MATCHES_HOOK -DHAVE_RL_COMPLETION_MATCHES -DHAVE_RL_COMPLETION_SUPPRESS_APPEND -DHAVE_RL_PRE_INPUT_HOOK -I. -I/Users/demezhanmarikov/anaconda3/envs/panoptes-env/include/python3.7m -c Modules/3.x/readline.c -o build/temp.macosx-10.9-x86_64-3.7/Modules/3.x/readline.o -Wno-strict-prototypes -arch i386 -arch x86_64
    Modules/3.x/readline.c:842:19: warning: initializing 'char *' with an expression of type 'const char *' discards qualifiers [-Wincompatible-pointer-types-discards-qualifiers]
                char *s = _PyUnicode_AsString(r);
                      ^   ~~~~~~~~~~~~~~~~~~~~~~
    Modules/3.x/readline.c:914:24: warning: 'Function' is deprecated [-Wdeprecated-declarations]
        rl_startup_hook = (Function *)on_startup_hook;
                           ^
    /Users/demezhanmarikov/anaconda3/envs/panoptes-env/include/readline/rltypedefs.h:35:41: note: 'Function' has been explicitly marked deprecated here
    typedef int Function () __attribute__ ((deprecated));
                                            ^
    Modules/3.x/readline.c:916:26: warning: 'Function' is deprecated [-Wdeprecated-declarations]
        rl_pre_input_hook = (Function *)on_pre_input_hook;
                             ^
    /Users/demezhanmarikov/anaconda3/envs/panoptes-env/include/readline/rltypedefs.h:35:41: note: 'Function' has been explicitly marked deprecated here
    typedef int Function () __attribute__ ((deprecated));
                                            ^
    Modules/3.x/readline.c:919:41: warning: 'CPPFunction' is deprecated [-Wdeprecated-declarations]
        rl_attempted_completion_function = (CPPFunction *)flex_complete;
                                            ^
    /Users/demezhanmarikov/anaconda3/envs/panoptes-env/include/readline/rltypedefs.h:38:47: note: 'CPPFunction' has been explicitly marked deprecated here
    typedef char **CPPFunction () __attribute__ ((deprecated));
                                                  ^
    Modules/3.x/readline.c:1179:34: warning: incompatible pointer types assigning to 'char *(*)(FILE *, FILE *, const char *)' (aka 'char *(*)(struct __sFILE *, struct __sFILE *, const char *)') from 'char *(FILE *, FILE *, char *)' (aka 'char *(struct __sFILE *, struct __sFILE *, char *)') [-Wincompatible-pointer-types]
        PyOS_ReadlineFunctionPointer = call_readline;
                                     ^ ~~~~~~~~~~~~~
    5 warnings generated.
    Modules/3.x/readline.c:842:19: warning: initializing 'char *' with an expression of type 'const char *' discards qualifiers [-Wincompatible-pointer-types-discards-qualifiers]
                char *s = _PyUnicode_AsString(r);
                      ^   ~~~~~~~~~~~~~~~~~~~~~~
    Modules/3.x/readline.c:914:24: warning: 'Function' is deprecated [-Wdeprecated-declarations]
        rl_startup_hook = (Function *)on_startup_hook;
                           ^
    /Users/demezhanmarikov/anaconda3/envs/panoptes-env/include/readline/rltypedefs.h:35:41: note: 'Function' has been explicitly marked deprecated here
    typedef int Function () __attribute__ ((deprecated));
                                            ^
    Modules/3.x/readline.c:916:26: warning: 'Function' is deprecated [-Wdeprecated-declarations]
        rl_pre_input_hook = (Function *)on_pre_input_hook;
                             ^
    /Users/demezhanmarikov/anaconda3/envs/panoptes-env/include/readline/rltypedefs.h:35:41: note: 'Function' has been explicitly marked deprecated here
    typedef int Function () __attribute__ ((deprecated));
                                            ^
    Modules/3.x/readline.c:919:41: warning: 'CPPFunction' is deprecated [-Wdeprecated-declarations]
        rl_attempted_completion_function = (CPPFunction *)flex_complete;
                                            ^
    /Users/demezhanmarikov/anaconda3/envs/panoptes-env/include/readline/rltypedefs.h:38:47: note: 'CPPFunction' has been explicitly marked deprecated here
    typedef char **CPPFunction () __attribute__ ((deprecated));
                                                  ^
    Modules/3.x/readline.c:1179:34: warning: incompatible pointer types assigning to 'char *(*)(FILE *, FILE *, const char *)' (aka 'char *(*)(struct __sFILE *, struct __sFILE *, const char *)') from 'char *(FILE *, FILE *, char *)' (aka 'char *(struct __sFILE *, struct __sFILE *, char *)') [-Wincompatible-pointer-types]
        PyOS_ReadlineFunctionPointer = call_readline;
                                     ^ ~~~~~~~~~~~~~
    5 warnings generated.
    creating build/lib.macosx-10.9-x86_64-3.7
    gcc -bundle -undefined dynamic_lookup -L/Users/demezhanmarikov/anaconda3/envs/panoptes-env/lib -L/Users/demezhanmarikov/anaconda3/envs/panoptes-env/lib -arch x86_64 build/temp.macosx-10.9-x86_64-3.7/Modules/3.x/readline.o readline/libreadline.a readline/libhistory.a -lncurses -o build/lib.macosx-10.9-x86_64-3.7/readline.cpython-37m-darwin.so -arch i386 -arch x86_64
    clang: error: no such file or directory: 'readline/libreadline.a'
    clang: error: no such file or directory: 'readline/libhistory.a'
    error: command 'gcc' failed with exit status 1
    ----------------------------------------
ERROR: Command errored out with exit status 1: /Users/demezhanmarikov/anaconda3/envs/panoptes-env/bin/python -u -c 'import sys, setuptools, tokenize; sys.argv[0] = '"'"'/private/var/folders/bs/w4srrnr90vn6pvtr7hf270nh0000gn/T/pip-install-fa5t1tga/readline/setup.py'"'"'; __file__='"'"'/private/var/folders/bs/w4srrnr90vn6pvtr7hf270nh0000gn/T/pip-install-fa5t1tga/readline/setup.py'"'"';f=getattr(tokenize, '"'"'open'"'"', open)(__file__);code=f.read().replace('"'"'\r\n'"'"', '"'"'\n'"'"');f.close();exec(compile(code, __file__, '"'"'exec'"'"'))' install --record /private/var/folders/bs/w4srrnr90vn6pvtr7hf270nh0000gn/T/pip-record-ovp0ljf0/install-record.txt --single-version-externally-managed --compile --install-headers /Users/demezhanmarikov/anaconda3/envs/panoptes-env/include/python3.7m/readline Check the logs for full command output.

```

Closed 2020-06-01.

Thread 961 (2020-03-04):

Log File Upload

wtgee, 2020-03-04:
Upload log files to google.

**Describe the solution you'd like**
Log files should be rotated on some set schedule (see https://github.com/panoptes/panoptes-utils/pull/123) but after rotation they should optionally be uploaded to google servers. This can either just be a text file upload to a bucket or import into stackdriver.

**Related Issues/PRs**
#321

wtgee, 2024-05-06:
Most functionality was in #1198

Closed 2024-05-06.

Thread 963 (2020-03-06):

Reconsider Image Paths

wtgee, 2020-03-06:
| Path           | Source                                                                                                                                            |
| -------------- | ------------------------------------------------------------------------------------------------------------------------------------------------- |
| `$PANDIR`      | Env var.                                                                                                                                          |
| `images`       | [Config file](https://github.com/panoptes/POCS/blob/22532dab81745aa5b805d809b4c494bd5495bc39/conf_files/pocs.yaml#L30)                            |
| `fields`       | [`Observation`](https://github.com/panoptes/POCS/blob/22532dab81745aa5b805d809b4c494bd5495bc39/pocs/scheduler/observation.py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) **Hard-coded** |
| `<FIELD_NAME>` | [`Observation`](https://github.com/panoptes/POCS/blob/22532dab81745aa5b805d809b4c494bd5495bc39/pocs/scheduler/observation.py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) **User defined**                                                                                                                                  |
| `<CAMERA_ID>`  | [`Camera`](https://github.com/panoptes/POCS/blob/develop/pocs/camera/camera.py#L681)                                                              |
| `<SEQ_TIME>`   | [`Camera`](https://github.com/panoptes/POCS/blob/develop/pocs/camera/camera.py#L681)                                                              |
| `<IMAGE_TIME>` | [`Camera`](https://github.com/panoptes/POCS/blob/develop/pocs/camera/camera.py#L681)                                                              |

So final path for an image (for extensions `.CR2`, `.fits.fz`, `.jpg`) is:

`<IMAGES_DIR>/fields/<FIELD_NAME>/<CAM_ID>/<SEQ_TIME>/<IMAGE_TIME>.<EXT>`

and this Issue proposes:

`<IMAGES_DIR>/<CAM_ID>/<SEQ_TIME>/<IMAGE_TIME>.<EXT>`

## Tasks

* [x] Remove hard-coded 'fields'
* [x] Remove the user-custom `<FIELD_NAME>` from the path, which is currently derived from the scheduler file and is inconsistent across users.

https://github.com/panoptes/POCS/blob/22532dab81745aa5b805d809b4c494bd5495bc39/pocs/scheduler/observation.py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

Note that the actual change is easy, probably just changing the line above, but we need to do a thorough check for the repercussions of the currently assumed directory structure.

### Related

Related to #958 because the disk space check on symlinks reports different values for `/var/panoptes/images` vs `/var/panoptes/images/fields` because on `PAN001` we have symlinked the latter but we do a disk space check for the former. This reorganization of the path could solve that issue.

wtgee, 2020-06-01:
The `fields` hard-coding was removed with #951.

The pipeline ingestion code currently strips the custom field name.  Any issues related to that should be opened separately.

Closed 2020-06-01.

Thread 964 (2020-03-07):

Resolve arduino sensor base.

wtgee, 2020-03-07:
In looking over #956 I realized we have a duplication of a few features, namely the functionality in the [`ArduinoIO`](https://github.com/panoptes/POCS/blob/develop/pocs/sensors/arduino_io.py#L49) class vs that in [`peas.sensors`](https://github.com/panoptes/POCS/blob/develop/peas/sensors.py).

@jamessynge had done the work on `ArduinoIO` and I think it is a little more robust than what is in the sensors module. The sensors module was originally designed to gather all devices and loop over all of them for readings but we have switched to having devices read independently such that the sensors module and the `ArduinoIO` class largely duplicate each other.

FYI @zacharyt20.

Closed 2020-11-14.

Thread 966 (2020-04-16):

String formatting errors in exception arguments

AnthonyHorton, 2020-04-16:
**Describe the bug**
In POCS there are a few instance of

`raise ValueError("Blah, blah, blah, {}!", obj)`

where it should be

`raise ValueError("Blah, blah, blah, {}!".format(obj))`

or

`raise ValueError(f"Blah, blah, blah, {obj}!")`, e.g.

https://github.com/panoptes/POCS/blob/22532dab81745aa5b805d809b4c494bd5495bc39/pocs/focuser/focuser.py#L242 and https://github.com/panoptes/POCS/blob/22532dab81745aa5b805d809b4c494bd5495bc39/pocs/focuser/focuser.py#L249

These don't cause problems in POCS itself (beyond some funny looking exceptions) but they do cause problems for the remote cameras in huntsman-pocs, because the Pyro4 network layer ends up trying to serialise `ValueErrors` that contain, in their `args` list, a reference to an object that it can't serialise, resulting in opaque 'circular reference' exceptions from Pyro.

wtgee, 2020-04-16:
Thanks for reporting!

AnthonyHorton, 2020-04-17:
For extra credit someone should craft a regular expression for finding all instances of this! I've found four so far, but I'm not sure that's all of them.

wtgee, 2020-05-29:
Related to this we also have a number of places where we are still passing multiple arguments to the logger, as in:

```py
self.logger.debug("Here's some foo", bar)
```

They are also not really causing problems but it would be good to get them switched to f-strings.

wtgee, 2020-06-01:
I tried to take care of a lot of these in #951.

wtgee, 2020-07-07:
I think I got the rest of these in #983.  The regex doesn't turn up anything else.  Feel free to reopen.

Closed 2020-07-07.

Thread 968 (2020-05-08):

Support target tags

wtgee, 2020-05-08:
When adding a target to the scheduler it would be nice to be able to add a series of comma separated tags that would be populated into the metadata db for searching.

Ayushsunny, 2021-05-01:
hello, @wtgee is this issue still persist?

wtgee, 2021-05-10:
Hi @Ayushsunny, thanks for asking and sorry it took me a bit to get back to you.

Yes, this is still an issue and actually one that we were hoping to get done pretty soon. If you want to jump in on this, that would be great.

The basics that need to happen are:

1. Modify the `conf_files/fields/simply.yaml` file to support tags in some fashion.  A "field" currently has two top-level keys, the `field, and the `observation`.  The "tags" would most likely be a yaml list on the `observation` key, so something like:

```
-
  field:
    name: HD 189733
    position: 20h00m43.713s +22d42m39.07s
  observation:
    priority: 105
    exptime: 100
    tags:
        - exoplanet
        - defocus_test
```

2. The tags need to be parsed when adding adding an observation to the scheduler. This happens in the [`panoptes.pocs.scheduler.scheduler.add_observation`](https://github.com/panoptes/POCS/blob/e79ac499c924b0a06eb2944a347f8d9251f6db51/src/panoptes/pocs/scheduler/scheduler.py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) method.

3. These tags need to be passed into the FITS headers when writing the file. This is part of the camera and happens in the [`_setup_observation`](https://github.com/panoptes/POCS/blob/e79ac499c924b0a06eb2944a347f8d9251f6db51/src/panoptes/pocs/camera/camera.py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) and [`_process_fits`](https://github.com/panoptes/POCS/blob/e79ac499c924b0a06eb2944a347f8d9251f6db51/src/panoptes/pocs/camera/camera.py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) methods.

There are likely some more details and I'll try to look at the process a little closer later if needed, but that should be enough to make a reasonable start if interested.

Cheers!  Thanks again for reaching out!

Thread 969 (2020-05-14):

Increase level of detail in logs and exception messages when cameras not ready

AnthonyHorton, 2020-05-14:
The `AbstractCamera` base class includes a properties to check whether a camera is ready to take another exposure, `is_ready`. This property is checked in `take_exposure()`, where an exception will be raised if the camera is not ready. Currently this exception simply states that an exposure was attempted when the camera was not ready, it does not say why the camera was not ready (e.g. exposure already in progress, image sensor temperature not stable, filterwheel or focuser not ready).

The camera readiness checks also do very little logging, the only possible log message in addition to the error message from `take_exposure()` is a warning that the image sensor temperature is unstable, and even this does not include the target temperature, actual temperature and cooling power.

This lack of information is presenting a problem for Huntsman debugging, as camera not ready exceptions are being seen but lack the information to identify the root cause.

**Describe the solution you'd like**
The exception raised by `take_exposure()` if the camera is not ready to take an exposure should include the reasons why the camera was not ready. Additionally the camera logs should include full details of any failed readiness checks.

wtgee, 2020-05-29:
Actually I think that I have added a bunch of this in #950 but that was mostly motivated by the fact that I was experiencing a large number of those failures with the cameras.

Most of what I have added is related to the cooling as I had found that it was mostly a race-condition.  Unfortunately that PR is such a gigantic mess that it's hard to point to the individual change.

I'll update this issue later.

wtgee, 2020-06-01:
Closed by #951

Closed 2020-06-01.

Thread 988 (2020-07-18):

Add support for taking dark exposures using a filterwheel equipped with an opaque filter

AnthonyHorton, 2020-07-18:
**Is your feature request related to a problem? Please describe.**
Some camera types (e.g. CMOS image sensor, interline CCD) lack a internal mechanical shutter or lack the control over the shutter required to take dark exposures. If these cameras are equipped with a filterwheel containing an opaque filter then it is possible to use this block the light in order to take dark exposures, however at present this requires manually instructing the filterwheel to rotate to the opaque filter, taking the dark exposures, then manually instructing the filterwheel to rotate to another filter. This is in contrast to dark exposures taken with a camera's internal shutter, which can be taken by simply passing `dark=true` to the camera's `take_exposure()` or `take_observation()` methods.

**Describe the solution you'd like**
It should be possible to take dark exposures using an opaque filter simply by passing `dark=True` to `take_exposure()`, the same as for dark exposures taken using a camera's internal shutter. Setting `dark=True` should automatically rotate the camera's filterwheel to a named opaque filter. Taking a subsequent exposure with `dark=False` should automatically rotate the camera's filterwheel to the most recently selected non-opaque filter.

**Additional context**
This change has been prompted by the upgrade of the Huntsman Telescope to ZWO CMOS cameras which do not have internal shutters, but do have filterwheels equipped with opaque fllters.

**Related Issues/PRs**
If there are any related Issues or PRs list them here:
##### Depends on:
##### Required by:

wtgee, 2020-07-18:
Thanks @AnthonyHorton. Looking at the PR, I'm wondering if we shouldn't have some kind of expanded `pre-` and `post-take_exposure` mechanism that is easy for the cameras to override.  Ideally we could get this into some kind of decorator or plugin and ideally that would work across all our hardware types (I've been wanting to create a `PanHardwareBase` that inherits from `PanBase` and that all actual hardware inherits from, and just as soon as I have time...).

That might not be possible immediately but would be good to at least discuss what that might look like.

AnthonyHorton, 2020-07-19:
I like the idea, but it will take some thought. One thing that would complicate the implementation is that different ways of taking dark exposures require actions at different points, e.g. using an internal mechanical shutter requires setting some shutter control parameter in the camera driver during the camera's `_start_exposure()` method, while for filterwheel darks we need to call filterwheel methods during the camera's `take_exposure()` method before the call to `_start_exposure()`.

AnthonyHorton, 2020-09-03:
Closed by #989. For now. Will probably revisit this as part of a more general Camera refactorisation.

Closed 2020-09-03.

Thread 997 (2020-08-26):

docker build fails in setup-local-environment.sh

danjampro, 2020-08-26:
```
Step 24/28 : RUN mkdir -p "${PANDIR}/scripts" &&     cd "${PANDIR}/scripts" &&     wget $gphoto2_url -O gphoto2-updater.sh &&     chmod +x gphoto2-updater.sh &&     wget -q "${arduino_url}" -O install-arduino-cli.sh &&     sudo BINDIR="/usr/local/bin" /bin/sh install-arduino-cli.sh &&     sudo chown -R "${PANUSER}":"${PANUSER}" "${PANDIR}"
 ---> Running in 0c390e233bbf
--2020-08-25 23:58:52--  https://raw.githubusercontent.com/gonzalo/gphoto2-updater/master/gphoto2-updater.sh
Resolving raw.githubusercontent.com (raw.githubusercontent.com)... 151.101.28.133
Connecting to raw.githubusercontent.com (raw.githubusercontent.com)|151.101.28.133|:443... connected.
HTTP request sent, awaiting response... 200 OK
Length: 6549 (6.4K) [text/plain]
Saving to: ‘gphoto2-updater.sh’

     0K ......                                                100% 4.17M=0.001s

2020-08-25 23:58:52 (4.17 MB/s) - ‘gphoto2-updater.sh’ saved [6549/6549]

We trust you have received the usual lecture from the local System
Administrator. It usually boils down to these three things:

    #1) Respect the privacy of others.
    #2) Think before you type.
    #3) With great power comes great responsibility.

sudo: no tty present and no askpass program specified
The command '/bin/sh -c mkdir -p "${PANDIR}/scripts" &&     cd "${PANDIR}/scripts" &&     wget $gphoto2_url -O gphoto2-updater.sh &&     chmod +x gphoto2-updater.sh &&     wget -q "${arduino_url}" -O install-arduino-cli.sh &&     sudo BINDIR="/usr/local/bin" /bin/sh install-arduino-cli.sh &&     sudo chown -R "${PANUSER}":"${PANUSER}" "${PANDIR}"' returned a non-zero code: 1
```

wtgee, 2020-08-26:
Can you give details on your environment?

wtgee, 2020-11-13:
Closing as stale.

Closed 2020-11-13.

Thread 1011 (2020-10-08):

Failure to slew_to_target does not raise a PanError

danjampro, 2020-10-08:
The current behaviour of `POCS` is to log a warning message if the slew is not possible. This can obviously lead to a lot of problems down the line if not handled properly. This problem exists for the `bisque` mount as well as in the abstract `mount` class.

Suggest raising a `PanError` if the slew fails.

Code : https://github.com/panoptes/POCS/blob/e6df64bdcc482b3f10f9e424b71dfd339728e3b4/src/panoptes/pocs/mount/bisque.py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

Thread 1017 (2020-10-13):

Set _last_light_position in FWs during initialisation

danjampro, 2020-10-13:
The current behaviour for FWs is to set the `_last_light_position` only when transitioning between a light and dark filter. This means that `_last_light_position` is not necessarily set during normal usage, which can lead to errors such as the FW staying in the dark position during autofocusing.

Suggestion is either to set the initial light position explicitly in the config, or to select one from `filter_names` during initialisation.

Code: https://github.com/panoptes/POCS/blob/804e48d3e66fb6d413aef6ac2f675349bcd0f819/src/panoptes/pocs/filterwheel/filterwheel.py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

AnthonyHorton, 2020-10-13:
I'm not sure I like either suggestion.

`_last_light_position` is supposed to be the most recently used filter that is not the 'blank' used for taking darks. If the blank is the only filter that has been used since starting up it _should_ be `None`, nothing else makes sense in this context.

The fact that `_last_light_position` is initially not set is not the real problem here, the problem is that we have code that takes exposures (that are not darks) without specifying a filter. We should be fixing that instead.

Thread 1018 (2020-10-13):

Improve autofocusing filter selection

danjampro, 2020-10-13:
Currently, each camera's `_last_light_position` is used during `observatory.autofocus_cameras`. This can lead to inconsistent and buggy behaviour. The suggested change is to:
- Specify a filter for coarse autofocusing in the config
- Use the same filter used for the actual exposure during fine focusing before `take_observation`

Thread 1019 (2020-10-19):

`camera.take_observation` does not implicitly record field coordinates

danjampro, 2020-10-19:
Currently, the observation status headers are parsed to `camera.take_observation` by calling `observatory.get_standard_headers` beforehand, which records important information like `RA-MNT` and `DEC-MNT`. However, if `camera.take_observation` is called without parsing these headers, no information about the ra/dec of the `Field` gets recorded in the FITS headers, meaning there is no way to tell what the telescope was (meant to be) looking at, despite that information being already available from within `camera.take_observation`.

My code enhancement suggestion would be to add field information to the header implicitly from within `take_observation`, making use of the `Observation.Field`.

Code: https://github.com/panoptes/POCS/blob/f8e3dc6306dc68022d55014a3cccbae4a3ec3e60/src/panoptes/pocs/observatory.py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

wtgee, 2022-01-15:
See also #1002

Closed 2022-01-17.

Thread 1020 (2020-10-21):

Inconsistency between `ccd.SDKDriver` and `AbstractSDKCamera._cameras` (bug)

danjampro, 2020-10-21:
`AbstractSDKCamera._cameras` are expected to have keys of camera serial_numbers, but `ccd.SDKDriver` creates them as `name: port`. This leads to an `InvalidConfig` error.

`ccd.SDKDriver`:
https://github.com/panoptes/POCS/blob/804e48d3e66fb6d413aef6ac2f675349bcd0f819/src/panoptes/pocs/camera/simulator/ccd.py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

`AbstractSDKCamera._cameras`:
https://github.com/panoptes/POCS/blob/804e48d3e66fb6d413aef6ac2f675349bcd0f819/src/panoptes/pocs/camera/sdk.py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

Thread 1022 (2020-10-23):

Simulated DSLR camera clears exposure event before FITS file is written (bug)

danjampro, 2020-10-23:
This bug causes a minor delay between ending the exposure and writing the FITS file, which leads to errors.

Code:
https://github.com/panoptes/POCS/blob/804e48d3e66fb6d413aef6ac2f675349bcd0f819/src/panoptes/pocs/camera/simulator/dslr.py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

wtgee, 2020-10-23:
That code doesn't point to where the problem is. @danjampro can you provide more details?

Closed 2022-01-07.

Thread 1027 (2020-11-02):

Inconsistent specification of Camera/Focuser model in config.

danjampro, 2020-11-02:
Camera models are specified by file:
`panoptes.pocs.camera.zwo`
But focuser models are specified by class name:
`panoptes.pocs.focuser.birger.Focuser'

Suggest going with one or the other.

wtgee, 2020-11-03:
@danjampro where are you seeing this?  The first is specifying a namespace for the device and should have defaulted to the default class type for that namespace. But I thought I removed that syntax anyway so that you always need the fully resolved namespace.

The current config has fully resolved, for instance:

https://github.com/panoptes/POCS/blob/dc330ac98fcc01f6cd70085f50d985321c42c58e/conf_files/pocs.yaml#L90-L106

Thread 1028 (2020-11-04):

Memory leak from focuser._autofocus with plots

danjampro, 2020-11-04:
If an autofocus is run with `make_plots=True`, the resulting plot does not release its allocated memory at the end of the sequence. This has been causing out of memory errors for the Huntsman raspberry pi systems.

The code: https://github.com/panoptes/POCS/blob/dc330ac98fcc01f6cd70085f50d985321c42c58e/src/panoptes/pocs/focuser/focuser.py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

Suggested change (tested on hardware):
```
import gc

plt.cla()
plt.clf()
plt.close(fig)
gc.collect()
```

Closed 2020-11-10.

Thread 1031 (2020-11-10):

Exposure readout_thread is not accessible.

danjampro, 2020-11-10:
The readout thread is not accessible from outside of `take_exposure`. This means it is impossible to consistently wait for a non-blocking exposure to finish reading out.
Code:
https://github.com/panoptes/POCS/blob/d8e69ae2e8012009f59decf45f9a121588735839/src/panoptes/pocs/camera/camera.py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
Suggested change:
Return the readout event rather than `is_exposing_event`.

wtgee, 2020-11-11:
Closed by #1032

Closed 2020-11-11.

Thread 1047 (2020-12-14):

Unit tests not catching major problems

danjampro, 2020-12-14:
While tests are passing with a relatively high code coverage, several major problems with basic usage were uncovered while testing on Huntsman last week. This includes problems with e.g.:

- The state machine
- Exposure timeouts
- Bisque mounts

A lot of this may be down to the `POCS` ethos of logging warnings rather than raising (and possibly catching) errors, combined with tests that gloss over the underlying issues and pass when they really shouldn't. I believe we either need to improve our tests or start raising more errors rather than warnings.

Thread 1061 (2021-01-11):

pocs.observatory.mount.slew_to_coordinates not working when coords are in SkyCoord format (as it's required)

JAAlvarado-Montes, 2021-01-11:
**Describe the bug**
pocs.observatory.mount.slew_to_coordinates requires coordinates to be in SkyCoord format. However, even when using the coordinates in this format the function rises an `AssertionError` error saying that the coordinates are not a tuple.

**To Reproduce**
Steps to reproduce the behavior:
coords = SkyCoord(300, -60, unit="deg")
pocs.observatory.mount.slew_to_coordinates(coords)

Tests are not passing in https://github.com/AstroHuntsman/huntsman-pocs/pull/287

JAAlvarado-Montes, 2021-01-13:
Closed by #1063

Closed 2021-01-13.

Thread 1067 (2021-01-19):

_create_subcomponent: misleading error message

danjampro, 2021-01-19:
The error message here: https://github.com/panoptes/POCS/blob/cf5ae075b9ad821d1215d1e6f1974caf131d3e1d/src/panoptes/pocs/camera/camera.py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
is misleading because it states that the class is not callable. However, this error message also appears if an exception is raised while initialising a callable class.

wtgee, 2021-01-19:
That's a bit odd as it's just catching a `TypeError`.  I can add the error message in to see if that helps.

Thread 1082 (2021-02-18):

KeyError in focus position offset

danjampro, 2021-02-18:
Potential for key error here:
https://github.com/panoptes/POCS/blob/0bc2de51b65909ae800315cde12dd7c0abe497f2/src/panoptes/pocs/filterwheel/filterwheel.py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
Suggested change:
`current_offset = self._focus_offsets.get(self.current_filter, 0)`

Closed 2021-02-19.

Thread 1123 (2021-06-22):

Hanging tests

wtgee, 2021-06-22:
We are occasionally getting hanging tests, although it is not always reproducible. ~~It seems to happen either in the initial camera cooling tests or in `test_observatory` after the `test_status`. ~~

This is happening primarily in two places:

* The `test_observatory.py::test_default_config` test, which seems to have problems with reusing the `observatory` fixture.
* The `test_camera.py::test_set_target_temperature[dslr]`, which occasionally hangs before any output is given.

Both of these happen on github actions but do not seem to ever occur locally.

Closed 2021-08-04.

Thread 1138 (2021-07-30):

Bug in `camera.process_exposure`

danjampro, 2021-07-30:
The unit "seconds" does not exist. Instead it should be "second".

https://github.com/panoptes/POCS/blob/06b50ba7b7cce5206f27070b4ae53026eb3d9235/src/panoptes/pocs/camera/camera.py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

wtgee, 2021-08-04:
Closed by #1139

Closed 2021-08-04.

Thread 1155 (2021-11-28):

Typo in AbstractCamera class

fergusL, 2021-11-28:
**Describe the bug**
Noticed a small typo in the `panoptes.pocs.camera.AbstractCamera` class in the `take_exposure()` method, missing an extra `*` when passing kwargs into to the call to `_start_exposure()` . This was causing a unit test failure in Huntsman-Pocs (tests/test_camera.py::test_observation),
```E 11-19 02:55:07.369 PanError: Error starting exposure on dslr.00 (SC7497) port=/dev/fake/dslr.focuser.00 with focuser& filterwheel: TypeError("_start_exposure() got multiple values for argument 'seconds'")```

**To Reproduce**
https://github.com/panoptes/POCS/blob/5c53341b496f98ca01fcde6d1163a92b8be41de4/src/panoptes/pocs/camera/camera.py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

**Expected behavior**
NA

**Related Issues**
NA

Closed 2021-12-04.

Thread 1165 (2022-01-25):

Investigate astropy warnings

wtgee, 2022-01-25:
We get two warnings. One is when writing long keywords for FITS headers and should just be suppressed:

```
WARNING: VerifyWarning: Keyword name 'camera_name' is greater than 8 characters or contains characters not allowed by the FITS standard; a HIERARCH card will be created. [astropy.io.fits.card]
WARNING: VerifyWarning: Keyword name 'camera_uid' is greater than 8 characters or contains characters not allowed by the FITS standard; a HIERARCH card will be created. [astropy.io.fits.card]
```

and the other is going from AltAz to RA/Dec ?

```
WARNING: AstropyDeprecationWarning: Transforming a frame instance to a frame class (as opposed to another frame instance) will not be supported in the future.  Either explicitly instantiate the target frame, or first convert the source frame instance to a `astropy.coordinates.SkyCoord` and use its `transform_to()` method. [astropy.coordinates.baseframe]
```

wtgee, 2023-05-23:
These particular warnings were removed as part of #1130

Thread 1179 (2023-05-16):

missing commands set_local_time set_local_date get_guide_rate

oguyon, 2023-05-16:
**Describe the bug**
mount.initialize() errors: missing commands set_local_time set_local_date get_guide_rate

**To Reproduce**
Steps to reproduce the behavior:
- run mount.initialize()
Returns:
W 05-16 04:53:59.628 No command for set_local_time
W 05-16 04:54:02.137 No command for set_local_date
W 05-16 04:54:06.667 No command for get_guide_rate

Closed 2023-05-16.

Thread 1181 (2023-05-16):

mount park fails

oguyon, 2023-05-16:
**Describe the bug**
mount park returns error, does not park

Edit (@wtgee): This is on the CEM40 (post-2021) running the 2021 firmware and using command set `v310`.

**To Reproduce**
Steps to reproduce the behavior:
1. mount.park()

```
W 05-16 05:22:57.438 Cannot create SkyCoord from mount coordinates

---------------------------------------------------------------------------
ParserError                               Traceback (most recent call last)
Cell In[7], line 1
----> 1 mount.park()

File ~/pocs/src/panoptes/pocs/mount/ioptron/cem40.py:172, in Mount.park(self, park_direction, park_seconds, *args, **kwargs)
    170 self.unpark()
    171 self.query('park')
--> 172 while self.status.get('state') != MountState.PARKED:
    173     self.logger.trace(f'Moving to park')
    174     time.sleep(1)

File ~/pocs/src/panoptes/pocs/mount/mount.py:143, in AbstractMount.status(self)
    140 except Exception as e:
    141     self.logger.debug(f'Problem getting mount status: {e!r}')
--> 143 status.update(self._update_status())
    144 return status

File ~/pocs/src/panoptes/pocs/mount/ioptron/cem40.py:363, in Mount._update_status(self)
    361 ts = self.query('get_local_time')
    362 offset = int(float(ts[:4]) / 60)
--> 363 status['timestamp'] = parse_date(f'{ts[5:11]}T{ts[11:]}{offset}', yearfirst=True)
    364 status['tracking_rate_ra'] = self.tracking_rate
    366 return status

File ~/conda/envs/conda-pocs/lib/python3.11/site-packages/dateutil/parser/_parser.py:1368, in parse(timestr, parserinfo, **kwargs)
   1366     return parser(parserinfo).parse(timestr, **kwargs)
   1367 else:
-> 1368     return DEFAULTPARSER.parse(timestr, **kwargs)

File ~/conda/envs/conda-pocs/lib/python3.11/site-packages/dateutil/parser/_parser.py:643, in parser.parse(self, timestr, default, ignoretz, tzinfos, **kwargs)
    640 res, skipped_tokens = self._parse(timestr, **kwargs)
    642 if res is None:
--> 643     raise ParserError("Unknown string format: %s", timestr)
    645 if len(res) == 0:
    646     raise ParserError("String does not contain a date: %s", timestr)

ParserError: Unknown string format: 073748T6647216-10
```

Closed 2023-05-17.

Thread 1208 (2023-11-17):

Fix fastapi deprecation warning in power service

wtgee, 2023-11-17:
Showing up in the CI

```
panoptes/pocs/utils/service/power.py:28: DeprecationWarning:
      on_event is deprecated, use lifespan event handlers instead.

      Read more about it in the
      [FastAPI docs for Lifespan Events](https://fastapi.tiangolo.com/advanced/events/).
  
    @app.on_event('startup')
```

wtgee, 2023-12-26:
Fixed by #1209

Closed 2023-12-26.

Thread 1240 (2024-04-06):

pocs mount setup errors when /dev/ioptron already exists

wtgee, 2024-04-06:
If the `/dev/ioptron/` symlink already exists the `pocs mount setup` file will silently fail and not write the file but report success by asking for config changes.

Closed 2024-05-11.

Thread 1242 (2024-04-15):

Mount setup - don't look at non-usb devices

wtgee, 2024-04-15:
The `pocs mount setup` script will loop through everything found by `pyserial`, but we should do some filtering to only ports that it might be on. Currently if you try to set up the mount after the power is running it will try to probe the port the power is runnig on (e.g. on `/dev/ttyACM0`), which will screw things up.

wtgee, 2024-05-12:
Closed by #1262

Closed 2024-05-12.

Thread 1251 (2024-04-30):

DSLR camera initialization errors

wtgee, 2024-04-30:
Certain models of the Canon cameras are failing the initialization procedure because of the hard-coded indexes here: https://github.com/panoptes/POCS/blob/b93d547cd0a30f92bf411d39f72e8d2a62235daa/src/panoptes/pocs/camera/gphoto/canon.py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

This appears in the logs as:
```
PAN007 | gphoto2 error: "\n*** Error ***              \nChoice 9 not found within list of choices.\n*** Error (-2: 'Bad parameters') ***       \n\n"
PAN007 | gphoto2 error: "\n*** Error ***              \n/main not found in configuration tree.\n*** Error (-1: 'Unspecified error') ***       \n\n"
```

Closed 2024-04-30.

Thread 1288 (2025-02-26):

Make ioptron mounts work with timezones

wtgee, 2025-02-26:
The daylight savings time is automatically disabled as part of the mount initialization, which isn't how it should be set.

Fix the timezone so it's detected based on config and properly set. Could be done on init or as part of e.g. config server.

Closed 2025-02-27.

Thread 1292 (2025-03-10):

Make a better day sleep timer

wtgee, 2025-03-10:
During the day time a unit will currently sleep for 10 minutes before checking whether it is time to observe or not. Ideally it should figure out when the next sunset is and sleep for 10+ hours.

The motivation for this change is to reduce the noise in the log files, so this could potentially be handled in another way but I think a smarter timer is the best.

Thread 1295 (2025-03-11):

Make a short and long camera init

wtgee, 2025-03-11:
Everytime the cameras are connected it is running through a long initialization procedure where it does things like setting the "artist", "copyright year", etc.  Most of these only need to be set once, so there should be a `pocs camera setup` that does most of the work.

Closed 2025-04-14.

Thread 1305 (2025-04-05):

Better interrupt for running system

wtgee, 2025-04-05:
Currently you can do `pocs config set pocs.DO_STATES 0` and the machine will stop after the current state is done, but for the `observing` state this can be a long time.  The system can be tricked into being unsafe in various ways, which will also do a clean shutdown.

You can also do `Ctrl-c` to kill the running `pocs run auto`, but that will terminate immediately, often leaving the cameras in an exposing state that is hard to recover without a full reboot.

It would be nice to issue a `pocs run stop` or something similar that would gracefully shutdown the system asap but after any current exposures are finished.

Thread 1320 (2025-05-09):

Auto install ioptron rules on mount setup

wtgee, 2025-05-09:
Currently when running `pocs mount setup` it tells the user to copy the `.rules` file but this step is often skipped as it's not a totally clear message.

The new ZWO script auto-installs `.rules` of it's own and makes them immediately available. We should copy their mechanism.

Thread 1321 (2025-05-27):

Fix the creation of POCS simulators using `all`

wtgee, 2025-05-27:
There should be an easy and working way to create an entire POCS object of simulators, either from `POCS.from_config(simulators='all')`, which could be turned into a `POCS.from_simualtors()` (or something).

Some of the camera simulator creation could should be improved.

Closed 2025-06-05.

Thread 1323 (2025-05-28):

Fix dark reading during scheduling state which prevents mount from parking during day

wtgee, 2025-05-28:
If the mount is in the `scheduling` state when the dark check is performed and it's not dark, the mount can get stuck waiting for the horizon.

This happened when 007 scheduled at exactly sunrise, meaning it arrived at that state right before sunrise.

```
206823 D 05-28 11:01:11.909 (04:01:11 PDT) | panoptes.pocs.observatory is_dark:106       Sun -18.00 deg > -18.0 deg [observe]
```

The problem is that `dark` is added to the `ignore_safety_items` here:

https://github.com/panoptes/POCS/blob/302cdb6f64d748ff89f503cfe1dc1ab3a2973d9a/src/panoptes/pocs/state/machine.py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

Closed 2025-05-28.

Thread 1338 (2025-07-19):

Update ZWO drivers to 1.38

wtgee, 2025-07-19:
New release from 2025-06-12 includes bug fixes and optimizations.

Closed 2025-07-19.

Thread 1344 (2025-08-04):

Cleaner log rotation

wtgee, 2025-08-04:
Currently when we have a log rotation we get the following error message displayed in the main `pocs run auto` screen. This should be handled better so it doesn't appear there is an error with the unit.

```
--- Logging error in Loguru Handler #3 ---
Record was: {'elapsed': datetime.timedelta(days=1, seconds=1813, microseconds=232088), 'exception': None, 'extra': {'padding': '                   '}, 'file': (name='client.py', path='/home/panoptes/conda/envs/conda-pocs/lib/python3.12/site-packages/panoptes/utils/config/client.py'), 'function': 'get_config', 'level': (name='TRACE', no=5, icon='✏️ '), 'line': 108, 'message': "Calling get_config on url='http://localhost:6563/get-config' with  key='pocs.INTERRUPTED'", 'module': 'client', 'name': 'panoptes.utils.config.client', 'process': (id=2935, name='MainProcess'), 'thread': (id=281473397828352, name='MainThread'), 'time': datetime(2025, 8, 4, 11, 31, 8, 928399, tzinfo=datetime.timezone(datetime.timedelta(seconds=21600), '+06'))}
Traceback (most recent call last):
  File "/home/panoptes/conda/envs/conda-pocs/lib/python3.12/site-packages/loguru/_handler.py", line 315, in _queued_writer
    self._sink.write(message)
  File "/home/panoptes/conda/envs/conda-pocs/lib/python3.12/site-packages/loguru/_file_sink.py", line 204, in write
    self._terminate_file(is_rotating=True)
  File "/home/panoptes/conda/envs/conda-pocs/lib/python3.12/site-packages/loguru/_file_sink.py", line 281, in _terminate_file
    self._compression_function(old_path)
  File "/home/panoptes/conda/envs/conda-pocs/lib/python3.12/site-packages/loguru/_file_sink.py", line 66, in compression
    compress_function(path_in, path_out)
  File "/home/panoptes/conda/envs/conda-pocs/lib/python3.12/site-packages/loguru/_file_sink.py", line 53, in copy_compress
    with open(path_in, "rb") as f_in:
         ^^^^^^^^^^^^^^^^^^^
FileNotFoundError: [Errno 2] No such file or directory: '/home/panoptes/logs/panoptes_20250803.log'
--- End of logging error ---
```

Thread 1351 (2025-08-08):

Clarify camera errors and warnings with gphoto2 and DSLRs

wtgee, 2025-08-08:
When a camera fails there is a misleading and confusing set of error messages and warnings that appear in the main terminal screen. These errors/warnings should be more user friendly. (Note that this ticket is not for fixing the actual error, which is more involved).

```
E 08-08 11:04:36.711 InvalidSystemCommand: File: /home/panoptes/images/Toi1333B/f6eb3d/20250808T092713/20250808T110436.cr2
 err: Command '['/usr/bin/dcraw', '-t', '0', '-D', '-4', '/home/panoptes/images/Toi1333B/f6eb3d/20250808T092713/20250808T110436.cr2']' returned non-zero exit status 1.
E 08-08 11:04:36.901 _thread._ExceptHookArgs(exc_type=<class 'FileNotFoundError'>, exc_value=FileNotFoundError("Image file_path='/home/panoptes/images/Toi1333B/f6eb3d/20250808T092713/20250808T110436.fits' not found, cannot process."), exc_traceback=<trace
back object at 0xffff3a933200>, thread=<Thread(Thread-process_exposure-PAN007_f6eb3d_20250808T110436, started daemon 281473122824576)>)
E 08-08 11:05:21.523 Trying to process observation but missing file_path='/home/panoptes/images/Toi1333B/f6eb3d/20250808T092713/20250808T110436.cr2'
/home/panoptes/conda/envs/conda-pocs/lib/python3.12/site-packages/panoptes/utils/images/fits.py:466: UserWarning: No file exists at: /home/panoptes/images/Toi1333B/f6eb3d/20250808T092713/20250808T110436.cr2
  assert os.path.exists(fits_fname), warn(
Process Process-413:
Traceback (most recent call last):
  File "/home/panoptes/conda/envs/conda-pocs/lib/python3.12/multiprocessing/process.py", line 314, in _bootstrap
    self.run()
  File "/home/panoptes/conda/envs/conda-pocs/lib/python3.12/multiprocessing/process.py", line 108, in run
    self._target(*self._args, **self._kwargs)
  File "/home/panoptes/pocs/src/panoptes/pocs/observatory.py", line 520, in process_observation
    compressed_file_path = fits_utils.fpack(str(file_path))
                           ^^^^^^^^^^^^^^^^^^^^^^^^^^^^^^^^
  File "/home/panoptes/conda/envs/conda-pocs/lib/python3.12/site-packages/panoptes/utils/images/fits.py", line 466, in fpack
    assert os.path.exists(fits_fname), warn(
           ^^^^^^^^^^^^^^^^^^^^^^^^^^
AssertionError: None
/home/panoptes/images/Toi1333B/f6eb3d/20250808T092713/20250808T110558.cr2: No such file or directory
```

Closed 2025-08-11.

Thread 1365 (2025-08-25):

Remove TruckerBoard PeriodicDataFrame

wtgee, 2025-08-25:
The TruckerBoard class used for the power has a `dataframe` attribute that is a `streamz.PeriodicDataFrame`, with the idea that it would have a limited number of rows and those would be a rolling average of the previous power readings. This was supplied mostly for a conveneince. In practice it's not used anywhere and the `streamz` library seems to be unmaintained and is now giving some deprecation warnings.

Remove the `PeriodicDataFrame` and replace with nothing for now.

Thread 1369 (2025-09-14):

Make mount manual move commands use exact timing

wtgee, 2025-09-14:
Currently the `move_direction` command is a simple timer that mimics the hand-controller buttons being pressed and is used to move the mounts to the park position.  This timing is not exact, so, for example, if the mount is commanded to move 10 seconds it can end up moving a total of almost 15 seconds.

This should be changed to utilize the e.g. `move_ms_north` commands available with the newer iOptron command set, v250 and above.

wtgee, 2025-09-14:
Those mount commands only support movement at the specified guiding rate and are meant to adjust the guiding so are too slow for our needs. Closing tickets.

wtgee, 2025-09-14:
Re-opening the issue to improve the timing.

Closed 2025-09-14.
