panoptes/POCS/(list of files, drawings)

Other design files:
tests/data/solved.fits.fz
