panoptes/POCS/src/panoptes/pocs/focuser/birger.py

"""Birger Engineering Canon EF-232 focuser driver.

Provides a Focuser implementation that controls Canon EF/EF-S lenses via the
Birger EF-232 adapter over a serial connection, implementing the
AbstractSerialFocuser protocol used by POCS.
"""

import glob
import re
from contextlib import suppress

import serial

from panoptes.utils import error

from panoptes.pocs.focuser.serial import AbstractSerialFocuser

# Birger adaptor serial numbers should be 5 digits
SERIAL_NUMBER_PATTERN = re.compile(r"^\d{5}$")

# Error codes should be 'ERR' followed by 1-2 digits
error_pattern = re.compile(r"(?<=ERR)\d{1,2}")

error_messages = (
    "No error",
    "Unrecognised command",
    "Lens is in manual focus mode",
    "No lens connected",
    "Lens distance stop error",
    "Aperture not initialised",
    "Invalid baud rate specified",
    "Reserved",
    "Reserved",
    "A bad parameter was supplied to the command",
    "XModem timeout",
    "XModem error",
    "XModem unlock code incorrect",
    "Not used",
    "Invalid port",
    "Licence unlock failure",
    "Invalid licence file",
    "Invalid library file",
    "Reserved",
    "Reserved",
    "Not used",
    "Library not ready for lens communications",
    "Library not ready for commands",
    "Command not licensed",
    "Invalid focus range in memory. Try relearning the range",
    "Distance stops not supported by the lens",
)


class Focuser(AbstractSerialFocuser):
    """
    Focuser class for control of a Canon DSLR lens via a Birger Engineering Canon EF-232 adapter.
    """

    def __init__(
        self,
        name="Birger Focuser",
        model="Canon EF-232",
        max_command_retries=5,
        baudrate=115200,
        **kwargs,
    ):
        """
        Args:
            name (str, optional): default 'Birger Focuser'
            model (str, optional): default 'Canon EF-232'
            max_command_retries (int, optional): Max number of command retries before raising
                an error. Default: 5.
            baudrate (int, optional): The baudrate of the serial device. Default: 115200.
            **kwargs: Parsed to AbstractSerialFocuser init function.
        """
        self._max_command_retries = max_command_retries
        super().__init__(name=name, model=model, baudrate=baudrate, **kwargs)

    # Properties

    @AbstractSerialFocuser.position.getter
    def position(self):
        """
        Returns current focus position in the lens focus encoder units.
        """
        response = self._send_command("pf", response_length=1)
        self._position = int(response[0].rstrip())
        return self._position

    @property
    def min_position(self):
        """
        Returns position of close limit of focus travel, in encoder units.
        """
        return self._min_position

    @property
    def max_position(self):
        """
        Returns position of far limit of focus travel, in encoder units.
        """
        return self._max_position

    @property
    def lens_info(self):
        """
        Return basic lens info (e.g. '400mm,f28' for a 400 mm f/2.8 lens).
        """
        return self._lens_info

    @property
    def firmware_version(self):
        """
        Returns the version string of the Birger adaptor library (firmware).
        """
        return self._library_version

    @property
    def hardware_version(self):
        """
        Returns the hardware version of the Birger adaptor.
        """
        return self._hardware_version

    # Public Methods

    def connect(self, port, baudrate, **kwargs):
        """Connect to the Birger focuser.
        Args:
            port (int): The serial port.
            baudrate (int): The baudrate of the serial device.
            **kwargs: Parsed to super().connect
        """
        if SERIAL_NUMBER_PATTERN.match(port):
            # Have been given a serial number
            self.logger.debug(f"Looking for {self.name} ({port})")

            if self._adaptor_nodes is None:
                # No cached device nodes scanning results, need to scan.
                self.logger.debug("Getting serial numbers for all connected Birger focusers")
                self._adaptor_nodes = {}

                # Find nodes matching pattern
                device_nodes = glob.glob(port)

                # Open each device node and see if a Birger focuser answers
                for device_node in device_nodes:
                    with suppress(serial.SerialException, serial.SerialTimeoutException):
                        super().connect(port=device_node, baudrate=baudrate, **kwargs)
                        serial_number = self._get_serial_number()
                        self._adaptor_nodes[serial_number] = device_node
                        self._serial.close()

                if not self._adaptor_nodes:
                    self.logger.error("No Birger focuser devices found!")
                    return
                else:
                    self.logger.debug(f"Connected Birger focusers: {Focuser._adaptor_nodes}")

            # Search in cached device node scanning results for serial number
            try:
                device_node = self._adaptor_nodes[port]
            except KeyError:
                self.logger.error(f"Could not find {self.name} ({port})")
                return
            self.logger.debug(f"Found {self.name} ({port}) on {device_node}")
            self.port = device_node

        super().connect(port=self.port, baudrate=baudrate, **kwargs)

    def move_to(self, position):
        """
        Moves focuser to a new position.
        Does not do any checking of the requested position but will warn if the lens reports
        hitting a stop.
        Args:
            position (int): new focuser position, in encoder units.
        Returns:
            int: focuser position following the move, in encoder units.
        """
        self._is_moving = True
        try:
            response = self._send_command(f"fa{int(position):d}", response_length=1)
            new_position = self._parse_move_response(response)
        finally:
            # Birger move commands block until the move is finished, so if the command has
            # returned then the focuser is no longer moving.
            self._is_moving = False

        self.logger.debug(f"Moved to encoder position {new_position}")
        return self.position

    def move_by(self, increment):
        """
        Move focuser by a given amount.
        Does not do any checking of the requested increment but will warn if the lens reports
        hitting a stop.
        Args:
            increment (int): distance to move the focuser, in encoder units.
        Returns:
            int: focuser position following the move, in encoder units.
        """
        self._is_moving = True
        try:
            response = self._send_command(f"mf{int(increment):d}", response_length=1)
            moved_by = self._parse_move_response(response)
        finally:
            # Birger move commands block until the move is finished, so if the command has
            # returned then the focuser is no longer moving.
            self._is_moving = False

        self.logger.debug(f"Moved by {moved_by} encoder units")
        return self.position

    # Private Methods

    def _initialize(self):
        """Initialize the Birger focuser."""
        # Set 'verbose' and 'legacy' response modes. The response from this depends on
        # what the current mode is... but after a power cycle it should be 'rm1,0', 'OK'
        self._send_command("rm1,0", response_length=0)

        # Set the serial number
        self._serial_number = self._get_serial_number()

        # Get the version string of the adaptor software libray. Accessible as self.library_version
        self._get_library_version()

        # Get the hardware version of the adaptor. Accessible as self.hardware_version
        self._get_hardware_version()

        # Get basic lens info (e.g. '400mm,f28' for a 400 mm, f/2.8 lens). Accessible as
        # self.lens_info
        self._get_lens_info()

        # Initialise the aperture motor. This also has the side effect of fully opening the iris.
        self._initialise_aperture()

        # Initalise focus. First move the focus to the close stop.
        self._move_zero()

        # Then reset the focus encoder counts to 0
        self._zero_encoder()
        self._min_position = 0

        # Calibrate the focus with the 'Learn Absolute Focus Range' command
        self._learn_focus_range()

        # Finally move the focus to the far stop (close to where we'll want it) and record position
        self._max_position = self._move_inf()

    def _send_command(self, command, *args, **kwargs):
        """
        Sends a command to the focuser adaptor and retrieves the response.
        Args:
            command (string): command string to send (without newline), e.g. 'fa1000', 'pf'
        Returns:
            list: possibly empty list containing the '\r' terminated lines of the response from the
                adaptor.
        """
        if not self.is_connected:
            self.logger.critical(f"Attempt to send command to {self} when not connected!")
            return

        for i in range(self._max_command_retries):
            # Clear the input buffer in case there's anything left over in there.
            self._serial.reset_input_buffer()

            # Send the command
            self._serial.write(command + "\r")
            raw_response = self._serial.read().rstrip().split("\r")

            try:
                # In verbose mode adaptor will first echo the command
                echo = raw_response[0]
                if echo != command:
                    self.logger.warning(f"echo != command: {echo!r} != {command!r}. Retrying.")
                    continue

                # Adaptor should then send 'OK', even if there was an error.
                ok = raw_response[1]
                if ok != "OK":
                    self.logger.warning(f"ok != 'OK': {ok!r} != 'OK'. Retrying command.")
                    continue

                # Depending on which command was sent there may or may not be any further response.
                response = raw_response[2:]
                break

            except Exception as err:
                msg = (
                    f"Command {command} failed on {self} on attempt {i + 1} of"
                    f" {self._max_command_retries}: {err!r}"
                )

                if i == self._max_command_retries - 1:
                    raise error.PanError(msg)
                else:
                    self.logger.warning(msg)

        # Check for an error message in response
        if response:
            # Not an empty list.
            error_match = error_pattern.match(response[0])
            if error_match:
                # Got an error message! Translate it.
                try:
                    error_message = error_messages[int(error_match.group())]
                    self.logger.error(f"{self} returned error message '{error_message}'!")
                except Exception:
                    self.logger.error(f"Unknown error '{error_match.group()}' from {self}!")

        return response

    def _parse_move_response(self, response):
        try:
            response = response[0].rstrip()
            reply = response[:4]
            amount = int(response[4:-2])
            hit_limit = bool(int(response[-1]))
            assert reply == "DONE"
        except (IndexError, AssertionError):
            raise error.PanError(f"{self} got response '{response}', expected 'DONENNNNN,N'!")
        if hit_limit:
            self.logger.warning(f"{self} reported hitting a focus stop")

        return amount

    def _get_serial_number(self):
        """Get the Birger Focuser's serial number."""
        response = self._send_command("sn", response_length=1)
        return response[0].rstrip()

    def _get_library_version(self):
        response = self._send_command("lv", response_length=1)
        self._library_version = response[0].rstrip()
        self.logger.debug(f"Got library version '{self._library_version}' for {self.name} on {self.port}")

    def _get_hardware_version(self):
        response = self._send_command("hv", response_length=1)
        self._hardware_version = response[0].rstrip()
        self.logger.debug(f"Got hardware version {self._hardware_version} for {self.name} on {self.port}")

    def _get_lens_info(self):
        response = self._send_command("id", response_length=1)
        self._lens_info = response[0].rstrip()
        self.logger.debug(f"Got lens info '{self._lens_info}' for {self.name} on {self.port}")

    def _initialise_aperture(self):
        self.logger.debug("Initialising aperture motor")
        response = self._send_command("in", response_length=1)[0].rstrip()
        if response != "DONE":
            self.logger.error(f"{self} got response={response!r}, expected 'DONE'!")

    def _move_zero(self):
        response = self._send_command("mz", response_length=1)[0].rstrip()
        if response[:4] != "DONE":
            self.logger.error(f"{self} got response={response!r}, expected 'DONENNNNN,1'!")
        else:
            r = response[4:].rstrip()
            self.logger.debug(f"Moved {r[:-2]} encoder units to close stop")
            return int(r[:-2])

    def _zero_encoder(self):
        self.logger.debug("Setting focus encoder zero point")
        self._send_command("sf0", response_length=0)

    def _learn_focus_range(self):
        self.logger.debug("Learning absolute focus range")
        response = self._send_command("la", response_length=1)[0].rstrip()
        if response != "DONE:LA":
            self.logger.error(f"{self} got response={response!r}, expected 'DONE:LA'!")

    def _move_inf(self):
        response = self._send_command("mi", response_length=1)[0].rstrip()
        if response[:4] != "DONE":
            self.logger.error(f"{self} got response={response!r}, expected 'DONENNNNN,1'!")
        else:
            r = response[4:].rstrip()
            self.logger.debug(f"Moved {r[:-2]} encoder units to far stop")
            return int(r[:-2])

    def _add_fits_keywords(self, header):
        header = super()._add_fits_keywords(header)
        header.set("FOC-HW", self.hardware_version, "Focuser hardware version")
        header.set("FOC-FW", self.firmware_version, "Focuser firmware version")
        header.set("LENSINFO", self.lens_info, "Attached lens")
        return header
