panoptes/POCS/tests/test_filterwheel.py

import math
from timeit import timeit

import pytest
from astropy import units as u

from panoptes.utils import error

from panoptes.pocs.camera.simulator.dslr import Camera as SimCamera
from panoptes.pocs.filterwheel.simulator import FilterWheel as SimFilterWheel


@pytest.fixture(scope="function")
def filterwheel():
    sim_filterwheel = SimFilterWheel(
        filter_names=["one", "deux", "drei", "quattro"],
        move_time=0.1 * u.second,
        timeout=0.5 * u.second,
    )
    return sim_filterwheel


@pytest.fixture(scope="function")
def filterwheel_with_blank():
    sim_filterwheel = SimFilterWheel(
        filter_names=["blank", "deux", "drei", "quattro"],
        move_time=0.1 * u.second,
        timeout=0.5 * u.second,
        dark_position="blank",
    )
    return sim_filterwheel


def test_init(filterwheel):
    assert isinstance(filterwheel, SimFilterWheel)
    assert filterwheel.is_connected


def test_camera_init():
    sim_camera = SimCamera(
        filterwheel={
            "model": "panoptes.pocs.filterwheel.simulator.FilterWheel",
            "filter_names": ["one", "deux", "drei", "quattro"],
        }
    )
    assert isinstance(sim_camera.filterwheel, SimFilterWheel)
    assert sim_camera.filterwheel.is_connected
    assert sim_camera.filterwheel.uid
    assert sim_camera.filterwheel.camera is sim_camera


def test_camera_no_filterwheel():
    sim_camera = SimCamera()
    assert sim_camera.filterwheel is None


def test_camera_association_on_init():
    sim_camera = SimCamera()
    sim_filterwheel = SimFilterWheel(filter_names=["one", "deux", "drei", "quattro"], camera=sim_camera)
    assert sim_filterwheel.camera is sim_camera


def test_with_no_name():
    with pytest.raises(ValueError):
        SimFilterWheel()


# Basic property getting and (not) setting


def test_model(filterwheel):
    model = filterwheel.model
    assert model == "panoptes.pocs.filterwheel.simulator.FilterWheel"
    with pytest.raises(AttributeError):
        filterwheel.model = "Airfix"


def test_name(filterwheel):
    name = filterwheel.name
    assert name == "Simulated Filter Wheel"
    with pytest.raises(AttributeError):
        filterwheel.name = "Phillip"


def test_uid(filterwheel):
    uid = filterwheel.uid
    assert uid.startswith("SW")
    assert len(uid) == 6
    with pytest.raises(AttributeError):
        filterwheel.uid = "Can't touch this"


def test_filter_names(filterwheel):
    names = filterwheel.filter_names
    assert isinstance(names, list)
    for name in names:
        assert isinstance(name, str)
    with pytest.raises(AttributeError):
        filterwheel.filter_names = ["Unsharp mask", "Gaussian blur"]


# Movement


def test_move_number(filterwheel):
    assert filterwheel.position == 1
    e = filterwheel.move_to(4)
    assert math.isnan(filterwheel.position)  # position is NaN while between filters
    e.wait()
    assert filterwheel.position == 4
    e = filterwheel.move_to(3, blocking=True)
    assert e.is_set()
    assert filterwheel.position == 3
    filterwheel.position = 4  # Move by assignment to position property blocks until complete
    assert filterwheel.position == 4


def test_move_bad_number(filterwheel):
    with pytest.raises(ValueError):
        filterwheel.move_to(0, blocking=True)  # No zero based numbering here!
    with pytest.raises(ValueError):
        filterwheel.move_to(-1, blocking=True)  # Definitely not
    with pytest.raises(ValueError):
        filterwheel.position = 99  # Problems.
    with pytest.raises(ValueError):
        filterwheel.move_to(filterwheel._n_positions + 1, blocking=True)  # Close, but...
    filterwheel.move_to(filterwheel._n_positions, blocking=True)  # OK


def test_move_name(filterwheel, caplog):
    filterwheel.position = 1  # Start from a known position
    e = filterwheel.move_to("quattro")
    assert filterwheel.current_filter == "UNKNOWN"  # I'm between filters right now
    e.wait()
    assert filterwheel.current_filter == "quattro"
    e = filterwheel.move_to("o", blocking=True)  # Matches leading substrings too
    assert filterwheel.current_filter == "one"
    filterwheel.position = "d"  # In case of multiple matches logs a warning & uses the first match
    assert filterwheel.current_filter == "deux"
    # WARNING followed by INFO level record about the move
    assert caplog.records[-2].levelname == "WARNING"
    assert caplog.records[-1].levelname == "INFO"
    filterwheel.position = "deux"  # Check null move. Earlier version of simulator failed this!
    assert filterwheel.current_filter == "deux"


def test_move_bad_name(filterwheel):
    with pytest.raises(ValueError):
        filterwheel.move_to("cinco")


def test_move_timeout(caplog):
    slow_filterwheel = SimFilterWheel(
        filter_names=["one", "deux", "drei", "quattro"], move_time=0.5, timeout=0.2
    )
    with pytest.raises(error.Timeout):
        # Move should take 0.3 seconds, more than timeout.
        slow_filterwheel.position = 4

    assert slow_filterwheel.position != 4


@pytest.mark.parametrize(
    "name, unidirectional, expected", [("unidirectional", True, 0.3), ("bidirectional", False, 0.1)]
)
def test_move_times(name, unidirectional, expected):
    sim_filterwheel = SimFilterWheel(
        filter_names=["one", "deux", "drei", "quattro"],
        move_time=0.1 * u.second,
        unidirectional=unidirectional,
        timeout=0.5 * u.second,
    )
    sim_filterwheel.position = 1
    assert timeit("sim_filterwheel.position = 2", number=1, globals=locals()) == pytest.approx(0.1, rel=1e-1)
    assert timeit("sim_filterwheel.position = 4", number=1, globals=locals()) == pytest.approx(
        0.2, rel=1.5e-1
    )
    assert timeit("sim_filterwheel.position = 3", number=1, globals=locals()) == pytest.approx(
        expected, rel=2e-1
    )


def test_move_exposing(tmpdir):
    sim_camera = SimCamera(
        filterwheel={
            "model": "panoptes.pocs.filterwheel.simulator.FilterWheel",
            "filter_names": ["one", "deux", "drei", "quattro"],
        }
    )
    fits_path = str(tmpdir.join("test_exposure.fits"))
    readout_thread = sim_camera.take_exposure(filename=fits_path, seconds=0.1)
    with pytest.raises(error.PanError):
        # Attempt to move while camera is exposing
        sim_camera.filterwheel.move_to(2, blocking=True)
    assert sim_camera.filterwheel.position == 1  # Should not have moved
    readout_thread.join()


def test_is_moving(filterwheel):
    filterwheel.position = 1
    assert not filterwheel.is_moving
    assert filterwheel.is_ready
    e = filterwheel.move_to(2)
    assert filterwheel.is_moving
    assert not filterwheel.is_ready
    e.wait()
    assert not filterwheel.is_moving
    assert filterwheel.is_ready


def test_move_dark(filterwheel, filterwheel_with_blank):
    with pytest.raises(error.NotFound):
        filterwheel.move_to_dark_position()
    filterwheel_with_blank.move_to("deux", blocking=True)
    assert filterwheel_with_blank.current_filter == "deux"
    filterwheel_with_blank.move_to_dark_position(blocking=True)
    assert filterwheel_with_blank.current_filter == "blank"


def test_move_light(filterwheel, filterwheel_with_blank):
    with pytest.raises(error.NotFound):
        filterwheel.move_to_light_position()
    with pytest.raises(error.NotFound):
        # Won't have been set yet.
        filterwheel_with_blank.move_to_light_position()
    filterwheel_with_blank.move_to("deux", blocking=True)
    assert filterwheel_with_blank.current_filter == "deux"
    filterwheel_with_blank.move_to_dark_position(blocking=True)
    assert filterwheel_with_blank.current_filter == "blank"
    filterwheel_with_blank.move_to_light_position(blocking=True)
    assert filterwheel_with_blank.current_filter == "deux"
