panoptes/POCS/src/panoptes/pocs/utils/cli/camera.py

"""Typer CLI commands for camera setup and quick image capture.

Provides helpers to detect connected cameras (DSLR via gphoto2 and ZWO via SDK),
populate the configuration, and take one-off test images with optional
post-processing (convert/compress/solve/pretty).
"""

import concurrent.futures
import queue
import threading
import time
from pathlib import Path
from platform import uname

import numpy as np
import typer
from astropy.io import fits
from astropy.stats import sigma_clipped_stats
from rich import print
from rich.console import Group
from rich.live import Live
from rich.panel import Panel
from rich.progress import (
    BarColumn,
    MofNCompleteColumn,
    Progress,
    SpinnerColumn,
    TaskProgressColumn,
    TextColumn,
    TimeElapsedColumn,
)
from rich.table import Table
from rich.text import Text

from panoptes.utils.config.client import get_config, set_config
from panoptes.utils.error import PanError
from panoptes.utils.images import cr2 as cr2_utils
from panoptes.utils.images import make_pretty_image
from panoptes.utils.images.fits import fpack, get_solve_field, getdata
from panoptes.utils.time import current_time

from panoptes.pocs.camera import (
    AbstractCamera,
    create_cameras_from_config,
    list_connected_gphoto2_cameras,
)
from panoptes.pocs.camera.libasi import ASIDriver

app = typer.Typer(no_args_is_help=True)


class RecentFilesRenderable:
    """Renderable that displays the 5 most recent completed file paths for a camera.

    This reads directly from a shared list reference so that Rich's Live
    re-render will always show the latest content without reconstructing
    the layout.
    """

    def __init__(self, recent_files_ref: list[str], show_max: int = 5):
        self._recent_files = recent_files_ref
        self.show_max = show_max

    def __rich_console__(self, console, options):
        yield Text(f"Recent files (max {self.show_max}):", style="bold cyan")
        if not self._recent_files:
            yield Text("  (none yet)", style="dim")
            return
        # Show the last `show_max` entries so the most recent appears at the bottom
        for name in self._recent_files[-self.show_max :]:
            # Fold long paths so they wrap within the panel instead of forcing wide columns
            yield Text(f"  - {name}", overflow="fold", no_wrap=False)


@app.command(name="setup")
def setup_cameras(
    detect_dslr: bool = True,
    detect_zwo: bool = True,
    asi_library_path: Path = None,
    test_image: bool = True,
) -> None:
    """Set up the config for the cameras.

    1. Try to detect DSLRs via gphoto2.
    2. Try to detect ZWOs via ZWO SDK.
        a). Look for filterwheel.
    3. Update config options for camera.
    4. Update camera with any initialization settings.
    5. Take a test picture with each camera if `test_image` is True.

    """
    cameras = dict()
    num_cameras = 0
    if detect_dslr:
        print("Detecting DSLRs...")
        gphoto2_ports = list_connected_gphoto2_cameras()
        if gphoto2_ports:
            print(f"Detected {len(gphoto2_ports)} DSLR cameras.")
            for i, port in enumerate(gphoto2_ports):
                cameras[f"dslr-{i:02d}"] = {
                    "model": "panoptes.pocs.camera.gphoto.canon.Camera",
                    "name": f"Cam{num_cameras:02d}",
                    "port": port,
                    "readout_time": 15.0,
                }
                num_cameras += 1

    if detect_zwo:
        print("Detecting ZWO cameras...")
        if asi_library_path is None:
            platform = uname().machine
            if platform == "x86_64":
                platform = "x64"
            elif platform == "aarch64":
                platform = "armv8"
            asi_library_path = (
                Path(get_config("directories.base"))
                / f"resources/cameras/zwo/{platform}/libASICamera2.so.1.38"
            )
        # print(f'Using ZWO library path: {asi_library_path}')
        asi_driver = ASIDriver(library_path=asi_library_path)
        try:
            zwo_cameras = asi_driver.get_devices()
        except PanError:
            print("No ZWO cameras detected")
        else:
            print(f"Detected {len(zwo_cameras)} ZWO cameras.")
            for i, (serial_number, cam_id) in enumerate(zwo_cameras.items()):
                cameras[f"zwo-{i:02d}"] = {
                    "model": "panoptes.pocs.camera.zwo.Camera",
                    "name": f"Cam{num_cameras:02d}",
                    "serial_number": serial_number,
                    "file_extension": "fits",
                    "readout_time": 1.0,
                    "uid": serial_number,
                    "library_path": asi_library_path.absolute().as_posix(),
                }
                num_cameras += 1
                # Close the camera by id.
                asi_driver.close_camera(cam_id)

    if not cameras:
        print("No cameras detected, exiting.")
        return

    print(f"Found {num_cameras} cameras to set up.")
    print("Updating camera config...")
    set_config("cameras.devices", list(cameras.values()))

    # Turn off the autodetect
    set_config("cameras.defaults.auto_detect", False)

    # Set default exptime to 1 second if ZWO cameras detected
    has_zwo = any(cam_config.get("model", "").endswith("zwo.Camera") for cam_config in cameras.values())
    if has_zwo:
        print("ZWO cameras detected, setting default exposure time to 1 second.")
        set_config("cameras.defaults.exptime", 1)

    # Now create the cameras from the config, calling the `setup_camera` method if available.
    print("Now creating the cameras from the config and setting them up.")
    cameras = create_cameras_from_config()
    if len(cameras) == 0:
        print("No cameras found after setup, exiting.")
        return
    else:
        # Call setup_properties on each of the cameras
        for cam_name, cam in cameras.items():
            try:
                print(f"Setting up camera: {cam_name}")
                cam.setup_camera()
            except AttributeError:
                print(f"Camera {cam_name} does not have a setup_camera method, skipping.")

    if test_image:
        print("Now creating the cameras from the config and taking a test picture with each.")
        take_pictures(
            cameras=cameras,
            num_images=1,
            exptime=1.0,
            output_dir="/home/panoptes/images/test",
            convert=True,
            compress=True,
        )


@app.command(name="take-pics")
def take_pictures_cmd(
    num_images: int = 1,
    exptime: float = 1.0,
    output_dir: str = "/home/panoptes/images",
    delay: float = 0.0,
    convert: bool = typer.Option(False, help="Convert to FITS if needed."),
    compress: bool = typer.Option(False, help="Compress FITS to .fz."),
    solve: bool = typer.Option(False, help="Solve FITS with astrometry."),
    pretty: bool = typer.Option(False, help="Create pretty PNG image."),
    verbose: bool = typer.Option(False, help="Print detailed processing output."),
) -> dict[str, list[Path]] | None:
    """Takes pictures with cameras and optionally processes them."""
    cameras = create_cameras_from_config()

    if len(cameras) == 0:
        typer.Abort("No cameras found, exiting.")

    print(f"Taking {num_images} images with {len(cameras)} cameras.")
    _, results = take_pictures(
        cameras=cameras,
        num_images=num_images,
        exptime=exptime,
        output_dir=output_dir,
        delay=delay,
        convert=convert,
        compress=compress,
        solve=solve,
        pretty=pretty,
        verbose=verbose,
    )
    return results


@app.command(name="take-bias")
def take_bias_cmd(
    num_images: int = typer.Option(
        10,
        "--num-images",
        "-n",
        help="Number of bias frames to capture.",
    ),
    output_dir: Path = typer.Option(
        Path("/home/panoptes/images/bias"), help="Output directory for bias frames."
    ),
    convert: bool = typer.Option(True, help="Convert to FITS if needed."),
    verbose: bool = typer.Option(False, help="Print detailed processing output."),
) -> None:
    """Take bias frames (zero exposure time), stack them, and report statistics.

    Takes n bias frames with zero exposure time, stacks them into a master bias,
    and reports sigma-clipped mean, median, std, min, and max values.
    """
    cameras = create_cameras_from_config()

    if len(cameras) == 0:
        print("[red]No cameras found, exiting.[/red]")
        raise typer.Abort()

    print(f"Taking {num_images} bias frames with {len(cameras)} cameras.")

    # Take the bias frames
    run_dir, results = take_pictures(
        cameras=cameras,
        num_images=num_images,
        exptime=0.0,  # Zero exposure time for bias frames
        output_dir=output_dir.as_posix(),
        delay=0.0,
        convert=convert,
        compress=False,  # Don't compress for processing
        solve=False,
        pretty=False,
        verbose=verbose,
    )

    print("\n[bold cyan]Processing bias frames...[/bold cyan]")

    # Process each camera's bias frames
    for cam_name, bias_files in results.items():
        if not bias_files:
            print(f"[yellow]No bias frames found for {cam_name}[/yellow]")
            continue

        if len(bias_files) < num_images:
            print(
                f"[yellow]Warning: Only found {len(bias_files)} bias frames for {cam_name}, "
                f"expected {num_images}[/yellow]"
            )

        print(f"\n[bold]Processing {len(bias_files)} bias frames for {cam_name}[/bold]")

        # Stack the bias frames
        bias_stack = []
        for bias_file in bias_files:
            try:
                data = getdata(bias_file)
                if data is not None:
                    bias_stack.append(data)
            except Exception as e:
                if verbose:
                    print(f"[red]Error reading {bias_file}: {e}[/red]")
                continue

        if not bias_stack:
            print(f"[red]No valid bias frames could be read for {cam_name}[/red]")
            continue

        # Convert to numpy array and stack
        bias_stack = np.array(bias_stack)

        # Create master bias by taking the median
        master_bias = np.median(bias_stack, axis=0)

        # Calculate statistics with sigma clipping
        mean, median, std = sigma_clipped_stats(master_bias, sigma=3.0)
        min_val = np.min(master_bias)
        max_val = np.max(master_bias)

        # Display results
        print(f"\n[bold green]Statistics for {cam_name}:[/bold green]")
        print(f"  Sigma-clipped Mean:   {mean:.4f}")
        print(f"  Sigma-clipped Median: {median:.4f}")
        print(f"  Sigma-clipped Std:    {std:.4f}")
        print(f"  Min value:            {min_val:.4f}")
        print(f"  Max value:            {max_val:.4f}")

        # Save the master bias frame
        master_bias_path = run_dir / f"{cam_name}-master-bias.fits"
        try:
            # Use the first bias frame as a template for the header
            with fits.open(bias_files[0]) as hdul:
                header = hdul[0].header.copy()
                header["IMAGETYP"] = "Master Bias"
                header["NCOMBINE"] = len(bias_stack)
                header["COMMENT"] = f"Master bias created from {len(bias_stack)} frames"

                # Create new HDU with master bias
                hdu = fits.PrimaryHDU(data=master_bias.astype(np.float32), header=header)
                hdu.writeto(master_bias_path, overwrite=True)

            print(f"[bold cyan]Master bias saved to:[/bold cyan] {master_bias_path}")
        except Exception as e:
            print(f"[red]Error saving master bias: {e}[/red]")


def take_pictures(
    cameras: dict[str, AbstractCamera],
    num_images: int = 1,
    exptime: float | str = 1.0,
    output_dir: str = "/home/panoptes/images",
    delay: float = 0.0,
    convert: bool = False,
    compress: bool = False,
    solve: bool = False,
    pretty: bool = False,
    verbose: bool = False,
) -> tuple[Path, dict[str, list[Path]]]:
    """Capture images concurrently from one or more cameras with optional processing.

    Spawns a thread pool to trigger exposures across all cameras and a background
    worker thread to perform post-processing steps (convert, compress, solve,
    pretty) as files are produced. A Rich Live layout displays per-camera
    progress and a list of the most recent files.

    Args:
        cameras (dict[str, AbstractCamera]): Mapping of camera names to instances.
        num_images (int): Number of images to take per camera. Defaults to 1.
        exptime (float | str): Exposure time in seconds (or string parsable to float).
        output_dir (str): Base directory where images will be written. A timestamped
            subdirectory is created automatically. Defaults to '/home/panoptes/images'.
        delay (float): Optional delay in seconds between exposures. Defaults to 0.0.
        convert (bool): If True, convert proprietary formats (e.g., CR2) to FITS.
        compress (bool): If True, compress FITS files to .fz via fpack.
        solve (bool): If True, run astrometric solving on FITS outputs.
        pretty (bool): If True, generate a PNG preview image.
        verbose (bool): If True, print additional processing details.

    Returns:
        tuple[Path, dict[str, list[Path]]]: The actual output directory and a mapping
            of camera name to list of produced files.
    """
    observation_start_time = current_time(flatten=True)
    output_dir = Path(output_dir) / str(observation_start_time)

    # Build per-camera progress panels
    per_cam_progress = {}
    panels = []
    for cam_name in cameras.keys():
        prog = Progress(
            TextColumn("[progress.description]{task.description}"),
            SpinnerColumn(),
            BarColumn(),
            TaskProgressColumn(),
            MofNCompleteColumn(),
            TimeElapsedColumn(),
        )
        tasks: dict[str, int] = {"expose": prog.add_task("Expose", total=num_images)}
        # Conditionally add processing tasks
        if convert:
            tasks["convert"] = prog.add_task("Convert", total=num_images)
        if compress:
            tasks["compress"] = prog.add_task("Compress", total=num_images)
        if solve:
            tasks["solve"] = prog.add_task("Solve", total=num_images)
        if pretty:
            tasks["pretty"] = prog.add_task("Pretty", total=num_images)

        # Maintain per-camera list of recent files (full paths)
        recent_files: list[str] = []
        per_cam_progress[cam_name] = {
            "progress": prog,
            "tasks": tasks,
            "recent_files": recent_files,
        }

        # Group the progress with the recent files renderable so it shows under the bars
        recent_renderable = RecentFilesRenderable(recent_files)
        group = Group(prog, Text(""), recent_renderable)  # blank line spacer
        panels.append(Panel(group, title=f"{cam_name} {exptime=}s", border_style="cyan"))

    # Set up queues and processing thread. Pass per-camera progress so it can update from the worker thread.
    process_queue = queue.Queue()
    complete_queue = queue.Queue()
    t = threading.Thread(
        target=process_image,
        args=(
            process_queue,
            complete_queue,
            convert,
            compress,
            solve,
            pretty,
            verbose,
            per_cam_progress,
        ),
        daemon=True,
    )
    t.start()

    # Build a single-row grid with equal-width columns so panels render side-by-side
    grid = Table.grid(expand=True, padding=(0, 1))
    for _ in panels:
        grid.add_column(ratio=1)
    grid.add_row(*panels)
    layout = grid

    # Submit all the images for exposure and render live progress while running.
    futures = dict()
    with Live(layout, refresh_per_second=10, transient=False):
        with concurrent.futures.ThreadPoolExecutor() as executor:
            for cam_name, cam in cameras.items():
                future = executor.submit(
                    _take_pics,
                    cam_name,
                    cam,
                    process_queue,
                    exptime,
                    num_images,
                    output_dir,
                    delay,
                    per_cam_progress[cam_name]["progress"],
                    per_cam_progress[cam_name]["tasks"]["expose"],
                )
                futures[future] = cam_name

            # Wait for all camera exposure jobs to complete
            for future in concurrent.futures.as_completed(futures):
                if future.exception():
                    print(future.exception())
                    continue

        # At this point, all exposure jobs are done. Wait for processing to finish.
        print("Finished taking pictures, waiting for processing.")

        # Signal processing thread to finish and wait for all processing.
        process_queue.put(None)
        process_queue.join()
        t.join()

    # Collect results
    results = {}
    while not complete_queue.empty():
        cam_name, file_path = complete_queue.get()
        if cam_name not in results:
            results[cam_name] = []
        results[cam_name].append(file_path)

    return output_dir, results


def _take_pics(
    cam_name: str,
    cam: AbstractCamera,
    process_queue: queue.Queue,
    exptime: float,
    num: int,
    output_dir: Path,
    delay: float,
    progress: Progress | None = None,
    expose_task_id: int | None = None,
):
    """Helper function to take pictures."""
    output_dir.mkdir(parents=True, exist_ok=True)

    # Take the images
    for i in range(num):
        fn = output_dir / f"{cam_name}-{i:04d}-{current_time(flatten=True)}.{cam.file_extension}"
        cam.take_exposure(seconds=exptime, filename=fn, blocking=True)
        process_queue.put((cam_name, fn))

        # Update per-camera exposure progress if provided
        if progress is not None and expose_task_id is not None:
            try:
                progress.update(expose_task_id, advance=1)
            except Exception:
                pass

        # Wait for delay.
        if delay and delay > 0.0:
            print(f"Waiting {delay} seconds on {cam_name}")
            time.sleep(delay)

    return None


def process_image(
    process_queue: queue.Queue,
    complete_queue: queue.Queue,
    convert_flag: bool,
    compress_flag: bool,
    solve_flag: bool,
    pretty_flag: bool,
    verbose_flag: bool,
    per_cam_progress: dict,
):
    """Process all the images that come into the queue until we receive a `None`."""
    while True:
        item = process_queue.get()
        if item is None:
            process_queue.task_done()
            break

        cam_name, file_path = item
        cam_prog_entry = per_cam_progress.get(cam_name)
        cam_progress: Progress | None = None
        cam_tasks: dict | None = None
        if cam_prog_entry:
            cam_progress = cam_prog_entry.get("progress")
            cam_tasks = cam_prog_entry.get("tasks")

        # Convert to FITS if needed (e.g., from CR2)
        if convert_flag:
            try:
                if not file_path.suffix == ".fits":
                    file_path = cr2_utils.cr2_to_fits(file_path, remove_cr2=True)
                    if verbose_flag:
                        print(f"Converted {file_path} to FITS")
            except Exception as e:
                if verbose_flag:
                    print(f"Couldn't convert image to FITS: {e}")
                # If conversion failed, skip compression afterwards for this image
                compress_flag = False
            finally:
                # Advance convert task if present
                if cam_progress is not None and cam_tasks and "convert" in cam_tasks:
                    try:
                        cam_progress.update(cam_tasks["convert"], advance=1)
                    except Exception:
                        pass

        # Compress FITS to .fz
        if compress_flag:
            try:
                if file_path.suffix == ".fits":
                    file_path = Path(fpack(file_path.as_posix()))
                    if verbose_flag:
                        print(f"Compressed FITS to {file_path}")
            except Exception as e:
                if verbose_flag:
                    print(f"Couldn't compress {file_path}: {e}")
            finally:
                if cam_progress is not None and cam_tasks and "compress" in cam_tasks:
                    try:
                        cam_progress.update(cam_tasks["compress"], advance=1)
                    except Exception:
                        pass

        # Solve FITS
        if solve_flag:
            try:
                if file_path.suffix in (".fits", ".fz"):
                    get_solve_field(file_path)
                    if verbose_flag:
                        print(f"Solved {file_path}")
            except Exception as e:
                if verbose_flag:
                    print(f"Could not solve {file_path}: {e}")
            finally:
                if cam_progress is not None and cam_tasks and "solve" in cam_tasks:
                    try:
                        cam_progress.update(cam_tasks["solve"], advance=1)
                    except Exception:
                        pass

        # Make pretty image
        if pretty_flag:
            try:
                file_path = make_pretty_image(file_path.as_posix())
                if verbose_flag:
                    print(f"Created pretty image: {file_path}")
            except Exception as e:
                if verbose_flag:
                    print(f"Could not create pretty image for {file_path}: {e}")
            finally:
                if cam_progress is not None and cam_tasks and "pretty" in cam_tasks:
                    try:
                        cam_progress.update(cam_tasks["pretty"], advance=1)
                    except Exception:
                        pass

        # Update recent files list for this camera (keep only last 5)
        if cam_prog_entry:
            recent_list = cam_prog_entry.get("recent_files")
            if isinstance(recent_list, list):
                # Store the full path as a string
                try:
                    path_str = Path(file_path).as_posix()
                except Exception:
                    path_str = str(file_path)
                recent_list.append(path_str)
                # Trim to keep only the last 5 (oldest removed from the front)
                while len(recent_list) > 5:
                    recent_list.pop(0)

        complete_queue.put((cam_name, file_path))

        process_queue.task_done()
