panoptes/POCS/tests/test_dome_astrohaven.py

# Test the Astrohaven dome interface using a simulated dome controller.
from contextlib import suppress

import pytest
import serial

from panoptes.utils.config.client import set_config

from panoptes.pocs import hardware
from panoptes.pocs.dome import astrohaven, create_dome_simulator


@pytest.fixture(scope="function")
def dome():
    # Install our test handlers for the duration.
    serial.protocol_handler_packages.append("panoptes.pocs.dome")

    # Modify the config so that the dome uses the right controller and port.
    set_config("simulator", hardware.get_all_names(without=["dome"]))
    set_config(
        "dome",
        {
            "brand": "Astrohaven",
            "driver": "astrohaven",
            "port": "loop://",
        },
    )
    the_dome = create_dome_simulator()

    yield the_dome
    with suppress(Exception):
        the_dome.disconnect()

    # Remove our test handlers.
    serial.protocol_handler_packages.remove("panoptes.pocs.dome")


def test_create(dome):
    assert isinstance(dome, astrohaven.AstrohavenDome)
    assert isinstance(dome, astrohaven.Dome)
    # We use rs232.SerialData, which automatically connects.
    assert dome.is_connected


def test_connect_and_disconnect(dome):
    # We use rs232.SerialData, which automatically connects.
    assert dome.is_connected is True
    dome.disconnect()
    assert dome.is_connected is False
    assert dome.connect() is True
    assert dome.is_connected is True
    dome.disconnect()
    assert dome.is_connected is False


def test_disconnect(dome):
    assert dome.connect() is True
    dome.disconnect()
    assert dome.is_connected is False
    # Can repeat.
    dome.disconnect()
    assert dome.is_connected is False


@pytest.mark.skip(reason="No astrohaven_simulator protocol anymore")
def test_open_and_close_slit(dome):
    dome.connect()

    assert dome.open() is True
    assert dome.status["open"] == "open_both"
    assert dome.is_open is True

    # Try to open shutter
    assert dome.open() is True

    assert dome.close() is True
    assert dome.status["open"] == "closed_both"
    assert dome.is_closed is True

    # Try to close again
    assert dome.close() is True

    dome.disconnect()
