panoptes/POCS/tests/test_base.py

from panoptes.utils.database import PanDB

from panoptes.pocs.base import PAN_CONFIG_CACHE, PanBase


def test_with_logger():
    PanBase()


def test_with_db():
    base = PanBase(db=PanDB(db_type="memory", db_name="tester"))
    assert isinstance(base, PanBase)


def test_remember_config():
    base = PanBase()
    location1 = base.get_config(key="location", remember=False)

    assert "location" not in PAN_CONFIG_CACHE

    location2 = base.get_config(key="location", remember=True)
    assert "location" in PAN_CONFIG_CACHE

    assert location1 == location2
