panoptes/POCS/tests/test_codestyle.py

import os

import pycodestyle
import pytest


@pytest.fixture(scope="module", params=["pocs"])
def dirs_to_check(request):
    return request.param


def test_conformance(dirs_to_check):
    """Test that we conform to PEP-8."""
    config_file = os.path.join(".", "setup.cfg")
    style = pycodestyle.StyleGuide(quiet=False, config_file=config_file)

    print(dirs_to_check)
    style.input_dir(dirs_to_check)
    result = style.check_files()
    assert result.total_errors == 0, "Found code style errors (and warnings)."
