panoptes/POCS/(commit log)

2013-10-30 remove camera file
2013-10-30 Adding camera file
2013-10-30 Dummy items for mount
2013-11-21 Added description of “timeout conditions” to each while_state function. Note, the doc strings as I have written them are intended as notes for the programmers, not as documentation for the end users 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
2013-12-05 Fixed handling of currentState, by defining it in each while_state function (since on entrance to that function it can only have the value corresponding to that function) rather than passing it.
2013-12-20 Moved DSLR_Controller.ino to folder named DSLR_Controller to make Arduino software happy.
2013-12-20 Changes to DSLR_Controller.ino to handle commands. Added Test_DSLR.py python script to send command string to Arduino.
2013-12-20 Moved WeatherStation.ino to WeatherStation folder to make Arduino IDE happy.
2014-01-23 -Cleaning up initials of Mount class
2014-01-24 - Updating #9 -- Fixing the logger -- Giving warnings if no serial connection. Need to handle better. -- Writing some test items
    [mount.py, test_mount.py]
2014-01-24 - #15 -- Adding a testing file -- Currently having problems using astropy from within a repo, which seems crazy
2014-03-27 Create mount and cameras
2014-03-27 Base Camera class
2014-03-27 - Adding a base Panoptes class that others inherit from -- init method - Fixed some docs - Fixed the Observatory class
    [camera.py, mount.py]
2014-03-27 Moved query_conditions; Changed currState -> self.current_state
2014-03-27 Move current state init
2014-03-29 Making the mount class more abstract for a Factory pattern
2014-03-29 Better init for mount class
2014-03-29 -Generic mount class
2014-03-30 Reinstating testing mount file
2014-03-30 Testing mount finds all mounts
2014-03-30 Generic class name for mount types
2014-03-30 create methods actual import the proper module - config file could have mount and camera names specified by matching file name
2014-03-30 Fix the weather logger
    [weather.py]
2014-03-30 Test file loops over all the mounts
2014-03-30 Testing all mounts that implement Mount (not AbstractMount)
2014-03-30 Raise custom exception instead of warnings; update config rather than replace
    [config.py]
2014-03-30 Config updates: can load custom file for class (load_config_file) or just load the current config file that was altered by previous commands.
2014-03-30 Don't use Error class here or we get stuck in cyclical loading with has_utils
    [config.py]
2014-03-30 exit_program from error; MountNotFound error
2014-03-30 Raise exception if mount not given
2014-03-31 Adding a script to allow running a mount through a series of tests
2014-04-06 Don't create cameras and weather station for now
2014-05-21 Big commit of AAGCloudSensor.py code. This is based on some experimenting I had done for another project, but it is now object oriented. Added several methods to query values from the device.
2014-05-21 Futher edits to AAG cloud sensor. Now have basic skeleton of system in place, though not all methods are done yet. * Primarily edited get_weather_status() method so that it writes information to a lo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
2014-05-21 Fixing some of the mount ports; need to move these to config file
    [mount.py]
2014-05-22 Switching port; this will go into config eventually
2014-05-22 Fixing some serial_port errors
    [mount.py]
2014-05-22 Added pdfs for AAG Cloud Sensor to the docs/ folder.
2014-05-23 Fixed error in calculation of ambient temperature. Used incorrect calculation for firmware v3+ in manual. It should be same calc as sky temp.
2014-05-26 Start pulling all mount info from specific config file
2014-05-27 Started laying out camera simulator architecture.
2014-05-27 * Renamed brand to type since there may be multiple types with the same brand in some cases. * Changed default values of type to be 'Simulator' * Edits to section on weather to match current status o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
2014-05-27 Give a better error without mount port
    [mount.py]
2014-05-27 Switched 'brand' to 'model' ('type' is a reserved keyword we should avoid)
2014-05-27 Setting up mount cleaner
2014-05-27 check for required mount commands
2014-05-28 Adding response for version and mount_info
2014-05-28 Removing print debug
2014-05-28 Cleanup of Mount, autoload commands
2014-05-29 Lookup of mount commands
2014-05-31 Handle missing commands better
    [mount.py, test_ioptron.py]
2014-05-31 Actually fail if no commands givien
    [mount.py]
2014-05-31 Adjustments to config file for mount based off testing
2014-05-31 Update to test for mount setup
2014-05-31 Fixing assertions and debug info
    [mount.py]
2014-05-31 Mount config is self-aware.; adding tests for default options
2014-05-31 Switch to eq_
2014-05-31 Lots of code for Canon camera initialization. Wrote methods to get and set various camera settings.
2014-05-31 Switching logic
2014-05-31 Adding a test to connect to mount
2014-05-31 Adding some debug; Fixing get_command
    [mount.py]
2014-05-31 Default to None for port; import errors
    [serial.py]
2014-05-31 Add a test for bad connection and bad command; use panoptes errors
    [test_ioptron.py]
2014-05-31 Adding panoptes errors; better get_command
    [mount.py]
2014-05-31 Give broken port so broken connect test always fails
    [test_ioptron.py]
2014-05-31 raise a BadSerialConnection error
    [mount.py, serial.py]
2014-05-31 Raise correct error; skip tests if not connected
    [test_ioptron.py]
2014-05-31 Better exceptions for mount
2014-06-01 Order the mount tests
2014-06-01 Added test for version of mount
2014-06-01 Making is_slewing a property; Adding _get_response to get the expected response from a mount; started test for position
2014-06-01 Changes in docs Better error thrown when mount not specified in config
2014-06-03 Lots of work bringin the mount in line with serial
2014-06-03 Added function to detect cameras.
2014-06-03 Mount serial cleanup; we have contact
2014-06-03 Fix test 007 and 012
    [test_ioptron.py]
2014-06-03 Fixing mount class config and tests
    [mount.py]
2014-06-03 Bringing mount config, tests back in line
2014-06-04 Better errors; updates to tests; adding psotion
    [mount.py, serial.py]
2014-06-04 Trick mount into thinking it is initialized while initialzing
2014-06-04 Updating a bunch of material
2014-06-05 Added cooling property to Canon for compatibility. It reads True or False as if it were a cooled camera, but does nothing.
2014-06-05 * Renamed classes so that AbstractCamera is the class from which specific cameras inherit. * Renamed CanonDSLR class to Camera so that the import will always import a Camera object, but from a module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
2014-06-06 Proper site setup for mount; serial_query accepts params for command
2014-06-06 - serial_query accepts params - auto-init mount when creating observatory
2014-06-06 Fix space between cmd and params
    [mount.py]
2014-06-06 Fixing test for setting date with params
    [test_ioptron.py]
2014-06-07 Only setup_site if the mount has been initialized
2014-06-07 - Add ephem for site for tests - Add attributes to tests so they can be skipped easily
    [test_ioptron.py]
2014-06-07 Committing a broken test 14...need to work on mount input/output formats
    [test_ioptron.py]
2014-06-10 Updating requirements; Adding calibrate_mount command; Updating docs
2014-06-18 Update config.py
    Fixing FileNotFoundError to be IOError so more generic. Also handles differences between python3.3 and 3.4
    [config.py]
2014-06-21 Create a stop_observing dummy method; observatory does not connect to mount on startup by default
2014-06-27 Adding camera utility to base module
2014-06-27 Some setup work for the cameras from the observatory
2014-06-27 Fix when the camera is created
2014-06-27 - Rename CanonDSLR.py to canon.py for auto-discovery via config - added cameras to config - create_cameras works from observatory -- Set from config, we probably want to confirm connection via gphoto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
2014-06-27 Moved all code to the AbstractCamera in camera.py
2014-06-27 Properly create camera from observatory
2014-06-27 Moving the bulk of the work into the abstract camera class
2014-06-28 Fixing config for mount load
    [mount.py]
2014-07-01 Setting connect_on_startup status for camera and mount
2014-07-01 Added connect_on_startup; removed some print statements; image filename is timestamped
2014-07-02 Integrating doxygen and sphinx
    [alias.cfg, auto.cfg, c_file.cfg, class.cfg, fixedwidthfont.cfg, functionOverload.cfg, group.cfg, image.cfg]
2014-07-03 Moving all this documentation experimentation to a separate branch
    [alias.cfg, auto.cfg, c_file.cfg, class.cfg, fixedwidthfont.cfg, functionOverload.cfg, group.cfg, image.cfg]
2014-07-08 Adding conversion from mount coords to astropy.coordinates.SkyCoord
2014-07-08 Much rearranging; Adding SkyCoord; Adding target_coordinates and mount_coordinates; other
2014-07-08 Don't create cameras right now
2014-07-12 Removing test state machine and switching to smach
2014-07-12 Do no test with camera
2014-07-15 - Bringing all the StateMachine code in line -- Separating out the states for various areas (just mount for now) -- Creating base state that other states can inherit from to reduce code
2014-07-15 Renaming states file to be more generic and not mount; individual states might want to be split into individual files as they grow larger
2014-07-15 Starting to test some mount features via the statemachine
2014-07-16 Utility functions for converting between the mount and the SkyCoord
2014-07-16 - Removing @property from commands so we have a consistent interface (always calling methods) - Adding target_coordinates and mount_coordinates (uses astropy.coordinates.SkyCoord) -- target_coordinat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
2014-07-16 Fixing the calls to methods that are no longer a @property
    [mount.py]
2014-07-18 Fixing a few small items; making is_connected a property; removing docs
    [mount.py]
2014-07-19 Converting between mount specific commands and astropy.coordinates.skycoord
2014-07-19 Conversions between mount and skycoord mo bettah
2014-07-23 - Added properties at init (_is_tracking, _is_slewing, _is_parked) - Fixed is_parked
    [mount.py]
2014-07-24 Calibrate the mount upon initialization
2014-07-29 Adding the RS485 manuals and wiring diagram to the docs
2014-07-29 Reverting simple picture taking and commenting out the test bulb exposure for now
    [camera.py]
2014-08-02 First cut at some code defining the scheduler, target, and observation objects. Some of this is still pseudocode and does not work.
2014-08-13 Updating documentation landing page
2014-08-14 Switching the RS232 command set reference
2014-08-29 Move canon specific material to canon.py module.
2014-09-05 Mount and camera connect_on_startup in config
2014-09-07 Basic accelerometer output for camera box
2014-09-07 Making our serial function capable of threaded reads for real-time data
2014-09-07 Add arduino port to config
2014-09-08 Enable mount connect
2014-09-12 Changing track test time
2014-09-14 Adding a threads utility that supports stoppable threads
2014-09-14 Change weather folder to environment; Make panoptes driver start environment monitoring cleaner
2014-09-14 Start creating camera enclosure monitor
2014-09-19 Updates to reading of the camera enclosure
2014-09-19 Camera enclsorue starts monitoring with config
2014-09-20 Adding interrupt handlers for shutting down the system
2014-09-20 Adding name to camera enclosure monitoring
2014-09-20 Updates to track testing
2014-09-22 Working on getting filename info from camera configuration. Not working yet.
    [camera.py]
2014-09-24 Changing initialize_mount to setup; Fixing some of the site location coordinates; small cleanup
    [mount.py]
2014-09-24 Use initialize mount
2014-09-24 Mount and camera never connect on startup. Must be handled specifically
2014-11-26 Adding the site_setup before the calibrate_mount
2014-11-27 Fixing how lat/long are set with new RS232 commands
    [mount.py]
2014-11-27 Moving the setup_site to the iOptron class instead of the abstract mount class
2014-11-27 Adding Park coordinates for mount
2014-12-08 Updates to Arduino code; reading all sensors
2014-12-10 Getting Cloud Sensor basics working
2014-12-12 Fixing the slew_to_park; adding _park_coordinates which discovers current RA-Dec based off of Alt-Az.
    [mount.py]
2014-12-12 Turn on fan
2014-12-13 Small change to reading of sensors
2014-12-14 Fixing Authentication; Adding in motor library for async access to mongo; cleanup
2014-12-14 Cleaning up authentication and using motor for lookup
2014-12-17 Update how the sensor data is being entered
2014-12-17 Update current
2014-12-17 Renaming some of the sensors
2014-12-17 Current reading still has date; marked current by 'status'
2014-12-17 Cleaning up arduino file
2014-12-17 Fixing the temperature readout for ds18b20
2014-12-17 Cleaning up arduino code
2014-12-17 Fixing arduino sensors
2014-12-18 Adding uimodules for sensors; adding json_utils for bson from mongo; cleanup
2014-12-18 Many updates and changes to get sensor values displaying
2014-12-18 Adding in a lot of updates from sensors
2014-12-18 Add all sensors
2014-12-18 Update sensor values
2014-12-18 Updates to sensors
2014-12-21 Fixing up the mount -> skycoord conversion
2014-12-21 Fixing the skycoord -> mount :NOTE: This needs to be tested as there is some discrepancy with how many digits are passed in the documentation
2014-12-21 Fixing calling of get_coordinates
    [mount.py]
2014-12-21 Fixing some documentation; fixing the check_coordinates
    [mount.py]
2014-12-21 Add the fan status to the arduino output message
2014-12-21 Adding simple counter; adding commas to fix some readout; turning off green led flash inside camera
2014-12-21 Fixing the initialization of mount
2014-12-21 Setting target correctly; eliminating duplicate code
    [mount.py]
2014-12-25 Nothing is needed from weather.Weather any longer; we want to inherit from environment.Weather and thread this into the main app - runs standalone for now
2014-12-25 Add condititonal to output of sensor values
2014-12-25 Use millis() instead of counter
2014-12-25 Use millis() intead of counter
2014-12-25 Adding serial input support to control fan
2014-12-25 Support reading serial in so we can toggle cameras (and led); cleaning up debug statements
2014-12-25 Use pin names
2014-12-26 Create mount comment back in
2014-12-26 Changing the sensor handler into a socket
2014-12-26 Adjusting websocket for sensors
2014-12-27 PUSHing the sensor messages
2014-12-31 Default to only 5 frames; ignore stderr and stdout
2014-12-31 Frames back to 255; threads for each cam; loop threads for 45 seconds and make daemon
2014-12-31 Change sleep time; fixed debug statement; NOTE: need to fix up part of the thread still
2014-12-31 Switched threads to processes; fixed block' script working - TODO: flux and meta information to db
2014-12-31 Join threads after stopping;
2015-01-01 Pin variables are const; using LED_BUILTIN
2015-02-03 Bumping version of mount back to 30. This should be in config or some beter option
2015-03-04 Adding in a 0mq broker for communicating between web and mount
2015-03-04 Renamed websockets connection; added documentation; cleaned up some sockets
2015-03-05 Adding MountControl ui module; Formatting
2015-03-05 Mount control from admin interface
2015-03-05 Adjusting for mount control; need to fix for sensors; adding logging
2015-03-06 All logic has moved to the mount_control.html for now
2015-03-06 Check for mount connection
2015-03-06 Removing mount_status callback loop for now
2015-03-06 Fixing some of the logic for when and how messages get delivered in relation to whether or not a mount is connected
2015-03-10 Moving mount control items to mount class
2015-03-10 Moving mount control loop to mount class; cleanup
2015-03-10 Moving mount messaging setup to mount class; cleanup
2015-03-10 Adding mount messaging to mount class
2015-03-10 Removing old sensor handler
2015-03-10 Removing old sensor handlers
2015-03-11 Comment out threading stuff
2015-03-11 Don't allow mount to move via website for now
2015-03-12 Cleaning up mount control
2015-03-12 Handle disconnected mount more intelligently
2015-03-13 Fixing the stopping of mount_status loop
2015-03-13 Mount status loop updates and fixes
    [mount.py]
2015-03-13 Don't start mount control; must start manually; need to figure out a better way
2015-03-13 Fix temperature graphs
2015-03-13 Updating the sensor reading
2015-03-13 Pretty print the json
2015-03-13 Adding log to sensors
2015-03-13 Testing sensors
2015-03-13 Remove sensors
2015-03-13 Just the temperature
2015-03-13 Fix temperature box
2015-03-20 Fixing config for environment sensors; updating serial read to read from config
2015-03-20 Adding name for thread; renamed 'next' to 'get_reading'; make threaded by deault
2015-03-20 Switch from threading to multiprocessing
2015-03-20 Clean up the environmental sensors
2015-03-20 Add mongo and messaging to serial montiore; handler mongo inserts and zmq messages; add ability to stop
2015-03-20 Committing changes to camera enclouse before removing
2015-03-20 Properly set up environmental sensors
2015-03-21 Added slew_to_zero as alternate name to slew_to_home; added _set_zero_position and _set_park_position; switch to proper NotImplementedError
2015-03-21 Small switch for getting coords
2015-03-29 Switch to using Markdown for documentation
2015-03-30 Simulate sensors
2015-03-30 Changed 'date' to 'time'; update correct current 'type'
2015-03-30 Insert directly
2015-03-30 Update key names; better print
2015-03-30 Updates to web
    [ufo_dates.csv]
2015-03-30 Sensor simulator starts with some good data
2015-05-08 Complete rewrite of AAG Cloud Sensor code. Should suck less now
2015-06-20 Adjusting log levels and for number of sensers; Also pointing to arduino_2 for this system (NOTE: need to fix this)
2015-06-27 Quick switch to default config format for RA-Dec
2015-07-02 Updating the molleweide projection so it works with ra/dec from (fake) accelerometer values
2015-07-16 Create Dockerfile
    First cut at Dockerfile
2015-08-05 Some logging updates to debug mount
2015-08-07 Split sensors
2015-08-08 * Removing all the sensors code from the main panoptes * Fixing up more of the issues with module imports
2015-08-08 Give warning about missing environment variables if cannot open config file.
    [config.py]
2015-08-08 Removing code related to sensors
2015-08-08 * Fixing the import for the mount modules * Adding warning to specify missing dependencies (ImportError will be thrown if any modules required by the mount module are not available).
2015-08-09 Bringing the sensors and support modules into line with split
2015-08-09 * Getting sensors running: * Passing config * Updating weather config *
2015-08-09 * Bringing all the sensors in line with the split from the main panoptes file
2015-08-09 Adjusting cloud sensor to use logger
2015-08-10 Don't connect sensors on startup by default
2015-08-11 * Adding config for mount * Fixing mounts conf_file dir
    [mount.py]
2015-08-11 Delete RS485 wiring HBX.jpg
    Cleanup
2015-08-11 * Pulling out pyephem * Making `site` a generic property on the Mount base clase, with `_setup_site` called by the setter method, so `_setup_site` can be overriden by child classes
2015-08-11 * setup_site cannot be run because mount must be initialized first, so we need to call it after initialize * astropy units are never plural
2015-08-11 Do not create cameras for now and give a dumb print(err) on module import error
2015-08-11 I have to comment out the serial import to make the test suite run but that is not right so this will need to be revisted shortly
    [serial.py]
2015-08-11 Adding a basic test for the mount
2015-08-11 Cleaning up mount and removing old code
2015-08-11 * Removing all zmq messaging from mount
2015-08-11 Adding an AltAz frame for our observatory
2015-08-13 Updating sensor script
2015-08-13 * Better mount initialization * import serial for serial * Don't create scheduler
2015-08-17 Adjust park position so it is calculated from hourangle - first cut
2015-08-17 * Adding the site information back into the mount
2015-08-17 * Changing mount.site to mount.location.
2015-08-17 * Set initial location for mount upon initilization * Get rid of AltAz methods
2015-08-17 * Fixing declination angle. * Updating notebook
    [mount.py]
2015-08-17 * Pass entire config to mount * Working on parking position via HA/Dec
2015-08-17 * Adding is_parked property and checking before any serial_query commands. NOTE: This should probably only apply to the movement commands actually so will be fixing that soon.
    [mount.py]
2015-08-18 * Removing zmq from mount
2015-08-18 * More documentation updates for mount class
2015-08-19 Documentation updates to mount class
2015-08-21 * Also import all the sensors information when importing panoptes
2015-08-29 Updated AAG control with PID loop to control PWM output. Added reading of config file for thresholds.
2015-08-30 Added output limits to PID. Updates to plots.
2015-08-30 Rearrange plots. Tweaks to PID.
2015-08-31 Heater control now based on instantaneous wetness. Tweaks to plots
2015-08-31 Heater PID control loop uses rain freq to generate offset target
2015-08-31 PID loop now expires data after 10 minutes when calculating integral term.
2015-08-31 Finish expiration of PID values for Ival
2015-08-31 Tweaks to PID
2015-08-31 Tweak PID loop parameters
2015-08-31 Adding some debug to mount; explicitly convert int response
2015-09-01 * Switching some debug statements * Removing check_pier_position command (ioptron doesn't support it in new command set) * Starting to add the get_coords_for_ha_dec method
    [mount.py]
2015-09-01 * Fixing up basic mount and observatory tests
    [mount.py, test_ioptron.py, test_observatory.py]
2015-09-01 * Fixing up test locations
    [test_ioptron.py]
2015-09-02 Remove heater PID for now
2015-09-02 Turn heater on and off simply
2015-09-02 Tweaks to plots. Bugfix for heater
2015-09-05 Add documentation for AAG rain sensor heater
2015-09-07 * panoptes.utils.load_module for loading modules. Currently just wraps astropy resolve_name * Cleaning up loading of transitions and states * Wrapping all states with before/after logging
2015-09-09 Changes to weather sensor script in repo to get it reading values
2015-09-11 * Quick change to make machine go to parking state if interrupted.
2015-09-13 Turn off PWM
2015-09-13 * Changing some logging to debug since it's easy to switch now * Adding some more targets to dummy scheduler
2015-09-14 * Fixing error imports * Fixing BadSerialConnection error checking. * Removing any logger.info statements from private methods.
    [mount.py]
2015-09-16 Working on heater algorithm and fixing logging
2015-09-16 Added PID to utils
2015-09-16 Add heater config
2015-09-16 PID loop work. Change plots to use astroplan not ephem. Messaging changes.
2015-09-17 Add reset_integral option to PID
2015-09-17 Use utils.PID. Tweak plot limits
2015-09-17 Have PID calculate interval between recalculate operations
2015-09-17 Don't use PID loop in impulse heating
2015-09-17 Use algorithm form manual to set PWM during impulse heating.
2015-09-17 Increase Kp and Kd in heater PID
2015-09-17 Adjust coefficients on heater PID
2015-09-17 Annotate plots with current values. Tweak plot parameters.
2015-09-17 Tweak PID parameters
2015-09-17 PID parameter adjustment. Plot tweaks.
2015-09-19 * Starting to clean up the camera code.
2015-09-19 * Starting to update the camera module
2015-09-20 Updating the camera module * Connect should set all the options properly * one method `command` to run commands * Other cleanup
2015-09-21 * Move PrintLog to the main utils import so it can be used in all utils * Fixed read_pgm
2015-09-21 * Cleaning up some documentation * Making the dummy PrintLog more robust; can change verbose or not.
2015-09-21 * Fix camera `command` method * Remove things from canon init method that are in camera init method
    [camera.py]
2015-09-21 * Pass the actual command to the camera
2015-09-21 * Grab the output from the camera command
2015-09-21 * Show response from camera * Look through properties properly
2015-09-23 * Use correct sensors variable.
2015-09-25 * Store sensors under different name (maybe it is getting clobbered?)
2015-09-26 * Starting to update `observer.location` to just be a dict of location information. This will then be passed to the scheduler, which will be a subclass of astroplan.Observer. The mount also creates a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
2015-09-26 * Fix to importing of camera config
2015-09-27 * Fix up gphoto2 command * Parse the config correctly
    [camera.py]
2015-09-27 Updating the camera settings
2015-09-28 Small change. NOTE: Auto Power Off is not working with gphoto2 right now even with this change.
    [camera.py]
2015-09-29 * Fixing observatory test for location differences
    [test_observatory.py]
2015-09-29 * Many updates to use INDI for Canon cameras * Basic take_exposure working.
2015-09-29 * Pass EarthLocation to mount instead of location dict
2015-09-29 * Also adding an earth location and passing to both scheduler and mount
2015-10-02 * Camera tests
2015-10-02 * Adding PanIndiDevice for working with devices * Load devices
2015-10-02 * Starting/stopping drivers properly. * Well, the stopping seems to be a little funky
2015-10-03 * Adding set_property method * Removing class for device as it is all handled by the client
2015-10-03 * Separate so there is an PanIndiDevice and PanIndiServer class. The Panoptes class will start the server and create devices. Better separation.
2015-10-03 * Adding shutdown method and signal interrupt. * Removing from sensors (which will probably be entirely replaced by the INDI)
2015-10-03 Do not build cameras for now
2015-10-03 Camera control notebook from PAN001
2015-10-03 * Load drivers correctly * Connect/disconnect correctly * Attempt to get shutdown working with interrupt but still needs to be fixed
2015-10-03 * `name` and `driver` are required for loading
2015-10-03 * Cleaning up AbstractCamera class, removing anything specific to gphoto2 * NOTE: There are currently a bunch of NotImplementedError for get_* properties. I'm not sure this is the best way to handle 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
2015-10-03 * Fixing tests from re-arrange
    [test_ioptron.py]
2015-10-03 * Give error when device can't communicate with server
2015-10-03 * Creating error.FifoNotFound * INDI server doesn't accept host or port as we use FIFO (for dynamic driver loading)
2015-10-03 * Switching order of params to `load_driver`
2015-10-05 * Fixing copy typo
    [mount.py]
2015-10-06 * Correctly capture error
    [mount.py]
2015-10-06 * Raise an error when mount not found.
    [mount.py]
2015-10-09 * Removing the HA/Dec convenience methods from the mount and putting in the scheduler. (The mount is dumb and just accepts coordinates - the scheduler is smart and knows where and when it is)
2015-10-09 * SEtting up observatory test fixtures
    [test_observatory.py]
2015-10-12 Adding a method for getting current RA and Dec
2015-10-30 Cleanup mount moving by direction pad.
2015-10-30 Moving adming dir inside panoptes
    [ufo_dates.csv]
2015-10-30 Updating INDI devices and tests
2015-11-01 Convenience method to load driver from device
2015-11-01 Many change to INDI to get camera working
2015-11-01 Adding driver and model to config for now
2015-11-02 Mount with INDI
2015-11-02 Add the name to mount
2015-11-02 Properly set mount time and location
2015-11-02 Setting some initial commands on the mount
2015-11-02 Cameras have unique names
2015-11-03 Adding both cameras to cnofig
2015-11-03 Adding port to device
2015-11-03 Correctly set mount position
2015-11-03 Update base mount to match indi mount
2015-11-03 Only load indi driver if using indi
2015-11-03 Debug mount cnofig
2015-11-03 Add resources_dir to mount config
2015-11-07 Moving admin back out of main
    [ufo_dates.csv]
2015-11-07 Move adming to web
    [ufo_dates.csv]
2015-11-07 Cleaing up web dir
    [ufo_dates.csv]
2015-11-07 Still no camera
2015-11-07 Removing driver calls for INDI; clients should declare themselves to the server so Observatory can remain agnositc
2015-11-07 Add INDI server to panoptes core; safer mount import
2015-11-07 `power_down` on delete
2015-11-07 Put system exit in `power_down`
2015-11-07 Fixing default camera import
2015-11-08 Fixing camera imports
2015-11-08 Creating two abstract camera classes; should have a bse class as well.
2015-11-08 Removing default import from camera
2015-11-08 Fixing serial data import errors
    [mount.py]
2015-11-08 Make abstract class for camera; gphoto2 and indi both inherit from it; NOTE: indi class will need some work on the multiple inheritance
2015-11-08 Adding `set` method for gphoto2 properties. Fixing `command` output
    [camera.py]
2015-11-08 Fixing gphoto2 base class
    [camera.py]
2015-11-08 Fixing the Popen command to interact with gphoto2 nicely. Gets output correctly.
    [camera.py]
2015-11-08 Making gphoto2 commands non-blocking but non error when called twice
    [camera.py]
2015-11-08 Update to threads name; NOTE: I think this is not used
2015-11-08 Adding a mount simulator
2015-11-08 Print exception
2015-11-08 Adding device driver loading to device
2015-11-08 Mount will initialize itself
2015-11-08 Fixing unloading of driver
2015-11-08 initialize the INDI mount
2015-11-08 initialize the ioptron mount
2015-11-08 Trying to `home_and_park` on interrupt but sighup doesn't seem to work
2015-11-08 Cleaning up staring of INDI server; removing loading of drivers (client is responsible)
2015-11-08 Make driver loading and unloading check first
2015-11-08 Adding basics of messaging; making `power_down` a separate process. Not sure that is a good idea
2015-11-09 Config should have two cameras
2015-11-10 Check for mount before parking
2015-11-16 Updates to mount initialization to make more consisten
2015-11-23 Fix the mount initialization
2015-12-01 Removed a lot of first cut methods. Using `scimage.feature.register_translation` for the image offset
2015-12-01 Do some better mount checking
2015-12-01 Removing `run` method; removing concept of prev/next state (it is manual now); Switched check condition to `is_safe` which will check all sensors, not just weather
2015-12-20 fixing the mount status call
2015-12-20 Adding return call back to the states; about to switch to include the asyncio
2015-12-22 `power_down` checks for `_connected` property so it is not called multiple times
2015-12-28 Fixes to mount simulator
    [simulator.py]
2015-12-28 More updates to mount simulator
2015-12-28 * Adding the `is_safe` condition check for all transitions * Check for sleeping state on `power_down`
2015-12-29 * Major updates to the logging: * All modules are now part of the parent 'panoptes' logger, e.g. 'panoptes.observatory', 'panoptes.observatory.mount', etc. * Logging is configured in the main config 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
    [camera.py, simulator.py]
2015-12-29 * Splitting out the event loop logic to a separate module * Now the state machine, state logic, and event logic are all base classes that `Panoptes` inherits from. This will make them easy to switch 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
2015-12-30 * Fixing up the simulator arg to automatically create simulators * Fixing camera simulator to laod * NOTE: Mount simulator is okay, camera probably needs work * Some logging fixes
    [simulator.py]
2015-12-30 Fixing some debug statements
    [simulator.py]
2015-12-30 * Fixing up inheritance * Adding the asyncio calls to the machine
    [mount.py, simulator.py]
2015-12-30 * Mount doesn't need asyncio, it should all exist in the machine
    [mount.py]
2015-12-30 * Adding event loop to mount simulator * Moving all the state and event logic to one folder (`state`)
2015-12-30 * `power_down` if we can't connect to the mount * `power_down` shuts down the event loop (instead of sigint handler)
2015-12-31 Remove callback from gphoto2 camera; should be handled in event loop
2015-12-31 * Executable parses arguments better * Simulator set up better so that you can run a simulator from the command line for the 'weather', 'camera', or 'mount' (or 'all') * Fixed debug on command line
    * Misc. small fixes
    [simulator.py]
2015-12-31 * Fixing convenience methods in state logic. * `wait_until` (and ensuing private methods) * Small fixes
    [simulator.py]
2016-01-01 * Fixing up simulators for mount and camera * Small fixes
    [simulator.py]
2016-01-01 * Creating convenience mount methods for the event logic
2016-01-01 * Fixing inheritance for camera * Updated simulator mount to be more realistic * Updates to INDI device and server * Fixes to write permissions for FIFO * NOTE: Not using this yet, was taking too muc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
    [camera.py, simulator.py]
2016-01-01 * Updating base config file * Better way to specify directories * Created some new directories, specifically the `targets` dir for target files * Perpetual annoyances with camera
2016-01-01 TimeRotatingFileHandlers will rotate on Sunday at 11am rather than at midnight. These are the `all` and `warn` handlers
2016-01-01 * Creating an `auto_detect` param for the executable. * Currently only detecting camera ports; if `auto_detect` and no ports available, skip camera createion. Detecting is done with the convenience u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
    [camera.py]
2016-01-01 Better filename creation for canon cameras; serial number now limited to 6 chars in filename
2016-01-02 * Finishing the `wait_until_file_exists` method for the logic file * The Observing state will now wait until both images exist before advancing to the Analyzing state * Fixing up simulator
    [camera.py, simulator.py]
2016-01-02 * Fixing the mount calls for status for home position
2016-01-02 Warn if no cameras detected
2016-01-03 Trying to fix mount command dir
2016-01-03 * Fixed the mount directory in config
2016-01-04 Throw error if no cameras
2016-01-04 * Initial state set to 'sleeping' * Tracking the observations and saving to Mongo (THIS NEEDS MUCH WORK) * Adjust the sleep delay and loop delay for state machine * Adding camera.uid property which i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
2016-01-05 * Observatory keeps track of `Target` * Added Wasp-76b to target list
2016-01-07 * Big changes to logic and machine * Observatory tracks `current_target` which tracks `current_visit` * Logic is simplified by having `pan.observatory.visit_target()`, which handles camera exposures 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
2016-01-08 * Observatory knows which is `primary_camera` (former `master_camera`) * Cameras are known to observatory by canonical name (e.g. Cam01, Cam02) * Scheduler `get_target` method accepts a camera object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
2016-01-12 Correct loop through camera objects
2016-01-12 * `Schedueler` now accepts a list of cameras upon creation. These cameras are then passed to each `Observation` in the `visit` list. Each `Observation` in turn has a number of `Exposures` that corres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
2016-01-12 * Base `Camera` as a `.uid` property * Fixes to taking exposures and getting list of images to wait for
    [camera.py, simulator.py]
2016-01-13 * Better detection of only camera to set 'primary' * Fixing the taking of exposures
2016-01-17 Added option to switch safe_delay (day versus bad weather)
2016-01-17 * Fixing the move from `parking` to `park` * Better error checking on plate solving * Get `reference_image` properly * If have `reference_image` try to plate solve * On park, check for day and weathe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
2016-01-18 * Adding methods for solving the offset properly. * First convert to fits * Try to plate solve * Measure offset via phase translation and convert to pixels ra/dec * If that fails, measure via the pla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
2016-01-18 * `make_pretty` picture * Better namespace usage * Trying to get `measure_offset` to be bulletproof but so far suffering from many minor flesh wounds * Added a convenience function for getting the ra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
2016-01-18 * Closing the loop on tracking model for first time! Woohoo! * Do solve offset first if image is alread solved, then do phase translation * Fixing some of the mount simulator
    [mount.py, simulator.py]
2016-01-19 Try to plate solve but on error do phase translation (instead of if/else)
2016-01-24 Fixing the solving of images and adjusting of mount * One camera must be set as the `guide` camera. Note that this is not necessarily the `primary` camera as you could feasibly have two `primary` but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
    [camera.py]
2016-01-26 Starting to add in the Pointing correction * Observatory has a `get_guide_camera` method. Note: There can be only one! * Always safe to `set_park` * Added in dummy `pointing` state. * Note: I have so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
2016-01-27 Set target after calibration
2016-01-27 Updates to the pointing * Going for less separation but stop after three iterations * Only expose for 30 s, make configurable easier * state machine reports mount status at every transition * Some fi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
    [mount.py, simulator.py]
2016-01-27 * Start a mount status check upon initialization. Currently calls every 10 s * Removing daemon option from `check_status` and moving async logic to main logic file * Adding some web fixes
2016-01-28 * Better coord reporting for mount * Added target
2016-01-28 * Link sample image for easy web viewing
2016-01-29 * Bringing sensors back with code
2016-01-29 Fixing sensors
2016-01-29 Starting sensors in observatory
2016-01-29 Adding debug for sensors
2016-01-29 * Removing messaging from sensors
2016-01-29 Switching the RA / Dec
2016-01-29 Insert the mount info
2016-01-29 Adding the mount_info collection
2016-01-30 * Updating filename construction * Updating mount reporting * Properly center around `crop_data` * Bug fixes
    [camera.py, mount.py, simulator.py]
2016-01-30 * Adding priority target for track testing * Try to adjust mount
2016-01-30 Fixing call to camera
2016-01-30 * Adjust camera filenames
2016-01-30 * Fixing filenames to cameras
2016-01-30 Adding guide camera id to fn
2016-01-30 * Removing rotation * Don't track after first?
2016-01-30 * Reset exposure.images on each iteration (if `Target` is selected again) * `current_exposure` is a property so private variable isn't exposed * More debug statements!
2016-01-31 * Send message then insert
2016-01-31 Web Page Updates * Adding mount status updates * Cleanup websockets
2016-01-31 Some updates to mount info
2016-01-31 Switchign directions
2016-01-31 * `reference_image` for `Target` instance can only be `primary` camera * Don't use negative conditionals if we are expecting to proceed normally. :)
2016-01-31 * More switching for tracking
2016-02-01 * All requests for current time go through utility method `current_time()` * Added back private method for setting zero point
2016-02-01 Fixing assertion for sensors db
2016-02-01 * Camera simulators have controlled UID and target (NOTE: Target not fully working yet) * If scheduler can't find a target, shut down * Fix up the state machine to move all the way to sleep regardles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
    [simulator.py]
2016-02-01 * `current_time` now reads environment variable $POCSTIME, which can be used to simulate
2016-02-02 * Lots of updates to simulator * Live plotting of drift on web page * Various web page updates
    [simulator.py]
2016-02-02 Symlink current graph to today
2016-02-02 * Fix the mount update on web
2016-02-03 * Adding PAN001 icon * Styling * Mount simulator updates * Rearrange web page
2016-02-03 * Fixed passing of fits headers to image processing functions * Web updates: * Better state display * Styling updates * Mount * Simulator improvements
    [mount.py]
2016-02-03 * Using threadsafe call to asyncio without any delay * Update status every 30
2016-02-03 * Status delay increased * Change of state sends status message * Better timestamps for website * All asyncio calls are threadsafe * Send offset info to website * Remove some old calls
2016-02-03 Web items moved to panoptes/PAWS repo
    [ufo_dates.csv]
2016-02-04 * Up simulator delay * Close plot properly for drift (NOTE: It all needs to be done better) * Fix `read_weather.py` so it only proceeds if connected * Rely on install of panoptes
    [simulator.py]
2016-02-05 * Change SkyCoord creation * Can accept `position` for hms/dms or `ra` and `dec` for degrees * Only check internet if no keyword supplied * Convenience method for creation * `current_time()` accepts 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
2016-02-07 INDI Library * Adding INDI Server to core * INDI mount updates
    Logging
    * Adding a filter for messaging to the logs
2016-02-10 * Don't die on plot barf
2016-02-11 * Trying to prevent stall
2016-02-13 Switch Dec directions
2016-02-21 * Model and brand for mount * Fixed some of the tracking offset
2016-02-21 Use first USB port for mount by default. NOTE: This needs to be fixed
2016-02-26 -Add a `driver` config option; rename mount driver files
2016-02-26 Fix link to current target
2016-02-29 * INDI updates for mount
2016-03-01 Mount simulator fix
2016-03-01 Variable name switch
2016-03-02 * Print and update in order
2016-03-03 * Store the config that was used * Add `utcnow` option to `current_time`
2016-03-03 * Adding a `db.insert_current` method that will add an entry into the `current` collection (one per type) and an entry into the corresponding collection. Basically separate the 'current' value out in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
2016-03-03 * Updating the `insert_current` method * State graph image saves name
2016-03-04 * Cleanup to db insert * More cleanup
2016-03-04 * Remove logger config information once loaded * `check_status` now only checks mount status * INDI `lookup_properties` can return just answers instead of full options
2016-03-05 * Cleanup up interrupt handlers * Convert to `async def` calls * Use asyncio wait loop during mount initialization * Fixed root logger
2016-03-09 Add keyboard interrupt
2016-03-11 * Updating how serial inserts
2016-03-15 * Fixing up coords for INDI driver
2016-03-17 Send observer (scheduler) to mount to get hourangle easier
2016-03-18 * Converting to use `panoptes.current` collection for mongo read values
2016-03-18 * Better collection handling * Convenience method to insert into both specific collection and `current` collection
2016-03-19 * Fix loading of serial commands when using INDI
    [mount.py]
2016-03-19 * Adding a timeout event for the image exposures; currently parks if an image times out but this needs to be adjusted to cancel exposure and reset cam.
2016-05-06 * Removing remaining async content * Updating mount simulator to not use async * Fixed auto transition to `schedule` state
    [simulator.py]
2016-05-08 * Remove mongo insert from `Observatory` object to `Panoptes`
2016-05-08 Proper insert into DB
2016-05-08 * Remove mongo insert but add comment for fixing
2016-05-09 Place marker for interrupting camera
2016-05-09 Initial commit of scripts to read serial (arduinos) and the weather
2016-05-10 Cleaning up sensors
2016-05-10 Moving sensor and webcam files over to PEAS
2016-05-10 * Sensors are keyed by name (e.g. camera_box, computer_box) instead of port * Cleanup
2016-05-10 * Created a basic sensor shell to operate sensors, will replace read scripts ideally * Fixed basic setup.py * Adding gitignore
2016-05-10 * Getting sensors into PanSensorShell
2016-05-10 * Renaming to `sensors` * Adding weather to shell
2016-05-10 * Cleanup sensors, make process
2016-05-10 * Fix method declaration
    [weather.py]
2016-05-10 * Switching most log info to log debug
2016-05-10 Fixing the PanMongo loading
    [weather.py]
2016-05-10 Ability to use filter for logger better
2016-05-10 Removing PrintLog
2016-05-12 * Fixing up processes to make more sense.
    [weather.py]
2016-05-12 * Pretty print of last reading * Fixing the check on the processes
2016-05-12 Fixing some of the looks for data change
    [weather.py]
2016-05-12 Fixing up weather plots
    [weather.py]
2016-05-12 Fixing rain frequency calculation
    [weather.py]
2016-05-12 * Fixing ambient temperature
    [weather.py]
2016-05-12 * Adding option to not set initial rates for mount when initializing. * Imiloa script doesn't need rates set here (iEQ30)
2016-05-12 * Adding the tracking rate caller for serial mounts
2016-05-13 auto detect the cameras
2016-05-13 Symlink graph even if it doesn't already exist
    [simulator.py]
2016-05-15 Reverting back to old ambient temp algorithm which appears to be correct but is not what manual says.
    [weather.py]
2016-05-15 Insert current weather data then make safety decision. Remove console print options
2016-05-15 * Insert after decision * Fixing config typo
    [weather.py]
2016-05-15 Show conditions for current values rather than previous values
2016-05-16 Going a little cray-cray with the color printing thingy
2016-05-16 * Printing
2016-05-17 * Make primary and guide if only camera
2016-05-26 Send the data for the sensor to the right channel
2016-05-26 Format sensor temp for rain
2016-05-26 Show PID if running
2016-05-26 Only get mount status if init
2016-05-26 * Better mount status
2016-05-27 * Switch name
2016-05-27 Unpark the mount
2016-05-27 * Getting guide camera correctly
2016-05-27 Cameras already initialized
2016-05-27 Get from main camera info
2016-05-27 Don't reset primary camera
2016-05-28 Show cameras
2016-05-28 Fix listing of cameras
2016-06-01 * Update config to have camera properties * Updates to example notebook
2016-07-06 * Cleanup to image utils (part of #30) * Camera config * loading options * Updated requirements file (#32)
2016-07-07 This is a lot of coding around the issue (which is probably a power cable issue)
2016-07-08 * Show the button movement speed after a status
2016-07-14 * Adding documentation to pocs_shell. * Adding mount movement ability to shell
2016-07-18 Switch logic for rain sensor
2016-07-18 * Switch message name for PEAS
2016-07-18 `ready` state should not transition to park on bad safety check. If in `ready` the unit should already be in the park position; sending to park causes it to slew to home then park, which can expose t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
2016-07-18 Reverting rain sensor as it never trips to safe now
    [weather.py]
2016-07-19 Hack for parking mount
2016-07-19 * Switching all state files from `pan` to `pocs` (which makes way more sense) * Moving safety check into `ready` state rather then before `run` loop
2016-07-20 * Update target and mount status * Mount simulator `move_direction` * Convenience for sending messages
2016-07-20 * mount status comes from observatory
2016-07-25 * Better error checking for pointing image in `Pointing` state * Fix bug related to guide image for PEC fit * Bug fixes related to status for Target and Mount * Moving `tracking_rate` property into b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
    [mount.py]
2016-07-25 Flip Y-Axis so lower left is (0,0)
2016-07-25 Cleaning up mount and adding tests. `Mount` class now requires a `config` and a `location`
2016-07-25 * `load_config` can accept `simulator` array * Fixing various tests for required params * Fix logger for `Observatory` * `Observatory` config is required * Mount simulator conform to base class
    [config.py, simulator.py, test_observatory.py]
2016-07-26 Adding tests for PEP8 (minus E501 - long lines) and cleaning up some PEP8 issues
    [test_codestyle.py]
2016-07-26 Travis Updates * Cache our pip * Docstring for fixtures
    [test_observatory.py]
2016-07-28 POCS Shell * Updates to interface * Fix the exit and print commands
2016-07-28 Slight fix to printing in color (not part of class)
2016-07-29 Travis: switch back to regular astroplan and use coverage
2016-08-02 Remove unneeded prints
2016-08-02 Add temperature limits to config
2016-08-09 PEAS Shell improvements * Get rid of print statement that happens too often * Status line that shows connected sensors (TODO: Show connected port)
2016-08-09 Get rid of useless print statement
2016-08-09 Automatically call the stop method when keyboard interrupt shuts down shell
2016-08-11 Making PEAS weather independent from POCS if needed * PID moved to PEAS * Mongo use not assumed (Note: no safety decision can be made without mongo)
2016-08-11 Decimal places on the pwm
2016-08-11 Fixing up the plot_weather for mongo Something still screwy with the dates
2016-08-12 Weather Sensor updates * Split some of the safety decision code for readability, also so you can more easily selective skip certain decisions (like wind if no anemometer)
    Plot Weather updates
    * Better datatypes (unicode and dates vs bytes and more bytes)
    [weather.py]
2016-08-15 Add step to set PWM to weather loop
2016-08-16 Add delay to set PWM command
2016-08-18 Refactor (#59)
    * PanBase created as a base class for `logger`, `config`, and `db`
    * Better loading of environment variables
    * * Removing `cameras` and `messaging` from `Target`
    * Adding example notebook
    * Cleanup and Reorg
    * Creating a base class `PanBase` for `logger`, `config`, and `db`
    * Lots of cleanup and removing of old cruft
    * Deleting INDI files
    * Cleaning up of classes that come from PanBase
    * Fixed camera simulator issues with port
    * Updating tests and fixing simulator args
    * Small change to mount test
    * Mount tests
    * Fixing coveralls in travis
    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
    [camera.py, config.py, mount.py]
2016-08-18 Various Updates * Adding filter option to base camera * Filling out `Observatory.observe` method * Making stubs for `analyze_recent` and `update_tracking` * Cleanup to camera simulator (#29) * Log `s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
2016-08-18 Observation Updates * Saving metadata directly to mongo after each exposure (closes #31) * Fix camera exposure looping * Updating available collections for database
2016-08-18 GPhoto2 camera doesn't take a config
    [camera.py]
2016-08-19 Move the parking fix from the `parking` state to the mount itself
2016-08-30 Fits headers (#61)
    * FITS Headers
    * Header conversion is done within `cr2_to_fits`
    * Default ICRS frame for coords (explicit set)
    * Metadata is written out to mongo
    * Test updates
    * Documentation cleanup
    * Testing Update
    * Adding command line option for real camera, weather, and mount, defaults to having simulator
    * Test Config
    * Set specific config for testing
    * Update to test to allow for slightly different calculations
    * Fixing test time observation
    * Observation Updates
    * Add `last_exposure` property that returns a tuple of the `image_id` and
    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
    [test_observation.py, test_observatory.py]
2016-08-30 Testing Updates * Adding configuration option to skip coverage for some files * Updated tests
    [test_pocs.py]
2016-08-30 Test Updates * config fixture moves into conftest.py * Adding tests to cover dispatch scheduler
    [test_observatory.py]
2016-08-30 * Removing `utcnow` option from `current_time` * Fixing tests when camera connected * Increasing coverage
    [test_observatory.py]
2016-08-30 Removing old utility method for moving mount
2016-08-31 Various Updates * Default to simple.yaml fields file (and fix config key entry) * POCS `run` can `exit_when_done` which will leave loop. * POCS loop can be paused via commands * Mount simualtor fixes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
    [config.py, mount.py, simulator.py, test_mount_simulator.py, test_observation.py]
2016-08-31 Add threshold lines and current time marker
2016-09-01 Mount * Cleaning up duplicated methods between base class and serial class * Misc. cleanup revealed in testing
    Scheduler
    * Removing `simple` scheduler
    Tests
    * Increasing test coverage
    * Ignoring data download file
    * Skipping various untestable sections
    POCS
    * `is_dark` can be simulated or not
    * Reogranization of some methods within `POCS`
    * Removing `PID` from utils
    * Removing `PanProcess`from utils
    * `PanMongo.insert_current` returns `id` of inserted record
    [mount.py, simulator.py, test_mount_simulator.py, test_observatory.py, test_pocs.py]
2016-09-08 Add pID
2016-09-08 Add local PID
2016-09-11 Switching info to debug for PWM values - lots of noise in the log file
    [weather.py]
2016-09-11 Fixing safety_delay reading and only tracking `weather_entries` for that delay
    [weather.py]
2016-09-11 Pointing * Fix typo Parking * Mount doesn't end up parked so don't hang in loop forever
2016-09-11 Try to stop the camera a number of times and check for file in between
2016-09-11 Checking for error output on cameras
2016-09-12 * Small update to shutter release script * Connect Camera after creation * Interrupt from the script rather than in `machine.py`
2016-09-12 Remove Camera param and fix release script
2016-09-14 Fix for using weather simulator
    [test_pocs.py]
2016-09-14 Integrating Image Class into running maching * `analyze_recent` (called in `analyzing` state) will get `Image.compute_offset` * `Observation.exposure_list` is an OrdererDict * `first_exposure` acts a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
    [test_observation.py]
2016-09-16 Camera * `take_exposure` handles FITS conversion
    Offsets and Tracking
    * Using image utils for now
    * Only dislaying RA/Dec offset
2016-09-17 Camera * Fixing indent after camera release
2016-09-17 Trying to debug camera workaraound
2016-09-17 Camera Debug
2016-09-17 Wait between camera iterations
2016-09-17 Camera * Don't write to memory card Mount * Properly display amount of time moved
2016-09-17 Camera * Separate the shutter release and the file download (from SD card)
2016-09-18 Camera * Only use serial number if we get one * Pass proper metadata to `take_exposure`
2016-10-13 Testing Updates * Solving tests should look for solver instead of looking for camera
2016-11-08 Two cameras (#66)
    * Removing split scripts for time and adding back port
    * Reverting back to exposing on two cameras; removing blocking features
    * Adding blank lines for pep8
2016-11-23 Scheduler fixes (#67)
    * Scheduler Updates
    * Create a base scheduler that the dispatch scheduler inherits from
    * Reset the `current_observation` when going to the `housekeeping` state
    * Small fix to reset observation
2016-11-27 Updating weather * Get weather station port from config * Fixing first wind entry * Catch wind errors and handle
    [weather.py]
2016-11-28 Longer sleep time to download images from camera
2016-11-28 Fixing wind safety when no value available
    [weather.py]
2016-11-28 Observe updates * Make observe event non-blocking * Sets a `threading.Event` when done. `observing` state loops every 30 seconds and checks for event to be set. Can do something in the loop and chang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
2016-11-28 Fixing wind dates * Only parse for datetime if a str
    [weather.py]
2016-11-29 Removing print statement from scheduler
2016-12-06 Observe cleanup (#68)
    * Removing commented code
    * Cleanup of the `observe` method
    * Moving logic for taking exposures into the camera object itself
    * Creating a `take_observation` that is a wrapper around `take_exposure`
    * `process_exposure` moved to the camera class and made public
    * Added `observatory.finish_observing` to be called after the camera
    has triggered the `threading.Event` and image has been processed
    * Making the `readout_time` and `extension` for cameras more generic
    * Adding a `pocs.db.get_current()` method that will return the most recent
    entry from the `current` collection for a given type
    * The `camera_event` is created inside `take_observ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
2016-12-06 POCS Updates * Adding a `run_once` option to only go through the state machine loop once * Checked in `scheduling` state * Keep track of all observations made via `scheduler.observation_list` * House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
2016-12-06 Doc and Test changes * Fixing the `observation_list` to set at correct times * Updating some documentation * Checking and resetting the FITS file used for testing
    [test_pocs.py]
2016-12-07 Travis solve field (#69)
    * Trying to get solver to work with travis
    * Another attempt at astrometry.net
    * Fixing up some travis dependencies
    * More travisa and astrometry fun! Yay!
    * More dumb dependency fixes
    * Even more dumb dependencies
    * Small travis fix
    * Try travis without explicit WCSLIB
    * Clearing out astrometry.net, need another solution
    * Marking one test as needing solve
    * Removing can_solve decorator
    * Test Updates
    * Better check for `wcsinfo` so no `--solve` is needed
    [test_pocs.py]
2016-12-08 Adding a setter on the `current_observation` property for the observatory (a pass-through to the scheduler property)
2016-12-08 Clear the current observation when parking
2016-12-09 Tracking model (#70)
    * Updates based on testing with real images. Now only takes non-fpacked fits as input.
    * Updates and bugfixes. Try to make more robust
    * Bugfixes
    * Make get_pointing_error return tuple of (dRA, dDec, magnitude of separation)
    * Fix bug in calculation of HA: need to use Jnow coordinates to compare with sidereal time
    * Fix additional instance where Jnow was needed in HA calculation.
    * Image class fixes
    * Check for some required headers
    * `get_wcs_pointing` required `self.wcs`
    * `get_wcs_pointing` called at end of `solve_field`
    * Pointing State
    * Use the Image class for finding pointing differences
    * Observatory Updates
    * Use the Image class fo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
    [test_pocs.py]
2016-12-15 * Set the mount button moving rate. To park correctly we move the mount manually for a certain number of seconds and it relies on the rate being set to the maximum. Rate gets reset on a power-cycle s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
2016-12-15 Messaging updates (#71)
    * Remove 3.6 for testing
    * Messaging Cleanup
    * Moving messaging items to the logic file
    * Launching the multiprocessing processes to listen for cmds and msgs
    * Work in Progress
    * pep8
    * Camera Fixes
    * Pass the appropriate time to the `Timer`
    * Messaging and Core Logic
    * Removed entire PanStateLogic and moved all items into the core file
    * Basics of messaging system listen
    * Core Cleanup
    * Moving some items into the machine file for clarity
    * Camera Simulator
    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
    [simulator.py, test_pocs.py]
2016-12-15 POCS Shell * Send messages * Remove forwarding devices (POCS handles this)
2016-12-15 Fixing pointing bug * Problem with how the pointing information is extracted led to bug that messed up the mount. This is reorganized some and should prevent that a little but need to do better error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
2016-12-15 * Add the mount headers to the pointing image
2016-12-15 Observed List * Changed from `observation_list` to `observed_list` * Added cleanup and reset methods * Tests
    [test_observatory.py]
2016-12-15 Travis is hanging on this test so split here to see which is causing the problem
    [test_pocs.py]
2016-12-16 POCS Core * Adding connected property that is unset when `power_down`
2016-12-16 * Comment out the `is_dark` tests to see if that is the real problem with travis
    [test_pocs.py]
2016-12-18 Mount Updates * Removing serial methods from base mount and adding to base serial * Adding `set_tracking_rate` to base mount and simulator * Docstrings
2016-12-23 Tracking Rate Adjustments * Fixing the commands for the tracking rate, which are documented incorrectly
    [mount.py, simulator.py]
2017-01-01 Fix the mount simulator tracking rate
    [simulator.py]
2017-01-02 * Add `messaging` as an option for a POCS instance that defaults to False. * Cleaning up the power_down procedure and enabling a `shutdown` command * Some doc updates
2017-01-10 Pocs shell update (#73)
    * Drift Align Shell
    * Basics of shell in place to be called from POCS Shell
    * Better parking of mount
    * Don't error with mount status
    * Drift Align Shell
    * Capable of doing drift tests: eastern, western, meridian, polar
    * Need to add both sides of meridian still
    * Drift Align
    * Use `take_observation` instead of `take_exposure`
    * headers are optional for `take_observation`
    * * Ability to specify primary camera by uid
    * Drift Align
    * Changing direction names
    * Adding east and west side of pier for meridian
    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
    [mount.py, simulator.py, test_observatory.py, test_pocs.py]
2017-01-10 Small changes * Better loop delay on mount simulator * Catch state transition errors at a higher level
    [simulator.py]
2017-01-10 Must check for exit before interrupt
2017-01-10 SBIG camera support (#72)
    * Started low level SBIG camera interface (enough for CC_OPEN_DRIVER, CC_QUERY_USB, CC_CLOSE_DRIVER)
    * Make SBIG library loader cross-platform (OS X version doesn't use standard .dylib extension)
    * Fixed incorrect data type in QUERY_USB_INFO class, added QueryUSBResults2 class
    SBIG driver call syntax right, tested with Query USB Info
    * Translated more enums & structs from SBIG C-header (can now use CC_GET_DRIVER_INFO command)
    Added structs and enums for link control, temperature regulation, exposure/readout, handles
    * Restructuring for POCS integration, PEP8
    * SBIGDriver now a Singleton, gets camera handles on initialisation, SBIG Cameras get ha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
2017-01-15 If weather is not safe when slew to home is called, power down directly
2017-01-16 Birger adaptor focuser support (#74)
    * Created base class for focusers
    * Added simulator, example notebook, __init__.py
    * Added tests for simulated focuser
    * Begun implementation of Birger focuser
    * Attempted implementation in terse mode. Need to switch to verbose.
    * Reimplementation using verbose mode.
    * Bug fixes, included Birger focuser in unit tests, excluded from codecov
    [birger.py, focuser.py, simulator.py, test_focuser.py]
2017-01-22 SBIG & Birger integration (#75)
    * Camera's optionally create/accept & associate with Focusers
    * Observatory now creates SBIG Camera & Focuser from configs
    * Added tests with associated Cameras/Focusers
    * Added extra Focuser tests (association with Cameras)
    * Added tests for simulated Camera
    * Force conversion to int in `pocs.focuser.birger.move_to()`
    * Changes requested by @wtgee for https://github.com/panoptes/POCS/pull/75
2017-01-28 POCS Shell * Cleaning up shutdown when Ctrl-C pressed
    Mount
    * `is_parked` can only be triggered in `park`/`unpark`, not from status
    * Cleanup of `home_and_park` method to avoid duplication
    Pointing State
    * Fix name of pointing image
    [mount.py]
2017-01-29 * Have a separate property for at mount park position (vs defined park position)
2017-01-30 Allowing arbitrary names to go into gphoto2 camera Setting name of pointing file
2017-02-02 Config updates (#76)
    * Removing `--no-fits2fits` from solving options
    * Updating Config Files
    * New loader that is more generic
    * Load any yaml file from conf dir along with local overrides
    * Load more than one conf file at once
    * Move the `conf_files` out of the `resources` dir
    * Config Updates
    * Fixing errors with conversion
    * Tests should all use the default config (`pocs.yaml`) and skip local
    * Fixing bare `except` statements
    * Removing all the bare `except`
    * Add pyfits explicity install to cover for `--no-fits2fits`
    * Trying to use latest astrometry net to figure out fits2fits issue
    * Fix the install command for astrometry.net
    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
    [birger.py, config.py, mount.py, pocs.yaml]
2017-02-03 Adding `ignore_local` to all the `load_config` in `tests`. * Note: Should probably have a better fixture option in conftest.py
    [test_ioptron.py, test_pocs.py]
2017-02-07 Messaging fix (#78)
    * Trying to make more generic and better
    Messaging Updates
    Misc
    * Free space is returned in the status
    * Trying to use latest astrometry net to figure out fits2fits issue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
    [pocs.yaml, serial.py, test_observatory.py, test_pocs.py]
2017-02-07 * Ignore serial mount for codecov
2017-02-07 Fixing error message for loading of local config
    [config.py]
2017-02-07 Implemented autofocus algorithm as `pocs.camera.sbig.Camera.autofocus()`
2017-02-07 Moved `autofocus` from SBIG `Camera` to `AbstractCamera` base class
2017-02-07 Fixed focuser tests, PEP8
    [test_focuser.py]
2017-02-07 Simulated camera used simulated focuser
2017-02-07 Threaded autofocus, tweaked Vollath F4 metric calculation
2017-02-07 Typo fix, reverted changes to Vollath F4, fitting
    [camera.py]
2017-02-07 Combined test_sbig & test_camera_simulator as test_camera, bug fixes
    [test_camera.py, test_focuser.py]
2017-02-07 Skip test_sbig_bad_driver if SBIG driver not installed
    [test_camera.py]
2017-02-08 Camera simulator now writes FITS files, fewer exceptions in tests
2017-02-08 Added autofocus tests, fixes for camera & focuser simulators
    [simulator.py, test_camera.py]
2017-02-09 Add autofocus tests to test_observatory, assorted bug fixes
    [camera.py, simulator.py, test_observatory.py]
2017-02-09 PEP8 & fix to camera string representation test
    [simulator.py, test_camera.py, test_observatory.py]
2017-02-09 Add more camera tests
2017-02-10 More camera & focuser tests, small changes prompted by testing
2017-02-10 Better check for missing port when not using mount simulator
2017-02-10 Simulated camera calls connect() on __init__() like Canon, SBIG cams
2017-02-13 Bisque software (#81)
    * Adding in the items for bisque TheSkyX control
    * Adding in the bisque commands
    * Bisque Software
    * All basic mount and movement commands done
    * Connect but don't unpark for bisque mount
    * Bisque Mount
    * Standard json message return from theskyx
    * Handling park/unpark and connect/initialize better
    * Don't allow setting of a target that is below (HARD-CODED!!) horizon
    * Creating more tests
    * * Removing dome options from mount class
    * Adding `move_direction` command
    * More tests
    * * Observatory doesn't check port for bisque mounts
    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
    [bisque.py]
2017-03-02 * Telemetry Board (former computer box) * Add current sensing * Clean up * Updates to the Camera sketch * Update DHT22 pin based on schematic * Consistent style with telemetry board sketch
2017-03-03 Rename camera_box.ino to camera_board.ino
    Updating name
2017-03-27 Updates to camera board and telemetry board for new electroncs * Better reporting/switching
2017-03-27 * Adding names to electronic board output * Adding multipliers to get amps
2017-03-28 Adding simple script to follow sensor
2017-03-28 Better matching for sensor/key to watch
2017-03-28 Quick fix to format
    [weather_info.csv]
2017-03-28 Handle dict printing
2017-03-28 Don't always show key with format printing
2017-03-29 * Fixing regression with mount that was causing date/time and location to not be set properly (fixes parking for PAN001 on MLO) * Adding gmt_offset as location property until better consolidation is 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
    [pocs.yaml, serial.py]
2017-03-30 PEAS * Message sending handled by the sensor itself instead of shell * Shell will auto-detect on environment board (will tie in with reconnect WIP) * Clean `toggle_computer` command that is separate 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
2017-03-30 * don't use a threaded serial connection for mount
2017-03-30 * Incorrect cal to connector method
2017-03-30 * Pass queue * Multi-threaded connects after spawn
2017-03-30 * Handle a bad case of yaml parsing
2017-03-30 * Adding a simple script that can read sensors
2017-03-31 * Handling parse error with weather
    [weather.py]
2017-04-01 * Adjustment to pole test to use both cameras
2017-04-01 Actually use separate cameras
2017-04-07 Switch RA
2017-04-07 Switch direction
2017-04-08 Serial * Only use the buffered r/w for threaded (sensors). Mount need snot
2017-04-08 Specify the baudrate for the mount
2017-04-08 Park the mount at end
2017-04-08 * Return filename * Power down
2017-04-08 Remove first print statement
2017-04-08 Park mount then process
2017-04-09 * Show print output * Automatically start messaging
2017-04-09 * Dont' actually adjust mount but report values
2017-04-09 Switch RA direction
2017-04-12 * Use a guide rate of 0.5 and set the max time to be the time length of an exposure (should probably be a little shorter actually)
    [mount.py]
2017-04-13 * Make sure button speed is always set when parking
2017-04-13 * Try outputting all sensor info
2017-04-13 Don't print empty entries
2017-04-16 * Use the pointing image as the reference image for tracking offsets * Store `pointing_image` inside the `current_observation`
2017-04-16 * Adding readout time to camera
2017-04-16 Fixing version test in dumb way for now
    [test_observatory.py]
2017-07-17 Allow for non-threaded read of rs232
2017-07-17 Return a timestamp along with value if non-threaded
2017-07-20 Add files via upload
    Infineon Shield current sensing
2017-07-25 Adding a small example notebook to collect accel stats
    [accel-positions.csv]
2017-07-27 Update mount_Current_Sensing.ino
    Current testing with the mount hooked up to the 24v shield and the arduino uno
2017-08-01 Make pretty images for both cameras
2017-08-01 * Script to collect accelerometer readings * Small fix for script that sends mount home * Make timelapse for both cameras * Add `state` to status output
2017-08-03 Misc updates to get tests working
    * Updating camera simulator so threading.Event is properly set and checked
    * Remove lookup of last information from mongo
    * Note: mongo is now only being used to store things (mainly via
    the `insert_current` method) and is not used for looking up items
    needed at run time. Should allow for easier storage agnosticism.
    * Shut down properly even with re-try attempts
2017-08-03 Misc updates * Fix odd moon separation issue * Completely remove `finish_observing` and move exposure increment into `observing` step * Only take pointing exposure with primary camera
2017-11-06 Pre-pre-merge cleanup * Adding a few changes that were on PAN001 before cleanup * Adding some output and docstring * Removing csv file that shouldn't have been committed * Adding test directory
    [weather_info.csv]
2017-11-13 Use current_time() to get the current time, and thus enable simulator of time.
2017-11-26 Install script for panoptes dependencies (#129)
    Great work toward an install script, thanks @jamessynge !
    * wip - Starting on creating some setup scripts. Need to coordinate with
    Wilfred who is doing a similar exercise with the Raspberry Pi.
    * wip - Install cfitsio.
    * wip - Added download, build and install of astrometry.net, but it fails so far because fitsio headers can't be found.
    Also added download of index files.
    * wip - Fix creation of astrometry/data directory.
    * wip - Added functions for each type of dependenciy to be installed
    and command-line flags to disable each of the various types of
    dependencies from beig installed. Still need to remove excess
    crap at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
2017-11-27 Add AbstractDome, base class for Dome controller classes. (#127)
    Looks good, thanks @jamessynge !
    * Add PanFixedDome, base class for Dome controller classes. Converted
    the existing bisque dome to use that as its base class.
    Converted existing bisque/test_dome.py to use slightly altered API.
    Added a simplistic dome simulator and test.
    * Fix return value from Simulator.close (dome_simulator.py).
    Fix formatting errors.
    * Tag functions that shouldn't counted for code coverage.
    Increase coverage of dome simulator test.
    * Add support for loading a dome specified in a config file.
    * Add 'dome' to the list of 'all' simulators.
    * Fix whitespace/comments for codestyle.
    * Rena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
    [bisque.py, config.py, simulator.py, test_camera.py, test_dome_simulator.py]
2017-12-02 Release v0.5.1 updates (#155)
    * Version 0.5.1 release
    * Remove some dependencies that aren't needed
    * Fixing more dependencies
    [test_observatory.py]
2017-12-02 100 char limit (#159)
    * Updating version number for release
    * Change hard-coded version number (also added #154 to deal with in future)
    * 100 char limit applied directly to develop
    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
    [birger.py, bisque.py, camera.py, focuser.py, mount.py]
2017-12-02 Remove support for threaded IO from rs232.SerialData.
    It wasn't in (#148) use anyway, and we may be able to use newer features in PySerial to
    achieve the same result.
2017-12-03 Removing unused arduino sketches
2017-12-03 Fix up PEAS * Fix config, closes #168 * Skip tests for now, need to pull back in hardware options lost in redo of 1.0-beta merge.
    [weather.py]
2017-12-04 Add testing of rs232.SerialData (#164)
    A mock serial device that can be used for testing purposes
    * Testing of serial attached devices, but with fake devices.
    * Allows a handler to be used based on the url of the serial "device".
    * Demonstrating how to hook (or mock) PySerial.
2017-12-18 Add support for Astrohaven dome (#188)
    Includes a simulator for the PLC (programmable logic controller) that
    controls the dome's motors.
2017-12-21 Filter out (hide) an expected warning when running tests. (#229)
2017-12-23 Fix timing of command responses from Astrohaven simulator. (#243)
    Fix timing of command responses from Astrohaven simulator.
    Was emitting response too soon, so driver was skipping past it when
    looking for a response, thus never detected that the desired state had
    in fact been reached.
    Added logging to the Astrohaven simulator to help with future debugging.
    Remove obsolete comment. Add clarifying comments about placement of sleep and drain (discard)
    operations.
    [protocol_astrohaven_simulator.py]
2017-12-23 Add a 'dome' attribute to Observatory. (#231)
    Add a 'dome' attribute to Observatory.
    Add logger kwarg to create_dome_from_config, enabling caller to provide logger to be used.
    Remove obsolete comment from observatory.py. Add TODO about non-bisque mounts, which assumes all are serial.
2017-12-25 Add minimal support for domes into POCS. (#248)
    * Add minimal support for domes into POCS.
    * Close dome when entering the parking state and when powering down.
    * Tests TBS.
2017-12-25 Replace file-relative imports with root-relative imports. (#252)
    [birger.py, bisque.py, camera.py, focuser.py]
2017-12-28 Logging updates (#254)
    * Replace PanLogger with custom `LogRecord` class
    * Allow logger to use either `%` or `{}` (str.format) style for actual
    log messages.
    * Log messages show correct file/lineno
    * Reorder log.yaml
    * Reduced log message format via filter (see example below)
    * Add docstring
    * Fix logger on messaging
    * Remove unused coloredlogs module (will put `grc` info in wiki)
    Closes #253
    ```
    I1228 10:05:01.572 logger.py:112 ****************************** Starting PanLogger ******************************
    I1228 10:05:04.897 observatory.py:35 Initializing observatory
    I1228 10:05:04.897 observatory.py:38 Setting up location
    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
2017-12-29 Add dome opening to state machine, and dome control to pocs_shell (#256)
    Add opening of the dome to the on_enter method of the ready state.
    Add testing with dome to test_pocs.py and test_observatory.py.
    Move some testing of PanBase to test_base.py (a new file) from test_pocs.py.
    Add open_dome and close_dome commands to pocs_shell.
    Add command history to pocs_shell, stored in ~/.pocs_shell_history.
    Experiment with adding help to a command in pocs_shell (setup_pocs, in this case).
2017-12-29 Remove imports of Python's logging module, which was interfering with (#269)
    the PANOPTES logger in peas_shell.
    Add command history to peas_shell.
    [weather.py]
2017-12-31 Auto-detect Arduinos attached to USB serial ports (#280)
    Restore ability to auto-detect Arduinos based on config.
    Fixes #277.
2018-01-01 Updated Power board - Infineon "Trucker" board (#278)
    * Relays are index-based rather than pin-based
    * SerialInput and CharBuffer from @jamessynge
    * Note: This ideally should be moved to external library for use
    across all sketches
    * Values are collected before printing
2018-01-01 Use symlinks to get around Arduino IDE limitations (#282)
    Use symlinks to get around Arduino IDE limitations with accessing files in other directories.
    Add dallas-temperature-control library, used by the telemetry board sketch.
    Remove examples from the Arduino libraries we've copied into POCS.
2018-01-02 Mock TheSkyX (#287)
    * Mock TheSkyX
    * Use [Mocket](https://github.com/mindflayer/python-mocket) to create
    a fake socket connection.
    * A real connection is used once with `--with-hardware theskyx` and
    the responses are recorded into a json file. Subsequent tests then
    use the json file to mock the responses
    * Improve errors for TheSkyX
2018-01-03 Add install of Arduino IDE and verify sketches can build. (#288)
    Also:
    * Update power_board sketch so that it builds with the command line.
    * Add links to DHT library.
2018-01-04 Update camera and telemetry board sketches to those in use on PAN006 (#291)
    * Update camera and telemetry board sketches to those in use on PAN006.
    These have the benefit that they produce their reports faster because
    they first gather the data needed before they start writing. This
    reduces the risk that POCS will timeout while reading a single report.
    * Fix typos. Add a TODO. Remove commands for toggling the LED.
2018-01-04 Use older Arduino build to avoid warnings (#297)
    * Use older Arduino build (1.8.1) that (apparently) doesn't emit noisy DNS related error messages.
    * Use a variable to specify the version of Arduino to be downloaded.
2018-01-05 Move CharBuffer class into its own file so it can be shared by (#300)
    power_board and telemetry_board sketches.
2018-01-05 Move various Arduino utility methods into a shared library. (#301)
2018-01-07 Extract DallasTemperatureHandler out of telemetry_board.ino. (#303)
    Not currently used elsewhere, but I expect it will be used
    in power_board.ino soon.
2018-01-09 Fix IntervalTimer so that it doesn't screw up the remainder; I found (#308)
    Fix IntervalTimer so that it doesn't screw up the remainder; I found this happened when we paused for 30 seconds for a computer power-cycle. It is possible this is also why PAN006's telemetry board is not responding.
    Extract SerialInputHandler out of telemetry_board.ino, adding the ability to specify the pin to be changed by name.
    If power-cycling the computer, continue printing reports, which makes debugging easier.
2018-01-11 Remove timeout param from mount query. Not used and causing errors. (#315)
    Erroneously introduced.
    [mount.py]
2018-01-14 Update DallasTemperature and OneWire libraries. (#338)
    Fetched latest from https://github.com/milesburton/Arduino-Temperature-Control-Library
    The github repo now includes OneWire, so storing both libraries in the
    same directory.
2018-01-14 Fix timeout interval for pointing (#334)
    * Fix timeout interval for pointing
    Also move the log message inside if state. Really the whole for loop
    is redundant, could just get the primary camera directly. However if
    we ever want to take pointing images with both cameras it's nice to
    have this.
    * Slightly better error message
    * Fix long line while here
2018-01-14 Fix open_dome command so that it doesn't require that it be dark, (#333)
    just that the weather be safe.
    Re-write loop in AstrohavenDome._full_move so that it doesn't wait long
    when reading from the dome. The old code was too slow, so the dome moved
    in a little then stopped, then repeated that, but not fast enough for
    closing to occur.
    Fix a flakiness problem: once a limit has been reached (i.e. one shutter
    all the way opened or all the way closed), the PLC will likely output
    more than one of the corresponding limit characters before then
    outputting the new stable character. So added code for reading the
    state until it has reached a stable value.
    [astrohaven.py]
2018-01-15 Fixing EQUINOX header (hopefully for the last time) (#337)
    * `Observation.status` will return string, e.g. `J200`.
    * `Observatory.get_standard_headers` will convert to float, e.g. 2000.
    * Always assume a J2000 and don't allow `None` to be set.
    * Clean up some commments and make some of the line breaks easier to read.
    [test_field.py]
2018-01-15 Add a simple (and incomplete) PySerial handler that emulates the output (#320)
    * Add a simple (and incomplete) PySerial handler that emulates the output
    behavior of our Arduino sketches.
    * Add method SerialData.get_and_parse_reading, which encapsulates
    1) retrying reads when we read a suffix of a line;
    2) correcting known errors in JSON encoding from Arduinos.
    Use this from sensors.py.
    * Replace auto-detect code in ArduinoSerialMonitor with new code that is
    not a part of the class. Tested manually.
    * Modify ArduinoSerialMonitor.capture so that it doesn't do updates of the
    environment collection records, but instead inserts the combined record
    for all Arduinos (i.e. for teleme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
2018-01-15 Wait for tracking adjustment (#332)
    The tracking adjustment for ioptron uses `move_ms_<dir>`, which places
    the mount in `guide` mode (as indicated by the status) but is non-blocking.
    If the tracking adjustment is too long (~ > 4-5 seconds) and no blocking
    is done the machine will try to transition to next state. There is a
    condition on the state machine that the mount must be in `tracking`
    to `observe` so it gets stuck and then tries again. After 5 iterations
    of same state without successful transition the machine will give up
    and park the mount.
    Here we just wait out for up to 30 seconds until back in `tracking`
    mode.
    Note: Ideally we should never have to have an adjustment of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
    [mount.py, simulator.py, test_pocs.py]
2018-01-15 Only the primary camera should have images saved in list (#329)
2018-01-15 Equinox fixes (#346)
    I'm not sure why this is giving me such problems. Sometimes it is coming
    through as a string, sometimes as a `Time` object. Handle it better
    in the status method here although really should trace down when/how/what
    it is getting set to.
    Small fix for `say`
2018-01-15 Remove output of temp sensor device info. (#345)
    Change DallasTemperatureHandler::PrintDeviceInfo to output JSON.
    Remove call to PrintDeviceInfo.
    Add resolution to DeviceInfo.
    Extract DeviceInfo out into a top-level struct, just to make things a
    bit easier to manage.
2018-01-15 Verify Arduino sketches before running pytest. (#353)
2018-01-16 Initial test of Arduino Simulator. (#358)
    Not yet a test of sensors.py, but leading up to it.
2018-01-17 Speed up rate of sending commands. (#352)
    And continue sending commands a bit after first getting the desired
    response, in case that helps with momentum.
2018-01-17 Fix codestyle of test_sensors.py. (#377)
    Fix codestyle of test_sensors.py.
    [test_sensors.py]
2018-01-17 Add more tests of peas/sensors.py. (#360)
    * Add more tests of peas/sensors.py.
    Test auto_detect_port, find_arduino_devices, and
    auto_detect_arduino_devices.
    * Rename auto_detect_port to detect_board_on_port (per feedback).
    Improve/fix docstrings.
    * Correct test name.
    * Workaround import issue with serial_handlers.
    It appears that under Travis the sys.path lookup of package
    peas.tests.serial_handlers fails, while it works on my laptop.
    Not yet sure why, but the error appeared when I removed the import of
    serial_handlers from test_sensors.py, so restoring that.
    [test_sensors.py]
2018-01-17 PEAS shell updates. (#375)
    PEAS shell updates.
    * Prevent start command from being repeated.
    * Prevent load_* commands while timer loop is running.
    * Add command completion for last_reading and toggle_relay.
    * Improve error reporting/robustness of change_delay.
    * Add an age output to last_reading.
    * Improve error handling in last_reading.
    Fixes #371.
2018-01-17 Fix printing of the age of the last reading. (#382)
2018-01-19 Basic horizon constraint features
    This gets the basics of the Horizon constraint into the code base. See #367 for future work.
    Thanks @brendan-o for laying the groundwork!
2018-01-19 Mount serial fixes (#388)
    Mount serial properties set in the config (leading up to #181).
    Fixes #376
    [pocs.yaml, serial.py, test_ioptron.py, test_observatory.py]
2018-01-21 Don't emit message for OK Astrohaven code (#400)
    Fix #244 by documenting the status codes more precisely.
    Suppress debug message if a stable code is recieved before
    an echoed code.
    [astrohaven.py, protocol_astrohaven_simulator.py]
2018-01-21 Adding default baudrate for mount (#403)
2018-01-26 End of night shutdown improvements. (#407)
    * End of night shutdown
    A number of fixes and changes to account for situation when on valid
    observations are found but we don't want to shut down the state machine.
    * If scheduler has a list of `observations` then it `has_valid_observations`.
    which is True when starting.
    Process:
    * `scheduling` state calls `observatory.get_observation()`
    * `get_observation` first checks if `has_valid_observations is False`
    if so it will reread the field list.
    * `get_observation` either returns an observation or, if none found,
    calls `clear_available_observations`, making `has_valid_observations = False`.
    * If no observation is returned to `sched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
    [test_pocs.py]
2018-01-27 Small updates to simple helper script. (#412)
    * Small updates to simple helper script. Currently using this on the Pi
    where I don't have a mongo installation
    * Open write file in a context manager and handle flushing and exceptions better
2018-01-27 Eliminate circular dependencies in pocs package (#418)
    pocs/__init__.py imported pocs.core.POCS, which imported
    PanBase from pocs, which meant that we had a circular
    dependency which just barely loaded (i.e. small changes
    could cause it to fail to load).
    [camera.py, focuser.py, mount.py]
2018-01-29 Add class ArduinoIO (#422)
    pocs/sensors/arduino_io.py is based on peas/sensors.py, but
    ArduinoIO handles only a single device, and writes readings
    to a queue rather than to a database. File also contains
    helpers for finding the arduinos, such as get_arduino_ports.
    Moved protocol_arduinosimulator.py to a new folder,
    pocs/serial_handlers. This will be the home of the other PySerial
    handlers in the future.
2018-01-30 Adjustments for Power (trucker) Board - WIP (#399)
    * Update peas_shell to use board if found
    * Update power board to turn on all relays to start
    * Flush arduino input before sending relay
    * Make power board commands consistent with others
    * Turn on relays as soon as possible
2018-01-30 Add support for FLI cameras (#363)
    Includes a big refactor of camera code to minimise duplication. Nice change that minimizes some code and make things simpler. Thanks @AnthonyHorton
2018-02-04 Disable some tests when hardware is present (#433)
    Disable some tests when hardware is present
    Add option --without-hardware, complementing --with-hardware.
    This allows the user to specify that tests are to be skipped
    if they fail with hardware being present or if the user doesn't
    want the hardware to be interacted with (e.g. when running
    tests on a real unit).
    Move parts of POCS/pocs/tests/conftest.py to POCS/conftest.py
    in order to enable parsing of command line options without
    having to specify pocs/tests on the commad line.
    Mark 4 tests in test_observatory as disabled if hardware is present.
    Ignore POCS/pytest.ini.
    [test_observatory.py]
2018-02-04 Add SensorRecorder for saving/sending readings (#428)
    Adding SensorRecorder for saving/sending readings, primarily
    from Arduinos but could also be from the weather sensor.
    Add FakeLogger class to pocs/tests/conftest.py, enabling
    tests to readily capture log messages.
2018-02-04 Fix non-hermetic focuser test (#436)
    Fixes #251.
    [test_focuser.py]
2018-02-04 Massive commit of decoupling from mongo and addinng a PanFileDB type (#414)
    * PanDB is a factory class that will load either PanMongoDB or PanFileDB
    * PanFileDB merely writes the json to a flat file
    * One file per "collection" along with a `current_<collection` for current
    entries. Note this means each "current" collection is a separate file.
    * Use `bson.json_util` for serializing. Changes a few things with time
    because it _can_ store timezone aware info, which we don't use properly
    in `current_time`.
    * Clear both mongo and file types of their "current" entries upon POCS init
    * Change `include_collection` to `store_permanently` for calls to `insert_current`
    * Change `use_mongo`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
2018-02-05 Small fix for loading config in db (#441)
    * Small fix for loading config in db
    * Another change that didn't make it in
    * Temporary fix for weather plotting (see #442)
    [camera.py]
2018-02-05 Fix flakiness of test_messaging.py (#440)
    Use two Event objects from a multiprocessing.SyncManager
    to coordinate the usage of the messaging forwarder.
    In particular, once the forwarder has created the sockets we
    can create the publisher and subscriber. And when shutting
    down, we should wait until the sockets have been closed else
    we may find that we can't create the ports for the next test.
    Sometimes receive_message() wasn't get the message
    because the subscriber hadn't been properly hooked
    up to the publisher through zeromq. This commit
    combines the pub and sub fixtures into a single
    pub_and_sub fixture that guarantees that the subscriber
    is created first, and that there is a p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
2018-02-06 Bug fixes discovered during Huntsman run (#447)
    * Bug fixes discovered during Huntsman run
    If an Observation consists of multiple exposure times, such as with a
    DitheredObservation, then the `current_exp` is used to set the minimum duration
    so the attribute has to exist before-hand
    [bisque.py]
2018-02-07 Fixing async calls for TheSkyX (#449)
    Being a bad administrator and merging this so we can use it. We ran it last night for Huntsman run without problems. Comments from @jamessynge are good but will be applied in a future PR as per my comment above.
    Note: This still needs some work to make all the calls consistent but
    can be used for testing now.
    [bisque.py]
2018-02-08 In case of readout line error continue to end readout
2018-02-09 Don't clear current db (#455)
    Method added to clear out the current collection of a certain type. Used in testing to make sure we don't have old "safe weather" readings in mongo so we can test unsafe weather.
2018-02-11 Separate socket creation from forwarder creation (#469)
    This allows validation of ports before creating a thread whose failure
    is harder to monitor.
    Add a blocking kwarg to receive_message; this avoids the need for
    callers to import zeromq symbols, which breaks the abstraction.
2018-02-11 Use threads instead of processes in test_pocs.py (#468)
    Run pocs in a thread instead of in a separate process to make it easier
    to share resources between the test thread and pocs. This was motivated
    by PanMemoryDB, but I think it will help in general.
    Add a Timeout class to pocs.utils and use in test_pocs to force the
    ending of long running tests.
    Shutdown pocs even if message not received; use a try-finally block
    to ensure we send the shutdown message.
    Use hardware module to get the list of simulator names, minus 'weather'.
    Wait for pocs thread to stop even if an assertion has failed, to avoid
    having two running at once (i.e. if the next test starts while the
    previous tes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
    [test_pocs.py]
2018-02-11 Add PanMemoryDB, an in memory variant for testing (#463)
    Rename test_panmongo.py to test_database.py
    Add PanDB.permanently_erase_database (not implemented
    for mongo yet).
    Add clearing of the testing database to the db_type fixture.
    Add AbstractPanDB, base class for the concrete DB types,
    with all the method documentation.
    Modify PanDB() into a constructor for the actual DB type.
    Validate the collection name for all inserts, rather than skipping for
    current only inserts.
    [test_pocs.py]
2018-02-13 Add scripts/arduino_recorder.py (#473)
    Records the readings from one Arduino, and supports
    sending a line of text to that arduino.
    Replaces pocs/sensors/sensor_recorder.py.
    Add error.ArduinoDataError for reporting when the data is very bad.
    Add SerialData.port read-only property.
    Add messaging related fixtures to POCS/conftest.py.
    [pocs.yaml]
2018-02-13 Add filter FITS header ealier (in take_exposure) (#480)
2018-02-14 Fix camera simulator (#479)
    Fixing some of the issues with the camera simulator. Thanks @AnthonyHorton!
    Closes #478
    [camera.py, simulator.py]
2018-02-16 Improve logging and speed of startup scripts (#485)
    Create a directory for each tmux_launch execution, used
    by all of the startup scripts it launches.
    Run the scripts for initializing each of the terminals
    in a separate process and don't wait for them to complete.
    This will speed the process of starting up the system.
    Add -ex to all of the bash shebang lines so that the log
    files show what was being executed, and so that bash
    errors are detected.
    Add documentation to README.md about how to
    install the software using a crontab @reboot rule,
    and how to test if @reboot works.
    Clarify the documentation in the various script files.
    Turn off verbose shell logging while printi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
2018-05-26 A script for resetting a USB device (#501)
2018-05-28 Make startup scripts & downloading of files more robust (#507)
    Fix issue #506 by making the downloading code ignore failures to
    download files. Auto-create the astrometry indices directory.
    Fix plot_weather command: it writes into /var/panoptes/plot_weather/, but
    there was nothing that created that directory.
    Fix path to plot_weather.py.
    Running python directly from bash command line in a crontab
    rule is failing, so this commit adds two shell scripts
    for doing so: plot_weather.sh and update_indices.sh.
    Updates the 'Current user:' lines in some scripts to use
    the whoami command rather than $USER. It turns out that Posix
    specifies $LOGNAME (i.e. login name) as the envvar to be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
2018-07-10 Add support for Optec FocusLynx based focus controllers (#512)
    * Control experiments in notebook
    * Completed initial implementation of FocusLynx Focuser
    * Newer version of pycodestyle is breaking things
    * Codestyle
    * Compulsive refactoring, & docstring improvements
    * Fix 2 small breaking bugs
    [birger.py, focuser.py, focuslynx.py, simulator.py, test_focuser.py]
2018-07-13 Autofocus & bisque dome changes from May Huntsman commissioning run (#535)
    * Reverted focus peak fitting from spline to Lorentzian
    * Assorted small fixes
    * Change Lorentzian fitting to polynomial fitting around peak
    * Add colorbar to pretty images
    * Fix focus plots so fit appeats
    * Codestyle fixes
    * Removed Slack code & excessive TheSkyX logging
    * Removed coarse focus on 1st focus code
    [bisque.py, camera.py, focuser.py]
2018-07-17 Allow for a custom path to plate-solver
2018-07-29 Adding a basic script for taking a bias frame.
    * Adding a basic script for taking a bias frame.
    This script takes the usb port (as reported by gphoto2) as the first
    parameter and an optional second parameter for a filename. Default
    filename is timestamped file prefixed with the word `bias-` that is
    saved in current directory.
    Changes camera settings to fastest possible shutter speed (1/4000s on
    the EOS 100D), takes five exposures, then returns the camera to the
    bulb setting.
2018-08-19 Tracking error fixes (#549)
    * Fixing direction depending on where pier is pointed.
    Closes #495
    [mount.py, test_ioptron.py, test_mount.py]
2018-08-26 Fix errors with tracking updates
    * Skip axis correction if no correction information
    [mount.py]
2018-08-27 Fix #558: Print waiting time based on elapsed time (#559)
    Sleep for short amounts of time on each loop, but only
    emit debug log messages or status every 30 and 10 seconds,
    respectively.
    Extend pocs.utils.Timeout with support for Astropy durations
    (e.g. astropy.units.second, .minute or .hour).
2018-09-01 Fix test_run_power_down_interrupt: set POCSTIME (#575)
    Fixes #572.
    [test_pocs.py]
2018-09-14 Fix install-dependencies.sh for Ubuntu 18.04 (#585)
    Various improvements to install-dependencies.sh, and requirement updates.
    - Generates set-panoptes-env.sh into PANDIR rather than modifying .profile
    - Prepends sourcing of set-panoptes-env.sh into .bashrc
    - Update for conda 4.4
    - Update to astrometry 0.76
    - Avoid astroscrappy build problem by requiring Python 3.6
    - Move all of the command line flag parsing to the start of the file
    - Add comments to most functions
    - Apply most fixes suggested by shellcheck, e.g. quoting variable expansions and replacing fgrep with grep -F
    - Insert changes into the appropriate file used by the shell at login
    - Make the install process quieter by l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
2018-09-15 Correct pointing option
    * Changed pointing threshold to 500 arcsec
    * Use header values for HA-MNT lookup
    * Better use of config options for pointing.
    [mount.py, pocs.yaml]
2018-09-15 Add a config file for test_codestyle.py (#594)
    pycodestyle supports reading config options from a file.
    This change adds such a file and modifies test_codestyle.py
    to reference it.
    Removes ignoring of E402 (module level import not at top of file)
    because we don't violate it now.
    Sets the line length to 99, but continues to ignore E501 (line
    too long) because we have a lot of those.
    [.pycodestyle.cfg]
2018-09-15 Parking cleanups (#590)
    * Cleanup to `parked` state to make it easier to understand
    * Ctrl-c while pocs_shell is running will finish loop through state
    machine rather than call park directly on the mount. This allows for
    housekeeping (including uploading) of observations even when machine
    is manually killed.
2018-09-15 Camera updates (#589)
    * Make sure bulb setting is active (can get switched with bias scripts)
    * Basic cleanup of take_pic script
    * Set camera time to now
    * cr2 to jpg:
    * Cleanup and add docs
    * Caption is optional (it's a slow operation, especially on a Pi)
    * No resizing of jpg
2018-09-16 Fix some bugs and lots of warnings reported by pyflakes (#596)
    Fixed some "unknown variable" errors, such as port when
    it should have been self.port, or the corruption of
    nickname by someone pasting the word position into the
    middle of it.
    Converted some string literals to raw string literals so
    that the regular expression is not invalid; e.g 'PAN\d\d\d'
    is invalid because \d is not a valid escape sequence. The
    author likely meant \d to be the regular expression for
    matching digits, which should either be '\\d' or r'\d'.
    Removed unused imports. Marked some imports in __init__.py
    files with "# pragma: no flakes" so that they can be exported
    cleanly.
    Replaced "from x import *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
    [birger.py, bisque.py, focuslynx.py, protocol_astrohaven_simulator.py]
2018-09-16 Use the OO interface so pyplot doesn't hold Figures in memory (#598)
    [focuser.py]
2018-09-21 Only primary camera links pretty image (#614)
    * Only primary camera links pretty image
    * Add `link_latest` option for `make_pretty_image`.
2018-09-21 Pretty image title (#610)
    * Consistency with `title` parameter.
    * No default title if nothing passed (making a title is very slow on a raspberry pi)
2018-09-24 Camera changes, mostly cleanup (#620)
    * FLI changes, mostly cleanup
    * Updating docstring for `uid` to match fli
2018-09-24 Timer Utility Change (#625)
    * `Timeout` changed to `CountdownTimer`
    * New `pocs.wait_for_events` helper method vastly simplifies waiting for images.
2018-09-26 Fixes for focuslynx (#622)
    * Better uid handling
    * Better handling of errors
    * Cleanup
    Taken from #547
    [focuslynx.py]
2018-09-26 Fixing tests (#627)
    * Use unsolved image so we can test solving
    * Pass `skip_solved=False` during `analyze_recent`. Helps with testing when the same image is used repeatedly, shouldn't affect normal usage.
    [simulator.py]
2018-09-27 Remove camera creation from Observatory (#612)
    * Camera dependency injection.
    * Basic `create_cameras_from_config` function.
    * **Behavior Change** Accessing `observatory.primary_camera` will now always return a camera if `observatory.has_cameras`.
2018-09-30 Add the cameras to the POCS tests
    Fix left out of #612.
    [test_pocs.py]
2018-09-30 Set Primary Camera properly (#650)
    * Properly set the primary camera from the config helper function
    * Add "[Primary]" to the __str__
2018-10-01 Camera image pathname cleanup (#642)
    * Assigned sequence time to observation when first observation image is taken (if not already assigned elsewhere)
    * Fix directory assignment for observation
    @AnthonyHorton note for #547
    [camera.py]
2018-10-02 Image Upload Improvements
    * Adds a manifest log so that uploads can be resumed/retried if fail and will also not re-upload if upload has succeeded in the past.
    * Default google items to False so they don't go without explicit addition.
    * **Note** Add explicit test only config items in the conftest file.
    * Added specific tests for the housekeeping state. This is in anticipation of adding specific tests for each state by running through the pocs machine manual (i.e. not using `run`). Could also potentially start the machine in later states for these tests.
    This is pulled from #628 and is a part of #599.
    [pocs.yaml, test_pocs.py]
2018-10-02 Revert "Image Upload Improvements" (#660)
    This reverts commit 61c561d64735f0a6f2e284c6c494b550e879336f.
    [pocs.yaml, test_pocs.py]
2018-10-02 Separate coarse autofocus from fine autofocus (#659)
    * Coarse/fine focus separation, moar tests & bug fix
    * Remove automatic fine focus from coarse focus
    * Enhance tests
    * Fix bug preventing final FIT being kept if no plots
    * Add focus type to initial and final focus image filenames
    * Replace 'plots' with 'make_plots' in autofocus arguments
    [camera.py, focuser.py, test_camera.py]
2018-10-02 Documentation Update (RTD & Sphinx)
    * Can be either reStructuredText (preferred) or markdown
    * doctests!
    * Adding astropy interlinking.
    * Material added:
    * PANOPTES and POCS overview (from my master's thesis)
    * Adding POCS alternatives
2018-10-02 FITS Utils updates
    * Allow compressed fits files to be used by most utils
    * Ability to use fpacked files to check for solving so we don't need topack/unpack just to see if solved.
    * Cleanup of solved conditional.
    * Return the solve info if already solved. Makes output to function identical whether previously solved or not.
    * Fixing defaults for overwrite and skip_solved (was impossible to not select before)
    * Using the fits_utils.getheader wrapper to handle the compressed files
    * Convenience functions:
    * `fits_utils.getheader`
    * `fits_utils.getval
    [solved.fits.fz]
2018-10-02 More readthedocs fixes (#663)
    * Adding astroplan intersphinx
    * Removing upload_docs as it is not currently doing anything
    * Adding config file for readthedocs
    * Removing build_sphinx, should use the following instead:
    ```bash
    cd docs/
    make html
    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
2018-10-04 Minor debug log output changes (#669)
    * Removing debug statement that was used for testing. Currently it defies the whole point of having the `msg_interval` if we just print debug items anyway.
    * Use date formatting to drop the silly precision in weather reporting.
    Merging despite lack of webhook results from travis
2018-10-04 Camera test tweaks from #547 (#670)
    * Camera test tweaks from #547
    * Proper dummy timestamp in observation test
    * Fix observation output file pattern
    [test_camera.py]
2018-10-04 Fix breaking bug in Birger focuser (#671)
    [birger.py]
2018-10-05 TheSkyX Updates (#674)
    * Remove `PanBase` dependency from TSX (related to #672 and #673 )
    * Some additional TSX scripts
    * Fix dome `PanBase` import
    * Reduce buffer size on socket
2018-10-06 If a dome simulator is explicitly added to the `pocs_local.yaml` file (#679)
    it breaks the testing, revealing deeper problems with the load config.
    The issue is that the config is stored globablly, so with the move
    to hardware that is created before the Observatory we now can have
    the config loaded in a global way by hardware.
    This is a temporary fix to an issue reported privately by @jamessynge.
    A deeper examination of the config loading w.r.t. local files is warranted.
    [test_observatory.py]
2018-10-06 Reduce pocs test redundancy (and fix camera simulator) (#681)
    * Make sure tests are always using certain config
    * POCS test cleanup
    * Using simulator file for tests so we are not constantly loading a bunch of targets
    * Lots of shortening of tests so we are not constantly recreating the POCS instance when not needed
    * Trimming camera simulator to 1 second
    * Fix camera simulator image location
    * Explicitly clear the fields file
    * Fixing some of the tests so they don't require specific targets set
    [simulator.py, test_observatory.py, test_pocs.py]
2018-10-06 Increase coverage of arduino related code (#682)
    Add ability to shrink size of read chunks and size of read queue,
    which will cause some chunks to be dropped, exercising the retry
    logic.
    Mark some code to be skipped in coverage calculations.
    Partially addresses issue #653.
2018-10-09 Fix bug in ArduinoIO.handle_commands (#685)
    ArduinoIO.handle_commands was not retrying the read from the cmd_subscriber.
    Added a sleep() method to CountdownTimer to help with waiting for
    some portion of the time left in a countdown timer.
    Add more testing of ArduinoIO.
2018-10-10 Updates to current_time (#684)
    * Increment by one second after reading value.
    * Clear POCSTIME from pocs_shell
    * Changing moon values for this test. Not sure why needed
2018-10-10 Observation current_exp change (#668)
    This is now just a count of the `exposure_list`, which means we don't need to do specific bookkeeping.
2018-10-14 Add DelaySigTerm to pocs/utils. (#690)
    Used to prevent SIGTERM from interrupting a "critical section",
    which in this case is any block of code run as follows:
    with DelaySigTerm():
    code-to-protect-from-sigterm
2018-10-14 Make all created Threads daemons (#691)
    Some threads weren't daemons, and they were preventing pytest
    from exiting when a test failed because the thread still existed.
    [camera.py, protocol_astrohaven_simulator.py, test_pocs.py]
2018-10-14 Improve coverage of ArduinoIO and simulator (#692)
    ArduinoSimulator now adds commands it receives
    to the next output message that it produces.
    Send command bytes to the simulator one at a time,
    again to better simulate the reality that the
    Arduino communication is serial... and to improve
    code coverage.
    Add "# pragma: no cover" to various unreachable
    lines in the Arduino simulator code.
    Test that ArduinoIO listens for messages on the
    command topic and forwards the contained line
    to the Arduino.
    Use the new timeout_ms param of PanMessaging.receive_message
    in ArduinoIO.handle_commands.
    Add some comments, TODOs, and clean up some
    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
2018-10-15 Replace command collect_status with status in pocs_shell (#693)
    New command prints status once, then returns control to the user.
    Fix initialization of cameras to honor simulator specified to
    setup_pocs command.
    Fix a couple of typos.
    [config.py]
2018-10-16 Quick Camera fix (#694)
    * Skip gphoto2 camera if it doesn't respond to request for serialnumber
    [test_camera.py]
2018-10-18 The coarse focus no longer also does a fine focus (#659) (#696)
    [test_camera.py]
2018-10-18 Use DelaySigTerm to cleanly stop ArduinoIO (#699)
    Expose an ArduinoIO.stop_running property, use
    from arduino_recorder.py CLI script to stop when
    SIGTERM is received.
    Added a callback arg to DelaySigTerm, allowing
    arduino_recorder.py to be notified when
    SIGTERM is received.
    FYI, the reason that I didn't use DelaySigTerm
    directly in ArduinoIO.handle_reading is that it
    doesn't work in threads other than main, and that
    makes testing and uses of ArduinoIO other than
    in arduino_recorder.py more difficult.
    Nonetheless, it makes DelaySigTerm less applicable
    than originally intended.
    Fix minor comment error in logger.py.
2018-10-19 Use non-production ports in the config test fixture (#706)
    Copy the ports from the messaging_ports fixture into the config fixture.
    Modify test_pocs.py to use more messaging fixtures: use the
    cmd_publisher and msg_subscriber fixtures instead of creating
    them in the tests. The fixtures are already configured to use the
    test messaging ports.
    [test_pocs.py]
2018-11-01 AC Power Check (#710)
    The AC power reading will work similar to the weather in that will both check for a simulator (`power`) as well as an entry in the database.
    Note that for now this assumes a database structure that does not exist, which is to say that we will need to modify how the sesnsors store their readings for this to work. This code will expect a `power.mains` top-level entry in the `current` collection.
2018-11-09 Improve robustness of log formatter (#708)
    * Improve robustness of log formatter
    Attempt to undo the special casing that the standard
    logging package applies to a dict as the second of
    two args to a logging method (i.e. format_str, dict_value).
    Annoyingly complicated. Makes me wonder if we should
    simply require use of legacy formatting. Oh well, wasted
    the effort to fix it, so let's try it out.
    Add tests of log formatting code.
    * Fix codestyle violation
    * Remove dead code, fix coverage
    * Respond to feedback, primarily adding docstrings.
    [test_logger.py]
2018-11-12 Add a first docker 'helper' script (#724)
    build-panuser-image.py creates an image that can be used for
    running a command (defaults to bash) as PANUSER. This is useful
    if you want to mount PANDIR (/var/panoptes) into the image.
    By default docker images have 'root' as their USER, but that
    means that the user is unlikely to match the owner of PANDIR.
    Also adding scripts/install/create-panoptes-user.sh which does
    what its name says. It can be used both in a docker build
    and in the setup of a computer to run the PANOPTES scope.
2018-11-16 Use a power simulator as a default for now (#728)
    * Use a power simulator as a default for now
2018-12-11 Properly check for mongod server instance before providing client. (#752)
    * Update `get_shared_mongo_client` to properly check if server is actually available.
    Taken from:
    https://api.mongodb.com/python/current/api/pymongo/mongo_client.html#pymongo.mongo_client.MongoClient
2018-12-11 Remove pyplot instances (#760)
    Note: We somewhat expect this to break the focuser code. Specifically looking for memory leaks and/or plots that aren't properly clearing and this overlapping.
    This work is being done in order to facilitate sphinx builds in #761
    [focuser.py]
2018-12-22 Keep CR2 files by default (#765)
    For now we want to keep the CR2 files and have them uploaded to the bucket. This will require some different management and perhaps a different bucket, but this is a good initial step to start saving the images.
2018-12-23 Change the default storage type to PanFileDB. (#755)
    This changes the default storage mechanism from mongo to a flat file in the json format. This will hopefully ease some issue with installation as well as make it easier to use the json files in the panoptes network.
    Note that there will be a version bump after this.
    [pocs.yaml]
2019-01-31 Fix overly long lines (#770)
    Fixes lines of over 100 characters length in pocs/camera/sbig/sbigudrv.py and pocs/focuser/birger.py
    [birger.py]
2019-01-31 Camera refactoring (#771)
    Minor refactoring of Camera class, prompted by work on #769 (and mostly pulled out of that PR)
    - modifications to SBIG & FLI Camera initialisation to allow serial number to be specified in serial_number keyword argument instead of having to use port for something that isn't a port, & to reduce appearance of placeholder UID ('XXXXXX') in the logs.
    - convert the Focuser attribute creation code to a generic subcomponent creation method of Camera
    - move calls to Focuser FITS header method to base class
    - clean up of __str__ methods
2019-01-31 Add support for filter wheels (#769)
    * Beginning framework
    * SBIG driver updates, more framework
    * Add structs and enums, fix line lengths
    * And FW init, handling of FW errors
    * Add basic filter wheel commands and results parsing
    * Add polling to filter wheel moves, filter wheel docstrings
    * Filter wheel base class & SBIG class done apart from name matching
    Add missing edits
    * Add select filter by name, logging, complete SBIG init
    * Position and current filter properties
    * Add filter wheel creation to AbstractCamera, fix circular imports
    * Make Camera get filter wheel FITS headers, make filter_type property
    * Started on simulator, fixed bugs
    * Filter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
    [birger.py, camera.py, focuser.py, focuslynx.py, simulator.py]
2019-02-01 Prevent filter wheel moving during a camera exposure (#776)
    * Add is_exposing property to cameras
    * Add camera.is_exposing check to filter wheel
    * Added tests for camera and filterwheel
    * More thorough test, add docstring
    [camera.py, simulator.py, test_camera.py, test_filterwheel.py]
2019-02-08 Add support for ZWO ASI cameras (#779)
    * Converting C header to Python
    * Renamed, add driver class, implement basic methods
    * Add getting and setting of camera parameters
    * Added all functions needed by POCS to libasi.py
    * Complete ZWO Camera, some refactoring
    * Codestyle!
    * Help, help, I'm being suppressed
    * .
    * Refactor property getters & setters, more suppression
    * Actually refactor the setters this time
    * Do input checking on parameter setter, fix bugs
    * Add set_point, gain, image_type keyword args
    * Set exposure time! Also cooling enable property
    * Fix bug in readout timeout, check image size for readout
    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
    [birger.py, camera.py, focuslynx.py]
2019-02-14 Prevent camera exposures when filterwheel is moving (#782)
    * Implement is_moving for filterwheels, stop camera exposures when True
    * Missing format
    [camera.py, simulator.py, test_camera.py, test_filterwheel.py]
2019-02-15 Simulator Camera creation no longer requires dummy camera config entries (#783)
    * If simulating camera and camera config missing add a dummy one
    * Add test, fix codestyle
    * Fix comment typo
    * Moar coverage
    [test_camera.py]
2019-03-05 Refactor Camera and Driver classes (#787)
    * New AbstractSDKCamera & AbstractSDKDriver, pulling bits out of ZWO, etc
    * ZWO working with SDK base class, more of take_exposure moved to base
    * Simulator working with modified base class
    * Fix exposure collision bug
    * Extend refactoring to FLI, other small tweaks
    * Fix FLI bugs
    * Major surgery on SBIG Camera and Driver
    * Bug fixes and tidying up
    * Follow official clean up procedure for SBIG
    * Comment typo
    * Fix bugs from testing with SBIG camera
    * Typo in comment.
    * Minor changes from review comments.
    * Log when waiting for exposure event
    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
    [camera.py, simulator.py]
2019-03-15 Make simulated filterwheel move time tests more lenient (#797)
2019-03-17 Fix SBIG filterwheel bugs introduced by #787 (#796)
2019-03-30 Changes in ArduinoIO file (#805)
    Removing duplicate code.
    Thanks @kmeagle1515. Funny how this goes unnoticed. And congrats on first time contribution! :fireworks: May not seem like a big one but these kind of small contributions are the thing that help us out a lot. Cheers!
2019-04-16 Fix DSLR creation
    Fixes instantiation of `Camera` objects for `canon_gphoto2` modules.
    [camera.py, simulator.py]
2019-04-28 Update Camera Constructor - WIP (#822)
    * Creating the cameras from config will pass all the config entries to the camera object itself.
    * Removing unnecessary default config entries for certain camera properties.
    * Adjusting camera creation testing **Behavior Change**
    * Exceptions are no longer raised during `create_cameras_from_config` as
    that would prevent additional cameras. Now a warning is issued.
    [config.py, test_camera.py]
2019-05-07 DSLR exposure fix
    Make the params passed from `_start_exposure` to `_readout` consistent with other camera classes.
2019-06-11 Added scheduler as arg to Observatory and error NoScheduler (#838)
    De-couples the creation of the scheduler from the `Observatory` class.
    Closes #836, closes #837, closes #839
    Thanks @ImmortalRabbit, good work!
    [test_observatory.py, test_pocs.py]
2019-06-25 add/remove scheduler test was fixed.
    [test_observatory.py]
2019-06-27 adding/removing mount methods were added.
2019-06-28 Mount changed to AbstractMount.
2019-07-03 MountError not SystemExit
2019-07-03 error.MountError usage fix.
2019-07-04 small fix of test_set_dome.
    [test_observatory.py]
2019-07-04 Used simulator during mount creation
2019-07-05 Adding backup comment and pytest.fixture.
    [test_mount.py]
2019-07-06 * Only check the `driver` for "simulator" as that is the important field. * Rearrange the check for `mount` in `config` and raise an Exception to keep it consistent. * Add a test to increase some cov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
2019-08-09 _create_mount is deleted, a new arg Mount is added, not used unit tests were deleted.
2019-08-20 Revert base constructor call for now as will make PR for all.
    [focuser.py]
2019-08-21 Small mount updates
    Mostly minor updates to add more logging, comments, and consistency with constructor calls. Pulled from #859
2019-08-21 c/filterwheel/filter wheel/
    This makes it consistent with the other mentions in the same docstring.
2019-08-25 Slew to home blocking (#887)
    * Slew to home can optionally block, default False.
    * Change calls to block.
    * Replace blocking call with new builtin
    * Adding a timeout for slewing to home.
    [bisque.py, mount.py, simulator.py]
2019-09-12 Pointing corrections (#884)
    * Correct for both the RA and the Dec pointing offset rather than the magnitude.
    * Correct pointing by default. Allow for more corrections.
    Note: this has been in use on PAN001, PAN008, PAN012, and PAN018 for over a month, merging without review.
    [pocs.yaml]
2019-09-12 Updates to POCS base and core (#883)
    * Better check for `mains` entry (closes #697).
    * Better checks for items in database.
    * pytest consistency updates.
    * Cleaner config check.
    * Don't raise error if no power reading, just warning and allow the power check to fail.
    Note: this has been running on live units for a few weeks. Mostly minor changes. Merging without review.
    [test_base.py]
2019-09-13 Tracking correction threshold (#878)
    The tracking corrections can be a minimum or maximum number of milliseconds.
    For the minimum the tracking will be ignored, for the maximum the correction
    will be set to the maximum.
    Tracking correction thresholds are set in the config file.
    Note: This has been running live on a number of units. Merging without review.
    [mount.py, pocs.yaml, test_ioptron.py]
2019-09-25 Remove separate PEAS config (#896)
    Consolidate the config files into one. These were originally separate when PEAS was its own repository but the split is no longer needed.
    Note: Merging without review.
    [pocs.yaml, weather.py]
2019-09-26 Read single sensor (#880)
    * Allow for specifying the individual sensor name so that we can read one sensor at a time rather than all arduino sensors. If `sensor_name` is specified then `auto_detect` is set to `False`.
    * Allow for db type to be passed in kwargs in addition to config.
    * Default to `file` db type.
    * Default log level for sensors is set to INFO.
    * Messaging port is pulled from config instead of hard-coded.
    * Adding `with_sensors` test config option for use with `--with-hardware=sensors`.
    * Sensors fail if no serial reader is successfully connected.
    **Note: This is being merged without proper review but is being used on currently active units.**
    [test_filterwheel.py]
2019-09-26 PEAS remote sensors (#879)
    A file that can read a json endpoint for sensor data.
    **Note:** this is being merged without official review but is being used live on a few units.
2019-10-05 Fix scaling of ZWO camera pixel values (#902)
    * Fixes scaling of RAW16 data by zero padding the right way.
    * Add regression test
    * Add BITDEPTH FITS header entry
    * Confirm bit depth matches
    [camera.py, test_camera.py]
2019-10-08 Fix bit depth FITS header bug (#903)
    [camera.py]
2019-10-09 Use real serial numbers for ZWO ASI cameras (#904)
    * Update & complete libasi to match latest SDK API
    * Update get_cameras to get serial numbers instead of string IDs
    * Missing camera_ID
    * ZWO camera docstring.
    * Codestyle and typos
    * Don't include bits of #827
    * Fixes from testing.
    * Missing a
    * Another typo
    * Small corrections/tweaks based on review comments
    [camera.py, test_camera.py]
2019-10-14 Add is_ready and related properties, rename camera properties (#827)
    * Refactor subcomponent creation
    * Rename camera cooling properties
    * Add is_cooled_camera property, made cooling FITS keywords conditional
    * Update SBIG filterwheel in accordance with camera refactor (#787)
    * Is it ready yet? No.
    * Make simulated filterwheel move time tests more lenient
    * Fix temperature stability test
    * Attempted fix of subcomponent access.
    * Generalise string representation
    * Fixing bugs
    * Tidied subcomponent creation, fixing tests.
    * Fix tests
    * Improve is_temperature_stable docstring
    * One less hard coded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
    [birger.py, camera.py, focuser.py]
2019-10-14 Fix parsing of ASI camera serial number (#906)
2019-10-19 Make SDK camera simulator accessible (#909)
    * Make SDK camera simulator accessible
    * Avoid unnecessary imports of SDK camera simulator
    * typo
    * Fix camera tests
    [test_camera.py]
2019-10-19 Mount updates - slew_to_target timeout (#894)
    * `slew_to_target` has an optional `blocking` parameter to match #887.
    * Mount simulator
    * Update simulate `slew_to_target` to actually use the `AbstractMount` code.
    Note: this has been in use on live hardware so merging now.
2019-10-21 Fix target temperature in simulator (#912)
    * Set target_tempearture even if camera is not cooled.
    [test_camera.py]
2019-10-21 Don't do a system exit if no cameras found. (#913)
    I'm confused at the codecov change but it doesn't seem to be skipping any of the internals. Merging.
2019-10-21 Creation helper scripts don't require config to be passed.
    * Don't require a `config` for the mount and scheduler creation but load default.
2019-10-23 Mount Park Behavior Change (#889)
    * Mount Park Behavior Change
    **Breaking Changes**
    This changes the mount behavior so that it no longer uses the built-in iOptron
    commands for parking but instead mimics manually pressing the buttons in both
    the RA and the Dec axis.
    Previously the mount was commanded to park via the built-in command, but that
    was incapable of getting the Dec axis oriented correctly, so after issuing
    the park command, the mount was unparked and then had the Dec axis moved via
    mimic the hand-controller press. This PR alters it so that both axis work similarly.
    This also allows for each site to have custom parking spots by altering the number
    of seconds moved i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
    [mount.py]
2019-10-24 Finite readout time for simulated cameras (#920)
    * Finite readout time for simulated cameras
    * Update ridiculous test
2019-10-24 Fix SDK Camera simulator initialisation (#921)
    * Move ccd simulator initialisation to connect()
    * Set ._connected, don't call .connect()
2019-12-02 State Machine - State Tags (#930)
    * Use the `always_safe` tag during the `check_safety` transition rather than using the transition name.
    * Support the `horizon='flat'` attribute for the `at_twilight` tag, e.g. for a `calibrating` state.
    Tests could be written to up the coverage, especially if `check_safety` were called outside the state machine mechanism (i.e. if `event_data=None`).
2019-12-16 ensure exptime Quantity doesn't impact the Huntsamn-pocs pyro client serialiser (#935)
    * moved pop to just before take_exposure
    [camera.py]
2020-01-20 Requirements updates (#937)
    * Modules are now listed in `setup.py` and `requirements.txt` is generated via `pip-compile`.
    * Added support for different feature installs so we can limit modules not used in certain places, e.g.
    * `pip install -e .[dev,google,social]`
    * `pip install -e .[mongo]`
    * Astropy updated to `4.0.0` and astroplan to `0.6` to help solve pestering IERS issues.
    * Removed unused requirements.
    Note: I'm merging with admin privileges.
    [test_pocs.py]
2020-02-06 Add support for filterwheels from ZWO (#940)
    * Start on EFW driver class
    * Initial implementation of all the EFW SDK function wrappers
    * Add get_product_ids, final EFW API function
    * Starting Filterwheel class
    * Fix some typos, more consistent nomenclature
    * Typos & formatting suggestions from code review
    * Don't override built-ins. Ever.
    * Make load_library mode argument even more optional
    * Fix documentation of product ids, improve fake UIDs
    * Make move_event member, add polling to ZWO filterwheel
    * Modify filterwheel simulator to use the new .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
2020-02-10 Add filter selection to observations (#942)
    * modify observation and camera
    * move filterwheel in take_observation
    * minor
    * important removal of whitespace
    * important removal of whitespace
    * Update pocs/camera/camera.py
    & > and
    * tests
    * tests
    * tests
    * tab
    * exception handling
    * moved check for moving filterwheel
    * fixed indent
    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
    [camera.py, test_camera.py]
2020-02-13 Remove all notebooks (#946)
    Moving notebooks to panoptes-tutorials.
    [accel-positions.csv]
2020-03-05 Increase default temperature_tolerance for ZWO cameras (#959)
    * override default value
2020-04-22 Fix skyx timeout (#965)
    * add UTC timezone
    * correct timeout
    * increase timeout
    * revert time changes
    * remove catch
    [bisque.py, mount.py]
2020-06-01 Docker into develop 02 (#951)
    * Dockerize
    This will merge all the docker components into a new branch in the main repo. As part of milestone 0.7 these items will be cleaned up as a step towards making the docker version the default (i.e. `develop`) version for milestone 0.8.
    This is being merged now because there are too many changes within one PR and it will be better to have new PRs that branch off this `docker` branch. This will also allow for installs on new units from the `panoptes` user rather than my personal branches.
    * Docker branch upstream merge - WIP (#911)
    Keeping `docker` in line with `develop`.
    * Update env_file
    Adding local user id
    * Fixing power entry (#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
    [.pycodestyle.cfg, solved.fits.fz]
2020-06-15 More cleanup to make dev env work. (#974)
    * More cleanup to make dev env work.
    * Minor cleanups.
    * * Bumping panoptes-utils version.
    * * Updates to tests and sitecustomize for coverage to match panoptes-utils.
    * * Python to 3.8
    * Markdown readme for github repo.
    * Install script writes to bash and zsh if rc files are present.
    * * Test fixes.
    * * Remove the dynamic_config_server fixture.
    * * Fix build and test to run properly.
    * * Use standard port and host for config server (but still a different path).
    * * Removing `config_port` items.
    * * Removing `config_port` items.
    * * Fix test assertion.
    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
    [camera.py, mount.py]
2020-06-18 Logger and other minor improvements for developers (#977)
    * Mount simulator better name and stringify.
    * Global db.
    * Logger
    * Add a `console_log_level` and `stderr_log_level`. The former is written to the log file in $PANLOG and is meant to be `tail`ed in the console. The `stderr_log_level` is what would be displayed, e.g. in a jupyter notebook.
    * The `panoptes` logger is enabled inside `get_logger`.
2020-07-06 New docker base image (#978)
    * * Fix curl install script step.
    * Docker
    * Use buildx for an arm build.
    * Increase timeout for build.
    * Copy git folder into build context for now for version.
    * `latest` image is installed from a directory.
    * Remove `pendulum` to make `arm` build easier.
    * * Building arm images.
    * Remove `readline` as it is difficult to install on `arm` and will be remove soon (only used in the shells).
    * * Use the `latest` image for running tests.
    * * Use the python3
    * * Ignore import errors.
    * * Small change (also want to kick tests again).
    * Docker changes
    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
2020-07-06 New utils and db path (#979)
    * Bumping to `panoptes-utils 0.2.21`
    * * Allowing custom folder for metadata. Closes #957
    * * Changelog.
    * * Install script
    * Bumping docker-compose version to `1.26.2`
    * Adding script version.
    * * Install script
    * Fix README instruction.
    * Changelog.
    [pocs.yaml]
2020-07-07 Minor Updates to logging and dome (#983)
    * Minor Dome Updates
    * Removing source of random testing coverage.
    * Fixing logging calls.
    [astrohaven.py, birger.py, protocol_astrohaven_simulator.py]
2020-07-08 Update install-pocs.sh (#980)
    Merging before pushing newer PR.
    * Update install-pocs.sh
    Fixing how the environment variables are written to the file. They should only be written if the file does not already exist.
    Cleanup of the menu prompts and other code.
    * Update install-pocs.sh
    A better `select` prompt via `PS3`
    * Update scripts/install/install-pocs.sh
    Fixing case select option.
    * Update scripts/install/install-pocs.sh
    Break from select.
    * Update scripts/install/install-pocs.sh
    Break from selec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
2020-07-09 Update install script (again) (#984)
    Break from select.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
    [astrohaven.py]
2020-08-21 Revert "Merge branch 'release-v0.7.5'"
    This reverts commit f927fc00a2b953b55290baf59af64c5769bf0516, reversing
    changes made to ee2b35fbfa066271c2c2f093439588ffeb497c68.
    [abstract_serial_dome.py, bisque.py, simulator.py, test_state_machine.py, weather.py]
2020-08-26 Temperature checking (#990)
    * start
    * rename
    * camera cooling
    * fix
    * _cooling_enabled
    * _cooling_enabled
    * fix
    * seconds
    * units
    * sim cam
    * fix test
    * logging
    * logging
    * units
    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
    [camera.py, test_camera.py]
2020-09-02 Add support for filterwheel dark exposures (#989)
    * Resurrect branch with new src file locations.
    * Linting
    * Typo
    * Update filterwheel.py
    Fix params for abstract `_move_to` in filterwheels. At some point the move event was converted to a class attribute so it's not needed here and not called anywhere.
    * Typo in docstring
    * Implement all the relatively simple suggested changes from review
    * Minor tweaks based on self review
    * D'oh
    * Add missing blocking argument, add filterwheel tests
    * Add a filterwheel with opaque filter to camera tests
    * Test that filterwheel moves as a result of dark/light exposu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
    [camera.py, test_camera.py, test_filterwheel.py]
2020-09-13 Allow config-server to be run on different host and port (#1001)
    * Allow any `PanBase` object to access the config server on a different host. This introduces the `POCS_CONFIG_HOST` and `POCS_CONFIG_PORT` variables.
    * * Conftest specifies config host and port.
    * * Conftest specifies config host and port.
    * * Updating the config options to match panoptes/panoptes-utils#241
    * * Updates for testing.
    * * Updates for testing.
    * * Updates for testing.
    * * Updates for testing.
    * * Fix typos.
    * * Remove test env.
    * * Fixing up env vars.
    * * Fixing up env vars.
    * * Don't build utils.
    * * Use TAG for utils image.
    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
    [test_camera.py, test_focuser.py, test_mount.py, test_observatory.py, test_pocs.py]
2020-09-14 Pass camera bit depth to mask_saturated (#1006)
    Tests are hanging because this is hitting `panoptes-utils v0.2.27` and not the dev. Will resolve itself within a day and shouldn't affect other users besides Huntsman.
    [focuser.py]
2020-10-06 Bump panoptes-utils to `0.2.28` (#1007)
    * Enable take_exposure & autofocus errors to be detected
    * Don't wait to stable temperature of cameras with no cooling!
    * Not finally.
    * Changes to speed up simulated camera cooling
    * Skip processing of image files that don't exist
    * Removed no longer used focus_time parameter
    * Relax unnecessarily tight default exposure timeout for ZWO cameras
    * * Bump panoptes-utils to `0.2.28`
    * * Explicitly set the `focuser` and `filterwheel` attributes to `None` as the `_create_subcomponents` doesn't seem to be working.
    * * Explicit check for subcomponets in tests.
    * * Use the AbstractGPhoto camera as a bas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
    [camera.py, focuser.py]
2020-10-12 Updates to take_observation (#1009)
    Thanks @danjampro for suggestions!
    * * Check for POINTING keyword in the metadata, not in the FITS header.
    * "Better" assigning of metadata to fits keywords.
    * More explicit variable names for FITS metadata.
    * * `take_observation` has a `blocking` param.
    * Fixing some of the dslr simulator tests.
    * * Changelog updates.
    * Using `get_quantity_value` for `exptime` lookup.
    * * Adding camera defaults section and passing that to cameras.
    * Fix the default keyword params for booleans.
    * * Typo fix in config.
    * * Comment out the focuser and cooliing
    * * Update changelog to reflection changes to config options.
    [camera.py, pocs.yaml, test_camera.py, testing.yaml]
2020-10-23 Python 3.7 requirement (#1021)
    * Python version at 3.7
    * changelog
    * Fix changelog.
    * Change all the f-strings. Ouch.
    * Test script returns output from docker tests.
    * Some missed 3.8 f-strings.
    * Revert `unlink` for `python 3.7`
    * Removing unsed test items.
    [astrohaven.py, birger.py, camera.py]
2020-10-26 Fix SDK camera problems resulting from changes to is_exposing/_is_exposing_event (#1026)
    * Quick fix to get SDK cameras working again
    * Revert mistaken change
    [camera.py]
2020-11-09 Install POCS updates (#1030)
    **Testing and using in the lab during build so merging this without approval.**
    * Raspberry Pi Cloud init files
    * Files for auto-installing POCS onto a raspberry pi.
    * * Adding more commands before removing.
    * * Don't use chrony
    * Rely on `install-pocs.sh` for most of the heavy lifting.
    * Install zsh and friends in the host.
    * docker and friends come from apt.
    * * Remove `meta-data` file.
    * Clean up comments.
    * * Disable the LEDs on raspberry pi
    * Add warnings about wifi
    * * Small edit.
    * * Typo
    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
2020-11-10 Autofocus plots refactor (#1029)
    Thanks @danjampro and @AnthonyHorton !
    * Autofocus plots refactor:
    * Move the autofocus plotting to a separate file.
    * Super dooper explicitly close the figure (closes #1028).
    * Logging call cleanups.
    * * Add default config entry for making autofocus plots (closes #925)
    * * Make sure thumbnail is not bigger than image. Closes #846
    * * Fix conditional.
    * File naming consistency.
    * * Consolidating exceptions
    * Adding an autofocus tests that doesn't use darks.
    * Revert "* Consolidating exceptions"
    This reverts commit fd468bdceae42a29dc3b6a09bae011dd96910e06.
    * * Adding dark test back after reverting the custom exceptions.
    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
    [camera.py, focuser.py, pocs.yaml, test_camera.py]
2020-11-11 Return `readout_thread` from `take_exposure` (#1032)
    * return thread
    * docstr
2020-11-11 Autofocus import fix (#1034)
    * * Fix import. Need tests for this somehow. :(
    Thanks @danjampro
    [focuser.py]
2020-11-13 Install gsuitl with google tools (#1037)
    * Replace the `google-cloud-sdk` library with `gsutil` directly so it will install on arm systems.
2020-11-14 Arduino board cleanups (#1035)
    This PR removes all old arduino sketches and supporting libraries. It is a cleanup PR in that it removes items but does not add any.
    Some functionality is lost in terms of the PEAS shell, which will be added back in a subsequent PR.
2020-12-11 Added astromechanics controller script and unit test (#1041)
    * Added astromechanics script and test
    * Removed hard coded string
    * Addressed some of Lee's comments. 3 left.
    * Triggered _is_moving within the focuser initialisation
    * Use of native command MXX# to remove unnecessary logging
    * Removed unused initial_position and dev_node_patern
    * Fixed typo in format
    * Fixed functions' docstrings
    * Replaced all format calls for f-strings.
    * Return of int in position method
    * Added explanation of why min/max methods return None
    * Removed unnecessary test file. Edited _send_command. Fixed small bugs.
    * Replaced \n by \r
    * Removed duplicated code from astromech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
    [astromechanics.py, birger.py, serial.py, test_focuser.py]
2020-12-14 Update Bisque mount status (#1044)
    Thanks @danjampro !
    * update mount status
    * logic error
    [bisque.py, mount.py]
2020-12-16 exptime fix (#1046)
    * exptime fix
    * focuser changes
    * get tests passing
    * remove focuser changes
    [camera.py, test_camera.py]
2020-12-16 State machine safety checks (#1043)
    * modify state machine
    * check safety
    * add tests
    * add tests
    * revert changes
    * revert changes
    * update tests
    * update tests
    * update machine
    * update machine
    * improve test
    * wilfred's comments
    * wilfred's comments
    * add warning
    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
    [test_pocs.py]
2020-12-18 Fix Bisque mount status call (#1049)
    [bisque.py]
2020-12-18 Change thumbnail_size to cutout_size consistently. (#1040)
    Merging without approval as it is sitting here stale.
    * * Change all usages of `thumbnail_size` to `cutout_size`.
    * * Small testing coverage fix.
    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
    [camera.py, focuser.py, test_camera.py]
2021-01-11 fix (#1062)
    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
    [focuser.py]
2021-01-12 camera focus arg (#1064)
2021-01-12 fix (#1063)
    Thanks @JAAlvarado-Montes !
    [mount.py]
2021-01-14 Add command lock to bisque mount (#1065)
    * add lock to query
    * comment
    * update docstring
2021-01-22 More Docker cleanup (#1068)
    PANUSER owns conda.
    Dockerfile cleanup for better builds.
    Docker image does not contain focuser extras by default. #1068
    Move all tests into tests subdir from project root.
    Cleanup of testing setup, especially for GHA.
    Fix testing log level.
    [test_base.py, test_camera.py, test_codestyle.py, test_constraints.py, test_dome_astrohaven.py]
2021-01-31 Docker and Cloudbuild fixes (#1074)
    Following changes in `panoptes-utils`, this cleans up and simplifies the Docker services.
    ## Description
    * **Breaking change** Python 3.8
    * **Breaking change** Default service install does not include ``focuser`` dependencies.
    * **Breaking change** Default Docker command is a ``ipython`` console with the simulators loaded.
    * **Breaking change** Docker image only contains limited set of files.
    * **Breaking change** Directories inside the service image have been simplified for easier mapping onto desired targets on the host. The main top-level directory (i.e. ``$PANDIR``) is now ``/POCS`` with other folders nested underneath.
    * **Breaking change**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
    [camera.py, pocs.yaml]
2021-02-01 Properly show GHA test failures. (#1075)
    * * Change the GHA test suite so that it returns failure exit properly.
    * Submit with failing test for now.
    * * Don't fail tests.
    Thanks @danjampro for finding!
    [test_base.py]
2021-02-05 Add optional focus position offsets per filter (#1076)
    * first commit
    * has_filterwheel
    * exception
    * fix tests?
    * fix tests?
    * fix tests?
    * fix tests.
    * improve coverage
    * fix tests again?
    * fix tests again?
    * Update src/panoptes/pocs/filterwheel/filterwheel.py
    [camera.py, test_camera.py, testing.yaml]
2021-02-08 Changes to observation (#1069)
    * initial
    * dark
    * dark
    * add new observations
    * fix import errors
    * fix observation tests
    * change to base
    * change to base
    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
    [camera.py, test_camera.py, test_constraints.py, test_observation.py]
2021-02-26 Fix FW moving error (#1084)
    Thanks @danjampro for fixing.
    [test_camera.py]
2021-03-05 Skip solve timeout test (#1089)
    * Skip the `test_solve_timeout` for now because the latest `panoptes-utils` has a hard-coded 5 second buffer on the solving process, so Timeout is not getting triggered.
    * Sneak in some fixes to the numpy dtype deprecation warnings.
    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
    [focuser.py]
2021-03-06 Add iOptron CEM40 mount driver (#1085)
    Merge the CEM40 class. The two ioptron classes could be consolidated and cleaned up still.
2021-03-10 Power board updates (#1038)
    * Power Board integration.
2021-03-10 Update Dockerfile
    Typo fix for rpi arduino-cli download.
2021-03-11 * Put `arduino-cli` in a better spot and fix the path. (#1093)
    * Remove `streamz` (for now) and add `pandas`.
2021-03-15 Small cleanup to base mount class (#1091)
    Merging this for passing tests. The Huntsman team is doing some live hardware testing.
2021-03-18 Power Board updates (#1096)
    Merging despite concerning coverage hit in unrelated modules.
    * * Better access for relays by name.
    * * Use JSON for arduino input.
    * Input is in the form of valid json.
    * Input is in the form of valid json.
    * Don't (re)install panoptes-utils.
    * Don't remove git.
    * Consistency with default mount.
    * Change app dir from `/POCS` to `/panoptes-pocs`
    * Change app dir from `/POCS` to `/panoptes-pocs`
    * Docker file and compose updates for regular and testing.
    * Don't install deps in docker file should come from image.
    * * Add astroplan to env file.
    * Only one environment file.
    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
2021-03-30 Update panoptes utils 2.33 (#1099)
    * * Bump panoptes-utils version.
    * Fix serial handlers for new version.
    * Don't install panoptes-utils from github in Dockerfile.
    * * Small clean up to arduino simulator.
    * * More dependencies!
    [protocol_astrohaven_simulator.py]
2021-04-08 Power Board to use SerialDevice and install updates (#1100)
    * * Small cleanups.
    * * Start adding streamz
    * * Use the new `SerialDevice`.
    * Fix the average reading for channel 4.
    * * Don't need to custom add newline.
    * * Comment out old multiplier line.
    * * Don't error if no readings.
    * * Install script adds the install user to `sudo` group.
    *
    * * stderr log level set to `SUCCESS` by default. Should maybe just make this the case inside jupyter notebook, but the `INFO` are currently annoying.
    * Power board sketch
    * Set default states on top of sketch in case people want to override.
    * Report an `uptime` in seconds elapsed since power board was turned on. Uses `milli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
    [PowerBoard.ino, pocs.yaml, power.py]
2021-04-12 Log warning rather than raise an error if control value outside range in ZWO camera (#1077)
    * warn not raise
    * add return statements
2021-04-19 Add new ioptron cem40 mounts (#1102)
    * * Rename command files to match command language version number, which applies to various mounts.
    * * Updated command instructions for versions 1.4, 2.5, and 3.10.
    * 1.4 is old and shouldn't really be used.
    * * Support a `commands_file` in the `mount` config options for directly specifying commands file.
    * Added a TODO
    * Updates to CEM40 with hardware to verify commands are working. Replacing some of the dict lookups with proper enums. Still need to add some commands.
    * Lots of f-string replacements in the mount files. Sorry.
    * POCS is installed in user-editable mode so you can change files within jupyter.
    * * Cleanup to cem40 park.
    *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
    [mount.py, pocs.yaml, serial.py, simulator.py]
2021-04-20 Update Dockerfile
    Fix multi-stage build names.
2021-05-28 Fix hardcoded scheduler (#1107)
    * * Remove hard-coded scheduler name.
    * * Moving scheduler test files to subfolder.
    * * Add test for full scheduler namespace.
    * * Small cleanup to assumed base directory.
    * Misc. cleanup.
    * * Docker compose don't rely on $PANDIR.
    * ** Unrelated to PR **
    The `test_sdk_camera_not_found` is creating a camera class and then raising an exception with an invalid config, however the camera object is still in memory and not getting cleaned up by the garbage collector. This is causing a race condition on the `test_sdk_already_in_use` test, causing it to hang indefinitely in an odd way. Simply moving the offending test below seems to fix the problem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
    [pocs.yaml, test_camera.py, testing.yaml]
2021-05-31 Add optional filter_name arg to focuser.autofocus (#1109)
    * move FWs before focus
    * check for camera
    * check for camera
2021-06-09 Bump Pillow requirement for Dependabot
    Bumping to `Pillow>=8.2.0`. This actually comes from `panoptes-utils` and I think would propagate upwards but I am specifying here just in case.
2021-06-19 * Adding some base camera properties. (#1118)
    * Canon camera class properly overrides abc methods.
    * Change old code to use python naming conventions.
    * f-string replacement.
    [camera.py]
2021-06-19 CEM40 and mount updates (#1119)
    * CEM40 and mount updates
    * CEM40 proper initialization for v250 command set.
    * Custom park command for rotating Dec axis.
    * Added `search_for_home` method that uses the CEM40 command directly.
    * CEM40 sets meridian treatment and altitude limit upon init.
    * The `_setup_commands` sets the commands rather than returns them.
    * Mount simulator uses proper timestamp.
    * Mount read log is less noisy.
    * * Moving some of the mount settings in the config file.
    * Adding parking direction and number of seconds to move to config file.
    * Base mount and serial mount class are proper abstract methods.
    * f-strings and double quotes.
    * * Docstrings and f-strin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
2021-06-19 Power board and generic sensor updates (#1120)
    * * Move the sensors from `panoptes.pocs.sensors` to `panoptes.pocs.sensor` to be more consistent with other hardware.
    * * Move the sensors from `panoptes.pocs.sensors` to `panoptes.pocs.sensor` to be more consistent with other hardware.
    * PowerBoard (power) sensor
    * Add convenience methods for Relay.
    * PowerBoard readings are put into a `streamz` dataframe.
    * PowerBoard looks for matching name in response from arduino to assist in setup.
    * Relays that are turned off will return a `-1` value rather than `0`.
    * Fix sensor tests.
    * Remove `gpiozero` from dependencies.
    * * Remove old parameters.
    * * Add power to config.
    [pocs.yaml, power.py, test_sensors.py]
2021-06-22 Config CLI (#1122)
    * Adding a `pocs config` command that will allow for interacting with the running config server, namely getting and setting config values.
    * Renaming some internal variables.
    * Adding the `pocs` cli main script.
    * Fix tests.
    * Revert unintended change.
    * Better help string.
    [config.py, main.py]
2021-06-23 Astromech find serial port (#1125)
    Adjust astromechanics so they can search for device path by product and vendor id.
    * Add basic test for searching for Astromechs. Mostly just fails immediately.
    * Clean up some of the focuser tests.
    * Adds a `pre_cmd` and `post_cmd` to `_send_command`. Should be updated in base class too.
    [astromechanics.py, test_focuser.py]
2021-06-24 Power Board - AC_OK and BAT_LOW (#1127)
    * Power Board - AC_OK and BAT_LOW
    * Read pins `11` and `12` and send along with other output.
    * Move the configurable items to the top of file.
2021-06-24 Power service and cli (#1121)
    Adding a fastapi web service and cli for controlling the power board.
    * API exposes methods for getting current status, controlling relays, recording values to db, etc. This should act as the primary control for the PowerBoard.
    * Fastapi service added to docker-compose file.
2021-06-24 PowerBoard AC updates (#1129)
    * AC_OK is on pin 11.
    * BAT_LOW is on pin 12.
    * AC_OK and BAT_LOW are set as `INPUT_PULLUP` so should be wired from Arduino to Meanwell to Ground.
    * `battery_low` removed from json output for now as it hasn't been tested and isn't clearly working.
2021-06-24 Focuser port and baudrate cleanup (#1128)
    * base `connect()` method accepts optional `port` and `baudrate` params. If `port` is not specified it uses `self.port`, which should be assigned upon init by the concrete classes.
    * Birger `dev_node_pattern` changed to `port` for consistency, but it can handle a pattern instead of just a specific port.
    * Astromechs attempt to look up the port via a `vendor_id` and `product_id` and if error or none provided revert to the `port` param.
    * Set baudrate defaults for Birger and Astromech
    * Add default vendor and product id for astromech.
    * Only use `find_serial_port` if given vendor and product id.
    * `position` will return an empty string and give a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
    [astromechanics.py, birger.py, serial.py, test_focuser.py]
2021-06-26 Set DSLR camera time correctly (#892)
    * These were incorrectly trying to be set via the index instead of the value.
    * Only set UTC date, not local date.
    * Use `current_time`, which already handles the timezone correctly.
    Closes #891.
2021-06-27 Warn on missing state transition (#1131)
    * Warn on missing state transition
    * Better unit test.
    [test_state_machine.py]
2021-06-29 Fix calibration of astromechanics focuser (#1134)
    [astromechanics.py]
2021-07-12 Update serial focuser and subclasses (#1135)
    * update serial and birger
    * update focuser code
    * update focuser code
    * update focuser code
    * update focuser code
    * catch retry errors
    * minpos=0
    * finalise
    [astromechanics.py, birger.py, serial.py]
2021-07-31 fix unit typo (#1139)
    [camera.py]
2021-08-04 Camera -> self (#1140)
    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
2021-08-04 Fix hanging tests. (#1141)
    * Fix hanging tests.
    * Change the `observatory` fixture to a function scope.
    * * Add a `CountdownTimer` to wait for temperature to stabilize in test cameras. Use 60 seconds (should never wait that long) or fail.
    * More logging output on camera creation for tests.
    * Small fix to camera `readiness` to ensure that check for `not_exposing` doesn't fail.
    * * Attempts to clean up lingering SDK cameras that arent' getting garbage collected during testing.
    [camera.py, test_camera.py, test_observatory.py]
2021-08-06 Remote Camera Service
    * Add a service so that camera operations can be called remotely via an api.
    Replaces #1137
    [camera.py]
2021-08-06 * Better handling of the returncodes and error messages.
    [camera.py]
2021-08-09 * Endpoint is at root (i.e. `/`). * Fix the splitting of the arguments.
    [camera.py]
2021-08-10 * Move most of the gphoto2 canon items into the gphoto2 base. * Remove `parse_config` and put inside `load_properties`. Remove the `properties` property so it just returns a dict. * Better parsing of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
    [camera.py]
2021-08-10 * Bug fix for testing output. * Set canon readout time to 1 second * Remove connect properties: * `viewfinder` and `autopoweroff` should be set manually in camera. * Use `syncdatetime` instead of exp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
2021-08-11 Apply initial focus offset when initialising camera (#1147)
2021-08-11 Move services to top level folder and create dockerfile for camera service.
2021-08-11 * Remove explicit import of abstract class * Allow for creation and use of gphoto2 camera without port (works if only one camera present). * Update subprocess for gphoto2 so stderr is separate from s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
    [camera.py]
2021-08-11 Small update to camera service.
2021-08-11 * Add the remote gphoto2 Canon camera to interact with service. * Handle filename in camera service better.
2021-08-12 Make camera service work better outside a docker container. * `base_dir` is a setting for camera service (set via BASE_DIR envvar) and filename is only altered if provided (e.g. inside a container). 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
2021-08-12 * Move actual camera service over to `pocs-camera` repo.
2021-09-30 * Fix default camera creation from config. * Remove old gphoto2 wrappers from dockerfile. * Add port argument for remote gphoto2 camera.
2021-09-30 Adjust Dockerfile; cleanup volumes; remove pocs-power dependency
2021-09-30 Ability to list remote cameras.
2021-09-30 Remote url option for detecting cameras.
2021-10-01 * Fix `start_exposure` remote canon.
    [camera.py]
2021-10-01 * Can pass version string to CEM40 (for the EC option) * Fix the park and unpark for the cem40 to just use the built-in for the mount.
    [mount.py]
2021-10-01 * Create a `mount.settings.update_tracking=False` option in the config that controls whether or not the mount does tracking corrections. This involves plate solving the current image, getting offsets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
    [pocs.yaml]
2021-11-04 Updating mamba; removing periodic status thread; misc cleanup; better safety checks for if safe; mount goes direct to park instead of via home.
2021-11-11 Compound observations and scheduler cleanup (#1152)
    * Simplify simple fields file.
    * * Remove leftover line.
    * * Formatting.
    * * Update default log level for POCS
    * * Adding custom constraints to dispatch `get_observation` along with minor fixes.
    * Changed scheduler config name to `read_file` from `reread_fields_file`.
    * `get_observation` is an abstract method in the base scheudler.
    * * Adding a compound observation, which takes a number of different exposure times per observation (e.g. HDR).
    * Better types for scheduler
    * Compound example in simple fields file.
    * `Observation.from_dict()` class constructor.
    * Cleanup.
    * * Use `from_dict` in `add_observation`
    * * F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
    [test_observation.py]
2021-12-04 call to `_startt_exposure()` does not correctly unpack kwargs (#1156)
    Thanks @fergusL! I'm also not sure why this decreases coverage so much but will push through anyway.
    [camera.py]
2021-12-29 Update environment and testing (#1157)
    * Fix namespace to work with pep 420 and with pyscaffold.
    * Uses `panoptes-utils>=0.2.35`
    * Missing `pandas` dependency
    * Minimum python 3.9
    * GHA testing runs on matrix of python versions.
    * Fix testing config file.
    [testing.yaml]
2022-01-07 MLO Updates (#1150)
    * DSLR camera simulator
    * Don't clear exposing event in simulator as it's handled in the base class.
    * * Change NTP router ip
    * * Better support and consistent use of `endpoint` for remote cameras.
    * Changing object name so no conflict with import lib.
    * Updates to camera config defaults so it works with PANOPTEs out of box.
    * * Revert the changes done to try to fix #1022. Not part of this PR
    * * No default endpoint for cameras in config.
    * * Remove extra debug.
    * * Mount simulator for testing?
    * * More mount testing fixes.
    * * Properly escape commands sent to remote camera.
    * * Log updates.
    * * Don't sync the datetime automatically.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
    [camera.py]
2022-01-19 Remove double insert of record for firestore
2022-02-04 Handle bad connection for remote sensor reading without fail.
2022-08-17 Update repo and misc changes (#1168)
    * Update pyscaffold to 4.2.3
    * * Updating `panoptes-utils` version number and other dependencies.
    * * Fix changed imports.
    * Add python 3.8 to the test matrix.
    * Handle odd google firestore dependency.
    * Allow the db type to be specified.
    * Fix default missing location.
    * * use helper for value.
    * Don't parse location info. I'm not sure why this change would suddenly be necessary.
    * Don't parse any get_config entry.
    * Bump panoptes-utils for fixed config server.
    * * parse the config on the client side.
    * fix missing constraint for testing file.
    * * a Field can be generated from Alt Az directly via a classmethod.
    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
    [camera.py, focuser.py, serial.py, test_dome_astrohaven.py]
2022-08-19 Adding error utils and various small fixes from run time.
    [camera.py]
2022-08-19 Make a `SiteDetails` dataclass when creating a location (#1169)
    * Make a `SiteDetails` dataclass when creating a location.
    * Missed test
    * * More dataclass fixes.
    [test_ioptron.py, test_mount.py, test_observatory.py, test_pocs.py]
2022-08-19 Update cem40 (#1170)
    * fix the timestamp in the status call by parsing the date properly.
    * Set the default meridian treatment to flip at 15 deg past meridian (`015`) and not go below 30 degrees alt.
    [serial.py]
2022-08-19 Adding power board control to cli (#1171)
    * Adds basic reporting and the ability to change relay states.
2022-08-20 Flat field method (#1173)
    * This method has been used off and on variously for a while. Ideally should be decoupled more from the hardware but getting it committed as is.
    Replaces and closes #729.
    [test_observatory.py]
2022-08-20 Update observing methods (#1175)
    * Update observing methods
    * Changes `observatory.observe` to `observatory.take_observation` to have more descriptive name and not interfere with potential state action names.
    * `take_observation` will now remove cameras if they are stuck and try to continue observing until no cameras are left.
    * Created high-level `pocs.observe_target`, which loops over the exptimes in the observation and sets up processing threads when done with each exposure. This replaces what was in the `observing` state and moves it to a `pocs` method. This allows the mount to stay on a target for the length of the observation without moving between states during each exposures, wh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
    [test_observatory.py]
2023-04-26 Update install-pocs.sh
    Adding arduino-cli to install script.
2023-04-27 Update install-pocs.sh
    Fixing up some of the arduino install.
2023-04-27 Update install-pocs.sh
    Rearrange some of the arduino install based on experience.
2023-04-27 Update install-pocs.sh
    Don’t try to install the PowerBoard
2023-05-10 Update pocs.yaml
    Change the default config to CEM40 for the mount.
2023-05-11 Update install-pocs.sh to add camera options.
    Adding install options for the camera box. Unable to test so here's hoping... 🤞🏼
2023-05-12 Update install-pocs.sh
    Fix camera box install prompt.
2023-05-12 Update pocs.yaml
    Fix camera defaults in config.
    [pocs.yaml]
2023-05-16 Fix the status timestamp for the cem40. Note this is just displaying the timestamp as is without the proper conversion. milliseconds from 2000.
2023-05-16 Fix mount coord parsing for newer cem0s
2023-05-17 Put the mount timestamp into local time. (#1182)
    Tested on CEM40 hardware.
    * Put the mount timestamp into local time.
    * Small fixes to time settings.
    * Parse the timestamp as an int.
    * Parse the daylight savings as int
2023-05-17 Fix cem40 parking (#1183)
    * Update parking for CEM40 with 2021+ firmware. Fixes #1181
    * Update conf file for parking.
    * Move the mount home before parking.
    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
    [pocs.yaml]
2023-05-17 Update install script (#1184)
    * Update install script
    * Simplify install script by only having one option (no camera box). Add gphoto2 to install. Remove commented out code.
    * Defaults to locally connected cameras.
    * Defaults to v310 command set for iOptron mounts.
    * Adds iOptron udev entries so `/dev/ioptron` should be available for CEM40 mounts.
    * Adds jupyterlab to default install
    * Allow panotpes user to control supervervisod
    * Restart supervisorctl via `pocs` subcommands.
2023-05-18 Fixing some relative paths
    [mount.py]
2023-05-18 Auto download the IERS file to avoid warnings.
    [pocs.yaml]
2023-05-19 Typer updates (#1186)
    * Add rich to typer and start using.
    * Fix the `config setup` for better defaults and prompts.
    * Add rich to typer in conda file.
    * Don't override `set` as name.
    * Use `rich` print statements.
    [config.py, main.py, notebook.py, power.py, sensor.py]
2023-05-23 iOptron mount updates (#1187)
    * Fix the iEQ30Pro init procedure with updated firmware.
    * Fix one of the pocs tests for parking.
    * Change command files for more generic time command. v140 and v210 give local time and v310 does UTC time, so generic command is `get_timestamp`.
    * Consolidate the iOptron mount functions into a base class. Other mount cleanup.
    * Fix tests for quantity comparisons.
    * Fix parking test.
    * Init the mount with the version if on old set.
    * Parse local time better.
    [mount.py, serial.py, test_pocs.py]
2023-05-25 Specify protobuf version so install continues to work on arm (pi)
2023-05-28 Supervisor changes to restart config-server and stop power-monitor when no device connected. Don't start weather monitor by default.
2023-09-02 Improvements to POCS creation and running (#1192)
    * Improvements to POCS creation and running.
    * Move the `pocs-startup.py` script into the `POCS.from_config` classmethod.
    * * Add a `pocs run` subcommand with a `pocs run auto` command that replaces the `pocs-startup.py` script. Note that this has not been tested with live hardware! :warning:
    * Small updates to running cli.
    * Small updates to running cli.
    * * Adding a `pocs run alignment` command that will take polar alignment pictures.
    * Ability to pass simulators with `-s <sim>` or `--simulator <sim>` where `<sim>` is one of: mount, power, cameras, weather, etc.
    * Prettier colors.
    * Fix pretty colors.
    * Show error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
    [camera.py, main.py, mount.py, pocs.yaml, power.py]
2023-09-05 Fix power by relay index.
    [power.py]
2023-09-07 Weather sensor (#1195)
    * First try at adding weather sensor, which is a thinnish wrapper around the aag.weather.CloudSensor. This will prevent us from having to run two different services just to record values.
    * Cleaning up the weather sensor and service after updating `panoptes-aag`
    * Run the weather service for local by default.
    * Basic weather cli interface, mimics the power monitor sensor.
    * Change default config to match weather
    * Simplify the weather service so that it is using the pan db for values instead of a server. This reflects what pocs knows. Should be done with power too but not in this PR.
    * Small fix to docstring.
    [main.py, pocs.yaml, weather.py]
2023-09-23 Show the AC_OK in pocs power status
2023-09-23 Minor fixes for the camera and mount to ensure better blocking when needed.
    [mount.py]
2023-09-23 Revert tracking fix for cem40 for now based on testing.
    [mount.py]
2023-10-07 Load the scheduler after the mount and cameras.
2023-10-11 iOptron mount improvements. (#1197)
    Mergining without finishing the auto find
    * iOptron mount improvements.
    * Move the status and coordinate matching info into the yaml file as it depends on firmware, not mount type.
    * Typo fix.
    * Compile the status and coords re with verbose flag for nice whitespace.
    * Provide a default status and coords format.
    * Basics of mount auto discovery
    * Basics of mount auto discovery
    * Slightly better handling of discovery.
    * Slightly better handling of discovery.
    * Slightly better handling of discovery.
    * Check for devices in use.
    * Check for ioptron response.
    * Use the `panoptes.utils.rs232.SerialData` f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
    [mount.py]
2023-10-12 Auto find mount (#1199)
    * Use the `panoptes.utils.rs232.SerialData` for mount probing.
    * Check properly for bad devices.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
    [mount.py]
2023-10-12 Fix the device skipping.
    [mount.py]
2023-10-12 Fix mount coords (#1200)
    * Set the RA and Dec input format according to the command sheet (i.e. the firmware) not the mount type.
    * Pass commands file to testing.
    [testing.yaml]
2023-10-13 Fix v310 RA coords (#1201)
    * Use milliarcseconds not milliseconds.
2023-10-14 gphoto timeout duration fix (#1202)
    * gphoto timeout duration fix
    * Make the timeout durations consistent.
    * Ensure non quantities properly.
    * Fix a test for new timeout.
    * I don't like tests that rely on some timing...
    * * Add some docstrings for timeout to clarify total time.
    * Fake simulator time to force a timeout in test.
    [camera.py, test_camera.py]
2023-11-17 Cem40 improvements (#1206)
    * Allow for mount testing on the `loop` dummy serial line.
    * * Overriding `set_target_coordinates` for the cem40 so it reports possible number of positions.
    * * Small cleanup.
    * Trying to fix scheduling error test.
    * Update the date on a failing test.
    * Don't use compound exposure for testing or simple example yet.
    * Reset scheduler each time.
    * Still trying to figure out why this changed.
    * Still trying to figure out why this changed.
    * Changing test function scopes to ensure a proper reset of scheduler.
    * Tests of scheduler
    * Adding a small time delay. This appears to be a race condition with setting the sequence_id to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
2023-11-17 Updating the startup event of the power board. (#1209)
2023-11-17 Minor mount clean and small develop fix. (#1210)
    [mount.py]
2023-12-08 Cem40v310 coords fix (#1203)
    * Coord fixes for iOptron.
    Trying to fix the new firmware coords specification while also being generic.
    Adding a `coords_precision` keyword to firmware yaml file that allows for better consistency.
    * Better name for coords unit.
    * Small cleanup to mount files.
    * Fixing the reporting of lat/long for proper units.
    * Rename some variables.
    * More readability and consistency.
    * Trying to make the formatting better.
    * Dealing with dumb older RA millisecond values.
    * Dealing with dumb older RA millisecond values.
    * Don't use strings.
    * Add extra debugging.
    Make `loop://` device work better so can do better testing on specific mou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
    [mount.py, run.py]
2024-01-09 cli command for getting an image upload key (#1214)
    * CLI improvments for network
    * Change the `image` to `network`.
    * Added a `get-key` commands for getting a service account key. User must get passcode from team member.
    * Consistent use of config entries for uploading images.
    * Missed file.
    * * Adding params for specifying key name and config updates.
    * Don't make the output directory unless successful request.
    [main.py, network.py, pocs.yaml]
2024-01-09 Allow cooled cameras to act like uncooled cameras.
2024-01-10 Discover weather stations (#1215)
    * Discover weather stations
    * Try to automatically find the weather station if the config entry `envrionment.weather.auto_detect=True`
    * Error handling.
    * Error handling.
    * Error handling.
    * Update some of the documentation.
    [pocs.yaml, weather.py]
2024-01-12 Store upload key as env var (#1219)
    * Store upload key as env var
    * Sets the saved upload key path in the GOOGLE_APPLICATION_CREDENTIALS envvar for both bash and zsh.
    * Add missing quotes.
    [network.py]
2024-01-19 Camera cli - add take-pics command (#1220)
    * * Add camera cli controls
    * * dont' forget teh main file
    * * Just use the threads.
    * * Use threads
    * * Change file extension.
    * * Adding a slight delay.
    * * Wait for final exposure.
    * * Wait for final exposure but make it simple.
    * Small fixes for closing of zwo.
    * Fixing up the closing of the camera.
    * * Adding exception.
    * Small camera changes.
    * Add timestamp to filename output.
    * * Set delay.
    [camera.py, main.py]
2024-02-02 Lock FastAPI version (#1222)
    Tests are failing for unrelated reasons.
    * Breaking changes (coupled with `pydantic` updates). Hold the version for now until can investigate more.
2024-02-08 Mount park position setter in cli. (#1225)
    CI tests are failing due to IERS issue.
    Tested on iEQ30 Pro and CEM40 in lab.
    * Mount park position setter in cli.
    * Interactive park position setter. Note that this doesn't do the number of seconds, just the direction.
    [mount.py]
2024-02-09 Weather params from config (#1226)
    * Weather params from config
    * Pass the kwargs from the weather sensor to the underlying CloudSensor class.
    * * Adding weather configs to the pocs.yaml and updating the service and sensor to use.
    * * Change the capture delay in the service.
    * Display what the weather reading is.
    * Show config in info.
    * Better capture delay.
2024-02-09 Weather status updates (#1228)
    * Weather service cli improvements
    * Following up on previous PR, this fixes the status call and makes the service restart cleaner.
    * Print the response, don't return it.
    * Split the status and config.
    * Handle missing readings. Status only shows status (and not config)
    * Better warning message for missing entries.
    [weather.py]
2024-02-12 Fix IERS for mount simulator. (#1229)
    * Fix IERS for mount simulator.
    The only place that the IERS is causing problems is for unused code in the simulator. This doesn't actually fix the IERS issue, it just skips it.
    * * Remove entire unused function and tests.
    * * Fix some unrelated failure due to timing
    [mount.py, simulator.py, test_ioptron.py, test_logger.py, test_mount.py, test_mount_simulator.py]
2024-02-12 IERS downloader (#1223)
    * IERS downloader
    * Move the IERS downloader to a util file.
    * Pull IERS file at beginning of CI testing.
    * Fix awkward formatting.
    * Fix awkward formatting.
    * Testing how often it is called in testing.
    * Fix config
    * Fix how config works.
    * Fix how config works.
    * Fix how config works.
    [test_mount.py]
2024-02-14 Fix power service control (#1224)
    * Power Board cli improvements
    * Add `setup` command for installing arduino script.
    * * Check for install path
    * * Adding confirmation and testing port unplug.
    * Remove plug test items.
    * * Sneaking mount commit in.
    * * Use older fastapi call for repeated tasks.
    * Fix app param
    * Adding battery_low readigns.
    * Remove `yield`
    * Adding battery low reading
    * Fixing battery low status
    [PowerBoard.ino, mount.py, power.py]
2024-02-14 power cli fixes (#1230)
    * power cli fixes
    * Fix the formatting output of the status report.
    * trucker board sketch uses same logic for bat_low as ac_ok
    * Minor doc changes.
    * Use negative values for raw readings and convert to nan in dataframe.
    * Don't convert to na
    [PowerBoard.ino, power.py]
2024-02-26 Commenting out camera model feature.
2024-02-26 Try to set the camera properties separately.
2024-04-02 Mount-setup-cli-improvements (#1234)
    * Don't append the new udev rule after mount setup.
    * Only add serial number to udev entry if detected.
    Tested in lab on `PAN000`
2024-04-06 Fix Cloud Logging (#1238)
    * Env var must be a string, so handle properly when reading.
    [run.py]
2024-04-16 Fix Cloud Logging from auto run. (#1245)
    * This is the 1st commit message:
    Decide on the cloud logger from the config.
    * Add `unit_id` to `pocs` and use in the `say` method.
    * The config uses `pan_id`
    * Specify cloud logging level or None.
    * Put the unit_id in the log message.
    * * Add unit_id to log message in cloud.
    * Show basic logging if level is INFO, details if DEBUG.
    * * Don't use cloud-logging option as cli param.
    * * Allow for cloud logging to be turned on from comand line, which defaults to a DEBUG level.
    * Show
    * Trying to set up from everywhere.
    * Better set up.
    [pocs.yaml, run.py]
2024-04-26 Add firestore service (#1250)
    * Metadata upload service
    This creates a simple `watchdog` script that listens for files in the directory and sends any json files to firestore.
    * Fix envvar name in supervisor conf
    * Remove PanDB and firestore functionality. Fix supervisor conf.
    * * Only process the 'current' files.
    * Correct panid
    * Better order.
    * Only upload modified files.
    * Only work on modified events.
    * Better errors.
    * Act on creation.
    * Don't show event in logs.
    * Show add even without verbose.
    * * Go back to old nested keys.
    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
    [network.py]
2024-04-30 DSLR Camera Initialization (#1252)
    * DSLR Camera Initialization
    * Use the values rather than the index settings, which seem to be more consistent across models.
    * * Testing without `autoexposuremode`
    * Change the order as a test.
    * Don't use quotes.
2024-05-02 Small metadata and camera improvements (#1253)
    * Clean up metadata saving.
    Updating current metadata record should clobber, not merge.
    * * Changing gphoto2 log entry to a warning.
    * Try to get camera model.
    * * Fix variable name.
    * * Fix incorrect log entry.
    [network.py, weather.py]
2024-05-02 Fix weather station autodetect (#1254)
    * Fix port inconsistency for weatherstation
    * `port` to `serial_port` consistently.
    * * Remove serial_port from conf if passed.
    [weather.py]
2024-05-08 Use PanBase for remote sensor (#1261)
    * Change to `PanBase` rather than set up `db` and `logger` manually.
    * Adding some types.
    Tested on PAN018
2024-05-11 Mount setup improvements 1240 (#1262)
    * Mount setup improvements
    * Ignore more ports we know won't match.
    * Also ignore the ioptron.
    * Also ignore the ioptron.
    * Changing the weather station to only check usb ports.
    * Similar to the weather, only check actual known usb devices.
    * Prompt for creation of dev entry.
    Tested on PAN007
    [mount.py, weather.py]
2024-05-12 POCS status store (#1264)
    * POCS status
    * Store the status in the db, which sends to firestore.
    * Don't store the state info permanently.
    * Default all db insert_current to not storing permanently. This could be done better.
    * Format.
    * Fixing a number of units in the observatory status.
    * Fixing a number of units in the observatory status.
    * More formatting.
    * Change the statue and include the next state.
    * Add default directory
    Tested on `PAN007`.
    [mount.py, power.py, weather.py]
2024-05-13 Parking status updates (#1267)
    * Parking status updates
    * Fix the updates given by the park and status commands. Don't rely on status name.
    * Remove trace log
    * Set `is_parked`
    [mount.py]
2024-05-19 * Creating a listener for jpgs that will upload to the panoptes-images-pretty bucket. (#1272)
    * Not a service yet.
2024-05-19 Revert obstructios default empty list
    [pocs.yaml]
2024-05-24 Fastapi deprecation 1208 (#1276)
    * FastAPI startup events
    This was added a few months ago but seems to have since been clobbered. Testing again.
    * Missing global
    * Use objects
    * Passing the lifespan to the FastAPI constructor
    * Make lifespan async
    * Tying it all back together.
    * Warning for no status instead of error.
    * More missing values
    * Converting weather station fastapi service.
    * Namespace conflict
    * Remove old `on_startup`
    * Replace repeat_every
    * Replace repeat_every with simple thread
    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
    [power.py, weather.py]
2024-05-24 Sensor recording improvement (#1277)
    * If the reading thread dies on then the thread dies and doesn't start back up, so just add exception here.
    [power.py, weather.py]
2024-07-08 Fix duplicated function name.
    [mount.py]
2024-10-02 Remove custom gphoto2 install (#1278)
    * Install from apt, which is at the current version. This should save a lot of time compared to the compiling needed for the custom install.
2024-10-15 Adding cli option for slewing the mount to a target. (#1279)
    * Command line target slewing for mount
    * Add a basic command to slew to target.
    * Does some basic checking
    * Will not power down or do safety check as of now.
    * * Ability to specify horizon (although it doesn't change the mount setting)
    * Confirm after showing target info.
    * Loop while tracking and show status (needs to be improved).
    * * Better shutdown timer.
    * * Ability to search for comets.
    * * Add a warning.
    * * Give options when shutting down
    [mount.py]
2024-11-21 Install script updates (#1281)
    * Remove custom gphoto2 install
    * * Source micromamba properly
    * * Fixing up more of the conda/mamba init on install.
    * * Removing install shell function for udev entries, which are handled by `pocs mount setup`.
    * * Small change to writing of dev entry.
    * * Remove gphoto2 dev install.
    * Moving script file location.
    * Split each install function into a separate file.
    * Small script fixes.
    * Passwordless sudo on machine.
    * Default POCS dir to uppercase.
    * More consistency with the PANUSER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
    [mount.py, power.py]
2025-02-03 Better gphoto2 readout timers. (#1282)
2025-02-14 Add the iOptron HAE16 mount class. (#1284)
    * Add the iOptron HAE16 mount class.
    * Inherit the HAE16 mount from the CEM40 as they are the same.
2025-02-27 Fix ioptron daylight savings time setting
    Add a check for daylight savings time according to system clock. This technically doesn't match what the mount could have, but they *should* be the same. (#1289)
2025-02-27 Fix mount slew check (#1290)
    * Mount slew check
    * Force a boolean response from the mount. It was returning a `0`/`1`, which was being used with a `is` comparison in the `slewing` state.
    * Adding types and fixing some docstrings.
    [mount.py]
2025-03-10 Change scheduler logging to info and add a moon avoidance special case. (#1291)
    * Change scheduler logging to info
    What happens in the scheduler should be more explicit to the user. Scheduling is infrequent info that this won't create much noise.
    * Add a special case to the dispatch scheduler so that if the name of the field is "Moon", skip the Moon Avoidance constraint.
2025-03-11 Switching mount coords conversion to `trace` log level. This had been switched a while ago as we debugged something that is now fixed.
2025-04-01 Fix wait test (#1299)
    * Fix wait tests
    * Only try to compute HA if we have current coords.
    * * Explicit logging in failing test
    * * Pass a valid observation for night.
    * Interrupt the long night wait.
    * * astropy requirement
    [test_pocs.py]
2025-04-03 Fix simulator config when using auto run. (#1286)
    * The `simulator` config item should be set even when it is empty, which will clear any previous runs. Also be more explicit in the logging and printing.
    * Set the weather simulator since it is now reset properly.
    * Try to test for stalling test.
    * Revert "Try to test for stalling test."
    This reverts commit 27e7e8ee8b9f89fc9cb04ccf46febde869a89858.
    * Revert "Revert "Try to test for stalling test.""
    This reverts commit 597db0883a5f2cac6778b05a066de5b3494d4368.
    * Revert "Revert "Revert "Try to test for stalling test."""
    This reverts commit 80bc6135bcf69b2a8eba69f947c5ea51ad34bcae.
    * * Remove added weather simulator
    * Revert "Revert "R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
    [mount.py, run.py, test_pocs.py]
2025-04-03 Add old alignment tools (#1287)
    * Add back old alignment script.
    This adds back some of the old alignment tools and makes them available. Needs to be tested with updated POCS.
    * Tidy
    * Add alignment tools file.
    * Fix command name to not overlap. Rearrange.
    * Fix escape sequence.
    * Only use a single camera and block.
    * Unpark the mount.
    * Fix import errors for fits.
    * Fix blocking of rotation.
    * Update the plotting code.
    * Update the plotting code.
    * Don't use tab character in title.
    * Small cleanups and docstrings.
    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
    [run.py]
2025-04-03 Make iOptron mounts use horizon information from the config (#1303)
    Tested on 007
    * Make iOptron mounts use horizon information from the config
    * Only convert if a number.
    * Convert to a public method. Add param options for all the settings.
    * More explicit conversion to get rates.
2025-04-03 Lower verbosity for mount status
2025-04-11 Better iOptron mount init (#1309)
    * iOptron mount init
    * Use the value from the `mount_version` rather than the serial commands file, which can be used for multiple versions.
    * Pass the version better.
    * Remove misleading log statement.
2025-04-11 Load ZWO camera drivers (#1310)
    * Better output after zwo driver installs.
    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
2025-04-11 Update config defaults (#1311)
    * Camera readout time increase
    * Add the `resources` directory
    * Turn off timelapse, keep_jpgs, and plate_solve.
2025-04-13 Camera setup script (#1313)
    * Camera setup
    * Detect cameras and write config.
    * Fix typer
    * ZWO take fits.
    * Close the camera after detection.
    * Revert docstring.
    * Get the camera lib from the base.
    * Try to detect the platform.
    * Add x64 platform files.
    * Don't use symlink
    * Change uid. Don't autodetect.
    * Return a list of images fromt he take_pics.
    * Longer output on images taken.
    * Longer output on images taken.
    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
    [camera.py]
2025-04-13 Quick typo fix for quick-alignment.
    [run.py]
2025-04-14 Long and short camera setup (#1315)
    * Add a `setup_camera` option to the canon gphoto2 cameras that will set up all the properties. Those properties should persist across a power-cycle so don't need to be called every time.
    * Add a `setup_cameras=False` param to the `create_cameras_from_config` that will call the `setup_camera` method if True and the cam has the method.
    * Call with `setup_cameras=True` from the `pocs cameras setup` command.
    * Adding a `setup_camera` method to the camera simulator.
    * Test the camera_setup.
    * * Remove the `connect` method and move serial number collecting ito `init`.
    * Call `setup_camera` directly from the simulator.
    * Canon cameras have a `setup_properties`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
    [camera.py, test_camera.py]
2025-04-14 Better exception printing when no zwo cameras are found during setup.
2025-04-14 Fix quick align (#1314)
    * Better movements
    * Better plotting
    [run.py]
2025-06-05 Support for observation-level constraints with new TimeWindow Constraint (#1325)
    * TimeBasedPriority Constraint
    A simple constraint that will switch to a different priority during a given time window.
    * Add a `constraints` property to the `Observation` so constraints can be specified in the fields file.
    * Dispatch scheduler will check constraints on observation objects.
    * Change looping in dispatch scheduler to be observation then constraint. This is potentially non-optimal in terms of time as the constraints were set up to veto the largest number of fields initially so that expensive sun and rise/set times don't need to be calculated.
    * Adding logging
    * Adding __str__ and __repr__ for var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
2025-06-10 Better system interrupt (#1327)
    * This will check if the cameras are exposing during the `pocs.observatory.power_down()` and if so wait for them.
    * Use a `CountdownTimer` so we don't potentially wait forever.
    Closes #1305
2025-06-15 Longer default readout time for camera cli take_pics
2025-06-23 Weather time stale check (#1333)
    * Weather time stale check
    * should come from the `data.timestamp`, not the `date` (which is the meta entry for when the record was inserted in the database).
2025-07-19 Fix remote weather stale reading (#1337)
    * Dates from the `data.timestamp`, not the `date` (which is the meta entry for when the record was inserted in the database).
2025-07-19 Socket based mount support (#1336)
    * Don't try to glob socket-based ports.
2025-07-19 New ZWO ASI SDK 1.38 (#1339)
    * Add files for `armv8` and `x64`
    * Fix the setup script.
    [camera.py]
2025-07-21 Zwo driver updates (#1341)
    * ZWO driver updates
    * Fix typo with cint.
    * Typos and cleanup.
    * Change default `bandwidthoverload` to `99` (%).
    * Add to gitignore for temp files.
    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
2025-08-04 Add ZWO binning options (#1343)
    Add options for setting the hardware `binning` mode on the ZWO cameras and default to `binning=2` (i.e. 2x2 quad binning).
    * Add a `binning` parameter and getter/setter.
    * Add a property for the ROI and use that for other properties.
2025-08-11 Better camera errors (#1354)
    * Better checking for file existence before processing, cleaning up confusing errors.
    Tests are failing because of a bad merge with #1350, which is unrelated. Will be fixed in future PR.
    [camera.py]
2025-08-12 Fix weather status test (#1355)
    * The new weather checks the `timestamp` rather than the `date`.
    [test_pocs.py]
2025-08-15 Update build environment (#1357)
    * Switch to `hatch` for development.
    * Remove all build config files and place info in `pyproject.toml`.
    * Remove annoying PR template.
    * Convert CONTRIBUTING doc to markdown.
    * Update GHA to use hatch.
2025-08-15 Apply ruff linting and formatting corrections. (#1359)
    * Ruff formatting
    * Update pyproject.toml to exclude certain directories when formatting.
    * Install `pytest-loguru` and remove extra custom fixture. Closes #1360
    [abstract_serial_dome.py, astrohaven.py, astromechanics.py, birger.py, bisque.py]
2025-08-25 Remove power board `PeriodicDataFrame` (#1366)
    * Removes an unused option that isn't being maintained.
    Closes #1365
2025-08-25 Add processing options to `take-pics` command. (#1364)
    * Add options to `take-pic`:
    * `convert` to fits
    * `compress` with fpack
    * `solve` plate-solve automatically
    * `pretty` make a jpg
    * Fancier display.
    Tested on PAN030 in lab.
    * Make a fancy progress bar for each.
    * * Show camera panels in columns properly.
    * * Add exptime
2025-09-03 When setting up the cameras, don't try to plate-solve or make pretty.
2025-09-07 Format and llint fixes (#1368)
    * Lint and format fixes.
    * Slightly change lunar exposure times.
    [camera.py]
2025-09-14 Make manual mount movement timing more exact. (#1370)
2025-09-18 * Fix `typer.Abort` call. * Minor fixes.
    [main.py]
2025-09-19 Add docstrings to all functions and methods and other cleanup (#1377)
    * `ruff` formatting.
    * * Don't specify `protobuf` version.
    * * Fixup `show_messages` display.
    * * Make the `quick-alignment` command the default by giving it an alias to `alignment`. The old `alignment` is now called `long-alignment`
    * * Remove the `old-alignment` entirely.
    * * Add a Junie guidelines doc.
    * * Junie added docstrings to the main files.
    * * Junie added docstrings to the camera files.
    * * Junie added docstrings to the dome files.
    * * Junie added docstrings to the filterwheel files.
    * * Junie added docstrings to the focuer files.
    * * Junie added docstrings to the mount fil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
    [abstract_serial_dome.py, astrohaven.py, astromechanics.py, birger.py, bisque.py]
2026-02-05 Calculate twilight time for day sleep instead of fixed 10-minute intervals (#1381)
    * Initial plan
    * Implement smart day sleep timer with tests
    * Update panoptes-utils version and extras
    Make sure to install the `images` extras.
    ---------
    [test_ready_state.py]
2026-02-13 Add tags support to Observation class and camera metadata
2026-02-13 Install the zwo drivers.
2026-02-13 Revert "* Ruff format line lengths"
    This reverts commit c8a0e651751663ac5edd96aa3fe8e55c4cf77c77.
    [astrohaven.py, camera.py, config.py]
2026-02-19 Modify git clone to ignore SSL verification
    Disable SSL verification for git clone command on Raspberry Pi.
2026-02-20 Fix linting errors: shorten long lines to meet 110 char limit
    [run.py]
2026-02-20 Unpark the mount before taking flats.
2026-02-20 Do exception checking on individual FITS headers as they are added. This is specifically fixing the `[]` in the `tags`, which could be handled directly.
    # Conflicts:
    # src/panoptes/pocs/camera/camera.py
    [camera.py]
2026-02-20 10 frames for bias by default.
2026-02-20 Update PR for calibration commands: add documentation, changelog, and fix linting
    [camera.py]
2026-02-20 Update CHANGELOG with calibration commands and ZWO options
    Add not about new ZWO data padding option.
2026-02-20 Better default exptime
    * Default exptime can be set at the camera config level rather than defaulted at the Observation level. See README for details.
2026-02-20 * Use `pocs camera setup` to set default exptime based on camera model.
2026-02-23 Fix CLI test to handle ANSI color codes in output
    [test_cli.py]
2026-03-02 Weather station updates (#1405)
    * Weather storage setting from config.
    * Pull the `store_permanently` from config rather than hard-code.
    * Add `store_permanently` to default conf file.
    * Update changelog.
    * !fixup
    * !fixup to always use the config setting.
    [pocs.yaml, weather.py]
2026-03-03 Fix dependencies order
    This will make sure `panoptes.pocs` is sorted after `panoptes.utils` and that they both have spaces between them.
    [birger.py, bisque.py, camera.py]
2026-03-03 Trying to fix the path.
    [power.py]
2026-03-20 Fix power CLI validation error by correctly sending JSON payloads (#1411)
    [power.py, test_power_cli.py]
2026-03-20 Fix astropy/numpy truthiness issues and IERS for release
    [camera.py]
2026-03-20 Remove user prompts when detecting mount
2026-03-20 Default to using /dev/mount instead of /dev/ioptron
2026-03-20 Changing udev filename to be mount specific
2026-03-25 Migrate documentation to MkDocs Material and update guidelines (#1414)
2026-03-25 Improve ZWO driver install script with PANDIR and architecture detection.
2026-03-27 Fix bias frame isolation and organize runs into subfolders (#1417)
    [camera.py, test_camera_cli.py]
2026-04-15 Switch from triangular workflow to main-branch-only workflow
    Agent-Logs-Url: https://github.com/panoptes/POCS/sessions/b875e771-4cc5-4a9a-9b12-d25fc60d5ecc
2026-04-15 Add `pocs weather setup` udev detection command
    Prompts the user (or auto power-cycles via the power service) to
    power-cycle the weather station USB device, detects the newly-appeared
    serial port, and writes a udev rule to
    /etc/udev/rules.d/92-panoptes-weather.rules that creates a stable
    /dev/weather symlink.
    - Snapshots current serial ports before detection
    - Supports --power-cycle flag to toggle relay via pocs power service
    - Falls back to interactive prompt for manual power-cycle
    - Writes SUBSYSTEM=="tty" rule with idVendor, idProduct, optional serial
    - Reloads udev rules via `sudo udevadm control --reload`
    - Attempts to update config server: environment.weather.serial_port
    Co-authored-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
2026-04-17 Rewrite weather setup to probe ports via AAG serial handshake
    Replace the power-cycle detection approach with a direct serial probe:
    success, write the udev rule and reload udev as before.
    [test_weather_cli.py, weather.py]
2026-04-18 Skip /dev/mount port when probing for weather station
    Before probing a /dev/ttyUSBX port, resolve the /dev/mount symlink
    (if present) and skip any port that it points to, preventing the
    AAG handshake command from being sent to the telescope mount.
    [test_weather_cli.py, weather.py]
2026-04-18 Fix CHANGELOG entry for pocs weather setup
    Update the description to reflect the final AAG serial-probe approach
    rather than the discarded power-cycle approach.
2026-04-18 Improve test coverage for setup_weather exception paths
    Add 8 tests covering previously uncovered branches in setup_weather:
    - OSError when resolving /dev/mount symlink (silently ignored)
    - Generic Exception in the serial probe loop (port skipped)
    - port_info fallback lookup via resolved device path
    - port_info absent from comports with no symlink (VID/PID error)
    - Falsy description/manufacturer (info lines omitted from output)
    - CalledProcessError from sudo tee (non-zero exit)
    - CalledProcessError from udevadm reload (warning, exit 0)
    - Exception from config server set_config (warning, exit 0)
    [test_weather_cli.py]
2026-04-30 docs: replace adapter script with RemoteMonitor/endpoint pattern for custom weather integrations
    - Show the minimum JSON an endpoint must return (is_safe + timestamp)
    - Explain pocs sensor monitor weather --endpoint <url> as the polling mechanism
    - Show config file alternative (environment.weather.url)
    - Reference the supervisord pocs-weather-reader-remote entry for production use
    - Remove the Python DB-writing adapter script
2026-05-26 Fix release workflow to extract notes from CHANGELOG, update AGENTS.md
    The release workflow now uses awk to extract the relevant CHANGELOG section
    for the current version tag and uses it as the GitHub Release body, rather
    than a hardcoded 'See CHANGELOG.md for details' message.
2026-05-26 refactor: replace pocs config flags with instance variables (#1447)
    * refactor: replace pocs config flags with instance variables
    Remove the pocs: config section (INITIALIZED, CONNECTED, INTERRUPTED,
    DO_STATES, RUN_ONCE, KEEP_RUNNING) which were runtime state values
    incorrectly stored in the config server.
    - All flags are now plain instance variables on POCS
    - Tests updated to use pocs.do_states = False instead of set_config
    - observing_run_attempts replaces pocs.RETRY_ATTEMPTS config key
    - pocs: section removed from pocs.yaml and testing.yaml
    * fix: correct off-by-one in observing retry count, rename config key
    - Chan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
    [pocs.yaml, test_pocs.py, testing.yaml]
2026-05-26 Smart `pocs update` with tagged releases, `--dev`, and `--branch` options (#1428)
    * Use `main` for `pocs update`.
    Add a `--branch` option that defaults to `main`.
    * * Fix the tqdm step output
    * * Let the user know branch is being changed.
    * Fix ruff lint issues in test_cli.py; add pre-commit lint requirement to AGENTS.md
    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
    [main.py, test_cli.py]
2026-05-26 perf: cut test suite runtime via scheduler caching, simulator config, and coverage opt-out
    - Remove accidental test artifact FITS files from images/ (test output written
    to relative images/ dir during previous agent test run)
    - scheduler/constraint.py: compute altaz once in Altitude.get_score(); use
    kwargs.get('end_of_night') in Duration.get_score() to avoid repeated
    observer.tonight() calls (~100-150s savings across scheduler tests)
    - tests/testing.yaml: set readout_time to 0.1s for simulator cameras (was 0.5s)
    saves ~80-100s across autofocus sweeps and exposure poll loops
    - pyproject.toml: remove coverage flags from addopts (coverage is CI-only)
    - .github/workflows/pythontest.yaml: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
    [testing.yaml]
2026-05-27 perf: fix slow camera tests (bias 0s exposure, focuser sleep, test waits)
    [simulator.py, test_camera.py, testing.yaml]
2026-05-27 fix: reduce simulator focuser move_time default from 1.0 to 0.001 to prevent test timeouts
    [simulator.py, test_focuser.py]
2026-05-27 fix: use millisecond-precision seq_time to prevent collisions in fast CI runs
2026-05-27 Address Copilot review comments on PR #1450
    - constraint.py: use explicit None check for end_of_night to avoid
    boolean evaluation of astropy Time objects (which can raise)
    - focuser/simulator.py: use deterministic initial position (0) instead
    of random to prevent worst-case 22s move_to() delays in tests
    - scheduler/scheduler.py: replace duplicated millisecond timestamp logic
    with _unique_seq_time() helper using microsecond precision plus an
    incrementing counter to guarantee collision-free keys in observed_list
    [simulator.py]
2026-05-27 Restore TESTING_LOG_LEVEL to DEBUG for better failure diagnostics
    WARNING was too aggressive - it drops state-change context needed to
    debug test failures. DEBUG gives useful detail without the noise of TRACE.
2026-05-27 Use current_time() for seq_time and document mandate in AGENTS.md
    - Replace datetime.now(UTC) with current_time() in _unique_seq_time()
    - Add explicit current_time() mandate to panoptes-utils section in AGENTS.md
    - Add Common Pitfall reminder to never bypass current_time()
2026-05-27 Remove unnecessary collision check in seq_time generation
    Microsecond-precision timestamps from current_time() make collisions
    impossible in practice — seq_time is set at most once per observation,
    which takes minutes. Inline the one-liner and remove _unique_seq_time().
2026-05-27 Restore current_time(flatten=True) for seq_time
    The millisecond-precision format introduced to prevent test collisions
    was an unnecessary deviation from the established YYYYMMDDTHHmmSS format
    used throughout the codebase (flatten_time, camera.py, tests). Revert
    to current_time(flatten=True) to keep filenames and sequence IDs consistent.
2026-06-01 Fix pocs update failing with 'couldn't find remote ref --tags'
    Pass tags=True as keyword arg to origin.fetch() instead of "--tags"
    as a positional refspec, which caused git to interpret it as a ref name
    rather than the --tags flag.
    [main.py]
2026-06-03 Update state machine
    * Adds a `simple` state file that removes the `pointing`, `tracking`, and `analyzing` states, which were effectively being skipped via options.
    * Defaults to new state machine.
    :warning: Needs to be tested on hardware for a full night before merging :warning:
    [pocs.yaml]
2026-06-04 Relax FastAPI pin
2026-06-05 Pass original string exptime to super().take_observation in dslr simulator to cover camera.py (#1367)
2026-06-05 Catch ValueError/TypeError in dslr simulator to cover camera.py lines 1030-1031 (#1367)
